vectivolt/DC-Modules/boards/README.md

# 🧩 Boards

<sub>The four module SKUs, the control card, and how the release sheets are produced</sub>

<p>
  
  
  
  
</p>

> [!NOTE]
> **Purpose** — what lives in `boards/`: the four buildable module SKUs, the control card, and the pipeline that
> turns them into audited release sheets.
>
> **Gate coupling** — `kicad5-verify` checks every connected pin of every release sheet;
> `module-interconnect-audit`, `polarity-audit` and `schematic-check` walk the built netlists in run-all.

## At a glance

| Source | What it is | Components (AC-DC · DC-DC) |
|---|---|---|
| [`30kw/`](30kw/) | the canonical module — [walkthrough](30kw/README.md) | 341 · 282 |
| [`40kw/`](40kw/) | 40 kW air: 15 mΩ-class Vienna dies, 5-stack PFC choke, 9 × 33 nF tank, two LLC dies per position, 125 A fuse class, 3 fans | 343 · 306 |
| [`50kw/`](50kw/) | 50 kW **liquid**: coldplates, zero fans, 11 × 33 nF tank, D_OUT 250 A class | 342 · 316 |
| [`50kwa/`](50kwa/) | 50 kW **air**: electrically identical to the liquid twin, 4 fans | 350 · 316 |
| [`control-card.tsx`](control-card.tsx) | the **control card** (GD32G553VET7, 120 × 80 mm, 88-way) — one part number, every seat | 77 |
| [`out-pdf/`](out-pdf/) | the nine release PDFs rendered from the audited KiCad-5 sheets | — |

`kicad5-verify` re-derives every pin of every SHIP target from the emitted files and must read 100 % — the current
count is in the [repository overview](../README.md) status table.

All four SKUs come from one parameterized source, [`boards.tsx`](../packages/common-components/boards.tsx), built
from the cells in [`cells.tsx`](../packages/power-primitives/cells.tsx); the card learns its SKU from one RATING strap.
Why the family looks the way it does: [module family](README-module-family.md).

## 1. The module, physically

| | Role | Contents |
|---|---|---|
| 🔻 **AC-DC board** (lower) | grid → DC bus | AC studs · gG fuses (80 / 125 / 160 A per SKU) · MOV + GDT · 2 CM chokes + three star-X2 stages + damper (no DM chokes) · precharge + bypass · Vienna phases (one clip-mounted 750 V SiC die per position) · split DC link · isolated discharge · line CTs + isolated senses · 110 W full-bus aux flyback (NCP1252D) · local 3.3 V buck · fans (**3 / 3 / 0 / 4** per SKU) · **40-way harness header** (no card slot) |
| 🔺 **DC-DC board** (upper) | DC bus → 150–1000 V | film commutation caps · one full-bridge LLC (two legs, one or two dies per position) · one Cr bank + D2 external Lr + resonant CT · two D3 transformer cells · JBS bridges · film-only banks + PV-driven bleeders · zero-current S/P relays + two-stage exclusion · output blocking diode D_OUT · shunt, studs · isolated CAN · HMI · **the 88-way card slot** |

The boards mount **face to face**: TO-247 rows, clip-mounted on Al2O3, face outward onto two heatsink extrusions
(liquid coldplates on the 50 kW liquid SKU, with the magnetics gap-pad-bonded to the plate webs). Power crosses on
bolted DCP / DCN / PE stud pillars and control on the 40-way harness. Full contract:
[interconnect](../docs/interconnect.md).

## 2. From source to release sheet

```mermaid
flowchart LR
  TSX["boards/&lt;sku&gt;/*.tsx"] -->|"tsci build<br/>netlist mode"| NET["dist/boards/…/circuit.json"]
  NET --> PAGES["sheet-pages.mjs<br/>section plan"]
  PAGES --> SNG["sheet-netlist-gen.mjs<br/>physical pin remap"]
  SNG --> K5["kicad5-gen.mjs<br/>KiCad-5 sheets + SHIP zip"]
  K5 --> VER{"kicad5-verify<br/>every label"}
  VER --> PRINT["kicad5-print.mjs<br/>print-fidelity SVG"]
  PRINT --> PDF["sheets-to-pdf.mjs<br/>boards/out-pdf/"]
  NET --> AUD{"interconnect · polarity<br/>schematic-check"}
  style VER stroke:#2ea44f,stroke-width:2.5px
  style AUD stroke:#2ea44f,stroke-width:2.5px
```

```bash
# build one board netlist (netlist mode is the working default — PCB layout is out of scope)
TSCI_NO_ROUTE=1 npx tsci build boards/30kw/acdc.tsx --ignore-placement-drc --ignore-routing-drc
```

```bash
# regenerate, verify and print one target (30kw | 40kw | 50kw | 50kwa | control-card)
node calculations/sheet-pages.mjs 30kw && node calculations/sheet-netlist-gen.mjs 30kw && node calculations/kicad5-gen.mjs 30kw && node calculations/kicad5-verify.mjs 30kw && node calculations/kicad5-print.mjs 30kw && node calculations/sheets-to-pdf.mjs
```

> [!TIP]
> **The release sheets are `kicad5/DC-Modules-<target>-SHIP.zip`.** Cross-section connectivity is net-labels only —
> wires never leave their section frame — and the library uses native KiCad conventions, so the zips open correctly
> in eeschema.

What differs between the SKUs is listed side by side in [module family](README-module-family.md) and, per magnetic,
in the variant tables of [magnetics](../docs/magnetics.md).

> [!TIP]
> **How this page is checked** — `node calculations/kicad5-verify.mjs <target>` — every connected pin of all five SHIP targets — with `module-interconnect-audit`, `polarity-audit` and `schematic-check` walking the built netlists inside `run-all`.

---

<div align="center">
<sub><a href="../docs/can-profile-tonhe-v12.md">← TonHe V1.2 Compatibility Profile</a> &nbsp;·&nbsp; <a href="../docs/README.md">🧭 Documentation hub</a> &nbsp;·&nbsp; <a href="README-module-family.md">Module Family →</a></sub>

<sub>Vectivolt DC-Modules · documentation rev E85 · every number reproduces with <code>sh calculations/run-all.sh</code></sub>
</div>
