vectivolt/DC-Modules/spice/README.md

# 🖥️ SPICE Simulation Suites

<sub>The ngspice runners, what each one proves, and where its results land</sub>

<p>
  
  
  
</p>

> [!NOTE]
> **Purpose** — the ngspice runners behind the switched-circuit evidence: what each one proves, where its netlists
> and results land, and which gate consumes them.
>
> **Engine** — **ngspice-46** (`brew install ngspice`). `run.mjs` is the shared batch runner and `wrdata` parser:
> every runner writes its decks into `generated/`, runs them, computes metrics in JavaScript from the raw waveforms,
> and writes CSVs and SVG plots into `../simulation-results/`.

## At a glance

| | |
|---|---|
| **Engine** | ngspice-46, batch mode (`ngspice -b`), integration `method=gear` |
| **Committed** | `generated/*.cir` — the persisted deck of every run of the current runners, kept for traceability; raw `*.out` waveforms (hundreds of MB) are git-ignored, so re-run a suite to regenerate them |
| **Results** | `../simulation-results/<sku>/*.csv` + `plots/*.svg` — read by `current-coordination`, `loss-budget`, `magnetics-envelope` and `stress-audit` |
| **Guards** | physicality (legs inside the rails), power-solve (the deck must deliver the rated power), and a tank **fingerprint** so a changed tank fails the gate instead of reusing a stale result |
| **Read the results at** | [simulation report](../docs/simulation-report.md) · method in the [simulation toolchain](../docs/simulation-toolchain.md) |

## 1. How a result is produced

```mermaid
flowchart LR
  R["runner .mjs<br/>per-SKU parameters"] --> CIR["generated/*.cir<br/>committed netlists"]
  CIR --> NG["ngspice-46<br/>batch · method=gear"]
  NG --> OUT["generated/*.out<br/>raw waveforms (ignored)"]
  OUT --> JS["metrics in JS<br/>rms · peak · ZVS · physicality guard"]
  JS --> RES["simulation-results/&lt;sku&gt;/*.csv<br/>+ plots/*.svg"]
  RES --> G{"gates<br/>current-coordination · loss-budget<br/>magnetics-envelope · stress-audit"}
  style G stroke:#2ea44f,stroke-width:2.5px
```

## 2. Runners

| Runner | What it proves | Key outputs |
|---|---|---|
| `double-pulse/dpt-run.mjs` | device-edge truth, **per SKU**: reads the gate network, RC snubber and single-sided RCD clamp out of `cells.tsx` and the turn-off currents out of each SKU's `llc-stress.csv` / `vienna-switched.csv`, runs at the drawn −3 V off-bias on the datasheet-fitted `models/sic-1200-c3m.lib`, reports **channel** turn-off energy (drain integral minus the datasheet E_oss, so the `cs` snubber is credited and its recovered charge is not counted as loss), sweeps `cs` against the ZVS dead-time budget, and prints the per-SKU `cs` / `koff` for `tanks.mjs`. Both Vienna line-cycle polarities are run separately because the RCD clamps only one. `stress-audit` **[DPT]** gates every `final` row, the fingerprint, `tanks.koff` and `pfc-design`'s `k_sw` | `<sku>/dpt-llc-metrics.csv` · `dpt-pfc-metrics.csv` · waveform plots |
| `llc/llc-run.mjs` | **per-SKU, power-solved** full-bridge LLC with body diodes: 12 stress corners (tolerance, gain-worst, high-line bus floor, nominal), an internal-short race and a dead short; it programs the dead times the firmware programs — the ZVS schedule on the strong leg and `weakDead` on leg A in phase shift, against the same 120 ns floor; **physicality guard** (legs in rails) and **tank fingerprint** | `<sku>/llc-stress.csv` · `llc-stress-summary.json` · `llc-short.csv` · `plots/llc-worst-corner.svg` |
| `llc/llc-envelope.mjs` | the 20-point magnetics envelope of the same bridge, power-solved below resonance where D3 flux peaks — the corners the resonance-only evaluation never saw | `<sku>/llc-envelope.csv` |
| `llc/llc-flux-post.mjs` | turns the simulated waveforms into the committed magnetics excitation table, so the magnetics gates never depend on a git-ignored `.out` | `<sku>/llc-flux.csv` |
| `llc/sp-transition.mjs` | why banks are never paralleled across a voltage difference: per SKU on the film-only bank (19.8 / 26.4 / 30.8 µF) and swept over the closure-loop inductance, because the loop sets the answer; the output is the minimum loop L the \|ΔV\| ≤ 25 V permit needs against the relay make line | `<sku>/sp-transition.csv` |
| `pfc/pfc-phase-run.mjs` | 3-φ line-cycle behaviour at averaged-switch fidelity: THD-40, midpoint balance, phase loss, precharge / discharge sizing | `<sku>/pfc-phase-runs.csv` |
| `dclink/dclink-ripple.mjs` | the HF ripple SHARE in the real DC link (bridge entry film · stud/pillar · split electrolytic bank · Vienna commutation films) at the committed LLC operating points. Run it AFTER `llc/llc-run.mjs`: it reads the corner out of `llc-stress.csv` | `<sku>/dclink-ripple.csv` |
| `protection/ct-frontend.mjs` | AVMID stability and the per-SKU resonant and line CT chains at their burdens, thresholds and race peaks | `<sku>/ct-frontend.csv` |
| `protection/prechg-disch.mjs` | precharge, bus discharge and bank bleed per SKU against F.20 / F.21 / F.21b | `<sku>/prechg-disch-sku.csv` |
| `aux/aux-flyback.mjs` | aux start, regulation and cross-regulation at 342 / 560 / 850 V per SKU, the current-sense clamp, and the V15 / V24 short cases | `<sku>/aux-flyback.csv` |

```bash
node spice/llc/llc-run.mjs 30kw 40kw 50kw 50kwa && node spice/llc/llc-envelope.mjs && node spice/llc/llc-flux-post.mjs
node spice/dclink/dclink-ripple.mjs
```

```bash
node spice/protection/ct-frontend.mjs && node spice/protection/prechg-disch.mjs && node spice/aux/aux-flyback.mjs && node spice/llc/sp-transition.mjs
```

## 3. Models

`models/sic-behavioral.lib` holds behavioural VDMOS and JBS fits and `models/sic-1200-c3m.lib` the datasheet-fitted
1200 V device the double-pulse suite runs on. Both carry a full provenance header: what they approximate, what they do
not, and why vendor-encrypted PSpice models cannot run here. The ± 40 % switching-energy band is carried through every
downstream decision and closes at the bench double-pulse test (T-01).

> [!WARNING]
> **A simulation that cannot fail is not evidence.** A switch model without a body diode lets a leg swing ± 6 kV on a
> 650 V bus and still print a plausible rms, so every runner that produces power-stage evidence clamps its switch nodes
> physically: `llc-run.mjs` fails any corner whose legs leave the rails, and refuses to report a corner that does not
> deliver its rated power. How to run and read every suite: [simulation toolchain](../docs/simulation-toolchain.md).

> [!TIP]
> **How this page is checked** — the runners' own physicality, power-solve and fingerprint guards, and then `current-coordination` and `magnetics-envelope` in `run-all`, which refuse a stale or non-physical result file.

---

<div align="center">
<sub><a href="../calculations/README.md">← Calculations & Gates</a> &nbsp;·&nbsp; <a href="../docs/README.md">🧭 Documentation hub</a> &nbsp;·&nbsp; <a href="../docs/bom-cost.md">BOM & Cost Roll-up →</a></sub>

<sub>Vectivolt DC-Modules · documentation rev E85 · every number reproduces with <code>sh calculations/run-all.sh</code></sub>
</div>
