vectivolt/DC-Modules/boards/30kw/README.md

# 📋 30 kW Module Walkthrough

<sub>The canonical board pair, cell by cell — every cell reused unchanged across the family</sub>

<p>
  
  
  
</p>

> [!NOTE]
> **Purpose** — the canonical cell-level walkthrough of one module. Every cell explained here is instantiated
> unchanged across the family; what the 40 and 50 kW SKUs scale is listed in
> [module family](../README-module-family.md) and, per magnetic, in the variant tables of
> [magnetics](../../docs/magnetics.md).

## At a glance

| | |
|---|---|
| **Input** | 3-φ 285–475 VAC — full power from 330 VAC, 86 % constant-current derate at 285 VAC |
| **Output** | 150–1000 VDC · **100 A max** · CV/CC · two output modes: LOW ≤ 500 V (banks parallel) / HIGH ≥ 500 V (series), set in standby |
| **Boards** | AC-DC and DC-DC both **440 × 500 mm, 6-layer**, face to face |
| **Cells** | 1 Vienna lane (3 phases, one 750 V 20 mΩ-class die per position) · 1 full-bridge LLC (two legs, one SG2M023120LJ per position) |
| **Control** | one control card in the DC-DC slot (JB); the AC-DC board has only the 40-way harness header (JICA) |
| **Fast trips** | F.01 line 120 A pk · F.11 tank 140 A pk (one window comparator) · DESAT on every SiC switch |
| **Performance** | η **96.38 %** at 400 VAC full power · peak **97.78 %** · worst junction **128 °C** (Vienna) / **150 °C** (LLC) over the envelope · MTBF ≈ **408 kh** |
| **Cost** | **₹31,613 @10k** (₹38,931 @1k) · China RFQ target ₹25,920 — [cost roll-up](../../docs/bom-cost.md) |
| **Release sheets** | `DC-Modules 30kW AC-DC (Vienna PFC)` and `DC-Modules 30kW DC-DC (full-bridge LLC)` in [`boards/out-pdf/`](../out-pdf/) · KiCad-5 set `kicad5/DC-Modules-30kw-SHIP.zip` |

## 1. 🔻 AC-DC board — [`acdc.tsx`](acdc.tsx)

```mermaid
flowchart LR
  J["AC studs<br/>L1 · L2 · L3 · PE"] --> F["gG fuses 80 A<br/>22 × 58"] --> MOV["MOV Δ + GDT<br/>S20K550 · X2★ CX01–03"]
  MOV --> CM1["CMC1<br/>3-φ CM (D7)"] --> X1["CX11–13 X2★ 4.7 µF<br/>CY4–6 Y1"] --> CM2["CMC2"] --> X2["CX21–26 2 × X2★ 4.7 µF<br/>CY1–3 Y1 · Rd–Cd damper"]
  X2 --> PRE["KPRE1 + KPRE2 80 A<br/>2 × 33 Ω pulse"]
  PRE --> PH["3 × Vienna phase<br/>A0 · B0 · C0"]
  PH --> DC[("split DC link<br/>2 × 5 × 470 µF + balance")]
  DC --> ST["DCP · DCN · PE pillars<br/>→ DC-DC board"]
  PH -. "PWM · FLT" .- HAR["40-way harness JICA<br/>→ card on the DC-DC board"]
  DC -. "isolated senses" .- HAR
  AUX["aux flyback 110 W<br/>NCP1252D · full bus"] -. "V24 · V15 · 3.3 V" .- HAR
  style PH stroke:#d19a00,stroke-width:2.5px
```

| Cell (source) | What it is | The engineering inside |
|---|---|---|
| EMI filter | conducted emissions | two 3-φ CM chokes (D7) with a 4.7 µF X2 star stage on each side and two at the converter (12 X2 in all), a Y1 trio at two nodes, and the Rd–Cd damper (2.2 µF X1 + 10 Ω 25 W) that keeps the current loop stable — no DM chokes; DM margin +32.9 dB |
| `ViennaPhase` × 3 | one PFC phase | 165 µH-class sendust choke, 3 × 0077908A7, N = 39 ± 1 lot-trim ([D1](../../docs/magnetics.md)); **common-source 750 V 20 mΩ-class SiC pair**, one die per position, clip-mounted on Al2O3 (RFQ acceptance IDM ≥ 210 A); two 1200 V / 40 A JBS diodes to the rails; 10 Ω + 100 pF RC snubber **and** an RCD clamp per node |
| `DriverCh` × 3 | isolated gate channel | NSI6611 (DESAT, Miller clamp, UVLO, soft-off) · split Rg 4.7 / 4.7 Ω · **+15 / −3 V** from a reinforced ISO-GBIAS-15-1W / -2W bias module — a class with a light-load acceptance row (≤ +17.5 V at 5 % load), because the idle rise is what the driver's abs-max actually sees · two series 1 kV DESAT diodes + **47 pF blank** + 100 Ω series resistor · gate pull-down · Kelvin return |
| `SplitDcLink` | energy buffer | 2 × 5 × 470 µF / **500 V** snap-in (worst continuous half 435 V = 87 % of rating; 450 V cans remain a listed −₹300 lever at 97 %), one 2 × 47 kΩ balance string per half with a sensed midpoint; window 650–830 V, **hardware OVP 860 V**; **16 × 1 µF bridge entry film + 2.2 µF / 0.33 Ω RC damper** on a 50 W TO-247 resistor clipped to the DC-DC heatsink, and per-phase film commutation caps |
| precharge | inrush control | 33 Ω in **two lines** plus a 2-pole bypass (a one-line resistor is a three-wire fallacy); t₉₅ ≈ 193 ms on the per-SKU deck; the bypass closes on a **settled** link, and F.01 is blanked 60 ms across the closure pulse |
| discharge | touch safety | 640 Ω active path with a 1200 V SiC switch, default-OFF: 830 → 60 V in **2.0 s** with AC present |
| `CtSensor` × 3 | phase current | Talema ACX-1100 1:2500 line CTs + **22 Ω burden** → ADC and the on-chip comparators (F.01 120 A pk) |
| `IsoVSense` × 5 | AC and bus sense | anti-surge resistor chain inside the measured domain + isolated amplifier + isolated 5 V bias; 100 Ω at every iso-amp output and 1 nF at every ADC pin, because 22 channels are sampled in ≈ 132 ns at the end of a harness that runs beside PWM ways |
| `AuxPower` | house power | 110 W full-bus flyback: NCP1252**D**, 220 µF VCC reservoir, D4 rev E on ETD44; brown-in 321 V; V24 / V15 / 3.3 V |
| harness header `JICA` | control boundary | the 40-way PFC bundle to the card; default-OFF pull-downs on every enable, relay drive and PWM at the receiving end — see [interconnect](../../docs/interconnect.md) |

## 2. 🔺 DC-DC board — [`dcdc.tsx`](dcdc.tsx)

```mermaid
flowchart LR
  ST["DCP · DCN · PE<br/>pillars"] --> CF["film commutation caps"]
  CF --> LEG["full-bridge LLC · 2 legs<br/>1 × SG2M023120LJ per position"]
  LEG --> TK["tank · 7 × 33 nF Cr<br/>D2 rev F 5.00 µH · resonant CT"]
  TK --> XF["2 × D3 rev D cells<br/>6:6∥6 · primaries in series"]
  XF --> BR["JBS bridge per bank<br/>2 × 40 A per position"]
  BR --> BK["film-only banks<br/>9 × 2.2 µF each"]
  BK --> SP["S/P relays at 0 A<br/>KSER · KPARA · KPARB · 74HC02 exclusion"]
  SP --> DO["DOUT 1600 V 150 A"] --> SH["manganin shunt<br/>+ NSI1200"] --> OUT["OUT± M8 studs"]
  CARD["control card · 88-way slot JB"] -.-> SP
  CARD -.-> HMI["HMI · 2 buttons<br/>2-digit 7-segment"]
  CARD -.-> CAN["isolated CAN<br/>NSI1042-DSWR"]
  style TK stroke:#1a9fb3,stroke-width:2.5px
  style CARD stroke:#2ea44f,stroke-width:2.5px
```

| Cell | What it is | The engineering inside |
|---|---|---|
| `LlcHalfBridgeLeg` × 2 | full-bridge legs | one SG2M023120LJ 1200 V / 23 mΩ per position, clip-mounted (RFQ acceptance **IDM ≥ 265 A** — the gated kill peak is **203 A at +0.5 µs**, 77 % of that line, which makes it the binding RFQ line of this SKU), Rg 4.7 Ω on / **0 Ω off** with a **330 pF C0G turn-off snubber per die** (the snubber sets dv/dt; a turn-off resistor would cost 3–5 × the turn-off energy, which one die at 30 kW cannot carry), **22 pF DESAT blank**; PFM over 77–203 kHz down to the fn floor 0.55, then phase shift of leg B at 1.45·fr; **ZVS held by a per-leg adaptive dead time on the non-linear C_oss**, and in phase shift the weak leg (leg A) takes a valley-timed **125 ns** edge, because at load it swings on the decayed tank current through L_r alone and a longer edge lets it swing back |
| `LlcTank` | resonant tank | Cr = 7 × 33 nF / 1200 V PP film · **D2 rev F external Lr 5.00 µH ± 3 %** of the tank's 5.6 µH total (2 × E70, N 5, 8000 × 0.05 mm litz, no bins) · one resonant CT 1:100 + **0.47 Ω burden** + window comparator U1W (F.11 140 A pk, both polarities) |
| transformer | isolation | **two D3 rev D cells** (2 × E70 each, 6:6∥6), primaries in series (n = 2), each S1–P–S2 with S1 ∥ S2 to one bank; TIW-served litz primary, copper-foil halves, VPI class H, both yoke faces bonded; PD ≥ 2.0 kV ([D3](../../docs/magnetics.md)) |
| JBS bridges | rectification | 16 × GC4D20120D 1200 V / 40 A — two per bridge position, one bridge per bank; diodes over synchronous rectification (on the full bridge SR loses 109 W more) |
| banks | output filter | 9 × 2.2 µF 630 V film straight across each bank — no inductor, no electrolytic; ≤ 3.83 A per film and 0.47 % RMS output ripple at the worst corner |
| `SeriesParallelRelayMatrix` | output modes | KSER · KPARA / KPARB 120 A PCB relays switched **only at zero current** behind the output diode · two-stage 74HC02 hardware exclusion; a welded KPARA shows as F.17 at the SER soft start |
| DOUT | output blocking diode | 1600 V / 150 A-class insulated module: back-feed and reverse-battery proof with no output contactor; 100 A = 67 % of class, Tj 115 °C. A 3 × 150 kΩ bleeder sits behind it, because no commanded path reaches past the diode and the studs otherwise hold 1000 V for about 100 s |
| `OutputShunt` | current truth | manganin + NSI1200 isolated amplifier, Kelvin taps; ± 0.2 % after EOL calibration (Monte-Carlo) |
| `ConfigHmi` | field configuration | 2 buttons + 2-digit display via 74HC595 + 2 NPN multiplexers — address, group, `F.xx` paging |
| `IsolatedCan` | external world | CAN 2.0B, 125 kbps, 29-bit, isolated + CM choke + TVS + jumpered 120 Ω ([protocol](../../docs/can-protocol.md)) |
| `CoilDriver` | relay drive | 24 V coils, flyback-clamped, economised to ~40 % hold after pull-in |

## 3. Control interface — one brain per module

The card sits only in the DC-DC board's 88-way `JB` slot and runs both boards: the two LLC legs on HRTIMER pairs, the
three Vienna PWMs over the harness, resonant and line CTs, bank / output senses, S/P relay drives and readbacks, HMI
and isolated CAN. The pin map is generated by `calculations/control/umod-pinmap.mts` (75 of 82 usable MCU pins, 7 spare),
and the module-interconnect audit proves every way lands on real electronics on both sides.

## 4. Protections on this pair

| Layer | On this module |
|---|---|
| **Hardware, µs** | line CT comparators F.01 120 A pk → HRTIMER kill · tank window comparator F.11 140 A pk (both polarities) · DESAT on every SiC switch · bus OVP 860 V · output OVP · driver UVLO (aux collapse holds gates low). A trip stays latched until the supervisor has acknowledged it — nothing re-arms the outputs on its own |
| **Safety chain** | watchdog WDO ≡ NRST (a hung brain restarts with enables low), fed only while the main loop keeps paying into it · GATE_EN chains with default-OFF pull-downs across the harness · two-stage relay exclusion |
| **Supervisory** | the full F.xx ladder ([protection thresholds](../../docs/protection-thresholds.md)), exercised by the scenario suite and the C firmware host binaries under ASan/UBSan |

## 5. Top cost drivers (@10k, from [`bom-30kw.csv`](../../calculations/out/bom-30kw.csv))

| MPN | Description | Qty | ₹ / unit | ₹ ext |
|---|---|---:|---:|---:|
| `IND-PFC-165u` | PFC choke D1-30, 3 × 0077908A7 sendust | 3 | 828 | **2,484** |
| `CMC-3PH-2mH-SKU` | 3-φ CM choke D7 (two stages) | 2 | 1,062 | **2,124** |
| `GC4D20120D` | SiC JBS 1200 V 40 A (6 boost + 16 secondary) | 22 | 96 | **2,112** |
| `XFMR-LLC-CELL-2E70-30` | D3-30 rev D transformer cell | 2 | 935 | **1,870** |
| `ELH-470u500` | 470 µF **500 V** snap-in (DC link) | 10 | 148 | **1,480** |
| `SG2M023120LJ` | SiC MOSFET 1200 V 23 mΩ (LLC) | 4 | 312 | **1,248** |
| `PP-1u-1100` | 1 µF 1100 V film (DC-link entry) | 16 | 54 | **870** |
| `SIC-750V-20mR` | SiC MOSFET 750 V 20 mΩ class (Vienna) | 6 | 144 | **864** |
| `IND-LR-E70-30` | D2-30 rev F external resonant inductor | 1 | 772 | **772** |

Mechanical lines (assembly and EOL ₹1,653 · heatsinks ₹1,305 · the two 440 × 500 mm 6-layer PCBs ₹2,350 · enclosure
₹870 · busbars, studs and harness ₹630 · clip-mount TIM ₹418) and the lever plan are in the
[cost roll-up](../../docs/bom-cost.md); the method is in the [BOM guide](../../docs/bom-guide.md).

> [!TIP]
> **How this page is checked** — `kicad5-verify` on this board pair, with `schematic-check`, `polarity-audit` and `module-interconnect-audit` on the built netlists; the cost lines come from the generated `calculations/out/bom-30kw.csv`.

---

<div align="center">
<sub><a href="../README-module-family.md">← Module Family</a> &nbsp;·&nbsp; <a href="../../docs/README.md">🧭 Documentation hub</a> &nbsp;·&nbsp; <a href="../../docs/protection-thresholds.md">Protection Thresholds →</a></sub>

<sub>Vectivolt DC-Modules · documentation rev E85 · every number reproduces with <code>sh calculations/run-all.sh</code></sub>
</div>
