vectivolt/DC-Modules/docs/assumptions.md

# 📒 Decision Register

<sub>The design decisions in force — each value, why it holds, and what would invalidate it</sub>

<p>
  
  
  
  
</p>

> [!NOTE]
> **Purpose** — the design decisions **in force**, subsystem by subsystem: the value, why it is that value, and what
> would overturn it. Every engine and gate in the battery cites a row here as its provenance.
>
> **Change rule** — a decision changes by **editing its row**. No replacement chain, no dated narrative: the page
> describes the module as it is today, and `git log` is the history.

| Status | Meaning | Change control |
|---|---|---|
|  | decided and gated | formal ECO, then edit the row |
|  | best current value | revisit when the named invalidator fires |
|  | needs external confirmation | confirm at RFQ, sample or EVT |

## At a glance

| | |
|---|---|
| **What this is** | the decisions that describe the module today — value, reason, status, and the gate or file that holds each one |
| **Scope** | four module SKUs; a per-SKU value is written **30 / 40 / 50 liquid / 50 air**, a single figure applies to all four |
| **Change rule** | edit the row. No replaced rows, no revision chain — the history is `git log` |
| **Who reads it** | every engine in `sh calculations/run-all.sh` cites a decision as its provenance; `stress-audit` and `review-checks` assert several word for word |

| § | Subsystem | What it settles |
|---|---|---|
| [1](#1-envelope-and-ratings) | Envelope and ratings | input window and derate, output window and modes, efficiency, THD, environment, accuracy, standby |
| [2](#2-ac-front-end-and-vienna-pfc) | AC front end and Vienna PFC | topology, carrier, dies, EMI filter, damper, fuses, surge, PFC loops |
| [3](#3-dc-link-precharge-discharge-and-balance) | DC link, precharge, discharge, balance | link window and reference law, cans and entry film, bypass rule, dumps, bleeders, label |
| [4](#4-llc-dc-dc-stage) | LLC DC-DC stage | bridge, tank table, dies, snubbers, modulation, dead times, regulator |
| [5](#5-magnetics) | Magnetics | D1–D7 identities, material rules, thermal and insulation acceptance |
| [6](#6-output-stage) | Output stage | rectifiers, bank films, S/P matrix, make permit, blocking diode, shunt |
| [7](#7-gate-drive-and-sic-switching) | Gate drive and SiC switching | driver, DESAT, gate resistors, bias class, loop inductance, DPT acceptance |
| [8](#8-sensing-and-protection-architecture) | Sensing and protection | CTs, iso-amps, comparators, the F.xx philosophy, junction observer, watchdog |
| [9](#9-control-card-mcu-and-firmware) | Control card, MCU, firmware | one card, RATING strap, HRTIMER, boot chain, journals, layering |
| [10](#10-communications) | Communications | VMP 2.0 native, TonHe V1.2 profile, timeout ownership, controlled stop |
| [11](#11-auxiliary-supply-cooling-and-mechanics) | Aux, cooling, mechanics | flyback and rails, SELV domain, fans and coldplates, mount, sandwich, boundary |
| [12](#12-production-bom-and-cost-basis) | Production, BOM, cost | volume basis, costs, sourcing maturity, release face, scope |
| [13](#13-component-and-model-assumptions--confirm-at-rfq-or-evt) | Component / model assumptions | what still waits on a datasheet, a quote or a bench |
| [14](#14-simulation-fidelity-decisions) | Simulation fidelity | what each model may prove, and what it may not |

## 1. Envelope and ratings

| # | Decision | Value | Why | Status | Held by · invalidator |
|---|---|---|---|---|---|
| 1.1 | Input window | 3-φ 285–475 VAC, 45–65 Hz, OVC III, 300 V line-to-neutral class | the window the DC-charger market specifies over | FROZEN | `core/fsm.h` `PMP_IN_OV_V`/`_UV_V` · a 525–530 VAC tender (moves the F.07 trip, not the topology) |
| 1.2 | Full-power floor | full power ≥ 330 VAC; below it input current is held and power derates linearly — **86 % at 285 VAC** | holding current instead of power saves ≈ 16 % of the SiC, copper and filter | FROZEN | `design-basis.mjs` `V_FULL` · `core/ctl.c` · a contract demanding full power at 285 VAC |
| 1.3 | Output window | 150–1000 VDC, CV/CC, **100 / 133 / 167 / 167 A**; constant current below the 300 V knee, constant power above | one module must serve both 400 V and 800 V vehicle classes | FROZEN | `core/fsm.h` `PMP_PAR_VMAX_V`/`PMP_SER_VMAX_V` · a class outside 150–1000 V |
| 1.4 | Output modes | **LOW** parallel ≤ 500 V · **HIGH** series ≥ 500 V · **AUTO**; latched only with every matrix contact open; AUTO crosses up at 500 V, returns at 480 V, 1 000 ms dwell | no single tank spans 150–1000 V at usable gain, and a battery on the boundary must not chatter the matrix | FROZEN | `core/fsm.h` `PMP_XOVER_*`/`PMP_MODE_DWELL_MS` · `host_sim` · a tank change moving the bank ceiling |
| 1.5 | Efficiency | peak ≥ 97 % specified; ledger **96.38 / 96.34 / 96.29 / 96.22 %** at 400 VAC full load, envelope peak **97.78 / 97.84 / 97.80 / 97.79 %** | the ledger carries the output diode, LLC turn-off and the measured switching coefficients, so it is bench-comparable | BASELINED | `out/loss-budget.csv` · `system/envelope-grid.mjs` · a measured coefficient outside its deck band |
| 1.6 | THD and PF | THD ≤ 5 % specified (3 % stretch); the shipped law reads THD-40 **0.76 / 0.65 / 0.69 %** at 400 VAC full power; PF target 0.99 | grid-code headroom without a filter the cost model cannot carry | BASELINED | `hal_test` THD rows on `hal/pfc.c` · a lab measurement above 3 % |
| 1.7 | Environment | −30…+75 °C operating, cold start ≥ −30 °C, storage −40…+85 °C, 5–95 % RH non-condensing, ≤ 2000 m, acrylic conformal coating on both boards and the card, 2 g 10–500 Hz survival | dust and condensation are the field killer for fan-cooled modules | FROZEN | `magnetics/temp-critique.mjs` cold rows · `cost/parts-db.mjs` · a requirement below −30 °C |
| 1.8 | Over-temperature derating | four zones, each 100 % up to its derate point and linear to **60 %** at its trip, then F.22: **inlet 55 → 75 °C** (air or coolant) · T_PFC 95 → 105 °C · T_LLC 100 → 110 °C · T_XFMR 105 → 115 °C. The worst zone governs; recovery has 5 °C hysteresis and is limited to 20 %/s | a derating curve is the product's headline environmental claim, so it is implemented in the firmware the module ships with and the thermal gates are solved at the same law | FROZEN | `hal/app.c` `ZONE[]` · `core/fsm.h` `PMP_OT_DERATE_C`/`PMP_OT_TRIP_C`/`PMP_DERATE_*` · `host_sim` · a zone temperature the sensor cannot see |
| 1.9 | Measurement accuracy | ±0.5 % V / ±1 % I specified; **±0.18 % / ±0.2 %** after a mandatory two-point EOL calibration; a card with no calibration record latches **F.30** and cannot deliver | running on nominal scaling is an unbounded error nobody can see | FROZEN | `out/monte-carlo.csv` · `hal/meas.c` · an EOL fixture that cannot reach both points |
| 1.10 | Parallel operation | modules share one DC bus behind their output diodes; the charger controller is group master (`GROUP_SET` 0x12), every card runs share = min(capability, demand / alive) | a cabinet supervisor is a single point of failure for every module it feeds | FROZEN | `core/group.c` · `host_sim` · a decision to reintroduce a cabinet supervisor |
| 1.11 | Standby power | target ≤ 10 W; the drawn passive network alone is 2.42 W (sense star) + 3.4 W (link balance), AC-present estimate 11.2–16 W | a market figure, not a physical line — no lever is spent before a measurement | ASSUMED | `system/standby-budget.mjs` · T-00; aux burst/skip is the first lever |

## 2. AC front end and Vienna PFC

| # | Decision | Value | Why | Status | Held by · invalidator |
|---|---|---|---|---|---|
| 2.1 | PFC topology | 3-level Vienna — one common-source 750 V SiC pair per phase, one PWM per phase, 1200 V JBS diodes to both rails | the switches see half the link and only the diodes block all of it | FROZEN | `cells.tsx` `ViennaPhase` · `verify-independent` |
| 2.2 | PFC carrier | **50 kHz** | 70 and 100 kHz put T_j over 150 °C on the same die and mount | FROZEN | `pfc/pfc-design.mjs` · a die class that changes the loss split |
| 2.3 | PFC dies | 750 V 20 mΩ class · 15 mΩ class · B3M010C075Z · B3M010C075Z — **one die per position** | the clip mount removed the need to parallel; 650 V dies reach 86 % of rating against a 75 % house line | FROZEN | `cost/parts-db.mjs` `skuOverrides` · an RFQ die below I_DM ≥ 210 / 260 A at 25 °C |
| 2.4 | Vienna switching coefficient | the ledgers carry the per-SKU double-pulse finals on the drawn clamp network: **18.1 / 19.4 / 18.9 nJ/(V·A)** | one generic coefficient under-read the 40 kW die by a third | BASELINED | `out/loss-budget.csv` `pfc_ksw_nJ_VA` · a bench coefficient above the deck |
| 2.5 | Node snubber and clamp | RC 10 Ω + 330 pF per node on a 3 W pulse-proof part (2.84 W/phase), plus an RCD clamp — 1200 V 10 A JBS, 100 nF, 33 kΩ bleeder. The mirrored clamp land is on every phase but **populated on the 50 kW pair only** | the resistor must be pulse-rated because dissipation is C·V²·f regardless of edge speed; the mirror is fitted where the unclamped negative half-cycle runs 82 % of 750 V instead of 76–79 % | FROZEN | `cells.tsx` `ViennaPhase` · `cost/parts-db.mjs` `MIRROR_CLAMP` · T-59 above 85 % of 750 V on any SKU |
| 2.6 | EMI filter | two CM chokes with **three floating star-X2 stages** — 3 × 4.7 µF line-side, 3 × between the chokes, 6 × at the converter, all X2 305 VAC; Y trio 10 nF at the converter node, 4.7 nF between the chokes. **No DM line chokes** | the star ladder carries the differential mode, and a 22 µH DM choke cannot exist at the line crest on a core that fits | FROZEN | `emi/lisn-precompliance.mjs` (DM margin +32.9 / +30.6 / +28.7 dB) · a conducted scan that misses the margin |
| 2.7 | Filter damper | Rd–Cd across the converter star: **2.2 µF / 6.8 Ω** at 30–40 kW, **4.7 µF / 4.7 Ω** at 50 kW, 25 W class | undamped, the LCL modes sit where the sampled current loop's admittance turns negative | FROZEN | `out/pfc-filter-stability.csv` · a transport delay above 20 µs |
| 2.8 | Line fuses | gG 690 V, **80 / 125 / 160 A** (22 × 58 frame, NH00 at 50 kW) | first size that survives the 0.72× enclosed/+55 °C derate against the worst continuous line current | FROZEN | `stress-audit` fuse rows · a change in worst line current |
| 2.9 | Surge path | MOV delta (S20K550 class) line-to-line plus MOV + **2.5 kV GDT** per line to PE | a 3.5 kV GDT sparks over above the MOV clamp at a 1 kV/µs rise, so the series path never conducts | FROZEN | `system/fault-energy.mjs` (39 J against a 160 J MOV) · above IEC 61000-4-5 class 4 |
| 2.10 | PFC loops | current f_c ≈ 3 kHz, PM 50°, GM 8.7 dB; link-voltage loop 15 Hz, PM 65°, **commanding power, not amplitude**; reference clamp 1.05× | an amplitude-commanding voltage loop reached 269 A on a sag recovery | FROZEN | `out/pfc-loops.csv` · `hal/pfc.h` · a HIL loop unstable on these defaults |
| 2.11 | Step-aware limit | the per-sample amplitude limit accounts for the 15 µs transport delay — 152 / 144 / 93 A, all under F.01 / 1.2 | ΔV/L flows before any sample can answer a line step, and a plain clamp let 184 A through | FROZEN | `hal/pfc.c` · `hal_test` · a transport delay above 15 µs |

## 3. DC link, precharge, discharge and balance

| # | Decision | Value | Why | Status | Held by · invalidator |
|---|---|---|---|---|---|
| 3.1 | Link window | **650–830 V** commanded, hardware OVP **860 V** | the double-pulse deck reads 73 % of device rating at 830 V and 77 % at 880 V | FROZEN | `core/fsm.h` `PMP_BUS_MIN_V`/`_MAX_V`/`PMP_BUS_OVP_V` · a measured ring above 75 % at 830 V |
| 3.2 | Link reference law | `bus_ref = clamp(max(2·V_bank/0.95, 1.08·√2·V_LL), 650, 830)` every tick, **leading the measured output** by 25 V rather than following the command | a Vienna rectifier cannot regulate below the line-line crest; and vehicles send their maximum voltage as the setpoint while charging far below it, so a command-following link parked the bridge at f_max and in deep phase shift across the mainstream range | FROZEN | `core/fsm.h` `PMP_BUS_LINE_K`/`PMP_BUS_LEAD_V` · `host_sim` · a class whose command is its operating point |
| 3.3 | Link capacitance | 2 × (**5 / 6 / 8 / 8**) × 470 µF **500 V** snap-in, 105 °C, −40 °C category | 450 V parts ran 92 % of rating nominally and 96 % at the OVP, where an electrolytic vents | FROZEN | `boards.tsx` `nDcHalf` · an RFQ can below 5.2 A rms at 100 kHz / 105 °C or ESR > 80 mΩ |
| 3.4 | Entry film and link damper | **16 / 16 / 20 / 20 × 1 µF 1100 V** at the DC-DC entry plus a 2.2 µF 1100 V / **0.33 Ω** damper on a ≥ 50 W non-inductive TO-247 part clipped to the heatsink | four films put the bank on an anti-resonance with the stud loop inside the 2·f_sw band and every can carried 5.8–12 A rms against a ≈ 3 A class; the damper's real duty is 7 / 16 / 36 W | FROZEN | `parts-db` `ENTRY_FILM` ≡ `boards.tsx` `nEntryFilm` · `current-coordination` `[DCLINK]` · T-57 far from 40 nH |
| 3.5 | Half-link ceiling | either half above **440 V for 10 ms** latches F.38 | the total-bus OVP plus the midpoint row still allowed one half to sit at 454–468 V | FROZEN | `core/fsm.h` `PMP_HALF_OV_V` · a can voltage-class change |
| 3.6 | Precharge | 2 × **33 Ω** pulse resistors, one in L1 and one in L2, with a two-pole bypass relay; 25 W class, 50 W at 50 kW | with three-wire input every line-line loop must see at least one resistor | FROZEN | `boards.tsx` · `spice/protection/prechg-disch.mjs` · a link capacitance change |
| 3.7 | Bypass close rule | close when the link has **stopped rising** — two consecutive 20 ms samples < 3 V apart — and sits above 0.85 × √2 · V_LL; otherwise F.20 at 5 s | "0.97 × the sinusoidal crest" is unreachable on flat-topped mains once the bus-fed aux, two diode drops and ±1 % sensing are counted, and F.20 locks the module after five tries; a settled link bounds the closing step at the resistor drop whatever the wave shape | FROZEN | `core/fsm.c` `ST_PRECHG` · `PMP_PRE_SETTLE_*`/`PMP_BYPASS_MIN_K` · a resistance or capacitance that changes the settling time |
| 3.8 | Closure blank | F.01 is not latched for **60 ms** after the bypass command and the PFC waits the window out; the hardware break stays armed | the closure step charges the link through the CM-choke leakage and D1 at 200 / 218 / 280 A pk, above F.01 on every SKU | FROZEN | `core/fsm.h` `PMP_PRE_BLANK_MS` · `current-coordination` `[INRUSH]` · a relay or JBS below its pulse line |
| 3.9 | Bypass readback | the two bypass auxiliaries (1 Form A NO) in **series**, read through a 330 Ω wetting resistor | series auxiliaries are the only detection of a **stuck-open** contact, which would leave a 33 Ω resistor in the line current | FROZEN | `boards.tsx` · `verify-independent` · a relay option without the auxiliary |
| 3.10 | Commanded link dump | 640 Ω (4 × 160 Ω) with a 1200 V SiC FET, default-OFF behind an isolated driver, on FSM command only; exit needs 100 ms of plausible samples, and a link falling slower than 20 V/s for 300 ms reports F.21 and **stops** the dump | a fail-engaged dump burns kilowatts into 100 W of resistor during any held reset, and a dump commanded with AC applied is fed through the permanent precharge path | FROZEN | `core/fsm.h` `PMP_DISCH_*` · `system/fault-energy.mjs` · a link energy change |
| 3.11 | Bank bleeders | 4 × 2.2 kΩ 10 W per bank on a photovoltaic-coupler gate drive, commanded from the mode-switch open and through shutdown and discharge | the coupler needs no floating supply and is default-OFF by construction | FROZEN | `cells.tsx` `PvGateDrive` · `core/fsm.c` · a bank film change |
| 3.12 | Passive balance | **one** 2-series 47 kΩ string per half per module (188 kΩ across the link), first bank only | a realistic hot can-to-can leakage imbalance is ≤ ≈ 1.2 mA against 4.4 mA of bleed, and these resistors also set the passive discharge time | FROZEN | `parts-db` `RBAL*` · `system/standby-budget.mjs` · an RFQ can above 0.5 mA at 85 °C / 415 V |
| 3.13 | Output-stud bleeder and label | 3 × 150 kΩ (450 kΩ) across the studs behind the blocking diode — 1000 → 60 V in ≈ 12 s. IEC 62477-1 label: isolate upstream, **wait 15 min AND verify < 60 V** | the output films sit behind the diode where no bank bleeder reaches them; passive link discharge from the aux floor is 6.2 / 7.4 / 9.9 min, and with AC applied the precharge rectifier path holds the link up entirely — the wait is never the permission, the measurement is | FROZEN | `parts-db` `RBO*` · `PMP_DISCH_OUT_MS` · [protection thresholds](protection-thresholds.md) · a bleeder or balance change |

## 4. LLC DC-DC stage

| # | Decision | Value | Why | Status | Held by · invalidator |
|---|---|---|---|---|---|
| 4.1 | Topology | **one full-bridge LLC** per module driving **two transformer cells with primaries in series** (n = 2 overall), one cell per output bank | it removes two thirds of the tanks, drivers and transformer stacks against three interleaved half-bridge sections, at the same gain | FROZEN | `llc/tanks.mjs` · `cells.tsx` `LlcTank` · a topology change (every result CSV carries the tank fingerprint) |
| 4.2 | Tank table | f_r **140 kHz** · n **2** · Ln **10** · Q ≈ 0.19 at a 500 V bank · Cr **7 / 9 / 11 / 11 × 33 nF** 1200 V · total Lr **5.6 / 4.35 / 3.56 / 3.56 µH** · Lm **56 / 43.5 / 35.6 / 35.6 µH**. Gain M = n·V_bank/V_bus, bank ≤ 500 V | Ln 10 held the resonant-capacitor voltage inside 584 V pk at the gain-worst corner with the lowest nominal rms | FROZEN | `calculations/llc/tanks.mjs` — the single table every consumer reads · assembled f_r outside ±5 % |
| 4.3 | External resonant inductance | D2 carries Lr less two cell leakages and the loop: **5.00 / 3.99 / 3.20 / 3.20 µH ±3 %**, no trim bins | one gapped ferrite at ±3 % is buildable where a ±5 % total with ±30 % leakage was not | FROZEN | `boards.tsx` `tank.lr` · `magnetics/mag-sync.mjs` · a cell leakage outside ±20 % |
| 4.4 | Dies per position | **1 / 2 / 2 / 2** × SG2M023120LJ, clip-mounted | a second 30 kW die is +₹1,560 — 5.2 % of that module alone, over the ≤ 5 % ceiling — so snubber, dead time and a thermal fold carry the one conduction-limited corner | FROZEN | `tanks.mjs` `par` ≡ `boards.tsx` `fetPar` · `envelope-grid` · a measured k_off or loop that puts that corner outside the grid |
| 4.5 | Turn-off snubber | one 1 kV C0G 1206 per die at the package pins — **330 / 680 / 1000 pF**; ledger k_off **3.4 / 5.3 / 4.0 / 4.0 nJ/(V·A)** | the snubber, not a gate resistor, sets dv/dt, and it is bounded **above** by the weak leg's ZVS energy window: 30 kW takes no more than 330 pF, and 1 nF rings the 40 kW parallel-500 V corner to 91 % | FROZEN | `tanks.mjs` `cs`/`koff` · `stress-audit` `[DPT]` · `verify-independent` `[SYNC]` · a bench value meeting the over-voltage line with less |
| 4.6 | Modulation | PFM from f_n 1.45 down to f_n **0.55** (203 → 77 kHz), then **leg-B phase shift at f_max**; burst only with the bank at 100 V or more, and the packet ends on the setpoint | into a discharged output the tank works into a near-short: bursting cost 129 A peaks and ±13 % ripple where continuous phase shift held 22–44 A | FROZEN | `hal/llc.c` · `hal_test` · `control/fw-constants-sync.mjs` · a tank change |
| 4.7 | ZVS floor | the higher of f_n 0.55 and the tolerance-worst ZVS boundary for the load in force + 3 %, the load estimate rising instantly and decaying over ≈ 10 ms | losing ZVS is a hard failure, so the floor must rise on the same call as the load step | FROZEN | `hal/llc.c` `llc_zvs_fn` · `hal_test` · a tank tolerance change |
| 4.8 | Dead time, shifted leg | `t_dead = 1.25 · 2 · par · (Q_oss(V) + C_s·V) / I_toff`, clamped **120–900 ns**, Q_oss from the E_oss ∝ V^1.5 curve (371 nC at 800 V) | a linear C_oss model carries only 49 % of the real output charge | FROZEN | `hal/llc.h` `LLC_DT_*` · `fw-constants-sync` · a device with another output-charge curve |
| 4.9 | Dead time, weak leg in phase shift | **short and valley-timed**: 0.82 · (π/2) · √(L_r · C_node) = **125 / 186 / 189 ns**, C_node = 2·par·(Q_oss(V)/V + C_s) | at load the zero state ends with the rectifier conducting, so L_m is clamped and the leg swings on the decayed tank current through **L_r alone** — it valleys in a quarter period and swings back at ≈ 300 A/µs, so a later edge turns on hard against the whole link at 60–130 W per die | FROZEN | `hal/llc.c` `weak_dead_s` · `spice/llc/llc-run.mjs` `weakDead` · `fw-constants-sync` · T-58 outside the window |
| 4.10 | Dead-time floor | **120 ns** | the driver publishes 70/80/110 ns propagation and no matching figure, so one leg's channels can differ by 40 ns and a 60 ns command cross-conducts — the ~3 W per die of body-diode conduction is bought against an event that destroys the leg | FROZEN | `hal/llc.h` `LLC_DT_MIN_S` ≡ `port/gd32g553/hrtimer.c` `DT_MIN` · a driver that publishes matching |
| 4.11 | CV/CC regulator | min-select CV/CC with back-calculation anti-windup and a bumpless reference shaper (500 V/s, 1 000 A/s, 80 ms stop); the voltage-loop gain is divided by the modulator's published sensitivity | the demand map's dV/du spans 23× across the envelope, so one fixed PI pair limit-cycled — the plant is inverted in the loop, not in the modulator | FROZEN | `core/ctl.c` · `hal/llc.h` `k_norm` · `ctl_test` · a modulator map change |

## 5. Magnetics

| # | Decision | Value | Why | Status | Held by · invalidator |
|---|---|---|---|---|---|
| 5.1 | D1 PFC choke ×3 | **3 × T79 26µ, N = 39** · **5 × T79, N = 26** · **5 × T79, N = 24** (both 50 kW); catalogue 0077908A7 AL 37 nH/T² ±8 %, lot-trim ±1 turn | the **biased** inductance at the crest, not L₀, governs ripple and the trip race | FROZEN | `pfc/pfc-design.mjs` · `magnetics/mag-sync.mjs` · a first-article L(I) outside the lot window |
| 5.2 | D2 resonant inductor ×1 | 2 × E70/33/32 PC95 class, N = 5, compacted litz in one layer ≥ 3 mm clear of a **distributed** centre-leg gap specified **per flux path** (≤ 1.0 mm per segment, parallel sets never summed) | fringing at a lumped gap lands in the litz, and summing parallel sets halves the real gap | FROZEN | `magnetics/mag-sync.mjs` · `magnetics-envelope` · assembled AL outside ±3 % |
| 5.3 | D3 transformer cells ×2 | **2 × E70 6:6∥6** (30 kW) · **3 × E70 4:4∥4** (40 / 50 kW); S1–P–S2 with S1 ∥ S2 to one bank; TIW-served litz primary, copper-foil secondary halves, VPI Class H, both yoke faces bonded, end turns potted. Supplied as a **matched pair** | two cells fit the 66 mm tunnel where one tall stack does not; a ±7 % Lm mismatch moves ≤ 8.3 % of the current between them in LOW mode | FROZEN | `magnetics/mag-sync.mjs` · `magnetics-envelope` `[IMBALANCE]` · a first-article short-circuit R or hot-spot outside its bracket |
| 5.4 | Powder cores | **prohibited on full-AC-swing HF duty** (D2, D3); kept only where the duty is DC-biased (D1) | sendust at the full 140 kHz swing computes ≈ 43 W of core loss against a ≈ 4 W budget, with 2:1 inductance swing per cycle | FROZEN | `magnetics-envelope` · `temp-critique` · nothing — it is a material law |
| 5.5 | D4 aux flyback ×1 | ETD44 PC95, 110 W class, 321–860 V input, Lp 345 µH ±5 %, P/2–S–P/2 sandwich, leakage ≤ 4 µH | smaller cores ran the clamp flux at 71–85 % of hot B_sat on the one part every module depends on | FROZEN | `magnetics/d4-flyback.mjs` · `stress-audit` `[D4]` · a clamp flux above 80 % of B_sat(130 °C) |
| 5.6 | D7 CM chokes ×2 | nanocrystalline 2 mH class wound to the SKU's line current: T 80/50/25 (30 / 40 kW) · T 90/50/30 (50 kW); acceptance L_cm ≥ 2 mH at 10 kHz **and** ≥ 1.0 mH at 150 kHz under DM bias | a catalogue part sized on 4 mm² wire ran 14–28 A/mm², and inductance at 10 kHz says nothing about 150 kHz | FROZEN | `emi/dm-choke-design.mjs` · `stress-audit` D7 CM flux (17–27 mT on 1.155 T) · a leakage flux above the DM bias line |
| 5.7 | Thermal and insulation acceptance | D2 / D3 hot-spot **type test bonded as in service**: ≤ 125 °C at 55 °C inlet, ≤ 135 °C at 75 °C derated inlet, with +25 % R_th and runaway-margin rows gated. UL 1446-recognised **system**, Class F minimum, **Class H for D2 and D3**, organics UL 94 V-0 | core flux is volt-second-pinned and does not derate, so the ΔT line is what caps the winder's thermal resistance — and a barrier is only as good as the system it was qualified in | FROZEN | `magnetics-envelope` · `magnetics-rfq-audit.mjs` · T-31 |
| 5.8 | Bond-loss cover | NC snap-action cutouts at 130 ± 5 °C on each D3 cell and on D2 (and on each D1 of the sealed liquid module), series-wired into the transformer NTC loop; an open loop reads 150 °C and latches F.22 | a lost gap-pad bond has no other observable, and the sealed module has no air path to fall back on | FROZEN | `core/fsm.h` `PMP_NTC_OPEN_C` · `parts-db` mechanical lines · an EOL soak that covers it another way |

## 6. Output stage

| # | Decision | Value | Why | Status | Held by · invalidator |
|---|---|---|---|---|---|
| 6.1 | Two output banks | one transformer secondary per bank into a SiC JBS full bridge, **2 × 40 A per position** on every SKU | one 40 A part everywhere is one line to buy; a single part per position at 30 kW cost +135 W and 1.11× the airflow | FROZEN | `tanks.mjs` `JBS_POS` · an RFQ diode that is not the 2-terminal 40 A class |
| 6.2 | Bank filter | **film only** — 9 / 12 / 14 / 14 × 2.2 µF 630 V across each bank; no bank inductor, no electrolytic | the film bank alone holds ≤ 0.5 % rms output ripple at −10 % capacitance on every simulated corner | FROZEN | `boards.tsx` `bankF` · `current-coordination` `[OUT]` · a film lot outside the 630 V / 2.2 µF acceptance |
| 6.3 | S/P relay matrix | KSER + KPARA + KPARB PCB power relays, 120 A class (150 A at 50 kW), switched at **zero current** with the LLC stopped; 74HC02 exclusion makes the KSER coil = KSER ∧ ¬(KPARA ∨ KPARB) | zero-current switching behind the output diode lets three plain relays replace a contactor, pre-insertion resistors and mirror contacts; every destructive matrix state involves KSER, so one gate covers them all | FROZEN | `cells.tsx` `SeriesParallelRelayMatrix` · `verify-independent` exclusion truth table · an RFQ relay whose suppressed release + bounce exceeds 35 ms |
| 6.4 | Make permit and sequencing | close only at ≤ 2 A **and** with the new stack ≥ 10 V below the output node (60 V floor); open every contact first, weld-check the mirrors, wait ≥ 51 ms for a suppressed release, 40 ms settle after a make; a stalled start latches F.34 at 8 s | a crossover under a live battery put ~1 kV onto ~500 V **through the closing contact**, and a coil-diode freewheel stretches drop-out 2–3× | FROZEN | `core/fsm.h` `PMP_MAKE_*`/`PMP_RELAY_MAKE_MS` · `fsm.c` `ST_MODESW` · `host_sim` · a relay rated to make under load |
| 6.5 | Output blocking diode | **DOUT** 1600 V insulated-base module in series with the output — 150 / 200 / 250 / 250 A class | it makes back-feed and reverse battery harmless without an output contactor, and it is what lets modules share one bus | FROZEN | `cells.tsx` · `parts-db` · a system that cannot accept the ≈ 1.05 V × I_out loss |
| 6.6 | Output current sense | manganin 50 mV Kelvin shunt — **0.500 / 0.376 / 0.299 mΩ** — wired so **delivering** current reads **positive** on `SNS_IOUT` | the sign convention has to be fixed in copper, or every bring-up check is ambiguous | FROZEN | `cells.tsx` `OutputShunt` · [firmware guide](firmware-guide.md) · a shunt orientation change |
| 6.7 | Output films | 2 × 4.7 µF 1200 V across the studs, behind DOUT | a third energy store the bank bleeders cannot reach — hence the stud bleeder and the label in 3.13 | FROZEN | `cells.tsx` · `system/fault-energy.mjs` · an output ripple requirement change |

## 7. Gate drive and SiC switching

| # | Decision | Value | Why | Status | Held by · invalidator |
|---|---|---|---|---|---|
| 7.1 | Isolated driver | **NSI6611** per switch position — 10 A, DESAT, Miller clamp, UVLO, reinforced isolation; bias COM ≡ GND2 ≡ the Kelvin node, TEST and IN− to GND1, ASC tied inactive | a bias COM floating on a private net against the FET source is a gate loop that does not exist | FROZEN | `cells.tsx` `DriverCh` · `verify-independent` (GND2 ≡ Kelvin, one node) |
| 7.2 | DESAT | 100 Ω series resistor at the pin, blanking capacitor driver-side on DST–Kelvin: **47 pF Vienna** (worst response 2.21 µs) · **18 pF LLC** (0.47 µs minimum blank, 1.34 µs total with two dies) | blank + LEB + sense-to-OUT + soft-off must sit inside 75 % of the SiC short-circuit withstand, and the soft-off term doubles on a two-die position | FROZEN | `cells.tsx` `cBlank` · BOM `MLCC-18p-0603`/`MLCC-47p-0603` · a vendor withstand below 2 µs at 830 V |
| 7.3 | Gate resistors | Vienna R_g,on 4.7 Ω / R_g,off 4.7 Ω · LLC R_g,on 4.7 Ω / **R_g,off 0 Ω** (the 1206 land kept for a bench re-fit) | on the LLC the per-die snubber sets dv/dt, and 4.7 Ω would cost 3–5× the turn-off energy — thermally impossible on the one-die 30 kW | FROZEN | `cells.tsx` · `stress-audit` `[DPT]` · a measured loop above 10 nH |
| 7.4 | Gate bias | reinforced isolated modules, **+15 / −3 V**; 1 W class per channel, **2 W** where one channel drives two dies. Acceptance +15 V ±5 % at 20–100 % load, ≤ +17.5 V at 5 % load, C_io ≤ 5 pF | +18 V exceeds the registered second source's static maximum; a two-die channel at f_max draws 113–159 % of a 1 W module, and a drooping rail raises R_DS(on) before it trips UVLO; −3 V keeps 2 V to the SiC gate's −5 V conditional floor | FROZEN | `parts-db` `ISO-GBIAS-15-1W`/`-2W` · `verify-independent` · a frozen MOSFET whose recommended V_GS is +18 V |
| 7.5 | Commutation loop and CM | drawing rules **LLC bridge ≤ 5 nH, Vienna leg ≤ 7 nH** (laminated bus, films at the package pins) and **leg-node-to-PE ≤ 100 pF**, target 50 pF, with a copper shield under the Al₂O₃ pad returned to DCN. **≤ 10 nH measured externally is the binding acceptance before any high-power run** | the double-pulse deck reads 78–92 % of 1200 V at 10 nH and **90–103 % at 20–30 nH** with R_g,off 0 Ω; and the leg nodes swing 830 V at 83–203 kHz, so every picofarad to earth is CISPR current. Above 10 nH the choice is a gate resistor **and** a second 30 kW die or a fold | FROZEN (rule) · ASSUMED (value) | `cells.tsx` layout rules · `stress-audit` `[DPT]` · `lisn-precompliance` CM budget · a ring-down above 10 nH at T-59 / T-71, or T-13 above 100 pF |
| 7.6 | Double-pulse acceptance | repetitive peaks ≤ **85 %** of device rating, ≤ **90 %** on the +6 % link row | the link itself is ≤ 69 % of rating, both die classes are avalanche-rated, and 85 % is what an achievable loop delivers at 100–165 A turn-off | FROZEN | `stress-audit` `[DPT]` on fingerprinted CSVs · a measured peak above the line |

## 8. Sensing and protection architecture

| # | Decision | Value | Why | Status | Held by · invalidator |
|---|---|---|---|---|---|
| 8.1 | Split of responsibility | **hardware where a device has microseconds to live; firmware everywhere else** | independent hardware costs money and adds failure modes, so it is spent only where reaction time, device survival or failure-mode independence demands it | FROZEN | [protection thresholds](protection-thresholds.md) · `review-checks` |
| 8.2 | Line current sensing | 2500:1 CTs per phase on **22 / 18 / 13 Ω** burdens, biased to a buffered mid-rail | CTs are inherently isolated and faster than a shunt path, and the burden keeps the fault peak plus the soft-saturation race inside the 3.3 V rail | FROZEN | `current-coordination` · `parts-db` · a CT missing ≤ 1 µs to 90 % on a 10 A step |
| 8.3 | Fast line over-current | **F.01 = 120 / 155 / 195 A pk**, comparator → HRTIMER kill, **positive-only** references, with a 100 kHz software magnitude trip for the other polarity | a reference below the mid-rail into a non-inverting comparator on an active-high fault input is a standing fault at power-up, and DESAT sees only the forward polarity | FROZEN | `hal/app.c` · `current-coordination` `[F.01]` · **O-15** (trip polarity — EVT injection decides) |
| 8.4 | Tank current sensing | one 1:100 resonant CT on the tank, burden **0.47 / 0.36 / 0.30 Ω**; **F.11 = 140 / 180 / 220 A pk** through a window comparator onto the merged fault line | the tank conductor is the CT primary, so tank-potential insulation stays on the wire, and a window comparator catches both polarities | FROZEN | `current-coordination` `[F.11]` · `cells.tsx` `F11Window` · a tank class change |
| 8.5 | Comparator ownership | phases A / B / C own **CMP3 / CMP1 / CMP2**; link OVP on CMP4, output OVP on CMP0; every signal on a non-inverting input against an internal DAC, each on its own fault channel | two signals on opposite inputs of one comparator are not two comparators, and the DAC drives only one side | FROZEN | `control/umod-pinmap.mts` · `verify-independent` pin ownership, traced to the shipped face · a HAL configuring other instances |
| 8.6 | HV voltage sensing | every HV sense **isolated** — iso-amps against a 3 × 33 kΩ artificial star for the AC phases, against DCN for the link, against the bank and output returns elsewhere, each with its own reinforced bias module; 1 nF at every ADC pin, 100 Ω at every iso-amp output | resistive dividers to analogue ground breach the reinforced barrier and float the reference the ADC measures against | FROZEN | `cells.tsx` `IsoVSense`/`AnalogMid` · `verify-independent` · a sense topology change |
| 8.7 | Junction observer | `hal/dielim.c`: per millisecond, worst-die loss at the operating point → a first-order junction estimate above the **measured** zone NTC (τ 0.5 s, R_th 0.80 air / 0.65 liquid K/W) → availability folded from 142 to 150 °C; a point it cannot cool is **DECLINED** and latched until the LLC stops | an observer, not a static ceiling: every start crosses deep phase shift for a few hundred ms, where a static ceiling read 0 A and the module never started | FROZEN | `hal/dielim.h` · `fw-constants-sync` · `app_test` · a measured mount R_th above the basis |
| 8.8 | Hardware trip latching | every hardware trip is held in `trip_n` / `trip_ack` until the supervisor latches it; an output is enabled in **one** place, on its OFF → ON transition only, inside a critical section that checks the supervisor's acknowledgement and the timer's own fault flags before the write and the flags again after it (a completed fault pulse is never followed by a stale enable); only the fault interrupt clears a flag; everything the control interrupts execute or read lives in TCM and the build audits the linked image | the control interrupts otherwise re-armed the outputs 10 / 100 µs after every trip, and a fault landing inside the decision-to-write window re-armed a killed stage — for one period, or for good once the source of a pulse fault was gone | FROZEN | `hal/app.c` · `port/gd32g553/port.c` `outputs_commit` · `build.sh` TCM audit · `app_test` · `review-checks` `OUTPUTS-COMMIT` · T-44 |
| 8.9 | Watchdog chain | external windowed watchdog, **fixed window 2.22–23.375 ms**; the open-drain WDO wire-ORs onto NRST so it gates GATE_EN **and** resets the MCU; GATE_EN = AND(MCU enable, WDO, DRV_RDY) with default-OFF pull-downs on every gate and harness PWM line — the drivers' wired-OR ready line is the third input, so a collapsing gate-drive bias drops both enables in hardware ahead of the 1 ms firmware path (rails → `aux_ok` → SAFE, fresh ENABLE) | a WDO that only gated the enable re-enabled the gates with the MCU still hung and its enable GPIOs latched high; an unpowered driver's gate has neither clamp nor UVLO hold and must not face the others' dv/dt for a millisecond | FROZEN | `cells.tsx` `SafetyChain` · `verify-independent` (WDO ≡ NRST, netlist and face) · `review-checks` `DRV-RDY-IN-AND` · T-80 · a watchdog with another window |
| 8.10 | Watchdog service | a token purse: `flash_service()` services both watchdogs around flash operations, RAM-resident flash primitives, a direct WDI edge when the last is ≥ 2.5 ms old | one P-256 verification is ≈ 90–105 ms un-serviced against a 23.375 ms window, twice per boot | FROZEN | `port/port.c` · `boot/image.c` · `boot_test` |
| 8.11 | Recovery classes | AUTO_EXT · AUTO_INT · LATCH · LOCK, a 2 → 64 s doubling hold, lockout after 5 latches in 10 min; an F.01 within 500 ms of a disturbed line is filed as **F.08, AUTO_EXT, uncounted** | at a line return the EMI filter rings above the link and the boost **diodes** conduct 121–199 A pk the switches cannot stop — the comparator is right to fire, the class was wrong | FROZEN | `core/fsm.h` `PMP_LINE_EVT_*`/`PMP_RECOVER_*` · `host_sim` |
| 8.12 | Fault ladder | **F.01–F.38**, every threshold and persistence in `core/fsm.h`, per-SKU windows selected from the RATING strap | one table, one owner: a row that is not in the header does not exist | FROZEN | [protection thresholds](protection-thresholds.md) · `review-checks` · `fw-constants-sync` |

## 9. Control card, MCU and firmware

| # | Decision | Value | Why | Status | Held by · invalidator |
|---|---|---|---|---|---|
| 9.1 | One card, one MCU, one image | one control card per module in the DC-DC board's 88-way slot runs both stages; the whole PFC bundle crosses a 40-way straight-through harness. No second MCU, no inter-card link | a two-brain partition buys nothing and carries an inter-brain-link failure class | FROZEN | `control/umod-pinmap.mts` (single pin-map source) · `module-interconnect-audit.mts` · a rating needing more PWM or analogue ways than the card has |
| 9.2 | MCU | **GD32G553VET7** — Cortex-M33 216 MHz, LQFP100, 105 °C, HRTIMER 8 slave units / 16 outputs, 4 ADCs, 8 comparators, 3 CAN-FD, 32 KB TCM; card pin-compatible with STM32G474VET7 | second-source insurance on the one part with no alternate, at zero cost while the boards are drawings | FROZEN | `parts-db` · `control/umod-pinmap.mts` · a capability the datasheet does not support |
| 9.3 | RATING strap | 0 Ω → 30 kW · 1 k → 40 kW · 3.32 k → reserved · 10 k → 50 kW liquid · 15 k → 50 kW air · open → fault; an unplaceable strap runs the tightest classes with delivery inhibited | one card part number and one image for the family, with the per-SKU parameters read at boot | FROZEN | `hal/meas.c` `meas_rating_kw` · `control/port-pin-audit.mjs` · a fifth SKU |
| 9.4 | Timer allocation | all PWM on the HRTIMER — ST0–ST2 the LLC pairs (hardware dead time per leg), ST3–ST5 the PFC singles; one merged fault line on HRTIMER_FLT2 with a 1.19 µs filter; dead-time generator at 2.315 ns per step | hardware dead time per leg is the only thing a firmware fault cannot cross-conduct through | FROZEN | `port/gd32g553/hrtimer.c` · `verify-independent` |
| 9.5 | Control-interrupt trigger | the **ADC end-of-sequence DMA transfer**, not a timer compare — the ISR starts ≈ 2.8 µs after the trigger with ≈ **7.2 µs** to the compare-shadow reload, against a 5.8 µs static ISR. The single-update PFC fallback is **forbidden on 40 / 50 kW** | a centre-aligned compare is crossed twice per period and equal-spaced only at CAR/2; and the fallback halves the ISR load but drops the input-filter modulus margin to 0.26 / 0.17 | FROZEN | `port/gd32g553/adc.c` · `out/pfc-filter-stability.csv` · T-64 measuring the ISR above 5 µs |
| 9.6 | TCM residency | the whole 100 kHz path and the vector table execute from TCM RAM | a flash write stalls instruction fetch in the same bank | FROZEN | `port/gd32g553/flash_map.h` · `.ramfunc` placement |
| 9.7 | Firmware layering | `proto/` profiles → `core/modapi.h` canonical model → power core; **no `core/` file includes `proto/`** | adding a vendor protocol must be a file and a registry line, never a change in the power core | FROZEN | `firmware/run_tests.sh` · `review-checks` · a core file that includes a profile |
| 9.8 | Vendor port | register-level GD32G553 port with **zero vendor code**, every register line-cited to the user manual | the vendor library licence was not accepted | FROZEN | `firmware/port/gd32g553` · `control/port-pin-audit.mjs` · a licence decision |
| 9.9 | Boot chain | signed A/B slots (SHA-256 + ECDSA-P256), 208 KB each, one per flash bank, behind a 32 KB bootloader; trial / confirm / rollback with a reset-streak safe mode and a minimum-version baseline; confirmed after 60 s healthy | a field update that cannot roll back is a field visit | FROZEN | `firmware/boot` · `boot_test` vectors against OpenSSL and an independent big-integer implementation |
| 9.10 | Flash journals | three journals in bank 1 — boot control, application records, event ring — with a **16-byte header, 8-aligned entries, the commit marker alone in the last row**; a torn row raises a counted NMI that returns | the flash programs a row once, so a 12-byte header put every record on an already-programmed row and **nothing persisted** | FROZEN | `port/gd32g553/flash_map.h` · `hal/nvm.c` · `boot_test` · a flash geometry change |
| 9.11 | Field update | CAN service-space update, 1 KB blocks with lost-ACK resends; REBOOT, ENTER_BOOT and FACTORY_RESET refused while a stage is live | a reboot command must never be able to open a contactor under load | FROZEN | `boot/updater.c` · `boot/svc.c` · `proto_test` |
| 9.12 | Reference and identity | the factory `VREFINT_CAL` word replaces the 1.20 V nominal, converted **outside** the 100 kHz ring at 28.5 µs, once at boot; the comparator DAC codes are the **inverse of the corrected measurement** at the `k_ref` in force, and `k_ref` is that boot reading times a **live tracker** — the common DC of the three AC channels, which the line cannot produce — bounded to ±2 % (F.29 beyond) and off on an uncalibrated card — each clean-cycle estimate integrated **once**, held through a line outage or a disturbed cycle (the rail moves thermally; the tracker's 0.2 s constant re-converges it through precharge, before any output); identity is the CRC-32 of the full 96-bit UID | the part needs ≥ 17.1 µs of sampling and was converted in 132 ns, which put F.29 100 ms after every boot; the DACs are VREFP-referenced like the ADC, so a code written on the nominal scale moved F.03 by 62 V for a rail 2.5 % high, and a boot-only reading left it drifting 25 V per percent of rail movement afterwards (885 V at +1 %, past the 880 V bench line) | FROZEN | `hal/app.c` `dac_v` · `hal/meas.c` `dcc` · `hal_test` · `app_test` · `review-checks` `VREF-LIVE-TRACKER` · T-26 |
| 9.13 | Service entry | both HMI buttons held ≥ 3 s inside the first 10 s after boot, with both stages off | a service entry reachable with power flowing is a hazard, not a feature | FROZEN | `hal/app.c` `panel()` · `app_test` |

## 10. Communications

| # | Decision | Value | Why | Status | Held by · invalidator |
|---|---|---|---|---|---|
| 10.1 | Physical bus | one isolated CAN 2.0B port per module — ≥ 5 kV transceiver, its own common-mode choke, both domains locally bypassed | the CAN shell leaves the SELV domain and reaches a cabinet | FROZEN | `cells.tsx` `IsolatedCan` · `verify-independent` |
| 10.2 | Native protocol | **VMP 2.0** — marker bit 25, 208 modules and 16 groups, one scaling per quantity, CRC-8/AUTOSAR and 4-bit counters on power commands, ACK with 16 status codes, ownership, heartbeat sessions, UID discovery with incumbent-wins, u64 fault and warning bits, must-understand bits, major.minor versioning | it must coexist with J1939 and vendor traffic on one bus, and a frozen counter must never refresh freshness | FROZEN | `proto/vmp.c` · `proto_test` · [CAN protocol](can-protocol.md) |
| 10.3 | Compatibility profile | **TonHe V1.2**, byte-exact against the document's own examples — bitmap addressing with the address multiple, range-edge setpoints, umbrella bits, the 20 s rule, peer-average sharing; `PMP_WITH_TONHE_V12=0` removes it from an image | a drop-in vendor replacement is a sales requirement and must not contaminate the core or ship where it is unwanted | FROZEN | `proto/tonhe_v12.c` · [TonHe profile](can-profile-tonhe-v12.md) · an interop capture (T-46) contradicting a registered ambiguity reading |
| 10.4 | Timeout ownership | the communication timeout belongs to the **profile**, not the core; one profile per boot from the stored id, never changed while energized | TonHe monitors send a 5 s heartbeat and stop at 20 s, so a core-fixed 1 s timeout stopped a TonHe drop-in one second after every setpoint | FROZEN | `core/fsm.h` `PMP_CAN_TO_MS` (native default) · `proto/profile.c` · a profile change applied while energized |
| 10.5 | Loss of the controller | a **controlled stop**: the current reference ramps to zero over 100 ms before the LLC stops, with F.16 suppressed during it | dropping the bridge on a timeout produced a false short-circuit fault on the way down | FROZEN | `core/fsm.h` `PMP_STOP_RAMP_MS` · `host_sim` |

## 11. Auxiliary supply, cooling and mechanics

| # | Decision | Value | Why | Status | Held by · invalidator |
|---|---|---|---|---|---|
| 11.1 | Aux topology | 110 W flyback off the **full link** (321–860 V), 1700 V SiC switch, 65 kHz DCM, 400 V ultrafast secondary rectifiers, 220 µF VCC reservoir | a half-link feed sits at 201–283 V at cold start, so the module never boots below ≈ 424 VAC; the full-bus feed is also balance-neutral | FROZEN | `cells.tsx` `AuxPower` · `spice/aux/aux-flyback.mjs` · `stress-audit` |
| 11.2 | Aux controller | **NCP1252D**; cold start ≈ 5–6 s, ≈ 8 s at low line; brown-out at a 321 V link | the A-suffix carries a mandatory 120 ms pre-soft-start delay on 1.0 V of VCC hysteresis and hiccups forever; 321 V is the flyback's full-load DCM floor, so it cannot be lowered to buy discharge time | FROZEN | `parts-db` `UAUX` · `spice/aux/aux-flyback.mjs` · a flyback redesign |
| 11.3 | Rails | **V24** (relay coils, fans, 4.7 kΩ preload) · **V15** (driver bias modules, card feed) · **3.3 V from a sync buck on each board** | the AC-DC board has no card slot to source 3.3 V from, and an unloaded V24 peak-charged past the relay coil maximum | FROZEN | `cells.tsx` `Rail3V3` · `verify-independent` (V3P3 sourcing) |
| 11.4 | SELV control domain | one floating SELV domain — AGND–DGND single-point tie per board, DGND → PE through 1 MΩ ∥ 4.7 nF; HMI, SWD, fans and CAN touch-safe; NTC tips insulated; the discharge gate isolated | a resistive path from any HV node to control ground breaches the reinforced barrier and floats the reference the ADC measures against | FROZEN | [insulation](insulation-coordination.md) · `verify-independent` |
| 11.5 | Cooling | **3 / 3 / 0 / 4 fans**; the 50 kW liquid module is sealed — two brazed-channel coldplates replace both extrusions, 50/50 EG-water, inlet ≤ 60 °C, **7 L/min nominal** (coolant rise ≤ 5 K at the worst continuous loss) and ≥ 3 L/min minimum, with plate NTCs into the over-temperature ladder as the dry-run cover | flow assurance belongs to the cooling cart, like the grid breaker; the air budget is per-SKU watts at 55 °C inlet density with one fan out still covered | FROZEN | `hal/app.c` `n_fans` · `system/fault-energy.mjs` air budget · **O-16** |
| 11.6 | Fans | 120 × 38 mm PWM, **≤ 0.6 A at 24 V (≤ 14 W)** at 100 %, start surge ≤ 1.5 A for ≤ 0.3 s, dual-ball L10 ≥ 70 kh at 40 °C, IP55, −30…+70 °C; supervision is a duty-proportional tach curve and the core derates by **failed count** (0.6 / 0.3 on four fans) | the 110 W aux is sized on this class — a 25 W fan overloads the four-fan module into the aux controller's latched over-current; and one boolean cannot distinguish one dead fan from four | FROZEN | `parts-db` mechanical lines · `hal/app.c` · `host_sim` · an RFQ fan above 14 W |
| 11.7 | Device mount | every TO-247 die clip-mounted on 0.635 mm Al₂O₃ with grease: **0.8 K/W** junction → extrusion base (air), **0.65 K/W** junction → coldplate. Base under the die at 55 °C inlet: **74 / 75 / — / 77 °C** air, **65 °C** plate | one mount basis for every junction-temperature engine; a 70 °C base at a 55 °C inlet is below the outlet air temperature and put every junction 5–11 K optimistic | BASELINED | `thermal/mount.mjs` (`AIR_REF`) · `stress-audit` · T-04 / T-38 (above 0.92 K/W) |
| 11.8 | Construction | two-board sandwich — AC-DC lower, DC-DC upper, faces inward, semiconductors on the outer extrusions or plates; both boards 6-layer 440 × 500 mm; 3U 19-inch card. A 2U chassis is a costed scenario, not the basis | the sandwich puts every switch on an outer face and keeps the control strip away from every switching node | FROZEN | `boards/*` · [interconnect](interconnect.md) · a mechanical design that proves the 2U prerequisites |
| 11.9 | Module boundary | 3 × M8 stud pillars DCP · DCN · PE at 12 N·m, < 50 µΩ per joint, ≥ 14 mm stud-to-stud creepage; one 40-way straight-through harness (Micro-Fit 3.0 class, 5 A per contact); one 88-way card slot; two buttons and a two-digit display on the DC-DC board | one harness, one connector pair and three studs are the whole boundary a charger has to meet, and the module must be readable without a laptop | FROZEN | `module-interconnect-audit.mts` · `busbar/busbar-calc.mjs` · [interconnect](interconnect.md) |

## 12. Production, BOM and cost basis

| # | Decision | Value | Why | Status | Held by · invalidator |
|---|---|---|---|---|---|
| 12.1 | Volume basis | ≥ **10,000 units/yr**; the 10k tier is the planning basis (×0.80 electrical / ×0.87 mechanical off the 1k targets, plus per-part 10k quote overrides) | at this volume packaged modules beat custom assemblies on landed cost and risk, which settles several make-versus-buy rows on its own | ASSUMED | `cost/bom-gen.mjs` · `parts-db` · RFQ round 1 at committed volumes (±25 % until then) |
| 12.2 | Build cost at 10k, India | **₹31,613 / 36,103 / 42,761 / 40,688** = ₹1,054 / 903 / 855 / 814 per kW | a roll-up of quotes, class prices and flagged estimates — a planning number, not a quotation | BASELINED | [BOM & cost](bom-cost.md) (generated) · an RFQ line outside its ±25 % band |
| 12.3 | China RFQ target column | **₹25,920 / 29,520 / 35,023 / 33,243** by category factor — semiconductors ×0.75, magnetics and capacitors ×0.80, ICs/relays/protection ×0.85, passives ×0.90, PCB ×0.75, mechanical ×0.85, India assembly ×1.00 | targets to negotiate against, not quotes; duty per HSN code is a customs-broker question | ASSUMED | `parts-db` CN factors · a landed quote more than 25 % above its target |
| 12.4 | Red lines | ₹25k / 33k / 43k / 43k — 30 kW over by ₹6,613, 40 kW by ₹3,103, both 50 kW modules under | the 30 kW residual is platform overhead (card, gate drive, relay matrix, filter): ≈ 22 % of the module at 30 kW against ≈ 13 % at 50 kW — structural, not waste | BASELINED | [BOM & cost](bom-cost.md) lever table, each lever gated on its own condition · a product decision on the ladder |
| 12.5 | Sourcing maturity | every part number the BOM can emit resolves to ORDERABLE, SECOND-SOURCE, DIRECT, CLASS (spec + candidates), CUSTOM (drawing) or tracked REVIEW; an unmapped or substance-free line fails the battery | a BOM line with no status is a purchase order waiting to guess | FROZEN | `cost/bom-maturity.mjs` · `cost/lcsc-map.mjs` |
| 12.6 | Release face | the KiCad-5 import set `kicad5/DC-Modules-<sku>-SHIP.zip` plus the printed sheets in `boards/out-pdf/`, verified pin-by-pin against the payloads **and** traced on the shipped face | the consumer is real KiCad, and a face verified only against its own payload can ship a stale sheet | FROZEN | `kicad5-gen.mjs` · `kicad5-verify.mjs` · `verify-independent` face check |
| 12.7 | Scope and schematic standard | schematics, BOM and nets only — placement and routing out of scope, builds in netlist mode. Every cell carries a documented envelope on a grid and a section name; cross-section connectivity renders as **named net labels, never routed wires**; zero symbol overlaps on every built board | the layout phase reopens on a directive, and its binding rules (loop inductances, CM capacitance, creepage) are already registered here so it can; a reviewer reads the face, so the face has to be the truth | FROZEN | `run-all.sh` (`TSCI_NO_ROUTE=1`) · `schematic-check.mjs` · `footprint-audit.mjs` · a directive to reopen layout |
| 12.8 | Generated pages | the per-module BOM and magnetics pages are generated from each gate's captured evidence and never hand-edited; a failing gate cannot be published as proof | a hand-edited proof is not a proof | FROZEN | `cost/bom-gen.mjs` · `magnetics/mag-docs.mjs` · `evidence.mjs` · a hand edit |
| 12.9 | Reliability basis | parts-count prediction with the basis **declared** — SR-332-class rates, 40 °C internal mean, quality II, wear-out excluded and tabled separately; fans are the first wear item | a reliability figure without its basis is not comparable with anybody's | BASELINED | `reliability/mtbf-budget.mjs` · [reliability budget](reliability-budget.md) · ±1 % drift fails the battery |

## 13. Component and model assumptions — confirm at RFQ or EVT

| # | Assumption | Value | Why it is still open | Status | Confirmed by |
|---|---|---|---|---|---|
| 13.1 | SiC device models | VDMOS fits to headline data, E_on / E_off within ±40 %; R_DS(on) ×(1 + 0.004·(T − 25)) in the ledgers and 0.0054 /K in the junction observer | no vendor model without an NDA, and the chosen die publishes no curve | ASSUMED | vendor models and curves + bench double pulse (T-71) |
| 13.2 | Magnetic material fits | sendust 60µ 80 % at 30 Oe · 26µ 80 % at 75 Oe · loss 52.4·B^2.12·f^1.46, D1 pinned to catalogue AL 37 nH/T² ±8 % and A_e 2.27 cm²; PC95-class loss 3.2e-8·f_kHz^1.71·B_mT^2.9, checked conservative by ≈ 1.7× | catalogue curves and fits, not measured lots | ASSUMED | first-article L(I) at −30 / +25 / +100 °C and first-article loss (T-31) |
| 13.3 | Three device classes with no datasheet | SG2M023120LJ, the 750 V Vienna pair, the 1200 V 40 A JBS — every budget reads the **RFQ acceptance line**, never a proxy's typical: E_off ≤ 0.45 mJ (800 V / 50 A / 2.5 Ω / 175 °C), E_oss ≤ 110 µJ at 800 V, I_DM ≥ 265 / 210 / 260 A, I_FSM ≥ 250 A | the parts are quoted, not published | ASSUMED | RFQ round 1; a part above any line re-runs the grid before it is accepted |
| 13.4 | Line CT at 50 kHz | amplitude and phase at 50 kHz, ≤ 1 µs to 90 % on a 10 A step, ratio within 1 % with 5 A DC superimposed | no vendor data at this frequency | ASSUMED | T-69; the drawn shunt + iso-amp is the fallback |
| 13.5 | DC-link can duty | RFQ line ≥ 5.2 A rms at 100 kHz / 105 °C, ESR ≤ 80 mΩ; drawn duty 5.7 / 6.5 / 5.9 A per can at 400 VAC and **6.7 / 7.6 / 7.0 A at 340 VAC, a declared exceedance** | a 5.2 A / 100 kHz 470 µF 500 V can is at the top of what a 35 mm case offers | ASSUMED | T-74; a taller can or one more can per half are the levers |
| 13.6 | Precharge resistor failure mode | flameproof, **fail-open** under sustained overload | a shorted link puts 4.8 kW (400 VAC) to 8.4 kW (530 VAC) on each resistor and nothing in the module can disconnect it | ASSUMED | the sacrificial-resistor EVT row — one resistor across a shorted link, opens without flame |
| 13.7 | Relay ratings | make 300 A / 10 ms class; the bypass relays additionally make ≥ 260 / 280 / 360 A pk at ≤ 70 V for ≥ 30 000 operations, suppressed release + bounce ≤ 35 ms | catalogue classes, not qualified samples | ASSUMED | vendor datasheet + qualification |
| 13.8 | Modelling inputs | fan static pressure 110 Pa at the 160 m³/h class; grid impedance 30 µH + 20 mΩ per phase, and a stiff 50 µH site for the line-return surge; prices ±25 % | site- and lot-dependent inputs the design is only weakly sensitive to — except the fan curve, which the whole air budget rests on | ASSUMED | vendor static-pressure curve · site survey if asked · RFQ round 1 |
| 13.9 | Load dump at an 830 V link | the repo plant reads 833 V, an independent model 856–872 V; both zero-cost firmware levers are already in | two models disagree and only a bench settles it | ASSUMED | T-78 |
| 13.10 | Weak-leg residual map | two independent switched models disagree by 2× at the same point; the firmware map deliberately errs high | neither model is measured | ASSUMED | T-58 / T-72 relax it |
| 13.11 | LOW-mode output clamp | no hardware clamp below 1 050 V in LOW mode; the interim is the F.13 comparator scheduled by mode while the LLC runs (560 V in LOW; 1 050 V with the bridge off, since an idle module's terminals carry the bus) on its own DAC reference | whether a second hardware clamp earns its place is a hardware decision, not a calculation | ASSUMED | a hardware decision, then T-06 / T-30 |
| 13.12 | Loss-ledger reconciliation | the ledger and the thermal grid differ by ≈ 202 W of accounting split | the two engines apportion the same watts differently | ASSUMED | **O-17** |

## 14. Simulation-fidelity decisions

| # | Decision | Value | Why | Status | Held by · invalidator |
|---|---|---|---|---|---|
| 14.1 | LLC decks | power-solved per-SKU ngspice decks with body diodes, the star held at mid-bus, a physicality guard and a tank fingerprint; acceptance is mode correctness, ZVS, stress and capability margin — **not** point power near resonance, which is FHA-limited | a deck without body diodes put the legs at ±6 kV on a 650 V bus, and every number it produced was non-physical | FROZEN | `spice/llc/llc-run.mjs` · `current-coordination` fails on a stale or unphysical deck · a tank change |
| 14.2 | PFC models | cycle-by-cycle Vienna in JavaScript with catalogue L(i), a floating neutral and Σi = 0 imposed under the DCM clamp, cross-checked against the Friedli–Kolar closed forms within 0.7 %; an averaged-switch model for line-cycle and THD runs with the switching ripple handled analytically | a switched model that lets the three phase currents stop summing to zero runs away at no load, and cycle-by-cycle three-phase PWM over a line cycle is numerically infeasible | FROZEN | `pfc/vienna-switched.mjs` · `spice/pfc/pfc-phase-run.mjs` · `verify-independent` research anchors |
| 14.3 | Double pulse | per-SKU decks at the **real** turn-off currents on the **drawn** networks, with the shipped gate bias and a corrected output-charge curve; every CSV fingerprinted and read by a gate | evidence run at 78 A and 25 A against real 95–165 A is not evidence, and nothing was reading it | FROZEN | `spice/double-pulse/dpt-run.mjs` · `stress-audit` `[DPT]` · a loop, snubber or gate-resistor change |
| 14.4 | DC link | its own deck with the entry film, the stud loop and the damper, swept over film count and stud inductance | the link was never in a netlist, and every can was carrying 5.8–12 A rms against a ≈ 3 A class | FROZEN | `spice/dclink/dclink-ripple.mjs` · `current-coordination` `[DCLINK]`/`[DCLINK-VIENNA]` · T-57 |
| 14.5 | EMI | the LISN solve is pre-compliance **tendency** only, never claimed as compliance | a SPICE LISN cannot substitute for a chamber | FROZEN | `emi/lisn-precompliance.mjs` · a lab scan |
| 14.6 | Magnetics | flux, core and copper loss and a two-node thermal network integrated from the real waveforms at every corner; PyOpenMagnetics is a **second opinion**, not evidence; 2-D field solvers are for first-article fringing and leakage | one model's output is not proof — the cross-check exists to disagree, and where it does (D3 copper ×1.29–1.32) the class lines are re-checked at its number | FROZEN | `magnetics-envelope` · `magnetics/mkf-crosscheck.py` · a construction change without re-running the cross-check |
| 14.7 | Host plants | a plant kinder than the hardware hides defects, so the host models row-granular program-once flash, a bounded watchdog, real comparator polarity and references, flat-topped mains and AC-coupled sensors | the plants are part of the design, not scaffolding around it | FROZEN | `firmware/test/*` · `firmware/run_tests.sh` under ASan/UBSan |
| 14.8 | Gates read results | every gate reads the result file its engine wrote; a hand-copied constant, or a check that cannot fail, is a defect | a gate that asserts a literal proves only that somebody typed it | FROZEN | `evidence.mjs` · `review-checks` · `fw-constants-sync` |

> [!TIP]
> **How this page is checked** — `stress-audit` and `review-checks` assert several of these values word for word, and every engine in `sh calculations/run-all.sh` cites a decision as its provenance: a row that stops being true fails a gate, not a review.

---

<div align="center">
<sub><a href="architecture.md">← Platform Architecture</a> &nbsp;·&nbsp; <a href="README.md">🧭 Documentation hub</a> &nbsp;·&nbsp; <a href="validation-report.md">Validation Report →</a></sub>

<sub>Vectivolt DC-Modules · documentation rev E85 · every number reproduces with <code>sh calculations/run-all.sh</code></sub>
</div>
