vectivolt/DC-Modules/docs/insulation-coordination.md

# 🧱 Insulation Coordination

<sub>The barrier map, creepage and clearance values, the standards matrix and the hipot plan</sub>

<p>
  
  
  
</p>

> [!NOTE]
> **Purpose** — the barrier map, creepage and clearance design values, the SELV architecture and the hipot plan.

## At a glance

| Rating | Value |
|---|---|
| Overvoltage category | **OVC III** at AC mains — 300 V line-to-neutral insulation class; the rated input is **285–475 VAC line-to-line** (+5 % = 499 V line-to-line, 288 V line-to-neutral, inside the 300 V class). The class is set by the line-to-neutral working voltage, not by a nominal system name, and it also sets the X2-star duty (274 VAC per 305 VAC cap at 475 VAC) |
| Pollution degree | **PD2** inside the enclosure (filtered forced air) |
| Altitude | **≤ 2000 m** (derate note above 2000 m in the manual) |
| Material group | **IIIa** (CTI ≥ 175), FR-4 baseline |
| Environment | −30…+75 °C operating, 5–95 % RH non-condensing; insulation materials quoted to −40 °C |
| Basis standards | IEC 60664-1 (coordination) · IEC 62477-1 (PECS safety — decides most clearances) · IEC/IS 61851-23 (DC EVSE system) · IEC 61000-4-x (immunity) · CISPR 32 / EN 55032-class conducted (pre-compliance) |

> [!CAUTION]
> **No compliance is claimed.** This is the design-to table; every value is to be verified against the purchased
> editions of the standards at design qualification, and the checklist at the end tracks what is still open.

## 1. The barrier map

```mermaid
flowchart LR
  AC["AC mains<br/>300 V L-N · OVC III"] -- "basic · 4 kV impulse<br/>hipot 2.5 kV DC" --- PE(("PE"))
  AC --- BUS["DC bus<br/>830 V (primary)"]
  BUS -- "REINFORCED<br/>D3 transformer · D4 aux · iso ICs ≥ 5 kVrms<br/>hipot 4 kV" --- OUT["output banks<br/>1000 VDC, floating"]
  OUT -- "basic · hipot 1.5 kV" --- PE
  BUS -- "functional<br/>isolated amplifiers + dividers" --- CTRL["control domain<br/>SELV"]
  BUS -- "REINFORCED<br/>D4 aux transformer" --- CTRL
  CTRL -- "1 MΩ ∥ 4.7 nF Y1<br/>soft bond" --- PE
  CTRL -- "iso CAN ≥ 5 kV" --- CAN["CGND<br/>external CAN"]
  BUS -- "basic<br/>bonded magnetics D1 · D2 · D3<br/>gap pad / clamp cap / bore sleeve" --- PE
  style OUT stroke:#bc4e9c,stroke-width:2px
  style CTRL stroke:#2ea44f,stroke-width:2px
```

## 2. System insulation classes

| Barrier | Class | Working V | Impulse / test |
|---|---|---|---|
| AC line ↔ PE | basic | 300 Vrms | 4 kV imp; hipot 2.5 kV DC 1 min (EOL) |
| AC/primary ↔ secondary (output) | **REINFORCED** | 1000 VDC working (output) vs primary 830 VDC | 8 kV-class imp path via transformer: D3 TIW + margins, hipot 4 kV; iso components ≥ 5 kVrms parts (NSI66xx / NSI1042-DSWR / NSI1200; isolated bias modules must be reinforced-class and free of sanctions-flagged sourcing) |
| Output ↔ PE | basic (IT-side per 61851-23 system: IMD at charger level, excluded scope) | 1000 VDC | hipot 1.5 kV; creepage per 62477-1 D2 table |
| Bus (830 V) ↔ control (primary-referenced) | functional | 830 V | spacing per functional table; HV dividers = 8× series 1206 (per-resistor ≤ 104 V working, 200 V rated) |
| Board-to-board studs | same domain (bus) | 830 V | stud-stud spacing ≥ 14 mm |
| D1 PFC choke winding ↔ PE-bonded web / plate / M6 bolt (gap pad, insulating clamp cap, bore sleeve) | basic (in series with AC line/bus ↔ PE) | D1 Û_rp ≤ 540 V recurring peak (switch end vs neutral, 50 kHz ripple) | 4 kV impulse type test on the bonded assembly · 100 % part hipot 2.5 kV DC 1 min winding ↔ bond-face + bore electrodes · no PD test (Û_rp ≤ 700 V) |
| D2 external Lr and D3 cell primary winding ↔ gap-padded ferrite core (core treated as PE) | basic (bus ↔ PE) | D2/D3 Û_rp 1160 / 1180 / 1200 / 1200 V at 83–203 kHz (30 / 40 / 50 / 50a; the full-bridge tank node is bus/2 + the Cr peak + the Vienna midpoint peak — the numbers mirror `stress-audit [INS]`) | 100 % winding ↔ bonded-face foil 2.5 kV DC · PD sample test 5/lot: PD extinction ≥ 1.8 / 1.8 / 1.8 / 1.8 kV, ≤ 10 pC |
| D3 cell secondary winding ↔ PE-bonded web / plate (gap pad) | basic (output ↔ PE) | ≤ 1000 V DC (top of the HIGH-mode stack), ripple < 10 V | 100 % part hipot 1.5 kV DC (D3 secondary) · module output ↔ PE 1.5 kV · DC stress: no recurring-peak PD row |

## 3. Creepage and clearance design values (PD2, mat IIIa — from 62477-1-class tables, VERIFY at DQ)

| V working | Clearance | Creepage used |
|---|---|---|
| 300 Vrms AC (line-line/PE, basic) | 3.0 mm | 4.0 mm |
| 830 VDC bus (functional) | 4.0 mm | 5.5 mm (slot under TO-247 rows where < 5.5) |
| 1000 VDC output (basic to PE) | 4.5 mm | 6.3 mm |
| Reinforced pri↔sec (board area under transformer/iso parts) | 8.0 mm | 12.6 mm + routed slots under iso ICs |
| D1 winding ↔ bolt, washer, web edge (switch end rides the bus node) | 4.0 mm | 5.5 mm — the clamp cap and sleeve set it, not the layout |
| D2 / D3 winding ↔ core over the former flanges (B66372B2000 and the 3-set cell former) | 4.0 mm | 8.0 mm, or VPI-cemented joints qualified as solid insulation by the PD sample test — VERIFY at DQ (> 30 kHz: IEC 60664-4) |

Layout rules bank (for the later PCB phase): slots under every iso component; guard the S/P relay
area (banks float — both banks treated at 1000 V class to PE); Y-caps only across defined barriers
(3 line-PE + 2 output-PE, **Y1 440 VAC class**); no SELV track inside HV zones; the CAN connector
domain (CGND) floats — 4 mm to everything, with the 1 MΩ ∥ 4.7 nF static bleed to DGND.

## 4. Design-for-compliance checklist (excerpt, full tracking in the [verification matrix](verification-matrix.md))

- [x] Insulation coordination table (this doc) — VERIFY table values against purchased standard editions
- [x] Protective separation of external CAN (iso 5 kV part + floating CGND + TVS)
- [x] Touch-discharge: **bus** < 60 V in **2.0 / 2.4 / 3.2 s** at 30 / 40 / 50 kW (640 Ω active, F.21 per-SKU supervision); **banks** < 60 V in **0.37 / 0.49 / 0.58 s** via the commanded bleeders (F.21b) — the film-only banks hold 2–4 J at 500 V; the passive balance chain remains the backup, and tool-access marking per 62477 applies for the passive-only failure case ([protection thresholds §4](protection-thresholds.md#4-discharge-timeline))
- [x] Single-fault: aux collapse → gates held low (T-09); relay weld detected (F.18); fan fail derate
- [x] Leakage current budget through the Y network: CY1-3 3 × 10 nF (raised from 4.7 nF for the LLC bridge's in-band common-mode fundamental) + CY4-6 3 × 4.7 nF at 274 V line-to-neutral (475 VAC) and 50 Hz → **≈ 3.8 mA** (3.3 mA at 415 VAC). Above the 3.5 mA pluggable line: the module is permanently connected equipment, so the high-leakage PE provisions of the 62477-1 class apply (reinforced PE conductor, the warning marking, no residual-current dependence at the module level); CALCULATED, T-14 measures the touch current with the final EMI values
- [ ] 61851-23 system items delegated to the charger integrator documented in the manual (IMD, output contactors, gun lock)
- [ ] EMC immunity plan (surge 61000-4-5 on the MOV/fuse network)
- [ ] Bonded magnetics: gap-pad dielectric type test at compressed thickness · D2/D3 PD sample test · per-core common-mode capacitance counted in the LISN budget
- [ ] D3 cells: 100 % pri ↔ sec 4.25 kV DC per cell (two per module) · PD type test per cell former (2-set and 3-set)

## 5. Bonded magnetics

A magnetic that is gap-padded or clamped to PE-bonded metal is part of the **basic** barrier to PE. The module EOL hipot
(2.5 kV DC line ↔ PE) stresses those paths, so each carries specified solid insulation and, where the recurring peak exceeds
700 V, a partial-discharge sample test.

- **Recurring peaks are computed, not assumed** — `stress-audit.mjs` [INS] reads `vienna-switched.csv` (D1 switch end vs grid
  neutral, recurring cases) and every `llc-stress.csv` corner (D2 / D3: bus/2 + resonant-capacitor peak + the Vienna
  midpoint-to-neutral peak, ideal switches, CM filter not credited), and fails if the rows above stop matching. The
  full-bridge tank node computes **1160 / 1180 / 1200 / 1200 V** at 30 / 40 / 50 / 50a kW, so the PD sample extinction is
  **≥ 1.8 kV** on every SKU (1.5 × Û_rp, IEC 60664-1 basic).
- **D1 build-up** (the pad touches the winding, not the core): fiberglass-reinforced silicone gap pad 1.0 mm, ≥ 3 W/mK, ≥ 5 kVAC
  (ASTM D149), qualified at its 0.8 mm compressed thickness for 2.5 kV DC 1 min and 4 kV impulse, RTI ≥ 150 °C, UL 94 V-0; a
  GF-PPS clamp cap (≥ 4.0 mm clearance / 5.5 mm creepage winding ↔ bolt head and washer) and a bore sleeve (≥ 1.0 mm wall) on the
  M6 bolt. The 0.13 mm wrap and enamel stay functional. The D1 winding stays under 700 V recurring, so no PD test.
- **D2 / D3**: the ferrite core is conductive and touches the pad, so the winding ↔ core insulation (former, tapes, VPI) is the basic
  barrier; the pads are specified for heat and low dissipation factor, not credited as insulation.
- **D3 reinforced barrier**: TIW primary plus ≥ 3 barrier-tape layers each side of the shields, in two cells per module; the 3-set
  former used by the 40 and 50 kW cells is new tooling, so its flange creepage is a first-article check.
- **Open** (not this page's to close): the pad's common-mode capacitance on the D2 / D3 tank node (~50–70 pF per core) in the LISN
  budget.

## 6. Isolated components and the SELV domain

- **No resistive path crosses the reinforced barrier.** Bank and output voltages are sensed inside their own domains by isolated
  amplifiers; the primary ↔ secondary barrier is purely magnetic, optical or iso-amp.
- **The D4 aux transformer barrier is safety-load-bearing** for the SELV control domain (its primary sits at bus potential):
  reinforced, 100 % hipot in production, never sampled.
- **Isolated amplifiers and their 5 V bias modules are reinforced-rated** for their domain's working voltage (1000 V output domain /
  830 V bus / AC mains star) — the BOM specifies reinforced-class modules at every Bias5 / PSCAN / PSSH position; the same
  certificate audit applies to the gate-bias and discharge-driver modules, whose barriers parallel the NSI6611's reinforced one.
- **PV bleeder couplers (VOM1271-class, UPVA/UPVB): the working voltage is the floating-bus offset, not the stack.**
  Capacitors set no steady-state DC division — they shape transients and common-mode AC only; the DC offset settles on
  the **leakage** divider (vehicle, cabinet, measurement chains), and an asymmetric but legal leakage set (say 1 MΩ high
  side, 10 MΩ low side) parks one pole near the full output voltage with no fault present. RFQ acceptance therefore reads:
  **V_IORM ≥ the maximum continuous pole-to-PE offset the installation's earthing/IMD envelope guarantees — absent such a
  documented bound, the full 1000 V DC — plus the transient/withstand class for the first-fault dwell.** A 707 V-pk V_IORM
  part is acceptable only WITH a documented system bound below it; do not grade these couplers against isolation TEST
  voltage, and never add low-value earthing resistors just to force a centre (they change the floating system and the IMD).
- **Control domain to PE**: 1 MΩ ∥ 4.7 nF Y1 soft bond — no hard earth loop, leakage < 1 mA budget.

> [!TIP]
> **How this page is checked** — `stress-audit`'s INS rows in `run-all`, plus the hipot and leakage plan in the [EVT plan](evt-plan.md); the barrier map is walked by `module-interconnect-audit`.

---

<div align="center">
<sub><a href="thermal-report.md">← Thermal Report</a> &nbsp;·&nbsp; <a href="README.md">🧭 Documentation hub</a> &nbsp;·&nbsp; <a href="busbar-drawings.md">Busbar Drawings & Joint Spec →</a></sub>

<sub>Vectivolt DC-Modules · documentation rev E85 · every number reproduces with <code>sh calculations/run-all.sh</code></sub>
</div>
