vectivolt/DC-Modules/docs/interconnect.md

# 🔌 Two-Board Sandwich & Interconnect

<sub>Stud pillars, the 40-way harness, grounding, discharge control and the HMI contract</sub>

<p>
  
  
  
  
</p>

> [!NOTE]
> **Purpose** — the physical module contract: how the two boards stack, how power and control cross between
> them, how the domains are grounded, how discharge is commanded, and how the HMI behaves.
>
> **Gate coupling** — `module-interconnect-audit` walks every boundary of this contract in the built netlists on
> every battery run, and is negative-tested: swapping two boards fails it.

## At a glance

| Boundary | Contract | Verified by |
|---|---|---|
| **Power** | 3 × M8 stud pillars — DCP · DCN · PE — 12 N·m, < 50 µΩ per joint, ≥ 14 mm stud-to-stud creepage | EOL milliohm check · interconnect audit |
| **Control** | 40-way straight-through harness (Micro-Fit 3.0 class, 5 A per contact) | every way, pin for pin, on all four SKUs |
| **Brain** | one control card in the DC-DC board's 88-way slot | every card way wired and landing on real electronics |
| **Grounding** | AGND–DGND single-point tie on the card; DGND → PE 1 MΩ ∥ 4.7 nF on the AC-DC board | structural netlist walk |
| **Identity** | RATING strap encodes the SKU (0 Ω · 1 k · 10 k · 15 k bands) | strap vs SKU per build |

```mermaid
flowchart TB
  subgraph DCDC["DC-DC BOARD (upper) — faces down"]
    direction LR
    SLOT["88-way card slot JB"] --- CARD["CONTROL CARD<br/>the module's one brain"]
    TANKS["tanks · transformers · banks<br/>S/P matrix · output studs"]
  end
  subgraph ACDC["AC-DC BOARD (lower) — faces up"]
    direction LR
    JICA["40-way harness JICA"] --- VIEN["EMI · precharge · Vienna<br/>split link · aux flyback"]
  end
  DCDC =="DCP · DCN · PE<br/>M8 stud pillars · 12 N·m · < 50 µΩ"==> ACDC
  CARD -."JICB ↔ JICA harness<br/>3× PWM · 12 senses · AVMID + Kelvin<br/>EN / GATE_EN_A / FLT · V15 / V24 · 5 returns · SHLD".-> JICA
  HS1["outer heatsink / coldplate"] --- DCDC
  ACDC --- HS2["outer heatsink / coldplate"]
  style CARD stroke:#2ea44f,stroke-width:2.5px
```

Each module is an **AC-DC board (lower)** and a **DC-DC board (upper)** with their component faces toward each other
and their heatsink surfaces outward. Power semiconductors clamp to the outer extrusions or, on the 50 kW liquid SKU,
the coldplates; the magnetics stand in the volume between the boards.

## 1. What each board carries

| | AC-DC (lower) | DC-DC (upper) |
|---|---|---|
| **Power** | AC studs, per-SKU gG fuses, MOV Δ + GDT, two CM chokes with star-X2 EMI stages, precharge (2 × 33 Ω + 2-pole bypass), Vienna phases, split DC link + balance, bus discharge (640 Ω + QDISF) | film commutation caps, the LLC full bridge (paralleled dies on the 40 / 50 kW positions), tank + two transformer cells, dual JBS banks, film banks + bleeders, S/P matrix (KSER · KPARA · KPARB) with two-stage 74HC02 exclusion, output blocking diode DOUT, output filter / shunt / studs |
| **Control side** | line CTs, AC and bus isolated senses, NTC × 2, fans (3 / 3 / 0 / 4 per SKU), aux flyback (bus-fed DCP → MID), local 3.3 V buck, coil driver (KPRE, QDIS), 40-way harness header **JICA** | **88-way card slot (JB)**, resonant CT, bank / output isolated senses, output shunt amplifier, NTC × 2, coil driver + exclusion gates, PV bleeder drive (QPVD), isolated CAN (NSI1042-DSWR), local 3.3 V buck, HMI (2 buttons + 2-digit 7-segment), harness header **JICB** |

## 2. The 40-way harness (JICA ↔ JICB)

With one brain in the DC-DC slot, the harness carries the whole PFC bundle.

<table>
<tr><td valign="top" width="55%">

| Ways | Group | Signals |
|---|---|---|
| 1–4 | supply | V15 × 2 · V24 × 2 |
| 5–9 | returns | DGND × 5 |
| 10–12 | PWM (logic, 50 kHz) | PWM_A0 · PWM_B0 · PWM_C0 |
| 13–15 | line currents | I_A0 · I_B0 · I_C0 |
| 16–22 | voltage senses | SNS_VAC1–3 · SNS_VBUSP · SNS_VMID · SNS_V24 · SNS_V15 |
| 23–24 | temperatures | T_PFC · T_INLET |
| 25–26 | analog reference | **AVMID with its Kelvin AGND adjacent** |
| 27–30 · 38–39 | fans | FAN_PWM1–2 · FAN_TACH1–4 |
| 31–33 | precharge / discharge | CTL_KPRE · CTL_QDIS · RELAY_FB_KPRE |
| 34–37 | enables and fault | EN_PFC · GATE_EN_A · FLT (wired-OR) · DRV_RDY |
| 40 | shield | SHLD — PE-bonded at the AC-DC end only |

</td><td valign="top" width="45%">

```mermaid
pie showData title 40 harness ways by function
  "voltage senses" : 7
  "fans" : 6
  "returns" : 5
  "supply" : 4
  "enables and fault" : 4
  "PWM" : 3
  "line currents" : 3
  "precharge / discharge" : 3
  "analog reference" : 2
  "temperatures" : 2
  "shield" : 1
```

</td></tr>
</table>

- **One harness part number for every SKU.** The 50 kW liquid module uses the same harness with its fan ways
  unloaded. Tach ways are held defined-LOW by board-side 10 k terminators (RFDT1–3), so an accidental read reports
  "stopped", the fail-safe direction. PWM ways are driven idle by the MCU.
- **Single source.** `HARNESS40` in `packages/common-components/umod-map.gen.ts` is generated by
  `calculations/control/umod-pinmap.mts`, and the interconnect audit verifies every way end to end.
- **Default-OFF is board-side.** Pull-downs sit on both GATE_EN chains, the EN lines, the relay drives and the three
  PWM lines at their receiving end.

> [!WARNING]
> **The way numbers are the contract; the card-side pins are chosen for second-source compatibility.** Phase A's
> current sense and the LLC temperature channel take each other's card footprints so that I_A0 lands on a pin that
> carries a comparator input on the STM32G474VET7 as well as the GD32G553VET7 — otherwise phase A's hardware
> over-current trip would quietly become software-only on a second-source card. `umod-map.gen.ts` is the
> code-verified map, `port-pin-audit` locks the GD32 port to it, and bring-up Stage 0 checks the harness pin for pin
> against it before anything is powered → [validation report](validation-report.md).

> [!IMPORTANT]
> **Loss of the harness is a safe state.** With GATE_EN_A low or V15 / V24 missing, the AC-DC gates are off in
> hardware. The card's watchdog covers the brain itself (WDO ≡ NRST).

## 3. Grounding

```mermaid
flowchart LR
  AGND["AGND<br/>analog reference"] -- "single 0 Ω tie<br/>RAGTC on the card" --- DGND["DGND<br/>control domain (SELV)"]
  DGND -- "1 MΩ ∥ 4.7 nF<br/>AC-DC board" --- PE["PE"]
  CGND["CGND<br/>isolated CAN domain"] -. "static bleed" .- PE
  HV["HV measurements"] -- "isolated amplifiers only" --> DGND
  style DGND stroke:#2ea44f,stroke-width:2px
```

The AGND–DGND tie exists **only on the card** — a second tie on a power board would be the ground loop it
prevents. The control domain is SELV, and every high-voltage measurement crosses on an isolated amplifier, so the
HMI, SWD, fans and CAN are touch-safe by architecture. CAN is additionally isolated (CGND domain with static bleed)
for long bus runs between modules in a charger.

## 4. Discharge control

> [!CAUTION]
> **High voltage.** The DC link and output banks hold lethal energy. Service label: **isolate, wait 15 min, AND
> verify < 60 V** — never "or". One balance network per module puts the 50 kW at 9.9 min nominal and 11.9 min at the
> +20 % capacitance corner, and the label follows the slowest SKU.

`CTL_QDIS` drives the opto LED active-high (330 Ω). The output stage rides a DCN-referenced isolated module, and the
QDISF gate has a 10 k pull-down to DCN, so a dead, reset or unprogrammed MCU leaves discharge **off**. Bank bleeders
are PV-driven (VOM1271 via QPVD at the guaranteed 10 mA point). The discharge timeline has **two phases**: active
down to the 321 V aux floor, then passive. F.21's real coverage is the AC-present case — see
[protection thresholds §4](protection-thresholds.md#4-discharge-timeline).

**Module ↔ charger boundary at the output studs.** Two functions are the charger/dispenser's, per IEC 61851-23, and
the module must not duplicate them: (1) **output-bus discharge** — `COF1` + `COF2` (9.4 µF) sit downstream of
`DOUT`, out of reach of the bank bleeders, so they carry their own 450 kΩ passive bleeder (three 150 kΩ HV elements
in series, τ ≈ 4.2 s, 1000 → 60 V in ≈ 12 s), while the shared DC bus the modules feed is discharged by the
dispenser; (2) **output polarity screening** — `DOUT` blocks positive back-feed, but a **reversed** battery or bus
applied while the S/P relays are closed drives a two-diode short through a bank bridge and the matrix. The dispenser
verifies polarity before closing its contactors; the module closes its matrix only from STANDBY on command, and a
connected pack measured below 0 V inhibits the start (F.33). With the matrix open there is no through-path between
the output studs and the banks.

## 5. HMI behaviour

```mermaid
stateDiagram-v2
  [*] --> Pages
  state Pages {
    [*] --> Address
    Address --> Group : SET short press
    Group --> FaultRing : SET short press
    FaultRing --> Firmware : SET short press
    Firmware --> Address : SET short press
  }
  Pages --> Edit : SET long press (value blinks)
  Edit --> Edit : ▲ / ▼ change value
  Edit --> Pages : ENTER save (EEPROM, CRC)
  Pages --> Fault : a fault latches
  Fault --> Pages : fault cleared
  Pages --> Off : 60 s idle
  Off --> Pages : any button
```

The 2-digit display with SET/▲ (SW1) and ▼/ENTER (SW2) pages through the module CAN address (00–63), the group id,
the fault-code ring and the firmware version. During a fault the display shows its `F.xx` code. The card drives it
through a 74HC595 (segments, decoupled per driver), two NPN digit multiplexers and two GPIO buttons.

## 6. The module interconnect audit (permanent gate)

`calculations/module-interconnect-audit.mts` (in run-all) walks the **built** netlists of AC-DC + DC-DC + card per
SKU across every physical boundary:

| Boundary | What is proven |
|---|---|
| DCP / DCN / PE studs | both boards land the same nets |
| 40 harness ways | pin for pin, including crossovers |
| 88 card ways | wired on the board **and** landing on real electronics on the card |
| RATING strap | encodes the SKU in its own band |

> [!TIP]
> **How this page is checked** — `npx tsx calculations/module-interconnect-audit.mts` in `run-all` — it walks the built netlists and fails if a stud, a harness way or a slot pin does not land on real electronics on both sides.

---

<div align="center">
<sub><a href="validation-report.md">← Validation Report</a> &nbsp;·&nbsp; <a href="README.md">🧭 Documentation hub</a> &nbsp;·&nbsp; <a href="control-card-scope.md">Control-Card Scope →</a></sub>

<sub>Vectivolt DC-Modules · documentation rev E85 · every number reproduces with <code>sh calculations/run-all.sh</code></sub>
</div>
