vectivolt/DC-Modules/docs/magnetics-30kw.md

# 🧲 30 kW Module Magnetics

<sub>Every magnetic on the 30 kW module — drawing, gate proof, build, tests, prototype route and cost</sub>

<p>
  
  
  
  
</p>

> [!NOTE]
> **Purpose** — every magnetic on the **30 kW module**: what it does, the drawing to quote, the proof the gates computed at
> the simulated corners, how a winder builds and accepts it, how to prototype it, and what it costs. **Generated by
> `calculations/magnetics/mag-docs.mjs` from the last battery run's gate evidence — do not hand-edit.** Method, materials,
> insulation system and the common parts (D4, test methods, failure modes): [magnetics hub](magnetics.md).

## At a glance

| Part | Function | Qty | Construction | ₹ / unit @10k | ₹ @10k | Status |
|---|---|---:|---|---:|---:|---|
| **D1** | PFC boost choke · `IND-PFC-165u` | 3 | 3 × 0077908A7 Kool Mµ 26µ, N = 39 ± 1, 9 × 1.6 mm bundle | 828 | 2,484 | CUSTOM |
| **D2** | external resonant inductor · `IND-LR-E70-30` | 1 | 2 × E70/33/32 PC95-class, N 5, litz 8000×0.05 mm, 5.00 µH ± 3 % | 772 | 772 | CUSTOM |
| **D3** | full-bridge transformer cell · `XFMR-LLC-CELL-2E70-30` | 2 | 2 × E70/33/32 per cell, 6:6∥6, primaries of the two cells in series (n = 2) | 935 | 1,870 | CUSTOM |
| **D7** | 3-phase CM choke · `CMC-3PH-2mH-SKU` | 2 | nanocrystalline T 80/50/25 (A_Fe ≥ 281 mm²), 3 × 8 T, 20 mm² — Schaffner RT8131-63-2M8 catalog primary | 1,062 | 2,123 | CUSTOM |
| **D4** | 110 W aux flyback · `XFMR-AUX-FLY-E` | 1 | ETD44 PC95, Np 38 / 6 / 4 / 4, reinforced barrier (common to every SKU) | 184 | 184 | CUSTOM |
| **CT** | line current transformer · `ACX-1100` | 3 | Talema ACX-1100 (2500:1, 100 A), burden 22 Ω | 52 | 156 | DIRECT |
| **CT** | resonant current transformer · `CT-RES-1:100-100A` | 1 | 1:100, 100 A rms class (tank class 78 A = 78 %), burden 0.47 Ω | 132 | 132 | CLASS |
| **—** | 3.3 V buck inductor (catalog) · `CYA0630-10UH` | 2 | 10 µH 3 A shielded | 5 | 10 | ORDERABLE |
| **—** | CAN common-mode choke (catalog) · `ACT45B-510-2P-TL003` | 1 | 51 µH, 2-line | 6 | 6 | ORDERABLE |
| **Total** | | | | | **7,738** | |

```mermaid
flowchart LR
  AC(["3-φ AC"]) --> D7["D7 · CM chokes × 2<br/>T 80/50/25"] --> D1["D1 · PFC chokes × 3<br/>3 × T79 · N 39"]
  D1 --> BUS[("split DC bus<br/>650–830 V")]
  BUS --> FB["full-bridge LLC"] --> TANK["Cr 7 × 33 nF + D2 5.00 µH"] --> D3["D3 cells × 2<br/>6:6∥6 · primaries in series"] --> BK["banks A + B"]
  BUS --> D4["D4 · aux flyback"]
  LCT["line CTs × 3 · 22 Ω"] -.- D1
  RCT["resonant CT · 0.47 Ω"] -.- TANK
  style D1 stroke:#d19a00,stroke-width:2px
  style D3 stroke:#1a9fb3,stroke-width:2px
  style TANK stroke:#b8732e,stroke-width:2px
```

## Critical review at a glance

Every magnetic on this module against every failure mechanism, one governing number each — read from the proof rows below and the
PyOpenMagnetics cross-check; the drawing lines each number is held to sit in the specification tables.

| Mechanism | D1 PFC choke | D2 resonant L | D3 transformer cells | D4 aux flyback | D7 CM choke | CTs |
|---|---|---|---|---|---|---|
| **Saturation · flux margin** | L 76.9 µH @ 78 A ≥ 75 µH | B̂ 21 % of hot Bsat · 158 mT at the F.11 kill ≤ 217 | B̂ 39 % of hot Bsat · family worst 44 % of Bsat(130 °C) | 257 mT = 71.1 % of Bsat(130 °C) at the current limit ≤ 75 % | DM 0.44 T ≤ 0.6 · CM 27 mT | no saturation below 150 A pk (1.25 × F.01) |
| **Core loss · thermal runaway** | Fe 4.7 W at the 50 kHz ripple | Fe 28.1 W · runaway margin 160 K | Fe 31.8 W · runaway margin 116 K | runaway margin 116 K · cold start self-warms | nanocrystalline at line frequency — negligible | — |
| **Copper · skin · proximity** | Cu 22.4 + 14.5 W · ripple Fr 48.9 | Fr 1.96 · Cu 15.1 W · MKF ×0.61 | foil Fr 1.23 · Cu 45.8 W · MKF ×1.29 | primary Fr 1.05 (sandwich) | 9.9 W per choke | — |
| **Winding temperature** | 87 °C @ 55 °C ≤ 120 | 94 °C @ 55 °C ≤ 125 · +25 % Rth 104 ≤ 155 | 106 °C @ 55 °C ≤ 125 · +25 % Rth 114 ≤ 155 | ΔT ≤ 45 K at 110 W (type test) | ΔT 20 K ≤ 45 | ΔT ≤ 30 K at class current |
| **Current rating · density** | 3.05 A/mm² ≤ 5.5 | 70.5 A rms · 112.6 A pk · 5 A/mm² | P 70.5 A rms (5.9 A/mm²) · each half 34.6 A rms (12.4 A/mm²) — loss-governed | ≤ 4.67 A pk primary · V24 1.6 A · V15 1 A | 2.79 A/mm² ≤ 5.6 | 100 A line · 100 A rms class resonant |
| **Insulation · HV stress** | basic to PE · 2.5 kV DC hipot · impulse 4 kV | basic to PE · PD extinction ≥ 2.0 kV | **reinforced** · 4.25 kV DC 100 % · PD ≥ 2.0 kV | **reinforced** · 4.25 kV DC 100 % · 8.0 / 12.6 mm | 2.5 kV AC winding ↔ winding | 4 kV catalogue hipot |
| **Leakage · coupling** | — | carries the tank Lr (± 3 %) | cell 0.252 µH · Lr stack ± 4.5 % ≤ 5 % | 1-D 1.7 µH · accept ≤ 4 µH | 6–12 µH, measured at first article | — |
| **DC bias** | engine 45.6 % ≤ material data 56.5 % at the floor | series Cr blocks DC (flux-walk proof) | series Cr blocks DC (flux-walk proof) | DCM — resets every cycle | 3-wire Σi = 0; DM rides as leakage flux | — |
| **Current imbalance · circulating current** | one choke per phase | — | 8.3 % between cells in LOW mode; HIGH mode balanced | — | 3-wire, Σi = 0 | — |
| **Resonance · switching transients** | filter–loop modulus margin ≥ 0.59 | ZVS on all four switches at every corner except 3 phase-shift corners, where the weak leg turns on with 84–291 V of residual — the thermal grid and the firmware junction observer carry that loss | secondary ring 611 V = 51 % of the 1200 V rectifiers | switch 1344 V = 79 % with the clamp · SRF ≥ 650 kHz | — | — |
| **Faults · abnormal operation** | bypass closure 200 A pk (F.01 blanked) · OC race Δi 46 A ≤ 64 | F.11 kill 210.3 A pk — flux in row 1 | one fan out 88 °C · bond lost 110 °C → EOL soak | hard short V24 5.31 A · V15 5.07 A before the latch | surge clamped before the chokes | F.01 race 165.3 A ≤ 184.1 A ceiling |
| **Second opinion — PyOpenMagnetics** | Rdc -3.2 % | Rdc +1.3 % · gap guide 9.5 mm | Rdc -2.2 % · 115 °C at MKF copper | Rdc +6.2 % | L_cm +0.8 % | catalogue parts |

## How to read the proof tables

Every proof row below is copied from a gate's own output on the last battery run; a ✅ row passed its line, ℹ️ is information the
gate reports, and a failing gate stops the battery before this page is written.

| Gate | What it computes | The line it holds |
|---|---|---|
| `magnetics-envelope` | D2 and D3 flux, iGSE core loss and Dowell/Sullivan copper at all 32 power-solved corners, through a two-node (core, winding) thermal network of the real geometry | hot-spot ≤ 125 °C at 55 °C inlet · ≤ 135 °C at 75 °C inlet derated · ≤ 155 °C with every Rth +25 % · runaway margin ≥ 25 K · B̂ ≤ 50 % of hot Bsat |
| `conductor-audit` | AC resistance of every winding at the simulated switching frequency, and the production Rdc rows that catch a short strand count | Rac/Rdc inside the drawing's row |
| `stress-audit` | D1 biased inductance, current density, bonded thermal, clamp preload and bond loss; D7 DM-leakage flux and hot copper; CT classes | the acceptance line printed in each row |
| `temp-critique` | saturation at the 130 °C cutout, cold equilibria and the fault chain on measured 3C95 surfaces | B̂ ≤ 50 % Bsat(130 °C) · fault flux ≤ 60 % |
| `current-coordination` | D2 flux at the F.11 kill peak and CT observability through each trip's race | ≤ 217 mT · the kill lands inside the ADC rail |
| `mag-sync` | the identity of every part against every carrier, and the computed mass | tokens present · mass within ± 20 % |
| `mkf-crosscheck` | the D2 / D3 builds re-made in PyOpenMagnetics (OpenMagnetics MKF): winding Rdc from its own turn layout, the drawn gap under five fringing models, 2-D copper loss, and the thermal network at that copper — run by hand in a Python venv, so its `MKF-GAP` row can quote a D2 target (5.16 / 4.07 / 3.28 µH) the drawing above has moved past. **Build to the build-and-hold points below**, which `mag-docs` reads from `magnetics-envelope`; this row is here for its fringing CONCLUSION (+13…+14 %, so grind toward AL), which a 3 % target move does not change | Rdc ± 5 % · class lines (+25 % Rth ≤ 155 °C, runaway ≥ 25 K) at MKF's copper; ℹ️ where only a design line moves |

## D1 — PFC boost choke · qty 3 · `IND-PFC-165u`

Vienna phase inductor at 50 kHz: DC bias from the line current plus switching ripple, a swing design on sendust that softens
without collapsing. The winding sits at line / switch-node potential and its bonded face is part of the basic barrier to PE.

| Row | Specification — PMP-MAG-D1-30 rev C |
|---|---|
| Core | **3 × Magnetics 0077908A7** Kool Mµ 26µ toroid (OD 78.94 / ID 48.21 / HT 17.02 mm max; AL 37 nH/T² ± 8 % per core); faces epoxy-bonded, distributed gap — no grinding |
| Winding | **N = 39 nominal, winder trims ± 1 turn per core lot** · **9 × 1.6 mm** grade-2 dual-coat enamelled round (Class 200), taped into one bundle every 150 mm, laid flat · bore layers 21 / 15 / 3 · spread ≥ 300° |
| Electrical acceptance (100 %) | L₀ @ 0.1 V / 100 kHz **150–185 µH (165 nom)** · **L @ 78 A pk ≥ 75 µH** (pulse method) · Rdc **≤ 6.9 mΩ @ 25 °C (build 6.08) and within ±5 % of the lot median** — one open strand fails the lot window |
| Operating point | 54.7 A fundamental + 6.3 A rms 50 kHz ripple at 330 VAC, bus 830 V, AL − 8 % — loss and hot-spot in the proof table |
| Insulation | basic insulation to PE: bonded face through the module gap pad, bore through sleeve + clamp cap; recurring peak ≤ 540 V (no PD test) · winding ↔ core functional · Class F (155 °C) UL 1446 system |
| Thermal | one end face gap-pad bonded to the extrusion web · hot-spot limit 120 °C at 55 °C inlet · bonded type test: 74 A DC → hot-spot ≤ 19 K above the plate |
| Over-temperature cutout | not required — one lost pad computes 131 °C, inside Class F (stress-audit) |
| Mechanical · mounting | finished ⌀ 92 × H 88 mm, mass **1.9 kg** (computed) · M6 A4-70 through the bore at 4.5 N·m on a Belleville via a GF-PPS insulating cap · 2-point glass banding |
| Terminations | 2 × tinned flying leads, 60 mm, strain-relief loop ≥ 10 mm before the board |
| Production test | 100 %: L₀ · L @ Ipk pulse · Rdc (row + lot window) · hipot **2.5 kV DC 1 min** winding ↔ bond-face plate + bore mandrel · first article: 4 kV 1.2/50 impulse × 5 each polarity, Rac @ 50 kHz recorded |
| Marking · qty | label p/n, rev, lot, date, N · qty 3 per module · operating ambient −40 … +55 °C full power, derated to +75 °C |

<details><summary><b>Proof at the simulated corners</b></summary>

| Gate | Check | Result | |
|---|---|---|:---:|
| `stress-audit` | 30kw biased-L floor [catalog AL] | L0 169 µH → 76.9 µH @78 A ≥ 75 (D1 rev B: N=39±1 lot-trim, 18 mm² (drawing of record)) | ✅ |
| `stress-audit` | 30kw swing floor | L@Ibias/L0 = 0.46 (30 kW swing-choke basis exempt: drawing governs via its own biased-L line) | ✅ |
| `stress-audit` | 30kw current density | 3.05 A/mm² ≤ 5.5 | ✅ |
| `stress-audit` | 30kw 3×T79 N 39 9×1.6 mm · web1 | hot-spot at the 330 VAC continuous corner [computed] — Cu 22.4 W @50 Hz + 14.5 W ripple (6.3 A rms, Fr 48.9 = Ferreira 71.3 × 2-D 0.686) + Fe 4.7 W → hot-spot 87 °C @55 °C (winding 85 °C, air 65 °C, web/plate 80 °C, 28 W into it) · 97 °C @75 °C derated · +25 % Rth 89 °C · limits 120/130/145 °C [d1-fd N39·nw9·d1.6·x3·L21/15/3] | ✅ |
| `stress-audit` | 30kw one lost bond survivable or cut out | pad lost → convection only: 131 °C vs Class F 155 °C — survives | ✅ |
| `stress-audit` | D1-COOLING · 30kw | air-cooled as registered 131 °C (+25 % 148 °C; at half the assumed 2 m/s 152 °C — the tunnel is not settled, D1-F2) · Type-2 litz 576×0.2 mm air-cooled 112 °C (ripple Cu 1.7 W, +₹857 of wire per choke) · web gap-pad bond 87 °C (the pad of the ₹105 mount kit — its insulating cap and sleeve are needed for D1-F3 either way) → bond | ℹ️ |
| `stress-audit` | 30kw clamp holds the stack at 2 g × Q 10 [computed] | 1.9 kg, CG 44 mm → overturning 16.5 N·m → preload needed 1.44 kN vs 3.75 kN at 4.5 N·m (K 0.2) · pad 0.58 MPa ≤ 0.7 · bolt 42 % of proof | ✅ |
| `stress-audit` | D1-BUILD · 30kw | MLT 161 mm (layer model 163) · bore layers 21/15/3 of ⌀6.2 mm bundles → finished ⌀92 × H 88 mm (layout open item — tunnel/keep-out rows) · bundle cut ≥ 7.1 m · bonded type test: 74 A DC (= 42.9 W) → hot-spot ≤ 19 K above the plate (calc 9.4 K + 10) | ℹ️ |
| `conductor-audit` | 30kw bundle 9× 1.6 mm, 39 T on 3×T79 | MLT 161 mm (Magnetics table, K 44 %) · 50 Hz 54.7 A → 23.4 W · 50 kHz ripple 6.3 A rms at Fr 47.5 (Ferreira 69.2 × 2-D 0.686; a flat untwisted bundle computes 7.7 W) → 14.8 W · Cu 38.2 W hot — a two-layer Dowell (m = 2) model reads 3.6 W ripple copper [d1-fd N39·nw9·d1.6·x3·L21/15/3] | ✅ |
| `conductor-audit` | 30kw production Rdc row @25 °C catches open strands | build 6.08 mΩ · row ≤6.9 mΩ (13 % above; worst good part 6.57; 2 strands open 7.82) · lot window ±5 % vs one open strand +12.5 % — a row set by round numbers instead of the build passes a part with a third of its strands open | ✅ |
| `temp-critique` | 30kw OC→ceiling time / 3 µs adder | L(120 A)=45.4 µH (AL−8%) · Δi(3 µs)=46 A ≤ ceiling−threshold 64 A · ceiling reached in 4 µs — CT stays observing until the HRTIMER kill lands (2–3 µs budget) | ✅ |
| `current-coordination` | 30kw precharge-bypass closure at 90 % of line peak · F.01 blanked, D1, link | 200 A pk through D1 and the rectifier (above F.01 120 A) · D1 falls to 24 µH from 155 µH at the peak — soft powder saturation for 1.4 ms, winding +0 K adiabatic · bus 605 → 726 V ≤ 860 V OVP · F.01 blanked 60 ms ≥ relay 25 + bounce 5 + pulse 1.4 ms, no PFC enable inside (fsm.c) | ✅ |
| `current-coordination` | 30kw rectifier diode surge at bypass closure | 20 A²s per diode vs 50 % of the RFQ line IFSM ≥ 250 A (10 ms half-sine → 313 A²s) | ✅ |
| `current-coordination` | 30kw bypass relay make and gG fuse at closure | make 200 A pk at ≤ 67 V across the contacts vs the RFQ make line 260 A pk (≥ 1.25×) · fuse 20 A²s ≤ 10 % of the gG pre-arc 1500 A²s — no melting, no ageing | ✅ |
| `mkf-crosscheck` | 30kw D1 Rdc @25 °C from MKF's toroid winding | 5.89 vs build 6.08 mΩ (-3.2 %) — 3 × T 79/48/17, N 39, 9 × 1.6 mm · acceptance ±5 % | ✅ |
| `mkf-crosscheck` | 30kw D1 Kool Mµ 26 DC-bias roll-off (MKF material data, 100 °C) vs the engines' fit | floor 78 A = 195 Oe: MKF 56.5 % vs engine 45.6 % · inrush 200 A = 500 Oe: MKF 19.0 % vs engine 15.2 % — the engines' L(i) sits at or below the material data, so every biased-L floor and the inrush peak are conservative | ✅ |

</details>

**Build and hold points.** (1) Stack the 3 cores on the arbor, epoxy-bond the faces, cure clamped, band with 2 turns of glass tape.
(2) One layer 0.13 mm polyester over the stack. (3) Cut the 9-wire bundle ≥ 7.1 m and tape it every 150 mm. (4) Wind N from the
lot-trim card (the incoming AL sets 39 ± 1), bore layers 21 / 15 / 3, spread ≥ 300°, exits 25–35 mm apart. (5) Twist, sleeve and tin the
leads. **H1** L₀ inside the window, Rdc, turns photo. (6) Varnish per the hub's impregnation rule. **H2** L @ Ipk pulse. **H3** hipot, label.

## D2 — external resonant inductor · qty 1 · `IND-LR-E70-30`

The one gapped inductor of the full-bridge tank (InfyPower practice): it carries Lr 5.60 µH minus the two D3 cells'
leakage and the 0.1 µH loop stray, at full AC swing and tank potential, 77–203 kHz (82 kHz is the lowest steady-state point; 77 kHz = 0.55·f_r is the firmware's transient floor and the part must take it). No bins — the ± 3 % gap tolerance plus the ± 30 %
cell-leakage band stays inside the ± 5 % Lr the tank decks were solved at.

| Row | Specification — PMP-MAG-D2-30 rev F |
|---|---|
| Inductance | **5.00 µH ± 3 %** @ 140 kHz, 0.1 V (100 %) |
| Current rating | **70.5 A rms** at the copper corner (203 kHz) · **112.6 A pk** at the worst simulated corner · 210.3 A pk for ≤ 1 µs at the F.11 kill — flux at that peak is a proof row |
| Core · former | **2 × E70/33/32** PC95 / N95 / 3C95-class MnZn on TDK **B66372A2000** — powder cores prohibited in this slot |
| Winding | **N = 5**, compacted litz **8000×0.05** mm (15.7 mm²), one layer across the 41 mm breadth over a ≥ 3 mm radial spacer |
| Gap | distributed centre-leg gap **Σ ≈ 9.5 mm in 10 segments**, every segment ≤ 1.0 mm, outer legs mated — ground to the AL that gives 5.00 µH at N 5; Σ is the fringing-corrected first-grind guide (MKF) |
| Rdc · Rac | Rdc **≤ 1.35 mΩ** @ 25 °C (100 %) · Rac **≤ 3.35 mΩ** @ 203 kHz, 100 °C (sample 5 / lot) |
| Insulation · hipot · PD | basic insulation to PE through former + spacer + VPI class H · 100 % winding → bonded-face foil 2.5 kV DC · PD 5 / lot, extinction **≥ 2.0 kV**, ≤ 10 pC |
| Thermal | both yoke faces gap-padded to the upper and lower extrusion webs, end turns potted to the web · hot-spot ≤ 125 °C at 55 °C inlet (type test, thermocouples beside a gap and on the winding) |
| Over-temperature cutout | one NC 130 ± 5 °C thermostat beside a gap, in the magnetics cutout loop |
| Mechanical · terminations | ≤ 70.5 × 65.9 × 59 mm · **1.3 kg** · 2 litz flying leads out of one end-turn face, tinned 12 mm |
| Marking · qty | label p/n, rev, lot, serial, measured L · qty 1 per module · operating ambient −40 … +55 °C full power |

<details><summary><b>Proof at the simulated corners</b></summary>

| Gate | Check | Result | |
|---|---|---|:---:|
| `magnetics-envelope` | 30kw D2 + D3 leakage stack inside the simulated Lr tolerance | D3 cell S1–P–S2 leakage 0.252 µH × 2 + 0.1 µH loop → D2 5 µH of Lr 5.6 µH · worst-case stack ±4.5 % (D2 ±3 % + leakage ±20 %) vs ±5 % simulated | ✅ |
| `magnetics-envelope` | 30kw 2×E70 N 5 · 5.15 µH max · web2 · R core→wall 0.77 · winding→core 0.75 K/W | core corner SER250-full-bus764 202.9 kHz B̂ 85 mT Fe 28.1 W · copper corner SER250-full-bus764 202.9 kHz Cu 15.1 W · hot-spot 94 °C @55 °C (SER250-full-bus764; core 94 °C / winding 93 °C) / 100 °C @75 °C derated (SER250-full-bus764) · +25 % Rth 104 °C · runaway margin 160 K · B̂ 21 % of hot Bsat | ✅ |
| `magnetics-envelope` | D2-BOND-LOST · 30kw | one face lost (web1) → 104 °C @55 / 111 °C @75 · +25 % 120 °C → survives | ℹ️ |
| `stress-audit` | 30kw external Lr Bpk | 83 mT at Lmax 5.15 µH × 78 A rms class vs 110 mT line (N=5 on 2× E70/33/32 — D2 rev F) | ✅ |
| `stress-audit` | 30kw external Lr litz J | 8000×0.05 mm litz (15.7 mm²): J 5 A/mm² ≤ 5.6 at the 78 A class | ✅ |
| `conductor-audit` | 30kw 2×E70 N 5, litz 8000×0.05 @203 kHz | MLT 216 mm · Rdc 1.21 mΩ @25 °C (row ≤1.35) · Sullivan Fr 1.96 → Rac 3.04 mΩ hot (row ≤3.35) → Cu 15.1 W at 70.5 A rms (SER250-full-bus764) — thermal proof: magnetics-envelope | ✅ |
| `current-coordination` | 30kw external Lr flux: operating + fault | Lmax 5.15 µH (2×E70 N 5): 85 mT at the worst simulated peak (≤110) · 158 mT at the F.11 kill peak ≤ 60 % Bsat(130 °C) 217 mT | ✅ |
| `magnetics-envelope` | 30kw D2 with one of 3 fans dead at 55 °C inlet (F.25 derate 50 %) | airflow ×0.67 · web 74 °C · air 63 °C → hot-spot 86 °C (SER250-full-bus764) ≤ 135 °C derated line · runaway margin 174 K ≥ 25 — core loss does not derate, copper does | ✅ |
| `mkf-crosscheck` | MKF-GAP · 30kw D2 L from the drawn gap Σ 8.34 mm in 9 × 0.93 mm | Zhang 5.84 µH (+13.2 %) · Muehlethaler 5.85 · Partridge 5.60 · Balakrishnan 5.65 · Stenglein 7.29 vs 5.16 µH ± 3 % → with fringing Σ ≈ 9.5 mm (10 × 0.95 mm) reaches the target — ground to AL either way; this is the first-grind guide | ℹ️ |
| `mkf-crosscheck` | 30kw D2 Rdc @25 °C from MKF's turn layout | 1.22 vs 1.21 mΩ (+1.3 %) — acceptance ±5 % | ✅ |
| `mkf-crosscheck` | MKF-CU · 30kw D2 copper at SER250-full-bus764 202.9 kHz, 100 °C | MKF 9.2 W (7.9 ohmic + 0.0 skin + 1.3 prox) vs Sullivan 15.1 W → ×0.61 — the gate's D2 copper is the conservative figure | ℹ️ |

</details>

**Build and hold points.** (1) Grind or space the centre-leg gap in segments of ≤ 1.0 mm toward the AL that gives 5.00 µH at N 5; glue,
cure clamped, re-measure (cure shifts AL about 1 %). (2) Wrap a ≥ 3 mm radial spacer over the former so the litz stays out of the gap
field. (3) Wind 5 turns of 8000×0.05 mm litz in one layer. (4) Tin the served ends at 400 ± 20 °C. **H1** L inside ± 3 %, Rdc.
(5) VPI class H with the yoke faces masked. **H2** L re-check, Rac sample. (6) Fit the cutout beside a gap. **H3** 2.5 kV DC winding →
bonded-face foil, label with the measured L.

## D3 — full-bridge transformer cell · qty 2 · `XFMR-LLC-CELL-2E70-30`

One of two identical cells whose primaries are wired in series (overall n = 2); each cell's secondary feeds one bank through S1 ∥ S2.
Flux follows bank voltage, not load, so a power derate does not relieve the core corner. **Safety-critical:** this part carries the
reinforced barrier between the DC bus and the output — its barrier steps and hipot are witnessed on every unit.

| Row | Specification — PMP-MAG-D3-30 rev D |
|---|---|
| Ratio · magnetizing | **6:6∥6 exactly** (P : S1 ∥ S2, S1 and S2 paralleled at the header) · Lm **28 µH ± 7 %** per cell @ 10 kHz, 0.1 V · **the two cells of a module ship as a MATCHED PAIR, L_m within ± 3 % of each other** (gapped together, labelled A / B) — their primaries are in series on one C_r, so they divide the applied volt-seconds by their magnetizing impedance: a ± 7 % pair reads 513 / 481 V on the two banks at 1000 V series and + 7 % flux on the higher-L_m cell |
| Core · former | **2 × E70/33/32** PC95 / N95 / 3C95-class · TDK B66372A2000 (2-set, lN 230.5 mm) |
| Gap | centre legs only, equal on every set, no position > 0.5 mm, ground to AL **0.778 µH/T² (Σ gap ≈ 2.3 mm with fringing)** on the assembled cell |
| Current rating | primary **70.5 A rms** / **112.6 A pk** · each secondary half **34.6 A rms** / 54.2 A pk at the worst simulated corner · 77–203 kHz (82 kHz lowest steady state · 77 kHz = the firmware's transient floor, 0.55·f_r) |
| Primary | **TIW-served litz 3850×0.063 mm (12 mm²)**, one layer |
| Secondary halves | Cu foil 0.10 × 28 mm, one per turn · MLT S1 / P / S2 189 / 211 / 232 mm |
| Leakage | per cell, both halves shorted, 140 kHz, after VPI: **0.252 µH ± 30 %** — measured and labelled |
| Rdc @ 25 °C (100 %) | P ≤ 2.1 · S1 half ≤ 8.0 · S2 half ≤ 9.8 mΩ |
| AC resistance (sample 5 / lot) | short-circuit R at 203 kHz with both halves shorted (the leakage fixture), referred to P, 25 °C — expected **8.33–10.39 mΩ** (1-D … MKF); the first article fixes the lot line at its median + 10 %. Not a per-winding open-circuit Rac/Rdc: that loses the interleaved field cancellation and rejects good parts |
| Insulation system | Class H — VPI class H · TIW grade Class F minimum · pri ↔ sec **reinforced**, one barrier system: TIW wall + ≥ 3 barrier-tape layers between each shield and its secondary · shields to SH → DCN on the board |
| Hipot · PD | **100 %: pri ↔ sec ≥ 4.25 kV DC 1 s, witnessed and logged** · P → bonded-face foil 2.5 kV DC · S → foil 1.5 kV DC · PD type test + 5 / lot: extinction **≥ 2.0 kV**, ≤ 10 pC after 1.2 × pre-stress |
| Thermal | both yoke faces gap-padded to the upper and lower extrusion webs, end turns potted to the web · type test at the named corners: ≤ 125 °C at 55 °C inlet, ≤ 135 °C at 75 °C derated (thermocouples at the winding outer surface and the centre leg) |
| Over-temperature cutout | one NC 130 ± 5 °C thermostat per cell at the winding hot-spot witness point — a lost bond is screened at EOL by the bonded thermal soak |
| Terminations | primary header P1 · P2 · SH on one end-turn face · secondary header SA · SB on the opposite face, ≥ 8 mm plus a slot between groups |
| Mechanical · marking | ≤ 70.5 × 65.9 × 91 mm plus headers · the 65.9 mm yoke-face height is controlled · **1.3 kg** per cell · label p/n, rev, lot, serial, measured leakage, polarity dots |
| Production test | 100 %: ratio, Lm, leakage + label, Rdc × 3, pri ↔ sec and bonded-face hipots · sample: short-circuit R 5 / lot, PD 5 / lot · first article: dimensions, cross-section, impulse, PD and thermal type tests |

**Winding table (each cell)** — radial order from the centre leg; breadth 41 mm; conductors confined to the 28 mm centre band.

| # | Element | Construction | Laid over it |
|---:|---|---|---|
| 0 | former + base wrap | 1.2 mm wall | ≥ 2 layers barrier tape |
| 1 | **S1** (half of the secondary) | 6 T, Cu foil 0.10 × 28 mm, one per turn | ≥ 3 layers barrier tape |
| 2 | shield 1 | 1 T foil, ends insulated from each other | 1 layer tape |
| 3 | **P** | 6 T TIW-served litz 3850×0.063 mm (12 mm²), one layer | 1 layer tape |
| 4 | shield 2 | as shield 1 | ≥ 3 layers barrier tape |
| 5 | **S2** (the other half) | as S1 | ≥ 2 layers outer wrap |

<details><summary><b>Proof at the simulated corners</b></summary>

| Gate | Check | Result | |
|---|---|---|:---:|
| `magnetics-envelope` | 30kw 2×E70 2 cells 6:6∥6 · web2 · R core→wall 0.77 · winding→core 0.88 K/W | core corner ENV500-55 87.5 kHz B̂ 159 mT Fe 31.8 W · copper corner SER250-full-bus764 202.9 kHz Cu 45.8 W · hot-spot 106 °C @55 °C (SER250-full-bus764; core 90 °C / winding 106 °C) / 103 °C @75 °C derated (ENV500-55) · +25 % Rth 114 °C · runaway margin 116 K · B̂ 39 % of hot Bsat | ✅ |
| `magnetics-envelope` | D3-BOND-LOST · 30kw | one face lost (web1) → 110 °C @55 / 116 °C @75 · +25 % 128 °C → not survivable — screened by the EOL bonded thermal soak | ℹ️ |
| `magnetics-envelope` | BOND · 30kw | D3 + D3 (potting) cannot survive a lost bond → EOL bonded thermal soak is mandatory (docs/dfm-production.md) | ℹ️ |
| `stress-audit` | 30kw cell Bpk at the worst simulated corner | 159 mT at ENV500-55 (87.5 kHz) on 2× E70 6:6∥6 ≤ 205 mT (50 % of N95 Bsat 100 °C; loss is the binding limit — magnetics-envelope) | ✅ |
| `conductor-audit` | 30kw cell foil halves 1× 0.1 mm × 28 mm, 6 turns @203 kHz | h/δ 0.59 (η 0.68) → Dowell Fr 1.23 (m 6) ≤ 1.35 → both halves 30.2 W at 34.6 A rms each (SER250-full-bus764; optimum 0.1 mm = 30.2 W) | ✅ |
| `conductor-audit` | 30kw cell profiled-litz primary 3850×0.063 mm | Sullivan (interleaved k 0.25) Fr 1.32 → 15.7 W at 70.5 A rms | ✅ |
| `conductor-audit` | 30kw production Rdc rows @25 °C match the 2×E70 cell build | MLT S1/P/S2 189/211/232 mm → P 1.85 (≤2.1) · S1 7.14 (≤8) · S2 8.74 (≤9.8) mΩ — rows ≤15 % above the build so a short strand count or thin foil is caught | ✅ |
| `temp-critique` | D3 simulated worst flux at 130 °C core | worst B̂ 159 mT (30kw ENV500-55, cell envelope) ≤ 50% of Bsat(130 °C)=362 mT (44%) — loss-limited, never sat-limited | ✅ |
| `magnetics-envelope` | 30kw D3 with one of 3 fans dead at 55 °C inlet (F.25 derate 50 %) | airflow ×0.67 · web 74 °C · air 63 °C → hot-spot 88 °C (ENV500-55) ≤ 135 °C derated line · runaway margin 127 K ≥ 25 — core loss does not derate, copper does | ✅ |
| `magnetics-envelope` | 30kw D3 cell current share with a ±7 % Lm mismatch between the two cells | LOW mode (banks parallel): the heavier cell's secondary rises 8.3 % rms at ENV500-55 · its copper at the worst LOW corner 33.9 W (PS150-Imax) ≤ the 45.8 W copper corner the thermal proof already carries · HIGH mode (banks in series) balances by equal charge | ✅ |
| `mkf-crosscheck` | 30kw D3 cell Lm from the drawn gap Σ 2.21 mm in 5 × 0.44 mm | Zhang 29.39 µH (+5.0 %) · Muehlethaler 29.49 · Partridge 28.74 · Balakrishnan 28.90 · Stenglein 35.85 vs 28.00 µH ± 7 % → with fringing Σ ≈ 2.3 mm (5 × 0.47 mm) reaches the target — ground to AL either way; this is the first-grind guide | ✅ |
| `mkf-crosscheck` | 30kw D3 cell Rdc per winding @25 °C from MKF's turn layout | P 1.81 vs 1.85 mΩ (-2.2 %) · S1 7.00 vs 7.14 mΩ (-1.9 %) · S2 8.52 vs 8.74 mΩ (-2.5 %) — acceptance ±5 % | ✅ |
| `mkf-crosscheck` | MKF-CU · 30kw D3 cell copper at SER250-full-bus764 202.9 kHz, 100 °C | MKF 59.1 W (P 11.6 ohmic + 0.0 skin + 5.8 prox · S1 10.9 ohmic + 7.9 skin + 0.0 prox · S2 13.2 ohmic + 9.6 skin + 0.0 prox) vs 1-D 45.8 W (litz 15.6 Sullivan + foils 30.2 Dowell) → ×1.29: MKF resolves the edge current where the 28 mm foil stops short of the window, which the 1-D porosity factor reads low · short-circuit R at 203 kHz, halves shorted, 25 °C: 1-D 8.33 · MKF 10.39 mΩ | ℹ️ |
| `mkf-crosscheck` | 30kw D3 cell with MKF copper ×1.29 in the magnetics-envelope network | hot-spot 115 °C @55 °C (core 94 / winding 115) vs 125 · 102 °C @75 °C derated vs 135 · +25 % Rth 126 °C vs 155 · runaway margin 116 K vs 25 | ✅ |
| `mkf-crosscheck` | MKF-LEAK · leakage is not taken from MKF 1.4.0 | foil and rectangular turns return 90–170 µH per D3 cell and the value rises with foil height (physically it falls); litz stand-ins give 1–2 µH. The 1-D S1–P–S2 figure (0.09–0.17 µH) and the first-article leakage measurement stand | ℹ️ |

</details>

**Build and hold points.** (1) Grind the centre legs to the AL target, equally on every set, ≤ 0.5 mm per position; glue-stack into the
former, cure, re-measure. (2) Base wrap. (3) S1 foil with fold-back tails to the bank side, then ≥ 3 barrier layers. (4) Shield 1, ends
insulated (no shorted turn), tail to SH. (5) Primary TIW-served litz in one even layer — strip the triple wall only to the drawing's window
with a thermal stripper, never a blade. (6) Shield 2 and ≥ 3 barrier layers. (7) S2 and the outer wrap. **H1** ratio, Lm, leakage written
on the traveler, Rdc × 3, polarity. (8) VPI class H with bond faces and headers masked. (9) Terminate the headers on opposite faces; fit
the cutout. **H2** full acceptance row, leakage re-measured after VPI. **H3** pri ↔ sec hipot — always the last electrical test — PD sample,
label with the post-VPI leakage and serial.

## D7 — 3-phase common-mode choke · qty 2 · `CMC-3PH-2mH-SKU`

Two CM stages with Y1 trios on the node between them and on the converter side; the X2 star stages of the input filter carry the
differential mode, so the module has no AC-side DM choke. The choke's own leakage (6–12 µH) rides every line crest, so its DM-bias flux is an acceptance
line, not a typical. **At 30 kW the catalog Schaffner RT8131-63-2M8 is the primary part** (63 A / 2.8 mH, 89.1 A pk above the 82.6 A crest); this drawing is its second source.

| Row | Specification — PMP-MAG-D7-30 rev B |
|---|---|
| Core | nanocrystalline tape-wound toroid, µi(10 kHz) 25–40 k class (VITROPERM 500F / Nanoperm 30000 / AT&M CMC grade), Bsat ≥ 1.2 T · **T 80/50/25** (AT&M CC050 class) · the quote must state **A_Fe ≥ 281 mm²** (iron, excluding case) · never impregnated |
| Windings | 3 sectors × **8 T**, same sense, start and finish on one side · Cu **20 mm²**, ≤ 2 layers · sector spacing ≥ 3 mm plus a UL 1446 barrier · J 2.79 A/mm² |
| Electrical acceptance | **L_cm ≥ 2.0 mH @ 10 kHz** (design 2.27 mH at µ − 30 %) · **L_cm ≥ 1.0 mH @ 150 kHz** · DM-bias row: L_cm @ 10 kHz ≥ 2.0 mH and ≥ 80 % of unbiased with **83 A** DM injected · leakage **6–12 µH**, measured and reported · quote check L_lk × I_pk / (8 × A_Fe) ≤ 0.6 T · Rdc per winding ≤ 0.85 mΩ @ 20 °C (calc 0.77), matched ± 5 % |
| Hipot | winding ↔ winding 2.5 kV AC 1 min · winding ↔ core 2.5 kV |
| Thermal | ΔT ≤ 45 K at **55.9 A rms** (calc 20 K at 100 °C copper, 9.9 W) · thermocouple between sectors |
| Mechanical | finished ⌀ ≤ 95 mm, H ≤ 40 mm (calc 93 × 38) · bonded base plus band · 6 leads into plated holes · ≈ 0.89 kg |
| Production test · marking · qty | 100 %: L_cm @ 10 kHz, Rdc × 3 matched, hipot · sample 5 / lot: L_cm @ 150 kHz, leakage · first article: DM-bias row and ΔT · label p/n, lot · qty 2 per module |

<details><summary><b>Proof at the simulated crest</b></summary>

| Gate | Check | Result | |
|---|---|---|:---:|
| `stress-audit` | 30kw winding J [engine] | D7 20 mm² → 2.79 A/mm² ≤ 5.6 (no AC-side DM choke) | ✅ |
| `stress-audit` | 30kw DM-leakage flux at the simulated crest | 12 µH × 82.6 A / (8 T × 281 mm²) = 0.44 T ≤ 0.6 (hot Bsat 1.155 T) · L_cm 2.27 mH ≥ 2 at µ −30 % (T 80/50/25) | ✅ |
| `stress-audit` | 30kw common-mode flux from the switch-node edges | Cp 200 pF × 425 V → 6 V on the 14.1 nF Y trio for ½ × 50 kHz across 8 T × 281 mm² = 27 mT ≤ 10 % of the hot Bsat (1.155 T) — the 150 Hz midpoint component closes through pF and is negligible | ✅ |
| `stress-audit` | 30kw hot-copper ΔT | 9.9 W/choke at 100 °C Cu → ΔT 20 K ≤ 45 (registered 11.5/15.3/19.2 W were 20 °C copper on a turn the OD62 core could not hold) | ✅ |
| `stress-audit` | 30kw parts-db carries the engine core | T 80/50/25 · A_Fe ≥ 281 mm² in the CMC override note | ✅ |
| `stress-audit` | 30kw catalog Schaffner RT8131-63-2M8 vs the crest | 82.6 A pk ≤ 63 A × √2 = 89.1 A (vendor rating covers its own leakage flux) | ✅ |
| `mkf-crosscheck` | 30kw D7 L_cm from MKF's Nanoperm 30000 permeability (10 kHz, 100 °C, −30 %) | µ 29517 → 2.29 mH on A_Fe 281 mm² / le 204 mm, N 8 vs engine 2.27 mH (+0.8 %) and the ≥ 2.0 mH line — the cased T 80/50/25 is not in the MKF shape database, so this checks the material basis, not the geometry | ✅ |

</details>

**Build.** Never remove the core case — nanocrystalline tape is strain-sensitive. Wind three sectors at 120° with ≥ 3 mm taped walls,
8 T each. **H1** L_cm, three matched Rdc, measured leakage recorded (the LISN model consumes it). No vacuum impregnation — surface
seal only. **H2/H3** hipots, label.

## D4 — aux flyback transformer · qty 1 · `XFMR-AUX-FLY-E`

The same part on every SKU (ETD44, reinforced barrier, 100 % hipot), qty 1 per module — core, windings, outline, terminations and acceptance rows on the [magnetics hub](magnetics.md#d4--aux-flyback-transformer-rev-e). **Current rating on this module:** primary ≤ 4.67 A pk at the cycle-by-cycle limit · V24 1.6 A DC · V15 1 A DC at the heaviest load.

<details><summary><b>Proof</b></summary>

| Gate | Check | Result | |
|---|---|---|:---:|
| `stress-audit` | flux at the computed cycle-by-cycle limit | 860 V · Lp +5 % · VILIM 1.08 V · CS 1 k/100 pF · tILIM 150 ns → 4.67 A → 257 mT = 71.1 % of Bsat(130 °C) ≤ 75 % on ETD44 (the control ETD39 build computes 5.1 A → 113 % — rejected) | ✅ |
| `stress-audit` | full load stays under the FCS fault timer at the lowest running bus | 50kwa 89.8 W in · Lp −5 % · osc −8 % · Rcs +1 % · ramp max at 306 V: CS 0.828 V vs FCS min 0.90 V (8 % ≥ 5 %) · deliverable 93 W ≥ 1.1 × 79 W (a nuisance latch here would drop the module until AC is cycled) | ✅ |
| `stress-audit` | DCM and duty at brown-out min, Lp max | t_on + t_reset = 68 % of the period ≤ 90 % · duty 22.1 % ≤ DCmax(min) 44.2 % | ✅ |
| `stress-audit` | RCD clamp resistor + capacitor duty | 3× 11 k: 0.94 W/part at full load and 5 µH (≤ 50 % of 2 W) · 2.13 W/part for ≤ 20 ms at the limit (≤ 2.5×) · 153 V/part · CCLA 459 V of 1200 V · idle bleed 0.75 W (the control build's clamp diode sits at 173 % of 1200 V — rejected) | ✅ |
| `stress-audit` | brown-in with the IBO hysteresis source starts at 285 VAC | brown-out 306/321/336 V (321 V floor) · brown-in 327/345/363 V ≤ 95 % of the 403 V bus at 285 VAC · hysteresis ≥ 20.9 V (the control 2.4 M divider computes brown-in 369 V typ, 390 V worst — a "342 V cold start" could never start; T-11 row carries the band) | ✅ |
| `stress-audit` | cold start inside the EVT acceptance (VCC(on) max, CVCC +20 %, ICC1 max) | 12.4 s at 285 VAC (≤ 13) · 10.7 s at 320 VLL (≤ 11) · 8.1 s at 400 VLL (≤ 8.5) — "≈8 s at low line" holds only at typical VCC(on) and nominal CVCC | ✅ |
| `stress-audit` | V24/V15 hard short at 860 V before the 10–20 ms fault latch | ton_min ratchet (LEB + tILIM 150 ns, osc+jitter max, loop ≥ 44.5 mΩ + RAUX24 50 mΩ): V24 5.31 A · V15 5.07 A ≤ 80 % of the 10 A QAUX pulse class · 292 mT ≤ 85 % of Bsat(130 °C) (the control build computes 11.1 A → 883 mT, deep saturation — rejected) | ✅ |
| `stress-audit` | D4 · residual | a failure AT the V24 reservoir (CAUX24/DAUX24 short, no RAUX24 in the loop) ratchets to 9.64 A / 531 mT at the 860 V worst stack — a component-failure event ended by the latch (T-09 short matrix, search coil); harness and load faults all sit behind RAUX24 | ℹ️ |
| `stress-audit` | production Rdc rows match the drawn build | pri build 217.5 → row ≤ 250 mΩ · 24 V build 8.6 → row ≤ 10 mΩ · 15 V build 5.7 → row ≤ 6.5 mΩ · aux build 58.9 → row ≤ 68 mΩ — rows within 1.0–1.25× of the build catch a wrong gauge or an open strand · hard-short loop floor 44.5 mΩ from the cold secondary | ✅ |
| `stress-audit` | leakage acceptance is buildable | P/2–S–P/2 sandwich 1-D estimate 1.7 µH ×1.5 ≤ 4 µH acceptance (+1 µH rectifier-loop allowance in every clamp row) | ✅ |
| `stress-audit` | reinforced pin allocation: bus-side row / SELV row | pins 1–4 AXA,AXB,P1,P2 · pins 5–8 S15A,S15B,S24A,S24B (mixing P1/S24A or AXA/S15A into one row puts 1.98 mm where 8.0/12.6 mm reinforced is required — land regeneration is a layout open item) | ✅ |
| `stress-audit` | aux SPICE deck: fingerprint, verdicts, anchors [aux-flyback.csv] | 17 rows, 16 PASS · FB-open limit 4.11 A vs closed form 4.1 A at the deck's typ corner (±10 %) · V24 short 5.81 A / 286 mT in the deck (≤ 8 A · ≤ 85 % Bsat 130 °C) before the fault latch; closed-form worst stack 5.31 A | ✅ |
| `temp-critique` | D4 (ETD44 DCM amp) | hot equilibria 76 °C (55 amb/full) · 84 °C (75 amb/derated); worst g(T_eq) = 0.03 ≤ 0.6; runaway threshold T_crit(g=1) ≥200 (search cap) °C — margin 116 K ≥ 25 (measured pv(T); Fe is volt-second-pinned so it does NOT derate with load — this is why the ΔT acceptance line caps the winder's Rth) | ✅ |
| `temp-critique` | D4 (ETD44 DCM amp) | measured-basis Fe @100 °C = 0.1 W vs A4 design 0.6 W (design fit must not understate by >10%) | ✅ |
| `temp-critique` | D4 (ETD44 DCM amp) | Fe(−30 °C) = 0.2 W = 2.05× the 100 °C basis; cold equilibrium core -16 °C at full load (stable — loss slope negative below the ~80 °C minimum, so cold start SELF-WARMS toward the minimum) | ✅ |
| `temp-critique` | D4 at the computed cycle-by-cycle limit, 130 °C (ETD44) | 4.67 A (860 V, Lp +5 %, VILIM max, CS lag + tILIM max) → 257 mT vs 75% of Bsat(130)=271 mT (71% absolute) — a typed 3.2 A clamp current reads 256 mT here; the drawn sense chain computes 407 mT (113%) at that clamp | ✅ |
| `mkf-crosscheck` | MKF-GAP · family D4 Lp from the drawn centre-leg gap 0.90 mm (AL 239 nH/T², Np 38) | Zhang 416 µH (+20.7 %) · Muehlethaler 568 · Partridge 421 vs 345 µH — with fringing ≈ 1.15 mm reaches it (first-grind guide) — the part is ground to its AL with a 100 % Lp test at ± 5 %, so fringing moves the grind depth, not the flux stack | ℹ️ |
| `mkf-crosscheck` | family D4 primary Rdc @25 °C from MKF's ETD 44 layout | 201 vs 1-D 190 mΩ (+6.2 %) — 38 T of 0.5 mm; MKF lays one bobbin section, the drawing splits P/2–S–P/2 · acceptance ±10 % | ✅ |

</details>

## Current transformers · 3 line + 1 resonant

| Row | Line CT × 3 · `ACX-1100` | Resonant CT × 1 · `CT-RES-1:100-100A` |
|---|---|---|
| Part | Talema ACX-1100 (2500:1, 100 A), ± 1 %, 4 kV hipot, PCB pins | 1:100, 100 A rms class (tank class 78 A = 78 %), 20–250 kHz, pass-through — the tank conductor is the primary |
| Burden (on the PCB) | **22 Ω** → F.01 **120 A pk** | **0.47 Ω** → F.11 **140 A pk**, both polarities |
| Acceptance | ratio ± 0.5 % (100 %) · no saturation below **150 A pk** (1.25 × F.01) at 25 °C on the fitted burden · linear to the F.01 + race point **166 A** · phase ≤ 1° @ 50/60 Hz · ΔT ≤ 30 K | ratio ± 0.5 % **at 140 kHz** · linear to **335 A pk (1.05 × the 318.6 A monitor peak)** at 25 °C on the fitted burden · ΔT ≤ 30 K at the tank class current — a line-frequency core does not serve this slot |
| Outline · qty | catalogue outline (ACX-1100: ⌀ 42 mm body, ⌀ 14.6 mm window) · qty 3 per module | catalogue case with the pass-through window · qty 1 per module |
| Quote | bare — the burden lives on the PCB; secondary Rdc recorded per unit (EOL calibration) | bare |

<details><summary><b>Proof — trips observable through their race</b></summary>

| Gate | Check | Result | |
|---|---|---|:---:|
| `current-coordination` | 30kw threshold ≥ 1.2× simulated worst line peak | 120 A pk vs 97 A (330-full-dip50-5ms-recovery: ripple on the soft-saturated D1 at lot AL−8 %, bus 830, incl. 30 %/50 % dips + 20° jump with the firmware's 1.05× reference clamp) → 1.24× | ✅ |
| `current-coordination` | 30kw observability through the 3 µs kill race | Δi(3 µs, 560 V, L(i) at AL−8 %) = 45.3 A → 165.3 A ≤ ceiling 184.1 A on 22 Ω · threshold at 2.71 V ≤ 3 V | ✅ |
| `current-coordination` | 30kw threshold ≥ 1.2× simulated worst tank peak | 140 A pk vs 112.6 A (SER250-full-bus764) → 1.24× | ✅ |
| `current-coordination` | 30kw window-comparator kill + observability | \|Ip\| crosses F.11 1.5 µs after the short → kill peak 210.3 A (+1 µs, ×1.2 ≤ 344.7 A on 0.47 Ω) · monitor peak +3 µs 321.4 A ×1.05 in rail · window 0.99/2.31 V | ✅ |
| `current-coordination` | 30kw LLC FET pulse class at the FAST kill peak | +0.5 µs 198.1 A ≤ 0.9 × 265 A × 1 die = 238.5 A (comparator 50 ns + HRTIMER filter 0b0011 37 ns + driver 60 ns + t_d,off 50 ns ≈ 0.2 µs after the comparator input crosses → 0.5 µs budget) · conservative +1 µs 210.3 A (79 % of I_DM) · monitor +3 µs 321.4 A · SG2M023120LJ RFQ acceptance I_DM ≥ 265 A (parts-db) — the C3M0021120K proxy lists 200 A; BINDING RFQ LINE for the 30 kW single die | ✅ |
| `stress-audit` | line CT class @40 kW | the 40 kW takes the 150 A class (ACX-1150) — F.01 155 A + 50 A race needs linearity past the ACX-1100's ~179 A at 18 R; 30 kW uses the ACX-1100 (55 A, F.01 120 A on 22 R) | ✅ |
| `stress-audit` | resonant CT class per variant | one tank CT: 30 kW 78 A class on 100 A (78 %); 40/50 kW 100/120 A class on 150 A (67/80 %) — RFQ lines, sensor path not power path | ✅ |
| `stress-audit` | line CT class @50 kW | 91.6 A worst vs 150 A class (ACX upsize at RFQ; ACX-1100 would run 92%) | ✅ |

</details>

## Prototype route — before the winder

| Part | Fastest honest route for the first 30 kW build |
|---|---|
| D1 | wind in-house on stocked 0077908A7 cores with 1.6 mm grade-2 wire to this sheet; measure L₀, L @ Ipk and Rdc against the rows |
| D2 · D3 | stocked TDK E70/33/32 N95 sets and B66372A2000 formers; litz to order; wind to this sheet and measure Lm, leakage and Rac at 140 kHz (EVT T-31 / T-34) before trusting any tank result |
| D7 | Schaffner RT8131-63-2M8 from stock |
| CTs | Talema catalogue parts (ACX line CTs, AS-series resonant CT) |
| D4 | bring the control up on a catalogue 24 V supply (Mean Well RSDH-150-24 class plus a 24 → 15 V converter) until the ETD44 part arrives |

## EVT hooks

| Test | What it closes for these magnetics |
|---|---|
| T-31 | first-article D3 short-circuit R at 203 kHz against the 1-D … MKF bracket — it decides which copper model the D3 thermal margin rests on — plus D2 Rac and ΔT at the class current for every D2 / D3 winding |
| T-33 | D1 as-mounted resonance search and endurance |
| T-34 | the assembled tank: D2 ± 3 %, cell leakage ± 30 %, fr within ± 5 % |
| T-37 | D2 flux at the F.11 kill with a search coil |
| T-09 · T-18 · T-29 | D4 clamp, thermal and cold start |

---

<div align="center">
<sub><a href="magnetics.md">← Magnetics Hub</a> &nbsp;·&nbsp; <a href="README.md">🧭 Documentation hub</a> &nbsp;·&nbsp; <a href="magnetics-40kw.md">40 kW Module Magnetics →</a></sub>

<sub>Vectivolt DC-Modules · documentation rev E85 · every number reproduces with <code>sh calculations/run-all.sh</code></sub>
</div>
