vectivolt/DC-Modules/docs/magnetics-50kwa.md

# 🧲 50 kW Air Module Magnetics

<sub>Every magnetic on the 50 kW air module — drawing, gate proof, build, tests, prototype route and cost</sub>

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

> [!NOTE]
> **Purpose** — every magnetic on the **50 kW air module**: what it does, the drawing to quote, the proof the gates computed at
> the simulated corners, how a winder builds and accepts it, how to prototype it, and what it costs. **Generated by
> `calculations/magnetics/mag-docs.mjs` from the last battery run's gate evidence — do not hand-edit.** Method, materials,
> insulation system and the common parts (D4, test methods, failure modes): [magnetics hub](magnetics.md).

## At a glance

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

```mermaid
flowchart LR
  AC(["3-φ AC"]) --> D7["D7 · CM chokes × 2<br/>T 90/50/30"] --> D1["D1 · PFC chokes × 3<br/>5 × T79 · N 24"]
  D1 --> BUS[("split DC bus<br/>650–830 V")]
  BUS --> FB["full-bridge LLC"] --> TANK["Cr 11 × 33 nF + D2 3.20 µH"] --> D3["D3 cells × 2<br/>4:4∥4 · primaries in series"] --> BK["banks A + B"]
  BUS --> D4["D4 · aux flyback"]
  LCT["line CTs × 3 · 13 Ω"] -.- D1
  RCT["resonant CT · 0.30 Ω"] -.- TANK
  style D1 stroke:#d19a00,stroke-width:2px
  style D3 stroke:#1a9fb3,stroke-width:2px
  style TANK stroke:#b8732e,stroke-width:2px
```

## Critical review at a glance

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

| Mechanism | D1 PFC choke | D2 resonant L | D3 transformer cells | D4 aux flyback | D7 CM choke | CTs |
|---|---|---|---|---|---|---|
| **Saturation · flux margin** | L 47.6 µH @ 129.5 A ≥ 45 µH | B̂ 22 % of hot Bsat · 154 mT at the F.11 kill ≤ 217 | B̂ 39 % of hot Bsat · family worst 44 % of Bsat(130 °C) | 257 mT = 71.1 % of Bsat(130 °C) at the current limit ≤ 75 % | DM 0.46 T ≤ 0.6 · CM 17 mT | no saturation below 244 A pk (1.25 × F.01) |
| **Core loss · thermal runaway** | Fe 7.5 W at the 50 kHz ripple | Fe 30.6 W · runaway margin 157 K | Fe 47 W · runaway margin 119 K | runaway margin 116 K · cold start self-warms | nanocrystalline at line frequency — negligible | — |
| **Copper · skin · proximity** | Cu 37.4 + 17.7 W · ripple Fr 38 | Fr 3.15 · Cu 45 W · MKF ×0.40 | foil Fr 1.17 · Cu 71.3 W · MKF ×1.32 | primary Fr 1.05 (sandwich) | 26.7 W per choke | — |
| **Winding temperature** | 92 °C @ 55 °C ≤ 120 | 109 °C @ 55 °C ≤ 125 · +25 % Rth 118 ≤ 155 | 116 °C @ 55 °C ≤ 125 · +25 % Rth 127 ≤ 155 | ΔT ≤ 45 K at 110 W (type test) | ΔT 38 K ≤ 45 | ΔT ≤ 30 K at class current |
| **Current rating · density** | 3.55 A/mm² ≤ 5.5 | 116.1 A rms · 182.5 A pk · 5.1 A/mm² | P 116.1 A rms (8.3 A/mm²) · each half 57.0 A rms (12.7 A/mm²) — loss-governed | ≤ 4.67 A pk primary · V24 2.4 A · V15 1.2 A | 3.66 A/mm² ≤ 5.6 | 150 A line · 150 A rms class resonant |
| **Insulation · HV stress** | basic to PE · 2.5 kV DC hipot · impulse 4 kV | basic to PE · PD extinction ≥ 2.0 kV | **reinforced** · 4.25 kV DC 100 % · PD ≥ 2.0 kV | **reinforced** · 4.25 kV DC 100 % · 8.0 / 12.6 mm | 2.5 kV AC winding ↔ winding | 4 kV catalogue hipot |
| **Leakage · coupling** | — | carries the tank Lr (± 3 %) | cell 0.132 µH · Lr stack ± 4.2 % ≤ 5 % | 1-D 1.7 µH · accept ≤ 4 µH | 6–12 µH, measured at first article | — |
| **DC bias** | engine 44.7 % ≤ material data 55.5 % at the floor | series Cr blocks DC (flux-walk proof) | series Cr blocks DC (flux-walk proof) | DCM — resets every cycle | 3-wire Σi = 0; DM rides as leakage flux | — |
| **Current imbalance · circulating current** | one choke per phase | — | 7.8 % between cells in LOW mode; HIGH mode balanced | — | 3-wire, Σi = 0 | — |
| **Resonance · switching transients** | filter–loop modulus margin ≥ 0.59 | ZVS on all four switches at every corner except 3 phase-shift corners, where the weak leg turns on with 232–387 V of residual — the thermal grid and the firmware junction observer carry that loss | secondary ring 611 V = 51 % of the 1200 V rectifiers | switch 1344 V = 79 % with the clamp · SRF ≥ 650 kHz | — | — |
| **Faults · abnormal operation** | bypass closure 280 A pk (F.01 blanked) · OC race Δi 72 A ≤ 116 | F.11 kill 320 A pk — flux in row 1 | one fan out 87 °C · bond lost 124 °C → EOL soak | hard short V24 5.31 A · V15 5.07 A before the latch | surge clamped before the chokes | F.01 race 266.4 A ≤ 311.5 A ceiling |
| **Second opinion — PyOpenMagnetics** | Rdc -1.4 % | Rdc +1.0 % · gap guide 15.0 mm | Rdc -0.8 % · 130 °C at MKF copper | Rdc +6.2 % | L_cm +0.6 % | catalogue parts |

## How to read the proof tables

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

## D1 — PFC boost choke · qty 3 · `IND-PFC-107u-50`

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

| Row | Specification — PMP-MAG-D1-50 rev C |
|---|---|
| Core | **5 × Magnetics 0077908A7** Kool Mµ 26µ toroid (OD 78.94 / ID 48.21 / HT 17.02 mm max; AL 37 nH/T² ± 8 % per core); faces epoxy-bonded, distributed gap — no grinding |
| Winding | **N = 24 nominal, winder trims ± 1 turn per core lot** · **13 × 1.6 mm** grade-2 dual-coat enamelled round (Class 200), taped into one bundle every 150 mm, laid flat · bore layers 17 / 7 · spread ≥ 300° |
| Electrical acceptance (100 %) | L₀ @ 0.1 V / 100 kHz **98–124 µH (107 nom)** · **L @ 129.5 A pk ≥ 45 µH** (pulse method) · Rdc **≤ 4.15 mΩ @ 25 °C (build 3.63) and within ±5 % of the lot median** — one open strand fails the lot window |
| Operating point | 91.2 A fundamental + 10.16 A rms ripple at 330 VAC, bus 830 V, AL − 8 % — loss and hot-spot in the proof table |
| Insulation | basic insulation to PE: bonded face through the module gap pad, bore through sleeve + clamp cap; recurring peak ≤ 540 V (no PD test) · winding ↔ core functional · Class F (155 °C) UL 1446 system |
| Thermal | one end face gap-pad bonded to the extrusion web · hot-spot limit 120 °C at 55 °C inlet · bonded type test: 117.3 A DC → hot-spot ≤ 26 K above the plate |
| Over-temperature cutout | not required on the air twin — one lost pad computes 129 °C, inside Class F (the liquid SKU carries one per choke) |
| Mechanical · mounting | finished ⌀ 94 × H 115 mm, mass **2.7 kg** (computed) · M6 A4-70 through the bore at 4.5 N·m on a Belleville via a GF-PPS insulating cap · 2-point glass banding |
| Terminations | 2 × tinned flying leads, 60 mm, strain-relief loop ≥ 10 mm before the board |
| Production test | 100 %: L₀ · L @ Ipk pulse · Rdc (row + lot window) · hipot **2.5 kV DC 1 min** winding ↔ bond-face plate + bore mandrel · first article: 4 kV 1.2/50 impulse × 5 each polarity, Rac @ 50 kHz recorded |
| Marking · qty | label p/n, rev, lot, date, N · qty 3 per module · operating ambient −40 … +55 °C full power, derated to +75 °C |

<details><summary><b>Proof at the simulated corners</b></summary>

| Gate | Check | Result | |
|---|---|---|:---:|
| `stress-audit` | 50kwa biased-L floor [catalog AL] | L0 107 µH → 47.6 µH @129.5 A ≥ 45 (same D1-50 rev B part as the liquid SKU) | ✅ |
| `stress-audit` | 50kwa swing floor | L@Ibias/L0 = 0.45 (30 kW swing-choke basis exempt: drawing governs via its own biased-L line) | ✅ |
| `stress-audit` | 50kwa current density | 3.55 A/mm² ≤ 5.5 | ✅ |
| `stress-audit` | 50kwa 5×T79 N 24 13×1.6 mm · web1 | hot-spot at the 330 VAC continuous corner [computed] — Cu 37.4 W @50 Hz + 17.7 W ripple (10.16 A rms, Fr 38 = Ferreira 55.9 × 2-D 0.68) + Fe 7.5 W → hot-spot 92 °C @55 °C (winding 87 °C, air 65 °C, web/plate 80 °C, 39 W into it) · 99 °C @75 °C derated · +25 % Rth 96 °C · limits 120/130/145 °C [d1-fd N24·nw13·d1.6·x5·L17/7] | ✅ |
| `stress-audit` | 50kwa one lost bond survivable or cut out | pad lost → convection only: 129 °C vs Class F 155 °C — survives | ✅ |
| `stress-audit` | D1-BUILD · 50kwa | MLT 225 mm (layer model 231) · bore layers 17/7 of ⌀7.2 mm bundles → finished ⌀94 × H 115 mm (layout open item — tunnel/keep-out rows) · bundle cut ≥ 6.4 m · bonded type test: 117.3 A DC (= 64.4 W) → hot-spot ≤ 26 K above the plate (calc 16.3 K + 10) | ℹ️ |
| `conductor-audit` | 50kw bundle 13× 1.6 mm, 24 T on 5×T79 | MLT 225 mm (Magnetics table, K 39 %) · 50 Hz 91.2 A → 38.9 W · 50 kHz ripple 10.16 A rms at Fr 37.1 (Ferreira 54.6 × 2-D 0.68; a flat untwisted bundle computes 8.3 W) → 17.9 W · Cu 56.9 W hot — a two-layer Dowell (m = 2) model reads 5.5 W ripple copper [d1-fd N24·nw13·d1.6·x5·L17/7] | ✅ |
| `conductor-audit` | 50kw production Rdc row @25 °C catches open strands | build 3.63 mΩ · row ≤4.15 mΩ (14 % above; worst good part 3.98; 2 strands open 4.29) · lot window ±5 % vs one open strand +8.3 % — a row set by round numbers instead of the build passes a part with a third of its strands open | ✅ |
| `temp-critique` | 50kw OC→ceiling time / 3 µs adder | L(195 A)=28.7 µH (AL−8%) · Δi(3 µs)=72 A ≤ ceiling−threshold 116 A · ceiling reached in 4.5 µs — CT stays observing until the HRTIMER kill lands (2–3 µs budget) | ✅ |
| `current-coordination` | 50kw precharge-bypass closure at 90 % of line peak · F.01 blanked, D1, link | 280 A pk through D1 and the rectifier (above F.01 195 A) · D1 falls to 18 µH from 98 µH at the peak — soft powder saturation for 1.5 ms, winding +0 K adiabatic · bus 605 → 722 V ≤ 860 V OVP · F.01 blanked 60 ms ≥ relay 25 + bounce 5 + pulse 1.5 ms, no PFC enable inside (fsm.c) | ✅ |
| `current-coordination` | 50kw rectifier diode surge at bypass closure | 45 A²s per diode vs 50 % of the RFQ line IFSM ≥ 250 A (10 ms half-sine → 313 A²s) | ✅ |
| `current-coordination` | 50kw bypass relay make and gG fuse at closure | make 280 A pk at ≤ 67 V across the contacts vs the RFQ make line 360 A pk (≥ 1.25×) · fuse 45 A²s ≤ 10 % of the gG pre-arc 7000 A²s — no melting, no ageing | ✅ |
| `mkf-crosscheck` | 50kw D1 Rdc @25 °C from MKF's toroid winding | 3.58 vs build 3.63 mΩ (-1.4 %) — 5 × T 79/48/17, N 24, 13 × 1.6 mm · acceptance ±5 % | ✅ |
| `mkf-crosscheck` | 50kw D1 Kool Mµ 26 DC-bias roll-off (MKF material data, 100 °C) vs the engines' fit | floor 130 A = 199 Oe: MKF 55.5 % vs engine 44.7 % · inrush 280 A = 431 Oe: MKF 23.5 % vs engine 18.6 % — the engines' L(i) sits at or below the material data, so every biased-L floor and the inrush peak are conservative | ✅ |

</details>

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

## D2 — external resonant inductor · qty 1 · `IND-LR-E70-50`

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

<details><summary><b>Proof at the simulated corners</b></summary>

| Gate | Check | Result | |
|---|---|---|:---:|
| `magnetics-envelope` | 50kwa D2 + D3 leakage stack inside the simulated Lr tolerance | D3 cell S1–P–S2 leakage 0.132 µH × 2 + 0.1 µH loop → D2 3.2 µH of Lr 3.56 µH · worst-case stack ±4.2 % (D2 ±3 % + leakage ±20 %) vs ±5 % simulated | ✅ |
| `magnetics-envelope` | 50kwa 2×E70 N 5 · 3.29 µH max · web2 · R core→wall 0.77 · winding→core 0.77 K/W | core corner SER250-full-bus764 203 kHz B̂ 88 mT Fe 30.6 W · copper corner SER250-full-bus764 203 kHz Cu 45 W · hot-spot 109 °C @55 °C (SER250-full-bus764; core 101 °C / winding 109 °C) / 103 °C @75 °C derated (SER250-full-bus764) · +25 % Rth 118 °C · runaway margin 157 K · B̂ 22 % of hot Bsat | ✅ |
| `magnetics-envelope` | D2-BOND-LOST · 50kwa | one face lost (web1) → 118 °C @55 / 116 °C @75 · +25 % 135 °C → survives | ℹ️ |
| `stress-audit` | 50kwa external Lr Bpk | 82 mT at Lmax 3.29 µH × 120 A rms class vs 110 mT line (N=5 on 2× E70/33/32 — D2 rev F) | ✅ |
| `stress-audit` | 50kwa external Lr litz J | 12000×0.05 mm litz (23.6 mm²): J 5.1 A/mm² ≤ 5.6 at the 120 A class | ✅ |
| `conductor-audit` | 50kw 2×E70 N 5, litz 12000×0.05 @203 kHz | MLT 221 mm · Rdc 0.82 mΩ @25 °C (row ≤0.92) · Sullivan Fr 3.15 → Rac 3.34 mΩ hot (row ≤3.7) → Cu 45 W at 116.1 A rms (SER250-full-bus764) — thermal proof: magnetics-envelope | ✅ |
| `current-coordination` | 50kwa external Lr flux: operating + fault | Lmax 3.29 µH (2×E70 N 5): 88 mT at the worst simulated peak (≤110) · 154 mT at the F.11 kill peak ≤ 60 % Bsat(130 °C) 217 mT | ✅ |
| `magnetics-envelope` | 50kwa D2 with one of 4 fans dead at 55 °C inlet (F.25 derate 50 %) | airflow ×0.75 · web 73 °C · air 62 °C → hot-spot 87 °C (SER250-full-bus764) ≤ 135 °C derated line · runaway margin 173 K ≥ 25 — core loss does not derate, copper does | ✅ |
| `mkf-crosscheck` | MKF-GAP · 50kwa D2 L from the drawn gap Σ 13.11 mm in 14 × 0.94 mm | Zhang 3.73 µH (+13.7 %) · Muehlethaler 3.73 · Partridge 3.57 · Balakrishnan 3.60 · Stenglein 5.86 vs 3.28 µH ± 3 % → with fringing Σ ≈ 15.0 mm (15 × 1.00 mm) reaches the target — ground to AL either way; this is the first-grind guide | ℹ️ |
| `mkf-crosscheck` | 50kwa D2 Rdc @25 °C from MKF's turn layout | 0.83 vs 0.82 mΩ (+1.0 %) — acceptance ±5 % | ✅ |
| `mkf-crosscheck` | MKF-CU · 50kwa D2 copper at SER250-full-bus764 203.0 kHz, 100 °C | MKF 18.0 W (14.5 ohmic + 0.0 skin + 3.5 prox) vs Sullivan 45.0 W → ×0.40 — the gate's D2 copper is the conservative figure | ℹ️ |

</details>

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

## D3 — full-bridge transformer cell · qty 2 · `XFMR-LLC-CELL-3E70-50`

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

<details><summary><b>Proof at the simulated corners</b></summary>

| Gate | Check | Result | |
|---|---|---|:---:|
| `magnetics-envelope` | 50kwa 3×E70 2 cells 4:4∥4 (2 foils) · web2 · R core→wall 0.52 · winding→core 0.58 K/W | core corner ENV500-55 87 kHz B̂ 158 mT Fe 47 W · copper corner SER250-full-bus764 203 kHz Cu 71.3 W · hot-spot 116 °C @55 °C (SER250-full-bus764; core 94 °C / winding 116 °C) / 103 °C @75 °C derated (ENV500-55) · +25 % Rth 127 °C · runaway margin 119 K · B̂ 39 % of hot Bsat | ✅ |
| `magnetics-envelope` | D3-BOND-LOST · 50kwa | one face lost (web1) → 124 °C @55 / 119 °C @75 · +25 % 139 °C → not survivable — screened by the EOL bonded thermal soak | ℹ️ |
| `magnetics-envelope` | BOND · 50kwa | D3 + D3 (potting) + D2 (potting) cannot survive a lost bond → EOL bonded thermal soak is mandatory (docs/dfm-production.md) | ℹ️ |
| `stress-audit` | 50kwa cell Bpk at the worst simulated corner | 158 mT at ENV500-55 (87 kHz) on 3× E70 4:4∥4 ≤ 205 mT (50 % of N95 Bsat 100 °C; loss is the binding limit — magnetics-envelope) | ✅ |
| `conductor-audit` | 50kw cell foil halves 2× 0.08 mm × 28 mm, 4 turns @203 kHz | h/δ 0.48 (η 0.68) → Dowell Fr 1.17 (m 8) ≤ 1.35 → both halves 41.8 W at 57 A rms each (SER250-full-bus764; optimum 0.1 mm = 40.4 W) | ✅ |
| `conductor-audit` | 50kw cell profiled-litz primary 3536×0.071 mm | Sullivan (interleaved k 0.25) Fr 1.25 → 29.5 W at 116.1 A rms | ✅ |
| `conductor-audit` | 50kw production Rdc rows @25 °C match the 3×E70 cell build | MLT S1/P/S2 253/272/290 mm → P 1.36 (≤1.55) · S1 3.97 (≤4.5) · S2 4.55 (≤5.1) mΩ — rows ≤15 % above the build so a short strand count or thin foil is caught | ✅ |
| `temp-critique` | D3 simulated worst flux at 130 °C core | worst B̂ 159 mT (30kw ENV500-55, cell envelope) ≤ 50% of Bsat(130 °C)=362 mT (44%) — loss-limited, never sat-limited | ✅ |
| `magnetics-envelope` | 50kwa D3 with one of 4 fans dead at 55 °C inlet (F.25 derate 50 %) | airflow ×0.75 · web 73 °C · air 62 °C → hot-spot 87 °C (ENV500-55) ≤ 135 °C derated line · runaway margin 132 K ≥ 25 — core loss does not derate, copper does | ✅ |
| `magnetics-envelope` | 50kwa D3 cell current share with a ±7 % Lm mismatch between the two cells | LOW mode (banks parallel): the heavier cell's secondary rises 7.8 % rms at ENV500-55 · its copper at the worst LOW corner 53 W (PS150-Imax) ≤ the 71.3 W copper corner the thermal proof already carries · HIGH mode (banks in series) balances by equal charge | ✅ |
| `mkf-crosscheck` | 50kwa D3 cell Lm from the drawn gap Σ 2.32 mm in 5 × 0.46 mm | Zhang 18.64 µH (+4.7 %) · Muehlethaler 18.70 · Partridge 18.15 · Balakrishnan 18.43 · Stenglein 23.06 vs 17.80 µH ± 7 % → with fringing Σ ≈ 2.4 mm (5 × 0.49 mm) reaches the target — ground to AL either way; this is the first-grind guide | ✅ |
| `mkf-crosscheck` | 50kwa D3 cell Rdc per winding @25 °C from MKF's turn layout | P 1.35 vs 1.36 mΩ (-0.8 %) · S1 3.89 vs 3.97 mΩ (-2.1 %) · S2 4.57 vs 4.55 mΩ (+0.4 %) — acceptance ±5 % | ✅ |
| `mkf-crosscheck` | MKF-CU · 50kwa D3 cell copper at SER250-full-bus764 203.0 kHz, 100 °C | MKF 94.1 W (P 23.6 ohmic + 0.0 skin + 11.2 prox · S1 16.4 ohmic + 10.8 skin + 0.0 prox · S2 19.3 ohmic + 12.7 skin + 0.0 prox) vs 1-D 71.3 W (litz 29.5 Sullivan + foils 41.9 Dowell) → ×1.32: MKF resolves the edge current where the 28 mm foil stops short of the window, which the 1-D porosity factor reads low · short-circuit R at 203 kHz, halves shorted, 25 °C: 1-D 4.65 · MKF 6.12 mΩ | ℹ️ |
| `mkf-crosscheck` | MKF-THERMAL · 50kwa D3 cell with MKF copper ×1.32 in the magnetics-envelope network | hot-spot 130 °C @55 °C (core 100 / winding 130) vs 125 · 103 °C @75 °C derated vs 135 · +25 % Rth 146 °C vs 155 · runaway margin 118 K vs 25 → the design line is exceeded only under MKF's copper; the class lines hold. First article decides (short-circuit R and the bonded thermal type test); a wider foil band restores the line under MKF copper: 32 mm band 125 °C · 36 mm band 121 °C (the side margins shrink — an insulation-coordination change) | ℹ️ |
| `mkf-crosscheck` | MKF-LEAK · leakage is not taken from MKF 1.4.0 | foil and rectangular turns return 90–170 µH per D3 cell and the value rises with foil height (physically it falls); litz stand-ins give 1–2 µH. The 1-D S1–P–S2 figure (0.09–0.17 µH) and the first-article leakage measurement stand | ℹ️ |

</details>

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
