vectivolt/DC-Modules/docs/bom-50kwa.md

# 🧾 50 kW Air Module BOM

<sub>Every line of the 50 kW air module — cost by schematic section, SKU-specific parts and sourcing status</sub>

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

> [!NOTE]
> **Purpose** — the complete bill of materials of the **50 kW air module**: what it costs, where the money goes by schematic
> section, the parts that make this SKU different, and every line item with its sourcing status. **Generated by
> `calculations/cost/bom-gen.mjs` on every battery run — do not hand-edit.** Machine-readable lines: `calculations/out/bom-50kwa.csv`.

## At a glance

| | |
|---|---|
| **Build cost @10k** (India basis) | **₹40,688** · ₹814 / kW |
| **China RFQ target @10k** | **₹33,243** · ₹665 / kW — landed targets, not quotes |
| **1k · 5k · 100 pcs** | ₹50,111 · ₹44,670 · ₹65,363 |
| **Red-line / stretch** | ₹43,000 / ₹39,000 → ✅ under by ₹2,312 |
| **BOM lines · placed parts** | 179 lines · 743 parts (AC-DC 350 · DC-DC 316 · control card 77) |
| **Built to our drawings** | 9 custom lines — specifications on the [50 kW air magnetics page](magnetics-50kwa.md) |
| **Open sourcing decisions** | 8 REVIEW lines |

## Where the money goes

```mermaid
pie showData title 50 kW air module — ₹ @10k by section
  "Mechanics, thermal and assembly" : 9950
  "Vienna PFC stage" : 6182
  "AC input, surge and EMI filter" : 5992
  "Resonant tank, transformer and rectifiers" : 5535
  "Full-bridge LLC legs" : 4572
  "Split DC link and discharge" : 2780
  "Output banks, S/P relays and output diode" : 2517
  "Output and bank sensing" : 975
  "AC and bus sensing" : 958
  "Auxiliary supply and fans" : 611
  "Control card" : 323
  "CAN and HMI" : 163
  "DC-DC control interface" : 107
  "AC-DC control interface" : 24
```

| Section (schematic sheet) | Parts | Lines | ₹ @10k | Share | China target ₹ |
|---|---:|---:|---:|---:|---:|
| AC input, surge and EMI filter | 47 | 22 | 5,992 | 14.7 % | 4,897 |
| Vienna PFC stage | 90 | 22 | 6,182 | 15.2 % | 4,858 |
| Split DC link and discharge | 35 | 15 | 2,780 | 6.8 % | 2,246 |
| AC and bus sensing | 105 | 24 | 958 | 2.4 % | 806 |
| AC-DC control interface | 16 | 8 | 24 | 0.1 % | 20 |
| Auxiliary supply and fans | 57 | 34 | 611 | 1.5 % | 483 |
| Full-bridge LLC legs | 101 | 28 | 4,572 | 11.2 % | 3,582 |
| Resonant tank, transformer and rectifiers | 47 | 16 | 5,535 | 13.6 % | 4,467 |
| Output banks, S/P relays and output diode | 51 | 13 | 2,517 | 6.2 % | 2,069 |
| Output and bank sensing | 69 | 16 | 975 | 2.4 % | 828 |
| DC-DC control interface | 13 | 7 | 107 | 0.3 % | 90 |
| CAN and HMI | 35 | 19 | 163 | 0.4 % | 140 |
| Control card | 77 | 29 | 323 | 0.8 % | 281 |
| Mechanics, thermal and assembly | — | 12 | 9,950 | 24.5 % | 8,475 |
| **Module** | | | **40,688** | 100 % | **33,243** |

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

## Top cost drivers

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

## What is specific to this SKU

These lines replace the shared-cell default on the 50 kW air module (`skuOverrides` in `parts-db.mjs`); everything else is the common design.

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

## Line items by section

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

</details>

<details><summary><b>Vienna PFC stage</b> — ₹6,182 @10k · 90 parts · 22 lines</summary>

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

</details>

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

</details>

<details><summary><b>AC and bus sensing</b> — ₹958 @10k · 105 parts · 24 lines</summary>

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

</details>

<details><summary><b>AC-DC control interface</b> — ₹24 @10k · 16 parts · 8 lines</summary>

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

</details>

<details><summary><b>Auxiliary supply and fans</b> — ₹611 @10k · 57 parts · 34 lines</summary>

| Part | What it is | Refs | Qty | ₹ / unit @10k | ₹ @10k | LCSC | Status |
|---|---|---|---:|---:|---:|---|---|
| `XFMR-AUX-FLY-E` | aux flyback transformer ETD44 PC95, 110 W class, 321–860 V input, Np38 / N24 6 / N15 4 / Naux 4, Lp 345 µH ±5 … | TAUX | 1 | 184 | 184 | — | CUSTOM |
| `SIC-1700-1R-G15` | SiC FET 1700 V ~1 Ω **specified at V_GS 12–15 V** (aux flyback switch on the full bus; TO-247 likely package, … | QAUX | 1 | 128 | 128 | — | CLASS |
| `SIC-SBD-1700V` | SiC Schottky ≥1700 V, IF(AV) ≥1 A, IFRM ≥10 A, no forward recovery (aux RCD clamp). The 1700 V class is the … | DCLA | 1 | 120 | 120 | — | CLASS |
| `MICROFIT3-40` | 40-way inter-board harness header, 5 A/contact — the PFC bundle crosses here: PWM x3, 12 senses, AVMID+Kelvin, … | JICA | 1 | 58 | 58 | — | CLASS |
| `NCP1252DDR2G` | current-mode flyback controller, RT-set 65 kHz (66.5 kΩ, datasheet Rev 9), SOIC-8. The **D suffix is … | UAUX | 1 | 19 | 19 | — | ORDERABLE |
| `B4B-PH-K-S` | fan header 4-way (the fan p/n must accept 3.3 V PWM) | JFAN1 JFAN2 JFAN3 JFAN4 | 4 | 5 | 19 | C131334 | ORDERABLE |
| `TPS54202DDCR` | 15→3.3 V 2 A sync buck SOT-23-6, on the control card and exporting V3P3 over the 88-way. An LDO is thermally … | UBKA | 1 | 12 | 12 | C191884 | ORDERABLE |
| `GR227M035F12RR0VL4FP0` | 220 µF 35 V | CAUX24 CAUX15 CVCC | 3 | 3 | 10 | C45078 | ORDERABLE |
| `R2512-11k-2W-AS` | 11 kΩ 1 % 2512 2 W anti-surge, ≥200 V working (aux RCD clamp, 3-series = 33 k; ≤0.94 W/part at full load and 5 … | RCLA1 RCLA2 RCLA3 | 3 | 3 | 10 | — | CLASS |
| `R2512-HV` | 2512 HV-rated 1 %, **limiting element voltage ≥ 500 V** (aux startup 2×470 k / brown-out 2×1.2 M, 2-series per … | RAUXST1 RAUXST2 RBR1A RBR1B | 4 | 2 | 8 | — | CLASS |
| `PP-10n-1200` | 10 nF 1200 V film (aux RCD clamp) | CCLA | 1 | 7 | 7 | — | CLASS |
| `US2G` | 400 V 2 A ultrafast SMB (aux 15 V / self-supply rectifiers — PIV ≈ 157 V plus ring) | DAUX15 DAUXVC | 2 | 2 | 5 | C49263 | ORDERABLE |
| `CYA0630-10UH` | 10 µH 3 A shielded power inductor (3V3 buck) | LBKA | 1 | 5 | 5 | C5189958 | ORDERABLE |
| `HV732BTTD4753F` | 475 kΩ 1206 1% anti-surge (HV divider) | RFPD1 RFPD2 RFPD3 RFPD4 | 4 | 1 | 4 | C4121673 | ORDERABLE |
| `US3M` | 400 V 3 A ultrafast, SMC pad (aux 24 V rectifier — PIV ≈ 176 V plus the leakage ring, which is why the class … | DAUX24 | 1 | 4 | 4 | C3039981 | ORDERABLE |
| `SMBJ28A` | TVS **28 V** uni SMB — V24 rail clamp for a gross feedback-open fault, not rail regulation. The 28 V standoff … | DTVS24 | 1 | 2 | 2 | — | ORDERABLE |
| `SMBJ18A` | TVS **18 V** uni SMB — V15 rail clamp, fault duty only. 18 V clears the ±2 % reference band (V15 upper corner … | DTVS15 | 1 | 2 | 2 | — | ORDERABLE |
| `R2512-R05-1W-1%` | 50 mΩ 1 % 1 W 2512 in the V24 distribution after CAUX24: it holds a V24 hard-short loop ≥100 mΩ so the … | RAUX24 | 1 | 2 | 2 | — | CLASS |
| `R1206-R28-1%-0.5W` | 0.28 Ω 1% 0.5 W 1206 current-sense (aux cycle-by-cycle limit — with CCSF 100 pF the worst comparator margin at … | RAUXCS | 1 | 2 | 2 | — | CLASS |
| `RC0603FR-0710KL` | small-signal resistor 0402–0805 (pulls/filters/feedback) | RBEFB RBKF2A RFT1 RFT2 RFT3 RFT4 | 6 | 0 | 2 | — | CLASS |
| `CC0603KRX7R9BB104` | filter/decoupling MLCC 0402–0805 | CAUXSS CVCCB CBSTA | 3 | 0 | 1 | C14663 | ORDERABLE |
| `BZX84-B15` | 15 V **±2 %** zener (aux primary-side regulation reference — VCC regulates at VZ+VBE and the aux winding … | DZAUX | 1 | 1 | 1 | — | ORDERABLE |
| `R2512-4k7-1W` | 4.7 kΩ 1 W 2512 V24 PRELOAD, 5.1 mA / 0.12 W. Fitted because the normal standby state — every relay … | RPL24 | 1 | 1 | 1 | — | CLASS |
| `RC0603FR-07100KL` | small-signal resistor 0402–0805 (pulls/filters/feedback) | RAUXG REN1A | 2 | 0 | 1 | — | CLASS |
| `R-small` | small-signal resistor 0402–0805 (pulls/filters/feedback) | RAUXRT REN2A | 2 | 0 | 1 | — | CLASS |
| `CC0603JRNPO9BN101` | 100 pF 0603 C0G ±5 % (aux current-sense filter — 1 k ∥ 26.5 k ramp R → 96 ns lag). C0G at this value: a 470 pF … | CCSF | 1 | 0 | 0 | C14665 | ORDERABLE |
| `CC0603KRX7R9BB102` | filter/decoupling MLCC 0402–0805 | CFBF | 1 | 0 | 0 | C100040 | ORDERABLE |
| `CL21A106KAYNNNE` | filter/decoupling MLCC 0402–0805 | CBKIA | 1 | 0 | 0 | C15850 | ORDERABLE |
| `GRM21BR61C226ME44L` | filter/decoupling MLCC 0402–0805 | CBKOA | 1 | 0 | 0 | C86817 | ORDERABLE |
| `RC0603FR-071KL` | small-signal resistor 0402–0805 (pulls/filters/feedback) | RCSF | 1 | 0 | 0 | — | CLASS |
| `RC0603FR-077K5L` | small-signal resistor 0402–0805 (pulls/filters/feedback) | RBR2 | 1 | 0 | 0 | — | CLASS |
| `RC0603FR-072K2L` | small-signal resistor 0402–0805 (pulls/filters/feedback) | RZFB | 1 | 0 | 0 | — | CLASS |
| `S8050` | NPN SOT-23 (QAUXFB: opto-emulating feedback pull-down · QPVD: low-side switch for the PV-driver LEDs at the … | QAUXFB | 1 | 0 | 0 | C2146 | ORDERABLE |
| `RC0603FR-0745K3L` | small-signal resistor 0402–0805 (pulls/filters/feedback) | RBKF1A | 1 | 0 | 0 | — | CLASS |

</details>

<details><summary><b>Full-bridge LLC legs</b> — ₹4,572 @10k · 101 parts · 28 lines</summary>

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

</details>

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

</details>

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

</details>

<details><summary><b>Output and bank sensing</b> — ₹975 @10k · 69 parts · 16 lines</summary>

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

</details>

<details><summary><b>DC-DC control interface</b> — ₹107 @10k · 13 parts · 7 lines</summary>

| Part | What it is | Refs | Qty | ₹ / unit @10k | ₹ @10k | LCSC | Status |
|---|---|---|---:|---:|---:|---|---|
| `MICROFIT3-40` | 40-way inter-board harness header, 5 A/contact — the PFC bundle crosses here: PWM x3, 12 senses, AVMID+Kelvin, … | JICB | 1 | 58 | 58 | — | CLASS |
| `CONN-CARD-88-H` | 88-way 2×44 2.54 mm card interface, PIN HEADER side (power board), keyed | JB | 1 | 36 | 36 | — | CLASS |
| `ULN2803A` | 8-ch relay coil driver SOIC-18 (unused inputs grounded) | ULB | 1 | 7 | 7 | C2865085 | ORDERABLE |
| `74HC02D` | quad NOR SOIC-14 — hardware S/P exclusion: KSER coil = KSER ∧ ¬(KPARA∨KPARB). Every destructive matrix state … | UEXCL | 1 | 4 | 4 | — | ORDERABLE |
| `R0603-10k` | 10 kΩ 0603 card-interface pull-down (board-side default-OFF on the GATE_EN/EN/DO ways — CARD_RULES) | RPDB0 RPDB1 RPDB2 RPDB3 RPDB4 RPDB5 | 6 | 0 | 1 | — | CLASS |
| `CC0603KRX7R9BB104` | filter/decoupling MLCC 0402–0805 | CROLEB CEXCL | 2 | 0 | 1 | C14663 | ORDERABLE |
| `RC0603FR-0715KL` | small-signal resistor 0402–0805 (pulls/filters/feedback) | RROLEB | 1 | 0 | 0 | — | CLASS |

</details>

<details><summary><b>CAN and HMI</b> — ₹163 @10k · 35 parts · 19 lines</summary>

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

</details>

<details><summary><b>Control card</b> — ₹323 @10k · 77 parts · 29 lines</summary>

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

</details>

## Mechanics, thermal and assembly

| Item | Qty | ₹ @1k | ₹ @10k | China target ₹ |
|---|---:|---:|---:|---:|
| PCB-ACDC 6L 440×500 (50 kW copper masses) | 1 | 1,300 | 1,131 | 848 |
| PCB-DCDC 6L 440×500 | 1 | 1,500 | 1,305 | 979 |
| Heatsink extrusions (2, sandwich outer faces — 50 kW fin stock) | 1 | 1,900 | 1,653 | 1,405 |
| Fans 120×38 PWM (3 front + 1 rear, 3.3 V-PWM p/n, dual-ball L10 ≥70 kh, IP55, −30…+70 °C; IP55 premium at RFQ · ELECTRICAL CLASS: ≤ 0.6 A at … | 4 | 1,120 | 974 | 828 |
| Enclosure sheet metal + hardware (vented; NH00 fuse bases) | 1 | 1,000 | 870 | 740 |
| Busbars/interconnect studs + harness (busbar-calc, 167 A output class) | 1 | 850 | 740 | 629 |
| NTC sensor assemblies (insulated tip spec) | 4 | 72 | 63 | 53 |
| Magnetics bond kit: 3 W/mK silicone gap pads on BOTH yoke faces of the two 3-set D3 cells and the D2 to the upper/lower extrusion webs + … | 1 | 380 | 331 | 281 |
| D1 choke mount kit: per stack — fiberglass-reinforced silicone gap pad 1.0 mm ≥3 W/mK (≥5 kVAC ASTM D149, basic insulation to the PE-bonded … | 3 | 315 | 274 | 233 |
| TIM/insulators/fasteners (clip mount: 0.635 mm Al2O3 insulator + spring clip + grease under each of 39 TO-247 dies, mount.mjs 0.8 / 0.65 … | 1 | 640 | 557 | 473 |
| Conformal coating (acrylic, both boards + card) | 1 | 360 | 313 | 266 |
| Assembly + calibration + EOL test | 1 | 2,000 | 1,740 | 1,740 |
| **Total** | | **11,437** | **9,950** | **8,475** |

## Sourcing status

| Status | Lines | Meaning |
|---|---:|---|
|  | 56 | a specific catalogue part, verified against the rating |
|  | 2 | the primary is off-catalogue; a verified equivalent is named |
|  | 7 | a vendor-direct order code (Talema, Hongfa, Mean Well class) |
|  | 97 | the rating is the specification; purchasing selects to the spec line |
|  | 9 | built to our drawing — see the magnetics page |
|  | 8 | a tracked open decision, closed before release |

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

---

<div align="center">
<sub><a href="bom-50kw.md">← 50 kW Liquid Module BOM</a> &nbsp;·&nbsp; <a href="README.md">🧭 Documentation hub</a> &nbsp;·&nbsp; <a href="bom-guide.md">BOM Guide →</a></sub>

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
