vectivolt/DC-Modules/docs/bom-cost.md

# 🧾 BOM & Cost Roll-up

<sub>Module cost from 100 pcs to 10k, the China RFQ targets and the cost per kW</sub>

<p>
  
  
  
  
</p>

> [!NOTE]
> **Purpose** — what each of the four modules costs to build, from 100 pieces to 10k, how that cost falls per kW from
> 30 to 50 kW, and the levers still open. **Generated by `calculations/cost/bom-gen.mjs` on every battery run — do not hand-edit.**
>
> **Basis** — schematic-exact quantities from the built boards plus ONE control card per module, parts-db
> RFQ-target pricing (±25 %), and mechanical/assembly lines from the thermal and DFM calculations.
> Line-item CSVs with second sources and the 10k column: `calculations/out/bom-{sku}.csv`.

| Volume tier | Electronics | Mechanical | Planning role |
|---|---|---|---|
| 100 pcs | × 1.35 | × 1.15 | prototype / pilot |
| 1k | × 1.00 | × 1.00 | parts-db reference |
| 5k | × 0.88 | × 0.93 | ramp |
| **10k** | **× 0.80 + per-part quotes (p10k)** | **× 0.87** | **planning basis** — the ≥ 10k units/yr volume directive |

## At a glance — cost at 10k against the red-line

> [!IMPORTANT]
> **China RFQ target** — the same BOM at landed China-supplier TARGET prices (freight + ~10 % duty included), by category:
> SiC/JBS/diodes × 0.75 · magnetics, film and electrolytic capacitors × 0.80 · gate/iso ICs, bias modules, relays, protection ×
> 0.85 · passives, connectors, MLCC × 0.90 · PCBs × 0.75 · mechanical × 0.85 · India assembly/EOL × 1.00. These are the prices an
> RFQ must reach for the InfyPower parity comparison — **flagged targets, not quotes**.

| Build | ₹ @10k | ₹ / kW | China RFQ target ₹ @10k | ₹ / kW | Red-line | Stretch | Verdict (India basis) |
|---|---:|---:|---:|---:|---:|---:|---|
| 30 kW module | **31,613** | 1,054 | 25,924 | 864 | 25,000 | 22,000 | ⚠️ over by ₹6,613 |
| 40 kW module | **36,103** | 903 | 29,524 | 738 | 33,000 | 29,000 | ⚠️ over by ₹3,103 |
| 50 kW liquid module | **42,761** | 855 | 35,023 | 700 | 43,000 | 39,000 | ✅ under by ₹239 |
| 50 kW air module | **40,688** | 814 | 33,243 | 665 | 43,000 | 39,000 | ✅ under by ₹2,312 |

### Scenario — InfyPower-style 2U construction (not the design basis)

Same electronics; only the mechanical and assembly lines change to the `mech2U` estimates in `parts-db.mjs`: heatsink chassis
with the magnetics potted into wells, 4-layer boards at about half today's area, 3 × 80 mm fans. **Prerequisites no gate has proven:**
the PFC choke must lie in a well (today's T79 stacks stand 60–95 mm; 40 kW needs a flat-core choke), the chassis must hold the
70 °C device base at 55 °C ambient, and potting must match the two-face magnetics bond. Numbers are estimates until a mechanical
design and quotes exist.

| Build | Design basis ₹ @10k | 2U scenario ₹ @10k | 2U scenario + China RFQ target |
|---|---:|---:|---:|
| 30 kW module | 31,613 | 29,691 | **24,360** |
| 40 kW module | 36,103 | 34,167 | **27,940** |

## Cost per kW across the family

```mermaid
xychart-beta
  title "Build cost per kW at 10k volume (₹)"
  x-axis ["30 kW", "40 kW", "50 kW liquid", "50 kW air"]
  y-axis "₹ / kW" 0 --> 1200
  bar [1054, 903, 855, 814]
```

| Module | Cooling | ₹ @10k | **₹ / kW** |
|---|---|---:|---:|
| 30 kW module | air · 3 fans | 31,613 | **1054** |
| 40 kW module | air · 3 fans | 36,103 | **903** |
| 50 kW liquid module | two coldplates · no fans | 42,761 | **855** |
| 50 kW air module | air · 4 fans | 40,688 | **814** |

Cost per kW falls from 30 to 40 to 50 kW because the control card, the enclosure, the AC entry and the auxiliary supply are
shared content that does not grow with power. The two 50 kW twins share their electronics; the air twin is the cost headline,
and the liquid twin carries the sealed, fan-free reliability case, with its cooling loop provided at the charger level.

## Per-module BOM pages

Each module has its own generated page — cost by schematic section, the parts that make that SKU different, every line item and
its sourcing status.

| Module | ₹ @10k | China target | 1k · 5k · 100 pcs | Lines | Page |
|---|---:|---:|---|---:|---|
| 30 kW module | **31,613** | 25,924 | 38,931 · 34,763 · 50,543 | 158 | [bom-30kw.md](bom-30kw.md) |
| 40 kW module | **36,103** | 29,524 | 44,435 · 39,643 · 57,828 | 173 | [bom-40kw.md](bom-40kw.md) |
| 50 kW liquid module | **42,761** | 35,023 | 52,491 · 46,884 · 68,093 | 177 | [bom-50kw.md](bom-50kw.md) |
| 50 kW air module | **40,688** | 33,243 | 50,111 · 44,670 · 65,363 | 179 | [bom-50kwa.md](bom-50kwa.md) |

## Red-line closure levers (10k basis)

> [!TIP]
> The generic volume break is already inside the 10k column, so no "5k break" lever is counted twice.

| Lever | Δ 30 kW module | Δ 50 kW module (est.) | Condition |
|---|---:|---:|---|
| Magnetics winder RFQ below target (choke / transformer 10k prices) | −₹880 | −₹970 | quotes at committed volume |
| AC-DC board 4-layer (control zones only need 4) | −₹240 | −₹260 | layout phase confirms |
| Relay direct RFQ (Hongfa annual frame) | −₹400 | −₹520 | volume agreement |
| Fuse → MCB-coordinated external protection (charger-level) | −₹215 | −₹350 | system integrator accepts |
| Drive clone — gate-drive transformers on the LLC, opto PFC drivers on aux-winding bias, bridge shunt comparator (approved, not executed) | −₹400 [est] | −₹470 [est] | GDT design, D4 re-wind, new trip evidence |
| 900 V half-link aux flyback · 90 A relays · 500 VAC fuses | −₹450 [est] | −₹450 [est] | D4 redesign + midpoint duty; relay carry at 89 % vs the 80 % rule |
| Gate-bias module second source (requalification planned) | −₹135 | −₹135 | requalified sample |
| **Sum of open levers** | **−₹2,720** | **−₹3,155** | |

The benchmark-derived rows come from the [InfyPower teardown benchmark](benchmark-infypower-teardown.md) gap audit; the
deliberate philosophy premium (protection, sensing, relay class) is priced there and is **not** on this table — spending
it down is a product decision, not a lever.

Architecture-level options not taken without a directive (each changes the product): LV/HV fixed variants that delete
the S/P matrix (−₹3k+ at 30 kW, collapses the single 150–1000 V SKU), 750 V-class secondary diodes (−₹0.8k, thins the
blocking-voltage margin), and reversing the sandwich stack-up (−₹1.45k, against the two-board arrangement the product is built on).
Stretch targets remain a management flag.

## Architecture cost drivers (recorded)

| Decision | Cost effect |
|---|---|
| Two-board sandwich | +1 PCB, studs and harness — ≈ +₹1,450 per module at 30 kW |
| HMI (2 buttons + 2-digit display + driver) | ≈ +₹45 |
| Output blocking diode DOUT instead of an output contactor and its matched-voltage make | ≈ ₹800 of relay content removed at 30 kW; DOUT ₹336–496 @10k added |
| Line CTs instead of shunt + isolated-amplifier phase sensing | −₹240 net at 30 kW |

---

<div align="center">
<sub><a href="../spice/README.md">← SPICE Simulation Suites</a> &nbsp;·&nbsp; <a href="README.md">🧭 Documentation hub</a> &nbsp;·&nbsp; <a href="bom-30kw.md">30 kW Module BOM →</a></sub>

<sub>Vectivolt DC-Modules · documentation rev E85 · every number reproduces with <code>sh calculations/run-all.sh</code></sub>
</div>
