vectivolt/DC-Modules/docs/reference/st-stdes-30kwvrect/stdes-30kwvrect-bom.txt

                                                                                                           STDES-30KWVRECT

                                                                                                                             Bill of materials

                                                    Table 1. STDES-30KWVRECT bill of materials

 Item    Q.ty                           Ref.                          Part/value    Description    Manufacturer                 Order code

 1       1       Table 2. Power board bill of materials              -             Power board     ST                Not available for separate sale
 2       1       Table 3. Control board bill of materials            -             Control board   ST                Not available for separate sale

                                                          Table 2. Power board bill of materials

      Item              Qty.              Ref.              Part/value             Description          Manufacturer               Order code

                                    C1,C2,C7,C
                                    8,C13,C15,C
                                    20,C24,C29,
                                    C33,C34,C3
                                    8,C42,C45,C
                                    52,C58,C63,
                                                1uF,0603 (1608                                     Wurth Electronics
 1                32                C97,C102,C                                Ceramic capacitor                           885012206076
                                                Metric),25V,10%                                    Inc.
                                    106,C108,C1
                                    10,C115,C11
                                    9,C126,C147
                                    ,C153,C175,
                                    C181,C235,
                                    C236,C237
                                    C3,C4,C9,C
                                    10,C14,C16,
                                    C19,C23,C2
                                    5,C27,C28,C
                                    30,C31,C35,
                                    C36,C37,C4
                                    0,C43,C44,C
                                    47,C48,C49,
                                    C51,C54,C5
                                    5,C57,C59,C
                                                0.1uF,0603 (1608                                   Wurth Electronics
 2                51                61,C62,C64,                               Ceramic capacitor                           885012206046
                                                Metric),16V,10%                                    Inc.
                                    C65,C66,C9
                                    3,C95,C98,C
                                    100,C101,C1
                                    04,C107,C10
                                    9,C111,C113
                                    ,C114,C116,
                                    C120,C127,
                                    C148,C154,
                                    C176,C182,
                                    C238
                                    C26,C46,C6
                                                4.7uF,0805 (2012
 3                7                 0,C92,C94,C                               Ceramic capacitor    TDK Corporation        C2012X5R1E475K125AB
                                                Metric),25V,10%
                                    99,C112
                                    C68,C70,C7
                                    3,C75,C76,C
                                                0.47uF,0805 (2012
 4                12                78,C137,C14                               Ceramic capacitor    AVX Corporation        08055C474KAT2A
                                                Metric),50V,10%
                                    2,C164,C166
                                    ,C192,C194
                                    C69,C71,C7
                                                10uF,0805 (2012
 5                7                 2,C74,C77,C                               Ceramic capacitor    Taiyo Yuden            GMK212BBJ106KG-T
                                                Metric),35V,10%
                                    79

STDES-30KWVRECT - Rev 1 - April 2022                                                                                                          www.st.com
For further information contact your local STMicroelectronics sales office.

                                                                                                      STDES-30KWVRECT

     Item         Qty.       Ref.           Part/value           Description        Manufacturer             Order code

                          C133,C134,                                             Samsung Electro-
                                       220pF,0603 (1608
6            7            C161,C162,                         Ceramic capacitor   Mechanics America,    CL10B221KB8NNNC
                                       Metric),50V,10%
                          C189,C190                                              Inc.
                          C124,C132,
                          C139,C145,
                          C152,C158,
                                       0.1uF,0603 (1608                          Wurth Electronics
7            15           C169,C172,                         Ceramic capacitor                         885012206095
                                       Metric),50V,10%                           Inc.
                          C180,C186,
                          C197,C200,
                          C282,C283
                          C121,C128,
                                       1nF,0603 (1608                            Samsung Electro-
8            6            C149,C155,                         Ceramic capacitor                         CL10B102KA8NNNC
                                       Metric),25V,10%                           Mechanics
                          C177,C183
                          C122,C130,
                          C135,C136,
                          C141,C143,
                          C150,C156,
                                       2.2uF,0805 (2012
9            18           C163,C165,                         Ceramic capacitor   TDK Corporation       C2012X7R1H225K125AC
                                       Metric),50V,10%
                          C167,C170,
                          C178,C184,
                          C191,C193,
                          C195,C198
                          C123,C131,
                          C138,C144,
                          C151,C157,   1000pF,0603 (1608
10           12                                              Ceramic capacitor   AVX Corporation       06035C102KAT2A
                          C168,C171,   Metric),50V,10%
                          C179,C185,
                          C196,C199
                          C203,C204,
                                       4.7nF,Radial, Disc,
11           6            C205,C253,                         Ceramic capacitor   KEMET                 ERK610Z472MCRU
                                       440VAC Y5U
                          C254,C255
                          C206,C207,
                                       3.3uF,Radial,
12           6            C208,C209,                         Film capacitor      FARA                  C42Q2335MBBC000
                                       Disc,305VAC,20%
                          C210,C211
                          C215,C216,   1uF,Radial,
13           3                                               Film capacitor      FARA                  C42Q2105K9SC000
                          C217         Disc,305VAC,20%
                                       100nF,Radial,
14           1            C218                               Film capacitor      KEMET                 R474N310050A1K
                                       Disc,1KVDC,10%
                          C219,C224,
                          C225,C228,
                          C229,C230,   4700pF, 1206 (3216
15           12                                              Ceramic capacitor   TDK Corporation       CGA5F4C0G2J472J085AA
                          C264,C265,   Metric), 630V C0G
                          C266,C267,
                          C268,C269
                          C239,C243,
                          C244,C245,   680uF,Radial, Can -   Alum-electrolytic
16           8                                                                   EPCOS (TDK)           B43601A5687M000
                          C246,C247,   Snap-In,450V,20%      capacitor
                          C259,C260
                          C248,C249,   100nF,Radial,
17           3                                               Ceramic capacitor   KEMET                 ERK610Z472MCRU
                          C250         Disc,440VAC Y5U
                          C256,C257,   0.33uF,Radial,305V
18           3                                               Film capacitor      EPCOS (TDK)           B32922C3334M000
                          C258         AC,20%
                          C270,C271,
                          C272,C273,
                                       220pF,1206
                          C274,C275,
19           12                        (3216 Metric),1KV     Ceramic capacitor   Murata Electronics    GRM31A5C3A221JW01D
                          C276,C277,
                                       C0G/NP0
                          C278,C279,
                          C280,C281

STDES-30KWVRECT - Rev 1                                                                                                   page 2/15

                                                                                                     STDES-30KWVRECT

     Item         Qty.          Ref.       Part/value          Description            Manufacturer             Order code

                                     CONV DC/DC
                          DC1,DC2,D 2W ,0.77" L x 0.39"
                                                           DC/DC Converter,
20           6            C3,DC4,DC5 W x 0.49" H                                Recom Power           R12P22005D
                                                           12VIN +20/-5VOUT
                          ,DC6       (19.5mm x 9.8mm x
                                     12.5mm)
                                                           1200 V, 40 A high
                          D1,D2,D3,D   STPSC40H12CWL,      surge silicon carbide
21           6                                                                   ST                   STPSC40H12CWL
                          4,D5,D6      TO-247 long leads   power Schottky
                                                           diode
                          D8,D9,D11,D
                          12,D13,D14,
                          D16,D17,D2
                          2,D23,D25,D SMD,0805 (2012
22           22                                            Green Leds           Lite-On Inc.          LTST-C171GKT
                          26,D27,D28, Metric)
                          D29,D30,D3
                          1,D32,D33,D
                          34,D41,D42
                                                           30 V, 1 A low
                          D35,D36,D4
23           4                         STPS1L30A, SMA      drop power Schottky ST                     STPS1L30A
                          5,D46
                                                           rectifier
                          FB1,FB2,FB
                          3,L4,FB4,L5,
                          FB5,L6,FB6,
                          L7,FB7,FB8,
                          L9,FB9,FB10
                          ,L11,FB11,F
                          B12,FB13,F
                          B14,FB15,F
                          B16,FB17,F
                          B18,FB19,F
                          B20,FB21,F
                          B22,FB23,F
24           53                        Bead,0805,30Ohm     Ferrite beads        TDK Corporation       MPZ2012S300AT000
                          B24,FB25,F
                          B26,FB27,F
                          B28,FB29,F
                          B30,FB31,F
                          B32,FB33,F
                          B34,FB35,F
                          B36,FB37,F
                          B38,FB39,F
                          B40,FB41,F
                          B42,FB43,F
                          B44,FB45,F
                          B46,FB47
                                       PFB0812DHE,12v,3.
25           2            Fan1,Fan2                      FAN                    Delta                 PFB0812DHE
                                       3a
                                       50A 400VAC, 15mm
26           3            F1,F2,F3                         Fuse                 Eaton                 C14G50
                                       x 51mm
                          HS1,HS2,HS TO-247,130mm x
27           3                                             Heatsink             -                     -
                          3          50mm x 18mm
                                      CONN TERM
                          JP5,JP12,JP
28           3                        BLOCK 2POS           Connector            Phoenix Contact       1715721
                          13
                                      5.08mm
                                       Switch,SPDT,500mA
                                       ,12V,10mmx2.5mm, Straight mini slide     Wurth Electronics
29           3            J1,J2,J3                                                                    450301014042
                                       opposite side     switch                 Inc.
                                       connect
                                       CON32x2, R/A        Digital power
30           1            J12                                                   Erni                  284166
                                       64POS 2.54 mm,      connector

STDES-30KWVRECT - Rev 1                                                                                                     page 3/15

                                                                                                      STDES-30KWVRECT

     Item         Qty.        Ref.          Part/value          Description            Manufacturer            Order code

                                        Relay,power
31           2            K2,K4         latching,           Relay                 TE Connectivity        EW60-1A3C
                                        60A,277VAC
                                                            Three-phase CM        VACUUMSCHMELZ
32           2            LCM1,LCM2     T60405-S6123-X140                                                T60405-S6123-X140
                                                            chock                 E
33           3            L1,L2,L3      AGP4233-332ME       DM inductor           Coilcraft              AGP4233-332ME
                                        ARLDC724676C271
34           3            L13,L14,L15                   PFC inductor              Sunloard               ARLDC724676C271N1B
                                        N1B
                          P3,P4,P5,P6
                                      PowerCon,9mmx
35           8            ,P8,P9,P10,                       Power connector       Wurth                  7460408
                                      9.5mmx 3.5mm, M5
                          P11
                                                            Silicon carbide
                          Q1,Q2,Q3,Q
                                                            power MOSFET
                          4,Q5,Q6,Q7,   SCTWA90N65G2V-
36           12                                             650 V, 18 mOhm        ST                     SCTWA90N65G2V-4
                          Q8,Q9,Q10,    4, HiP247-4
                                                            typ., 119 A in an
                          Q11,Q12
                                                            HiP247-4 package
                          Q14,Q15,Q1
                          8,Q19,Q22,                        Low voltage fast-
37           12           Q23,Q26,Q2    2STF1360, SOT-89    switching NPN         ST                     2STF1360
                          7,Q30,Q31,                        power transistor
                          Q34,Q35
                          Q16,Q17,Q2
                          0,Q21,Q24,                        Low voltage high
38           12           Q25,Q28,Q2    2STF2550, SOT-89    performance PNP       ST                     2STF2550
                          9,Q32,Q33,                        power transistor
                          Q36,Q37
                                                            N-channel 20 V, 30
                                                            mOhm typ., 6 A, 2.7
39           2            Q38,Q41       STS6NF20V, SO-8     V drive STripFET II   ST                     STS6NF20V
                                                            power MOSFET in
                                                            an SO-8 package
                                                            P-channel 30 V,
                                                            0.048 Ohm typ.,
                                        STR2P3LLH6,
40           2            Q42,Q43                           2 A STripFET H6       ST                     STR2P3LLH6
                                        SOT-23
                                                            power MOSFET in a
                                                            SOT-23 package
                                        B59451C1130B070,
41           2            RT1,RT2                           PTC thermistors       TDK Electronics Inc.   B59451C1130B070
                                        ±25%
                          RV1,RV2,RV S20k625, DISC
42           3                                              Varistor              EPCOS (TDK)            B72220S0621K101
                          3          14mm,625V,6.5KA
                          Rled1,Rled2,
                          Rled4,Rled5,
                          R136,R151,
                          R158,R160, 1k,0603 (1608
43           16                                             Resistor              Yageo                  RC0603FR-071KL
                          R162,R178, Metric),1/10W,1%
                          R179,R187,
                          R189,R204,
                          R205,R246
                                                                                  Panasonic
                          R1,R6,R7,R    3.3k,0603 (1608
44           6                                              Resistor              Electronic             ERA-3AEB332V
                          12,R13,R18    Metric),1/10W,1%
                                                                                  Components
                          R2,R5,R8,R
                          11,R14,R17,   5.1k,0603 (1608
45           8                                              Resistor              Yageo                  RC0603FR-075K1L
                          R103,R104,    Metric),1/10W,1%
                          R76
                          R3,R9,R15,    0,0603 (1608
46           21                                             Resistor              Yageo                  RC0603JR-070RL
                          R19,R20,R2    Metric),1/10W,1%

STDES-30KWVRECT - Rev 1                                                                                                     page 4/15

                                                                                                STDES-30KWVRECT

     Item         Qty.          Ref.        Part/value           Description     Manufacturer          Order code
                          1,R25,R34,R
                          41,R42,R43,
                          R47,R57,R6
                          6,R67,R68,R
                          72,R84,R105
                          ,R116,R129
                          R22,R44,R6    36k,0603 (1608
47           3                                               Resistor          Yageo             RC0603BR-0736KL
                          9             Metric),1/10W,0.1%
                          R23,R45,R7    27k,0603 (1608
48           3                                               Resistor          Yageo             RT0603BRE0727KL
                          0             Metric),1/10W,0.1%
                          R24,R46,R7    69.8k,0603 (1608
49           3                                               Resistor          Yageo             RT0603BRE0769K8L
                          1             Metric),1/10W,0.1%
                          R26,R48,R7    13.3k,0603 (1608
50           3                                               Resistor          Yageo             RT0603BRE0713K3L
                          4             Metric),1/10W,0.1%
                          R27,R28,R3
                          0,R49,R50,R
                          53,R75,R77,
                                      1M,1206 (3216
51           15           R80,R109,R                         Resistor          Yageo             RT1206FRE071ML
                                      Metric),1/4W,1%
                          110,R112,R1
                          22,R123,R12
                          5
                          R29,R38,R5
                          2,R60,R78,R
                          79,R88,R230
                                      10k,0603 (1608
52           16           ,R231,R235,                        Resistor          Yageo             RC0603FR-0710KL
                                      Metric),1/10W,1%
                          R236,R239,
                          R240,R242,
                          R243
                          R32,R40,R5
                                      12.4k,0603 (1608
53           6            5,R64,R82,R                        Resistor          Yageo             RT0603FRE0712K4L
                                      Metric),1/10W,1%
                          90
                          R35,R39,R5
                                      2k,0603 (1608
54           6            8,R62,R85,R                        Resistor          Yageo             RC0603FR-072KL
                                      Metric),1/10W,1%
                          89
                                        470,0603 (1608
55           1            R73                                Resistor          Yageo             RC0603FR-07470RL
                                        Metric),1/10W,1%
                          R91,R92,R9    750,0603 (1608
56           4                                               Resistor          Yageo             RC0603FR-07750RL
                          3,R94         Metric),1/10W,1%
                                        27K,0603 (1608
57           4            R102,R108                          Resistor          Yageo             RC0603FR-0727KL
                                        Metric),1/10W,1%
                          R111,R121,R 16.9k,0603 (1608
58           4                                               Resistor          Yageo             RT0603BRE0716K9L
                          124,R134    Metric),1/10W,0.1%
                          R114,R119,R 10.5k,0603 (1608
59           4                                               Resistor          Yageo             RT0603BRE0710K5L
                          127,R132    Metric),1/10W,0.1%
                          R117,R120,    1.6k,0603 (1608
60           4                                               Resistor          Yageo             RC0603FR-071K6L
                          R130,R133     Metric),1/10W,1%
                          R135,R137,
                          R139,R140,
                          R150,R153,
                          R154,R156,
                          R161,R163,    5.1,1210 (3225
61           24                                              Resistor          Yageo             RC1210FR-075R1L
                          R164,R166,    Metric),1/2W,1%
                          R176,R177,
                          R182,R183,
                          R186,R188,
                          R191,R193,

STDES-30KWVRECT - Rev 1                                                                                             page 5/15

                                                                                              STDES-30KWVRECT

     Item         Qty.       Ref.          Part/value          Description     Manufacturer          Order code
                          R202,R203,
                          R208,R209
                          R138,R141,
                          R152,R155,
                          R165,R167,   47k,1206 (3216
62           12                                            Resistor          Yageo             RC1206FR-0747KL
                          R180,R181,   Metric),1/4W,1%
                          R190,R192,
                          R206,R207
                          R142,R146,
                                       100,0603 (1608
63           6            R169,R171,                       Resistor          Yageo             AT0603FRE07100RL
                                       Metric),1/10W,1%
                          R195,R197
                          R143,R147,
                                       220,1210 (3225
64           6            R170,R172,                       Resistor          Yageo             RC1210FR-07220RL
                                       Metric),1/2W,1%
                          R196,R198
                          R144,R148,
                          R157,R159,
                          R168,R173,   2,1206 (3216
65           12                                            Resistor          Yageo             RC1206FR-072RL
                          R184,R185,   Metric),1/4W,1%
                          R194,R199,
                          R210,R211
                          R212,R213,   1k,0603 (1608                         Yageo
66           4                                             Resistor                            RC0603FR-071KL
                          R219,R221    Metric),1/10W,1%                      RC0603FR-071KL
                                       20,0603 (1608
67           2            R215,R216                        Resistor          Yageo             RC0603FR-0720RL
                                       Metric),1/10W,1%
                          R218,R220,   33K,0603 (1608
68           3                                             Resistor          Yageo             RC0603FR-0733KL
                          R306         Metric),1/10W,1%
                          R224,R225,                                         Panasonic
                                       180K,1206 (3216
69           6            R226,R227,                       Resistor          Electronic        ERA-8AEB184V
                                       Metric),1/4W,0.1%
                          R228,R229                                          Components
                                       560k,0603 (1608
70           1            R248                             Resistor          Yageo             RT0603FRE07560KL
                                       Metric),1/10W,1%
                          R258,R259,
                          R260,R261,
                          R262,R263,
                          R264,R265,
                          R266,R267,
                          R268,R269,
                          R270,R271,
                          R272,R273,
                          R274,R275,   390K,1206 (3216
71           36                                            Resistor          Yageo             RC1206FR-07390KL
                          R276,R277,   Metric),1/4W,1%
                          R278,R279,
                          R280,R281,
                          R282,R283,
                          R284,R285,
                          R286,R287,
                          R288,R289,
                          R290,R291,
                          R292,R293
                          R294,R295,
                          R296,R297,
                          R298,R299,   10,1206 (3216
72           12                                            Resistor          Yageo             RT1206BRD0710RL
                          R300,R301,   Metric),1/4W,0.1%
                          R302,R303,
                          R304,R305
                                       330,0805 (2012
73           1            R307                             Resistor          Susumu            RG2012L-331-L-T05
                                       Metric),1/10W,0.01%

STDES-30KWVRECT - Rev 1                                                                                           page 6/15

                                                                                                      STDES-30KWVRECT

     Item         Qty.       Ref.           Part/value          Description            Manufacturer           Order code

                          TP1,TP2,TP
                          3,TP5,TP6,T
                          P8,TP9,TP1
                          0,TP11,TP12
                          ,TP13,TP14,
                          TP15,TP16,
                          TP19,TP22,
                          TP23,TP26,
                          TP27,TP28,
                          TP30,TP31,
                          TP32,TP33,
                          TP34,TP35,
                          TP38,TP39,
                          TP40,TP41,
                          TP42,TP43,
                          TP44,TP45,
                          TP46,TP47,
                          TP48,TP49,
                          TP50,TP51,
                                      Test_point,0.100"
                          TP52,TP53,                                              Keystone
74           82                       Dia x 0.180" L        Test point                                 5000
                          TP54,TP55,                                              Electronics
                                      (2.54mm x 4.57mm)
                          TP56,TP57,
                          TP58,TP59,
                          TP60,TP61,
                          TP62,TP63,
                          TP64,TP65,
                          TP66,TP67,
                          TP68,TP69,
                          TP70,TP71,
                          TP72,TP73,
                          TP74,TP75,
                          TP76,TP77,
                          TP78,TP79,
                          TP80,TP81,
                          TP82,TP83,
                          TP84,TP85,
                          TP86,TP87,
                          TP88,TP89,
                          TP90,TP91,
                          TP92,TP93
                          TW1,TW2,T
                          W3,TW4,TW
                          5,TW6,TW7,                        PCB support M3
75           12                      Support M3X40                                Essentra             TCBN-T1-M3-8-40
                          TW8,TW9,T                         High 40mm
                          W10,TW11,T
                          W12
                          U1,U3,U5,U
76           4                          LAS 50-TP           Current Hall sensor   LEM                  LAS 50-TP
                          23
                                                            Wide-bandwidth (8
                          U2,U4,U6,U                        MHz) rail to rail
77           9            7,U11,U14,U   TSV912IDT, SO-8     input/output 5 V      ST                   TSV912IDT
                          24,U26,U29                        CMOS op-amps,
                                                            dual
                                                            Wide-bandwidth (8
                                                            MHz) rail to rail
78           3            U8,U12,U15    TSV914IDT, SO-14    input/output 5 V      ST                   TSV914IDT
                                                            CMOS op-amps,
                                                            quad
                                      AMC1301DWVR,8-
                          U9,U13,U17,
79           5                        SOIC (0.295",         IC amplifier          Texas Instruments    AMC1301DWVR
                          U25,U28
                                      7.50mm Width)
                                        DCH010505SN7,7- DC/DC
80           2            U10,U27                                                 Texas Instruments    DCH010505SN7
                                        SIP Module, 4 Leads Converter,5V,1W

STDES-30KWVRECT - Rev 1                                                                                                    page 7/15

                                                                                                      STDES-30KWVRECT

     Item         Qty.          Ref.       Part/value          Description            Manufacturer           Order code

                                                           Analog temperature
                                       STLM20W87F,         sensor, ultra-low
81           1            U16                                                    ST                    STLM20W87F
                                       SOT323-5L           current 2.4 V, high
                                                           precision
                                                           800 mA fixed and
                                       LD29080DT50R,       adjustable output
82           2            U18,U20                                                ST                    LD29080DT50R
                                       DPAK                very low drop
                                                           voltage regulator
                                                           800 mA fixed and
                                       LD29080S33R,        adjustable output
83           2            U19,U21                                                ST                    LD29080S33R
                                       SOT-223             very low drop
                                                           voltage regulator
                                                       Galvanically isolated
                          U30,U31,U3
                                      STGAP2SICS, SO 8 4 A single gate
84           6            2,U33,U34,U                                        ST                        STGAP2SICS
                                      WIDE 300         driver for SiC
                          35
                                                       MOSFETs

                                         Table 3. Control board bill of materials

     Item         Qty.          Ref.       Part/value          Description            Manufacturer           Order code

                                       Jtag_SWD_Adapter,
                                                           10 Way, 2 Row,
1            1            CN56         10 Way, 2                                 -                     -
                                                           Vertical Pin Header
                                       Row,1.27mm
                          C1,C3,C5,C
                          6,C7,C10,C2
                          8,C34,C36,C
                          37,C45,C48,
                                      100nF,0603 (1608
2            23           C49,C51,C5                       Ceramic capacitor     Wurth                 885012206046
                                      Metric),16V,10%
                          2,C53,C55,C
                          59,C61,C62,
                          C65,C66,C1
                          34
                          C2,C27,C35,
                                      1uF,0603 (1608
3            7            C47,C50,C5                       Ceramic capacitor     Wurth                 885012206076
                                      Metric),25V,10%
                          8,C64
                          C11,C12,C1
                          3,C14,C20,C
                          21,C22,C24,
                                      100pF,0603 (1608
4            17           C30,C31,C3                       Ceramic capacitor     Wurth                 885012006057
                                      Metric),50V,10%
                          2,C33,C38,C
                          40,C42,C43,
                          C140
                          C15,C23,C1   220nF,0603 (1608
5            3                                             Ceramic capacitor     TDK                   CGA3E3X7R1H224K080AE
                          35           Metric),50V,10%
                                       470nF,0603 (1608
6            1            C18                              Ceramic capacitor     Wurth                 885012207102
                                       Metric),50V,10%
                                       220pF,0603 (1608
7            1            C29                              Ceramic capacitor     Wurth                 885012206079
                                       Metric),50V,10%
                                                                                 Samsung Electro-
                                       10uF,0805 (2012
8            1            C133                             Ceramic capacitor     Mechanics America,    CL21A106KAYNNNG
                                       Metric),25V,10%
                                                                                 Inc.
                          C137,C138,   47nF,0603 (1608
9            3                                             Ceramic capacitor     Murata Electronics    GCM188R71H473KA55D
                          C139         Metric),50V,10%
                          D2,D4,D5,D
                                      Green,SMD,0805
10           7            9,D12,D13,D                      Green LED diode       Wurth                 150080GS75000
                                      (2012 Metric)
                          15
11           2            D3,D10       SMAJ5.0A-TR, SMA 400 W TVS in SMA         ST                    SMAJ5.0A-TR

STDES-30KWVRECT - Rev 1                                                                                                   page 8/15

                                                                                                   STDES-30KWVRECT

     Item         Qty.          Ref.       Part/value          Description          Manufacturer             Order code

                                       Red,SMD,0805
12           1            D7                               Red LED diode         Wurth              150080RS75000
                                       (2012 Metric)
                          F1,F2,F3,F4, Bead,0805 (2012
13           5                                             Ferrite Bead          Wurth              742792021
                          F5           Metric),30Ohm
                                       Solder Jumper       Solder Jumper
14           2            JP1,JP7                                                ANY                ANY
                                       Selector            Selector
                                       Solder Jumper       Solder Jumper
15           1            JP2                                                    ANY                ANY
                                       Selector            Selector
                                       4 Way, 1
16           1            J1           Row, Straight Pin   Straight Pin Header   Wurth              61300411121
                                       Header,2.54mm
                                       4 Way, 1
17           1            J2           Row, Straight Pin   Straight Pin Header   Wurth              61300411121
                                       Header,2.54mm
                                       4 Way, 1
18           1            J3           Row, Straight Pin   Straight Pin Header   Wurth              61300411121
                                       Header,2.54mm
                                       Green &
                                                           Green and red LED
19           1            LED1         Red,SMD,0805                              OSRAM              LSG T676
                                                           PLCC
                                       (2012 Metric)
                                       Bead,0603 (1608
20           1            L1                               Ferrite bead          WE                 74279262
                                       Metric),120Ohm
                                       CON32x2, R/A
                                                           Digital power
21           1            P1           64POS 2.54                                ERNI               533406
                                                           connector
                                       mm,male
                          R2,R4,R10,
                          R13,R16,R1 390,0603 (1608
22           9                                             Resistors             Yageo              RC0603FR-07390RL
                          9,R128,R129 Metric),1/10W,1%
                          ,R130
                          R5,R8,R23,
                                       10k,0603 (1608
23           7            R30,R35,R4                       Resistors             Yageo              RC0603FR-0710KL
                                       Metric),1/10W,1%
                          4,R125
                          R17,R39,R4
                          5,R46,R50,R 1k,0603 (1608
24           10                                            Resistors             Yageo              RC0603FR-071KL
                          51,R53,R56, Metric),1/10W,1%
                          R131,R133
                          R126,R127,   0,0603 (1608
25           4                                             Resistors             Yageo              RC0603JR-070RL
                          R134,R135    Metric),1/10W,1%
                                       SWITCH TACTILE
26           2            S1,S2        SPST-NO 0.05A       Tactile SPST switch   TE Connectivity    FSM4JSMATR
                                       24V
                          TP1,TP2,TP
                          3,TP4,TP5,T
                          P6,TP7,TP8,
                          TP9,TP10,T
                          P11,TP12,TP
                          13,TP14,TP1                                            Keystone
27           26                       TestPoint            TestPoint                                5001
                          5,TP16,TP17                                            Electronics
                          ,TP18,TP19,
                          TP20,TP21,
                          TP22,TP24,
                          TP25,TP26,
                          TP27
                                       Micro USB 2.0
28           1            USB2                             Micro USB 2.0         MOLEX              47346-0001
                                       Molex tipo B

STDES-30KWVRECT - Rev 1                                                                                                   page 9/15

                                                                                                    STDES-30KWVRECT

     Item        Qty.           Ref.       Part/value          Description           Manufacturer          Order code

                                                           Wide-bandwidth (8
                                                           MHz) rail to rail
                          U2,U5,U6,U
29           5                         TSV912IDT, SO-8     input/output 5 V     ST                   TSV912IDT
                          9,U10
                                                           CMOS op-amps,
                                                           dual
                                                           800 mA fixed and
                                       LD29080S33R,        adjustable output
30           1            U3                                                    ST                   LD29080S33R
                                       SOT-223             very low drop
                                                           voltage regulator
                                       ESDA6V1,            Dual Transil array
31           1            U22                                                   ST                   ESDA6V1L
                                       SOT23-3L            for ESD protection
                                                           Mainstream Arm®
                                                           Cortex®-M4 MCU
                                                           170 MHz with
                                       STM32G474RET3,
                                                           512 Kbytes of
32           1            U23          LQFP 64 10x10x1.4                        ST                   STM32G474RET3
                                                           flash memory, math
                                       mm
                                                           accelerator, HR
                                                           timer, high analog
                                                           level integration

STDES-30KWVRECT - Rev 1                                                                                              page 10/15

                                                                                                      STDES-30KWVRECT

Evaluation board license agreement
Important:   All information on this document is subject to this Evaluation Board License Agreement.

             By using this evaluation board or kit (together with all related software, firmware, components, and documentation
             provided by ST, “Evaluation Board”), You (“You”) are agreeing to be bound by the terms and conditions of this
             Evaluation Board License Agreement (“Agreement”). Do not use the Evaluation Board until You have read and
             agreed to this Agreement. Your use of the Evaluation Board constitutes Your acceptance of this Agreement.

             LICENSE
             STMicroelectronics (“ST”) grants You the right to use the enclosed Evaluation Board offering limited features only
             to evaluate and test ST products solely for Your evaluation and testing purposes in a research and development
             setting. The Evaluation Board shall not be, in any case, directly or indirectly assembled as a part in any
             production of Yours as it is solely developed to serve evaluation purposes and has no direct function and is
             not a finished product. If software and/or firmware is accompanied by a separate end user license agreement
             (“EULA”), then such software and/or firmware shall be governed by such EULA.

             EVALUATION BOARD STATUS
             The Evaluation Board offers limited features allowing You only to evaluate and test the ST products. The
             Evaluation Board is not intended for consumer or household use. You are not authorized to use the Evaluation
             Board in any production system, and it may not be offered for sale or lease, or sold, leased or otherwise
             distributed for commercial purposes. If the Evaluation Board is incorporated in an evaluation system, the
             evaluation system may be used by You solely for Your evaluation and testing purposes. Such evaluation system
             may not be offered for sale or lease or sold, leased or otherwise distributed for commercial purposes and must be
             accompanied by a conspicuous notice as follows: “This device is not, and may not be, offered for sale or lease, or
             sold or leased or otherwise distributed for commercial purposes”.

             OWNERSHIP AND COPYRIGHT
             Title to the Evaluation Board remains with ST and/or its licensors. You may not remove any copyright or other
             proprietary rights notices without prior written authorization from ST. You may make one copy of the software
             and/or firmware of the Evaluation Board for back up or archival purposes provided that You reproduce and apply
             to such copy any copyright or other proprietary rights notices included on or embedded in the software and/or
             firmware. You agree to prevent any unauthorized copying in whole or in part of the Evaluation Board.

             RESTRICTIONS AND WARNINGS
             Before You handle or use the Evaluation Board, You must carefully review any related documentation provided
             by ST. Such documentation may contain important warnings. You shall comply with all such warnings and other
             instructions and employ reasonable safety precautions in using the Evaluation Board. Failure to do so may
             result in death, personal injury, or property damage. If You have any questions regarding the safe usage of the
             Evaluation Board, You should contact ST for guidance.
             You may not sell, assign, sublicense, lease, rent or otherwise distribute the Evaluation Board for commercial
             purposes, in whole or in part, or use Evaluation Board in a production system, with the exception that if You are
             an authorized ST distributor, You may resell the Evaluation Board in compliance with the applicable terms and
             conditions. Except as provided in this Agreement or as explicitly permitted in the documentation of the Evaluation
             Board, You may not reproduce the Evaluation Board or modify,
             reverse engineer, de-compile or disassemble its software and/or firmware, in whole or in part.
             You shall not use the Evaluation Board in any safety critical or functional safety testing, including but not limited to
             testing of life supporting, military or nuclear applications. ST expressly disclaims any responsibility for such usage
             which shall be made at Your sole risk, even if ST has been informed in writing of such usage. Unless expressly
             designated in writing by ST as suitable for use in testing automotive or aerospace applications, You shall not use
             the Evaluation Board in such testing.

STDES-30KWVRECT - Rev 1                                                                                                     page 11/15

                                                                                                  STDES-30KWVRECT

             Notice applicable to Evaluation Boards according to European Regulation
             For the European Regulation of the Evaluation Board, the applicable EU directives are considered, with a
             particular attention to the Low Voltage Directive (LVD) 2014/35/EU, the Electromagnetic Compatibility (EMC)
             Directive 2014/30/EU, and the Radio Equipment Directive (RED) 2014/53/EU. If the Evaluation Board is outside
             the scope of the foregoing Directives, then the General Product Safety Directive (GPSD) 2001/95/EC and Council
             Directive 93/68/EEC, amending Directive 73/23/EEC on electrical equipment designed for use within certain
             voltage limits, are applicable.
             The Evaluation Board meets the requirements of the Restriction of Hazardous Substances (RoHS 2 or RoHS
             recast) Directive 2011/65/EU, Annex II, as amended by Directive 2015/863/EU.

             Notice applicable to Evaluation Boards not FCC-Approved
             This kit is designed to allow:
             1.   Product developers to evaluate electronic components, circuitry, or software associated with the kit to
                  determine whether to incorporate such items in a finished product and
             2.   Software developers to write software applications for use with the end product.
             This kit is not a finished product and when assembled may not be resold or otherwise marketed unless all
             required FCC equipment authorizations are first obtained. Operation is subject to the condition that this product
             not cause harmful interference to licensed radio stations and that this product accept harmful interference. Unless
             the assembled kit is designed to operate under part 15, part 18 or part 95 of 47 CFR, Chapter I (“FCC Rules”),
             the operator of the kit must operate under the authority of an FCC license holder or must secure an experimental
             authorization under part 5 of this chapter.

             For Evaluation Boards annotated as FEDERAL COMMUNICATIONS COMMISSION (FCC) Part 15 Compliant
             •     FCC Interference Statement for Class A Evaluation Boards: This equipment has been tested and found
                   to comply with the limits for a Class A digital device, pursuant to part 15 of the FCC Rules. These limits are
                   designed to provide reasonable protection against harmful interference when the equipment is operated in
                   a commercial environment. This equipment generates, uses, and can radiate radio frequency energy and, if
                   not installed and used in accordance with the instruction manual, may cause harmful interference to radio
                   communications. Operation of this equipment in a residential area is likely to cause harmful interference in
                   which case the user will be required to correct the interference at his own expense.
             •     FCC Interference Statement for Class B Evaluation Boards: This equipment has been tested and found
                   to comply with the limits for a Class B digital device, pursuant to part 15 of the FCC Rules. These limits
                   are designed to provide reasonable protection against harmful interference in a residential installation.
                   This equipment generates, uses and can radiate radio frequency energy and, if not installed and used in
                   accordance with the instructions, may cause harmful interference to radio communications. However, there
                   is no guarantee that interference will not occur in a particular installation. If this equipment does cause
                   harmful interference to radio or television reception, which can be determined by turning the equipment off
                   and on, the user is encouraged to try to correct the interference by one or more of the following measures:
                   –     Reorient or relocate the receiving antenna.
                   –     Increase the separation between the equipment and receiver.
                   –     Connect the equipment to an outlet on a circuit different from that to which the receiver is connected.
                   –     Consult the dealer or an experienced radio/TV technician for help.
             •     This device complies with part 15 of the FCC Rules. Operation is subject to the following two conditions:
                   (1) This device may not cause harmful interference, and (2) this device must accept any interference
                   received, including interference that may cause undesired operation. Changes or modifications not expressly
                   approved by the party responsible for compliance could void the user's authority to operate the equipment.

             WARRANTY
             ST WARRANTS THAT IT HAS THE RIGHT TO PROVIDE THE EVALUATION BOARD TO YOU. THIS
             WARRANTY IS PROVIDED BY ST IN LIEU OF ALL OTHER WARRANTIES, WRITTEN OR ORAL, STATUTORY,
             EXPRESS OR IMPLIED, INCLUDING ANY WARRANTY AS TO MERCHANTABILITY, NON-INFRINGEMENT,
             FITNESS FOR ANY PARTICULAR PURPOSE, OR UNINTERRUPTED OR ERROR-FREE OPERATION, ALL OF
             WHICH ARE EXPRESSLY DISCLAIMED. THE EVALUATION BOARD IS PROVIDED “AS IS”.

STDES-30KWVRECT - Rev 1                                                                                                page 12/15

                                                                                                     STDES-30KWVRECT

             YOU WARRANT TO ST THAT YOU WILL ENSURE THE EVALUATION BOARD IS USED ONLY BY
             ELECTRONICS EXPERTS WHO UNDERSTAND THE DANGERS OF HANDLING AND USING SUCH ITEMS,
             YOU ASSUME ALL RESPONSIBILITY AND LIABILITY FOR ANY IMPROPER OR UNSAFE HANDLING OR
             USE OF THE EVALUATION BOARD BY YOU, YOUR EMPLOYEES, AFFILIATES, CONTRACTORS, AND
             DESIGNEES.

             LIMITATION OF LIABILITIES
             IN NO EVENT SHALL ST BE LIABLE TO YOU, WHETHER IN CONTRACT, TORT (INCLUDING NEGLIGENCE),
             STRICT LIABILITY, OR ANY OTHER LEGAL THEORY, FOR ANY INDIRECT, SPECIAL, CONSEQUENTIAL,
             INCIDENTAL, PUNITIVE, OR EXEMPLARY DAMAGES WITH RESPECT TO ANY MATTERS RELATING
             TO THIS AGREEMENT, REGARDLESS OF WHETHER ST HAS BEEN ADVISED OF THE POSSIBILITY
             OF THE SAME. IN NO EVENT SHALL ST’S LIABILITY ARISING OUT OF THIS AGREEMENT IN THE
             AGGREGATE EXCEED THE AMOUNT PAID BY YOU UNDER THIS AGREEMENT FOR THE PURCHASE OF
             THE EVALUATION BOARD, OR TEN UNITED STATES DOLLARS ($10.00) IF NO PURCHASE PRICE WAS
             PAID.

             INDEMNIFICATION
             You shall, at Your expense, defend ST and its Affiliates against a claim or action brought by a third party for
             infringement or misappropriation of any patent, copyright, trade secret or other intellectual property right of a third
             party to the extent resulting from (1) Your combination of the Evaluation Board with any other component, system,
             software, or firmware, (2) Your modification of the Evaluation Board, or (3) Your use of the Evaluation Board in a
             manner not permitted under this Agreement.
             You shall indemnify ST and its Affiliates against and pay any resulting costs and damages finally awarded against
             ST or its Affiliates or agreed to in any settlement, provided that You have sole control of the defense and
             settlement of the claim or action, and ST cooperates in the defense and furnishes all related evidence under its
             control at Your expense. ST will be entitled to participate in the defense of such claim or action and to employ
             counsel at its own expense.
             “Affiliates” means any corporation or other entity directly or indirectly controlled by, controlling or under common
             control with the entity in question, for so long as such ownership exists. "Control" means the direct or indirect
             beneficial ownership of more than fifty (50%) percent of the stock or other equity interests entitled to vote for the
             election of directors or an equivalent governing body. Any such corporation or other legal entity shall be deemed
             to be an Affiliate of such Party only as long as such Control exists.

             TERMINATION
             ST may terminate this Agreement without notice if You breach this Agreement. Upon termination, You shall
             immediately destroy or return all copies of the software, firmware, and documentation of the Evaluation Board to
             ST and certify in writing to ST that You have done so.

             APPLICABLE LAW AND JURISDICTION
             This Agreement shall be governed, construed and enforced in accordance with the laws of Switzerland, without
             regard to its conflict of laws rules. The UN Convention on Contracts for the International Sale of Goods shall not
             apply to this Agreement. In case of dispute and in the absence of an amicable settlement, the only competent
             jurisdiction shall be the Courts of Geneva, Switzerland. Any breach of this Agreement by You may result in
             irreparable damage to ST for which ST will not have an adequate remedy at law. Accordingly, in addition to any
             other remedies and damages available, You acknowledge and agree that ST may immediately seek enforcement
             of this Agreement in any jurisdiction by means of specific performance or injunction, without any requirement to
             post a bond or other security.

             SEVERABILITY
             If any provision of this agreement is or becomes, at any time or for any reason, unenforceable or invalid, no
             other provision of this agreement shall be affected thereby, and the remaining provisions of this agreement shall
             continue with the same force and effect as if such unenforceable or invalid provisions had not been inserted in
             this Agreement. In addition, any unenforceable or invalid provision shall be deemed replaced by a provision that is
             valid and enforceable and that comes closest to expressing the intention of the unenforceable or invalid provision.

STDES-30KWVRECT - Rev 1                                                                                                    page 13/15

                                                                                                      STDES-30KWVRECT

             WAIVER
             The waiver by either party of any breach of any provision of this Agreement shall not operate or be construed as a
             waiver of any other or a subsequent breach of the same or a different provision.

             RELATIONSHIP OF THE PARTIES
             Nothing in this Agreement shall create, or be deemed to create, any joint venture, partnership, principal-agent,
             employer-employee or other relationship between the Parties, except that of independent contractors. Neither
             Party has the authority or power to bind, to contract in the name of, or to create a liability for the other in any way
             or for any purpose.

             SURVIVAL
             Any provision of this Agreement which imposes an obligation after termination of this Agreement shall survive the
             termination of this Agreement.

             SECTION HEADINGS
             Section headings are inserted for convenience only and shall not be used to interpret this Agreement.

             WASTE AND RECYCLING
             The Evaluation Board is not to be disposed of as urban waste. At the end of its life cycle, differentiated
             waste collection must be followed. Consult the local authorities for more information on the proper disposal
             channels. It is mandatory to separately collect the Evaluation Board and make sure it is delivered it to the
             appropriate waste management and recycling centers.
             As of 15 August 2018, in all the countries belonging to the European Union, the Evaluation Board is subject to
             the WEEE Directive 2012/19/EU requirement; therefore, it is forbidden to dispose of the Evaluation Board as
             undifferentiated waste or with other domestic wastes. Consult the local authorities for more information on the
             proper recycling centers.
             Disposing of the Evaluation Board incorrectly may cause damage to the environment and may be subject to fines
             based on specific countries’ rules.

STDES-30KWVRECT - Rev 1                                                                                                     page 14/15

                                                                                                                            STDES-30KWVRECT

                                                          IMPORTANT NOTICE – READ CAREFULLY
STMicroelectronics NV and its subsidiaries (“ST”) reserve the right to make changes, corrections, enhancements, modifications, and improvements to ST
products and/or to this document at any time without notice. Purchasers should obtain the latest relevant information on ST products before placing orders. ST
products are sold pursuant to ST’s terms and conditions of sale in place at the time of order acknowledgment.
Purchasers are solely responsible for the choice, selection, and use of ST products and ST assumes no liability for application assistance or the design of
purchasers’ products.
No license, express or implied, to any intellectual property right is granted by ST herein.
Resale of ST products with provisions different from the information set forth herein shall void any warranty granted by ST for such product.
ST and the ST logo are trademarks of ST. For additional information about ST trademarks, refer to www.st.com/trademarks. All other product or service names
are the property of their respective owners.
Information in this document supersedes and replaces information previously supplied in any prior versions of this document.
                                                         © 2022 STMicroelectronics – All rights reserved

STDES-30KWVRECT - Rev 1                                                                                                                              page 15/15
