vectivolt/DC-Modules/calculations/out/bom-30kw.csv

mpn | lcsc | lcsc_status | manufacturer | description | second_source | boards | qty | unit_100 | unit_1k | unit_5k | unit_10k | ext_1k_INR | ext_10k_INR | sample_refs
IND-PFC-165u |  | CUSTOM | custom wind (docs/magnetics.md D1 rev B) | PFC choke 165 µH class, 3× OD79 26µ sendust (Magnetics 0077908A7 / Chang Sung KS eq, catalog AL 37 nH/T² ±8%), N=39, 9× 1.6 mm enamelled bundle, 18 mm² class; one end face gap-pad bonded to the PE web under an insulating clamp (d1-choke: 43 W and 87 °C hot-spot at the 330 VAC corner, 131 °C air-cooled as registered); Rdc ≤ 6.9 mΩ @25 °C. Round bundle, not flat-on-edge strip: a 6 mm dimension lying across the 50 kHz bore field loses the Rdc and L acceptance | POCO/DMEGC equiv core | acdc | 3 | 1397.3 | 1035 | 910.8 | 828 | 3105 | 2484 | LA0 LB0 LC0
GC4D20120D | C7435099 | REVIEW | SiChain | SiC JBS 1200 V 40 A-class TO-247-2, SINGLE die, 2-terminal (exact p/n at RFQ). ACCEPTANCE: IFSM ≥ 250 A (10 ms half-sine, 25 °C) — the precharge-bypass closure surge. DO NOT FIT GC4D20120D (LCSC C7435099) against this line: the manufacturer data is a TO-247-3 DUAL common-cathode die, 16.5 A/leg at Tc 135 °C, IFSM 71 A/leg — a different part in a package the drawn 2-pin land does not take. Ordering stays FROZEN until either a true 2-terminal ≥ 40 A die is selected or the position is deliberately redesigned for a dual die on a 3-pin land with sharing and surge recomputed. **PRICE RISK, NOT APPLIED:** distributor anchors for a correctly-rated single-die TO-247-2 40 A part sit far above the ₹120 @1k carried here, and 22 positions per module make this the single largest unquantified line in the BOM; RFQ round 1 closes it, and nothing else in this file assumes the ₹120 holds | BASiC B3D040120H | acdc+dcdc | 22 | 162 | 120 | 105.6 | 96 | 2640 | 2112 | DA0T DA0B DB0T DB0B DC0T DC0B D1A1 D1A1P2 D1A2 D1A2P2 D1A3 D1A3P2
XFMR-LLC-CELL-2E70-30 |  | CUSTOM | custom wind (D3 rev D cell) | D3-30 rev D: full-bridge LLC transformer CELL (2 per module, primaries in SERIES → n = 2 overall) — 2× E70/33/32 PC95-class on TDK B66372A2000, 6:6∥6 (S1–P–S2 with S1 ∥ S2 feeding one bank), Lm 28 µH per cell ±7% (distributed gap ground to AL), primary TIW-served litz 3850×0.063 mm (12 mm²), secondary halves Cu foil 0.10×28 mm; leakage 0.252 µH computed on the 28 mm conductor band (acceptance ±20 %), vacuum-impregnated, both yoke faces gap-padded to the webs, end turns potted. Envelope gate: Fe 31.9 W at 159 mT (500 V bank) · Cu 45.8 W at the 764 V-bus PSM corner · hot-spot 106 °C at 55 °C inlet. Cost roll-up [est, REVIEW at winder RFQ]: 2 × E70 set ₹160, TIW-served litz ₹2,210/kg (₹300), foil ₹1,050/kg (₹67), +10 % leads, former, insulation, shield, gap work, labour + test → ₹1,169 | any E70-capable winder | dcdc | 2 | 1578.2 | 1169 | 1028.7 | 935.2 | 2338 | 1870 | T1A T1B
ELH-470u500 |  | CLASS | Aishi | 470 µF **500 V** snap-in aluminium electrolytic, 105 °C, −40 °C category, 35 mm land (split DC link). The 500 V class is the requirement: at 500 V the worst continuous half is 435 V = 87 % and 86 % at the F.38 (430 V) / F.03 (850 V) limits, while a 450 V part runs 92 % nominal, 96 % at the 860 V OVP and 97.3–97.8 % at the F.38 boundary — above ~90 % of V_R the leakage and oxide-repair rate climb off the datasheet endurance curve. Lowering the bus instead is not available: the 830 V link is SET by the 500 V bank edge with 2.3 % of FHA gain margin (checked at Lr +5 % / Cr −5 % / Lm +7 %), so 810 V and below fail the gain, and capping LOW mode at 480 V pushes 480–500 V into HIGH with a 240–250 V bank. RFQ LINE (binding): height ≤ the drawn can, **ripple ≥ 5.2 A rms @ 100 kHz / 105 °C**, **ESR ≤ 80 mΩ @ 100 kHz**, leakage ≤ 0.5 mA per can at 85 °C/415 V graded/matched per half, endurance lot 1000 h at 438 V/105 °C on 5 samples. THE DUTY THAT LINE IS FOR: the dominant term is the **Vienna's own 50 kHz capacitor current**, not the LLC's 2·f_sw share. At 50 kHz the per-phase commutation films are 3 µF per half (1.06 Ω) against a can bank of 13–16 mΩ, so the cans take essentially all of it. Direct PWM evaluation on the firmware's own modulator (common centred carrier, min-max zero sequence) plus the LLC 2·f_sw share and the 150 Hz neutral-point term in quadrature gives **5.7 / 6.5 / 5.9 A rms per can at 400 VAC / 800 V** and **6.7 / 7.6 / 7.0 A at 340 VAC / 700 V** (30 / 40 / 50 kW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 | ChengX/Nichicon 470u/500V snap-in | acdc | 10 | 249.8 | 185 | 162.8 | 148 | 1850 | 1480 | CDT00 CDT01 CDT02 CDT03 CDT04 CDB00 CDB01 CDB02 CDB03 CDB04
SG2M023120LJ | C5713523 | SECOND-SOURCE | SiChain | SiC MOSFET 1200 V 23 mΩ TO-247-4L — full-bridge LLC switch, clip-mounted; tanks.mjs sets the dies per position (1 at 30 kW, 2 at 40 / 50 kW liquid and air — Q#H2/Q#L2). RFQ ACCEPTANCE: IDM ≥ 265 A @25 °C (the 30 kW single die carries 209 A at the F.11 kill) | BASiC B3M020120ZL | dcdc | 4 | 526.5 | 390 | 343.2 | 312 | 1560 | 1248 | Q1H Q1L Q2H Q2L
CMC-3PH-2mH-SKU |  | CUSTOM | custom/Hongfa mag | 3-phase CM choke 2 mH nanocrystalline, winding rated to the SKU line current (D7). ACCEPTANCE: L_cm ≥ 2 mH @10 kHz AND ≥ 1.0 mH @150 kHz, ≥ 80 % of it held with I_pk DM bias line-to-line, leakage 6–12 µH, A_Fe floor on the quote (L_lk,max·I_pk/(8·A_Fe) ≤ 0.6 T), ΔT ≤ 45 K on hot copper. 30 kW: qualify Schaffner RT8131-63-2M8 (63 A / 2.8 mH / 600 VAC, 3-line nanocrystalline, Digi-Key) as the catalog drop-in; the custom drawing stays the second source [D7-30 rev B: T 80/50/25, A_Fe ≥ 281 mm², 3×8 T 20 mm², 9.9 W, ΔT 20 K — second source to the Schaffner catalog part [est roll-up]] | Schaffner RT8131-63-2M8 @30 kW | acdc | 1 | 1791.5 | 1327 | 1167.8 | 1061.6 | 1327 | 1062 | CMC1
CMC-3PH-2mH-SKU |  | CUSTOM | custom/Hongfa mag | 3-phase CM choke 2 mH nanocrystalline, winding rated to the SKU line current (D7). ACCEPTANCE: L_cm ≥ 2 mH @10 kHz AND ≥ 1.0 mH @150 kHz, ≥ 80 % of it held with I_pk DM bias line-to-line, leakage 6–12 µH, A_Fe floor on the quote (L_lk,max·I_pk/(8·A_Fe) ≤ 0.6 T), ΔT ≤ 45 K on hot copper. 30 kW: qualify Schaffner RT8131-63-2M8 (63 A / 2.8 mH / 600 VAC, 3-line nanocrystalline, Digi-Key) as the catalog drop-in; the custom drawing stays the second source | Schaffner RT8131-63-2M8 @30 kW | acdc | 1 | 1791.5 | 1327 | 1167.8 | 1061.6 | 1327 | 1062 | CMC2
PP-1u-1100 |  | CLASS | Faratronic | 1 µF 1100 V film (bridge commutation at the DC-DC entry; 830 V ≤ 76 % of the class). THE COUNT IS PART OF THE SPECIFICATION — boards.tsx `nEntryFilm`, 16 or 20 per SKU. A small bank puts the films on a 268–425 kHz anti-resonance with the stud loop, inside the 280–406 kHz 2·fsw band; that is a PARALLEL anti-resonance, so the two branches circulate more current than the bridge injects — 6.5–18 A rms and 10–45 W per 470 µF can against a ≈3 A / 2 W allowance, and 21–47 A rms in a box part rated 8–12 A. Sixteen parts move the resonance to ~140 kHz and hold 2.7 A (30 kW) / 4.6 A (50 kW) per film. EVT T-43 measures it: current probe on one can and one film at PAR400-full and SER250-full, plus a 10 kHz–2 MHz VNA sweep of the link looking in from the bridge | Songtian | dcdc | 16 | 91.8 | 68 | 59.8 | 54.4 | 1088 | 870 | CF0 CF1 CF2 CF3 CF4 CF5 CF6 CF7 CF8 CF9 CF10 CF11
IND-LR-E70-30 |  | CUSTOM | custom wind (D2 rev F — GAPPED FERRITE) | D2-30 rev F: EXTERNAL resonant inductor 5.00 µH ±3% on 2× E70/33/32 PC95-class (TDK former B66372A2000), N=5, litz 8000×0.05 mm (15.7 mm²) compacted single layer ≥3 mm clear of a DISTRIBUTED centre-leg gap Σ 8.3 mm PER FLUX PATH (≤1.0 mm per segment; the two core sets are parallel paths — never sum across them; acceptance is the assembled AL, and Σ re-derives from it at the winder RFQ); vacuum-impregnated, both yoke faces gap-padded to the extrusion webs, end turns potted. Carries Lr 5.6 µH − 2 × D3 cell leakage (0.252 µH, acceptance ±20 %) − 0.1 µH loop — no trim bins. Powder cores prohibited in this slot: sendust at the full 140 kHz AC swing is a loss problem, not a cost saving. Envelope gate: 30.5 W Fe + 15.1 W Cu at the 764 V-bus PSM corner, hot-spot 95 °C at 55 °C inlet; B̂ 88 mT. Cost roll-up [est, REVIEW at winder RFQ]: 2 × E70 set ₹160, litz 0.05 mm ₹2,600/kg (₹292), +10 % leads, former, insulation, gap work, labour + test → ₹965 | any E70-capable winder (TDG/DMEGC cores) | dcdc | 1 | 1302.8 | 965 | 849.2 | 772 | 965 | 772 | L1R
PP-2u2-630 |  | CLASS | Faratronic C3D/CBB class | 2.2 µF 630 V PP film, ripple-rated (bank rectifier film: ≤ 10 A rms per part of the 30/39/49 A rms 2·fsw bridge ripple) | KEMET R76 / CDE 944U | dcdc | 18 | 60.8 | 45 | 39.6 | 36 | 810 | 648 | CFA0 CFA1 CFA2 CFA3 CFA4 CFA5 CFA6 CFA7 CFA8 CFB0 CFB1 CFB2
ISO-GBIAS-15-1W |  | CLASS | MORNSUN | isolated gate-bias module **+15 V / −3 V**, 1 W class (Vienna channels: ONE common-source pair per channel at 50 kHz = 0.33 W, so the 1 W class holds). Specified as a CLASS: reinforced isolated gate-bias module, 15 V DC in (13.5–16.5 V) against V15 ≈ 15.0 V off the regulated aux, dual output **+15 V / −3…−4 V**, ≥ 5 kVrms 1-min test, C_io ≤ 5 pF. ACCEPTANCE ROW: **+15 V ±5 % at 20–100 % of rated load, ≤ +17.5 V at 5 % load** — these modules run at ≈ 17 % load, where an unregulated open-frame part rises +10…+18 %. Packaged modules are permanent at ≥10k modules/yr: at that volume module pricing ≤ ₹55 makes a custom bias transformer worth ≈ ₹0 against added EMC and manufacturing risk. Whether the frozen switch wants +15 V or +18 V follows ITS recommended V_GS (open decision C-10) | domestic iso-module eq (2nd source at RFQ) | acdc+dcdc | 8 | 128.3 | 95 | 83.6 | 55 | 760 | 440 | PSA0G PSB0G PSC0G PSQD PS1H PS1L PS2H PS2L
RELAY-PCB-120A-24V |  | DIRECT | Hongfa HF161F / Churod CHC-D120 class | PCB power relay 120 A, 24 V coil, no mirror contact (S/P matrix, switched at ZERO current — modes change in standby with the LLC stopped; open-contact dielectric ≥ 2.5 kV holds the ≤ 500 V bank; SER 60/80 A, per-bank PAR ≤ 50/67 A at 30/40 kW) | Churod CHC-D120 | dcdc | 3 | 297 | 220 | 193.6 | 176 | 660 | 528 | KSER KPARA KPARB
NSI6611 | C7470934 | ORDERABLE | NOVOSENSE | iso gate driver 10 A, DESAT / Miller clamp (CLAMP pin wired) / UVLO, SOIC-16 | NSI6602B | acdc+dcdc | 7 | 114.8 | 85 | 74.8 | 68 | 595 | 476 | UA0G UB0G UC0G U1H U1L U2H U2L
AMC1311DWVR | C456277 | ORDERABLE | TI/NOVOSENSE | iso voltage-sense amp 0–2 V input (bus / bank / output senses). On the 1311 class the symbol's pin-3 'VINN' is physically SHTDN — grounded = enabled; the netlist is correct and the label is the shared iso-amp table's | NSI1311 class | acdc+dcdc | 5 | 155.3 | 115 | 101.2 | 92 | 575 | 460 | UIVBP UIVBM UIVOA UIVOB UIVOV
ISO5V-RFC-6K | C20613048 | REVIEW | MORNSUN QA/URB-grade | iso 15→5 V reinforced-rated module (floating bias for the isolated sense amplifiers — AC star / DCN / BKAN / BKBN). Same barrier argument as the CAN/shunt modules: the certificate class is the acceptance line, DC-use clearance is the §K item | RECOM RxxP-R / certified eq | acdc+dcdc | 6 | 128.3 | 95 | 83.6 | 65 | 570 | 390 | PS5AC PS5BUS PSSH PS5BKA PS5BKB PSCAN
X2-4u7-305 |  | CLASS | Faratronic/Songtian/Jimson | X2 4.7 µF 305 VAC MKP safety film, 27.5 mm pitch — twelve caps in three STAR stages: line side CX0x, inter-CMC CX1x, converter CX2x ×2 per phase; 274 VAC per cap at 475 VAC line-line. The star X bank IS the differential-mode filter; there are no series DM chokes to fall back on | any X2 305 VAC 4.7 µF class | acdc | 12 | 56.7 | 42 | 37 | 33.6 | 504 | 403 | CX01 CX02 CX03 CX11 CX12 CX13 CX21 CX22 CX23 CX24 CX25 CX26
PP-33n-1200V |  | CLASS | Faratronic/CDE 942C class | 33 nF 1200 V PP resonant-duty film (full-bridge tank: 7/9/11 in parallel at 30/40/50 kW → ≤ 10.3 A rms per cap of the 12 A line at the 250 V-bank full-power corner; Vcr ≤ 595 V pk = 421 V rms). RFQ line (open decision O-8): published Vrms-vs-f curve ≥ 460 V @140 kHz | CDE 942C20P33K | dcdc | 7 | 91.8 | 68 | 59.8 | 54.4 | 476 | 381 | C1R0 C1R1 C1R2 C1R3 C1R4 C1R5 C1R6
DIODE-1600V-150A-MOD |  | DIRECT | IXYS/MacMic/Yangjie class — RFQ | output series blocking diode 1600 V 150 A, insulated-base 2-terminal module — back-feed and reverse-battery proof with no output contactor and no matched-voltage make (100 A = 67 % at 30 kW; ~1.05 V × Iout, heatsink-mounted) | MacMic MDD150-16 | dcdc | 1 | 567 | 420 | 369.6 | 336 | 420 | 336 | DOUT
AMC1350QDWVRQ1 | C5214206 | ORDERABLE | TI/NOVOSENSE | iso voltage-sense amp ±5 V input (AC phase sense against the artificial star) | NSI1300 class | acdc | 3 | 182.3 | 135 | 118.8 | 108 | 405 | 324 | UIVV1 UIVV2 UIVV3
IMW120R350M1H | C536285 | ORDERABLE | CR Micro | SiC FET 1200 V 5 A (bus discharge QDISF / bank bleeders QDISA-B). GATE SPEC for the PV-driven bleeders: Vth(max) ≤ 3.5 V, Igss ≤ 100 nA. The 6.8 MΩ load-line figure (≈5.8 V after leakage) is a 25 °C-ENDPOINT MODEL, not an all-temperature guarantee — VOM1271 Voc(typ) falls to ~5.4 V at 100 °C; declared bleed-interval local ambient ≤ 70 °C, and an EVT loaded-Vgs/discharge measurement with the exact orderable FET gates the BOM freeze | BASiC small 1200V | acdc+dcdc | 3 | 162 | 120 | 105.6 | 96 | 360 | 288 | QDISF QDISA QDISB
STUD-M8 |  | CLASS | local | M8 stud terminal | M6 for signal PE | acdc+dcdc | 12 | 37.8 | 28 | 24.6 | 22.4 | 336 | 269 | JACL1 JACL2 JACL3 JPE JDCP JDCN JPEB JDCP JDCN JPEB JOUTP JOUTN
HF167F/024-HATF(764) |  | DIRECT | Hongfa | power relay ≥80 A/line with a mirror contact — the precharge bypass carries full line current (SKU class via override). §K line: contact-gap withstand and insulation group at the 475 VAC system plus the ~660 V pk precharge transient [80 A class (55 A line) · make ≥ 260 A pk at bypass closure, ≤ 70 V across the contacts, ≥ 30 000 makes] | TE T9G / contactor option | acdc | 1 | 351 | 260 | 228.8 | 208 | 260 | 208 | KPRE1
HF167F/024-HATF(764) |  | DIRECT | Hongfa | power relay ≥80 A/line with a mirror contact — the precharge bypass carries full line current (SKU class via override). §K line: contact-gap withstand and insulation group at the 475 VAC system plus the ~660 V pk precharge transient | TE T9G / contactor option | acdc | 1 | 351 | 260 | 228.8 | 208 | 260 | 208 | KPRE2
PP-4u7-1200 |  | CLASS | Faratronic | 4.7 µF 1200 V film (output; 1000 V = 83 % of the class) | — | dcdc | 2 | 168.8 | 125 | 110 | 100 | 250 | 200 | COF1 COF2
XFMR-AUX-FLY-E |  | CUSTOM | custom wind (D4 rev E) | aux flyback transformer ETD44 PC95, 110 W class, 321–860 V input, Np38 / N24 6 / N15 4 / Naux 4, Lp 345 µH ±5 % / AL 239, P/2–S–P/2 sandwich, leakage ≤ 4 µH, primary pins 1–4 / SELV pins 5–8, reinforced primary→secondary barrier, 100 % hipot 4 kV. ETD44 (Ae 173 mm²) is the requirement, not a size preference: at the real cycle-by-cycle limit — CS filter lag plus tILIM, with the 0.28 Ω / 100 pF sense chain — it computes 71 % of Bsat at 130 °C, where an ETD39 reaches 410 mT = 113 % [est ₹230 @1k: ETD39 wind ₹185 + larger core set/former] | — | acdc | 1 | 310.5 | 230 | 202.4 | 184 | 230 | 184 | TAUX
GD32G553VET7 |  | REVIEW | GigaDevice | MCU Cortex-M33 216 MHz LQFP100 −40…105 °C. The V suffix is the 100-pin part, and GigaDevice's ordering table lists ONLY VET7 (105 °C / 216 MHz) and VET3 (125 °C / 170 MHz) — no other suffix is a valid order code at this pin count; silicon and pinout are identical across the two | GD32G553VET3 (125 °C) | card | 1 | 283.5 | 210 | 184.8 | 168 | 210 | 168 | UCARD
ACX-1100 |  | DIRECT | Talema (Salem, India) | line CT 2500:1, 100 A, ±1%, Ø14.6 mm window, 4 kV hipot, PCB pins. Rated for a 33 Ω burden, so the 27 Ω fitted value is inside spec; quote Talema direct at volume — distributor retail is not the RFQ price. **ACCEPTANCE ROWS — this is a metering CT doing a control and a µs-trip job:** (a) amplitude error ≤ 3 % and phase ≤ 5° at **50 kHz** (the current loop rides the Vienna ripple at the carrier); (b) **step response ≤ 1 µs** to 90 % on the fitted burden (τ = L_lk/R_b is 0.7 µs at 100 µH of leakage but 13.5 µs at 2 mH — the part decides whether F.01 is a µs trip or a 10 ms one); (c) **DC tolerance ≥ 5 A of primary DC with ≤ 1 % ratio error**, or a stated low-µ core — a high-µ 1:2500 core saturates at ≈ 0.6 T with about 2 A of DC (H ≈ 25 A/m). Test three samples at Stage 5 BEFORE the PO. FALLBACK if any row fails: 2 mΩ shunt + NSI1200 per phase (+₹150–300/module) — both commercial references use shunt + isolated amplifier, and it removes the DC blindness for free | ZEMCT/HCT class eq | acdc | 3 | 87.8 | 65 | 57.2 | 52 | 195 | 156 | CTA0 CTB0 CTC0
PP-1u-600 |  | CLASS | Faratronic | 1 µF 600 V film (Vienna per-phase commutation) | Songtian | acdc | 6 | 43.2 | 32 | 28.2 | 25.6 | 192 | 154 | CA0FP CA0FN CB0FP CB0FN CC0FP CC0FN
X1-2u2-530 |  | CLASS | Faratronic/Songtian | X1 2.2 µF 530 VAC, delta across the 475 VAC line-line (inter-CMC stage CX1x; with RDMPx it forms the CX2-node series-RC network that stabilises the filter against the current loop, pfc-control) | Vishay 3386 X1 | acdc | 3 | 83.7 | 62 | 54.6 | 49.6 | 186 | 149 | CDMP1 CDMP2 CDMP3
SIC-750V-20mR |  | CLASS | BASiC | SiC MOSFET 750 V 20 mΩ class TO-247-4 (Vienna common-source pair, one die per position) [750 V 20 mΩ class, single die per position, clip-mounted (grid T_j 112 °C) — RFQ target; ACCEPTANCE IDM ≥ 210 A @25 °C (165 A F.01 fault peak)] | SiChain 750V/10mΩ (RFQ) | acdc | 1 | 243 | 180 | 158.4 | 144 | 180 | 144 | QA0A
SIC-750V-20mR |  | CLASS | BASiC | SiC MOSFET 750 V 20 mΩ class TO-247-4 (Vienna common-source pair, one die per position) [750 V 20 mΩ class, single die per position, clip-mounted (grid T_j 112 °C) — RFQ target; ACCEPTANCE IDM ≥ 210 A @25 °C (165 A F.01 fault peak)] | SiChain 750V/10mΩ (RFQ) | acdc | 1 | 243 | 180 | 158.4 | 144 | 180 | 144 | QA0B
SIC-750V-20mR |  | CLASS | BASiC | SiC MOSFET 750 V 20 mΩ class TO-247-4 (Vienna common-source pair, one die per position) [750 V 20 mΩ class, single die per position, clip-mounted (grid T_j 112 °C) — RFQ target; ACCEPTANCE IDM ≥ 210 A @25 °C (165 A F.01 fault peak)] | SiChain 750V/10mΩ (RFQ) | acdc | 1 | 243 | 180 | 158.4 | 144 | 180 | 144 | QB0A
SIC-750V-20mR |  | CLASS | BASiC | SiC MOSFET 750 V 20 mΩ class TO-247-4 (Vienna common-source pair, one die per position) [750 V 20 mΩ class, single die per position, clip-mounted (grid T_j 112 °C) — RFQ target; ACCEPTANCE IDM ≥ 210 A @25 °C (165 A F.01 fault peak)] | SiChain 750V/10mΩ (RFQ) | acdc | 1 | 243 | 180 | 158.4 | 144 | 180 | 144 | QB0B
SIC-750V-20mR |  | CLASS | BASiC | SiC MOSFET 750 V 20 mΩ class TO-247-4 (Vienna common-source pair, one die per position) [750 V 20 mΩ class, single die per position, clip-mounted (grid T_j 112 °C) — RFQ target; ACCEPTANCE IDM ≥ 210 A @25 °C (165 A F.01 fault peak)] | SiChain 750V/10mΩ (RFQ) | acdc | 1 | 243 | 180 | 158.4 | 144 | 180 | 144 | QC0A
SIC-750V-20mR |  | CLASS | BASiC | SiC MOSFET 750 V 20 mΩ class TO-247-4 (Vienna common-source pair, one die per position) [750 V 20 mΩ class, single die per position, clip-mounted (grid T_j 112 °C) — RFQ target; ACCEPTANCE IDM ≥ 210 A @25 °C (165 A F.01 fault peak)] | SiChain 750V/10mΩ (RFQ) | acdc | 1 | 243 | 180 | 158.4 | 144 | 180 | 144 | QC0B
GC4D10120H | C7435087 | ORDERABLE | SiChain | SiC JBS 1200 V 10 A TO-247-2 (Vienna RCD clamp; D{x}0CM is the mirrored clamp diode for the negative half-cycle, PH below DCN) | CR Micro 1200V/10A | acdc | 3 | 74.3 | 55 | 48.4 | 44 | 165 | 132 | DA0C DA0CM DB0C DB0CM DC0C DC0CM
CT-RES-1:100-100A |  | CLASS | **CUSTOM (RFQ)** — NOT a Talema AS catalogue part | resonant CT 1:100, 100 A rms class, 20–250 kHz, pass-through — the tank conductor is the primary, so tank-potential insulation stays on your wire (ONE CT on the full-bridge tank; the 30 kW class current 78 A rms = 78 %). REQUIREMENT: 1:100, secondary ≥ 1.3 A rms continuous (≥0.35 mm²), MnZn ferrite, 20–250 kHz, ratio ±0.5 % at 140 kHz, phase ≤ 2° over 83–203 kHz, window ≥ the tank conductor. No catalogue AS-family part covers this: that family stops at 20–200 kHz and a 30 A primary and caps the 1:50…1:500 ratios at 15 amp-turns rms (150 mA secondary = 15 A primary), while this tank runs 78/100/120 A rms → I_sec 0.78/1.00/1.20 A, 5–8× the secondary rating. The magnetic duty is trivial (2.8 V·µs per half-cycle against 350 listed, B ≈ 0.7 mT) — the limit is secondary conductor heating and the window. First article: ratio + phase sweep 83→203 kHz on the fitted burden and a 1 h thermal run at the tank class current (T-37) | 2nd HF-CT winder at RFQ (no catalogue drop-in exists at this class) | dcdc | 1 | 222.8 | 165 | 145.2 | 132 | 165 | 132 | CT1
SIC-1700-1R-G15 |  | CLASS | Infineon CoolSiC M1 / CR Micro / BASiC | SiC FET 1700 V ~1 Ω **specified at V_GS 12–15 V** (aux flyback switch on the full bus; TO-247 likely package, footprint placeholder). The NCP1252 DRV pin CLAMPS at 15 V typ / 18 V max (datasheet Rev 9), so a part whose R_DS(on) is quoted at a 20 V gate is never fully enhanced here and is barely on at the 9 V UVLO corner — the gate-voltage the R_DS(on) is specified at is the selection criterion, not the ohms. ACCEPTANCE: R_DS(on) ≤ 1.1 Ω at V_GS = 15 V and T_j = 25 °C, V_GS(th) ≤ 4.5 V, V_GS(max) ≥ 19 V, R_G,int stated (IMBF170R1K0M1-class — CoolSiC trench M1 is a +15 V/−5 V part). No gate resistor is fitted because R_G,int is ≈ 25 Ω | G3R1700 class specified at 15 V gate | acdc | 1 | 216 | 160 | 140.8 | 128 | 160 | 128 | QAUX
SIC-SBD-1700V |  | CLASS | GeneSiC/Littelfuse/Wolfspeed class | SiC Schottky ≥1700 V, IF(AV) ≥1 A, IFRM ≥10 A, no forward recovery (aux RCD clamp). The 1700 V class is the requirement: this diode blocks Vbus + Vc = 1307–1337 V at the stack-up leakage, so a 1200 V part avalanches every cycle; d4-flyback computes Vr ≤ 80 % at 860 V + limit current + 5 µH [est ₹150 @1k: 1.7 kV SiC SBD distributor class, RFQ] | 2× STTH112U series (only with a measured VFP allowance re-run through d4-flyback) | acdc | 1 | 202.5 | 150 | 132 | 120 | 150 | 120 | DCLA
MICROFIT3-40 |  | CLASS | Molex 43045-40 class (2x20) | 40-way inter-board harness header, 5 A/contact — the PFC bundle crosses here: PWM x3, 12 senses, AVMID+Kelvin, fans, precharge, EN/GATE_EN_A/FLT/DRV_RDY, V15/V24, 5 returns, shield | JST VL / TE MicroMate 40 | acdc+dcdc | 2 | 97.2 | 72 | 63.4 | 57.6 | 144 | 115 | JICA JICB
B72220S0551K101 |  | CLASS | TDK/Songtian | MOV 550 VAC 20 mm (Δ line-line, and in series with the GDT to PE) | Songtian eq | acdc | 6 | 29.7 | 22 | 19.4 | 17.6 | 132 | 106 | MOV1 MOV2 MOV3 MOVP1 MOVP2 MOVP3
SHUNT-50MV-100A |  | CLASS | Isabellenhütte-eq/local | manganin shunt, 50 mV at rated current, Kelvin 4-terminal — the value follows the order code per SKU: 0.500 / 0.376 / 0.299 mΩ at the 100 / 133 / 167 A codes | local manganin | dcdc | 1 | 162 | 120 | 105.6 | 96 | 120 | 96 | RSHO
CER-25W-160R-AX |  | CLASS | TE/local | 160 Ω 25 W ceramic pulse resistor, axial (bus discharge string, 4× in series; value-carrying order code, 50 W variant per SKU below; T-05) | SQP25 160R | acdc | 4 | 37.8 | 28 | 24.6 | 22.4 | 112 | 90 | RDIS0 RDIS1 RDIS2 RDIS3
CER-2k2-10W-AX |  | CLASS | TE/local | 2.2 kΩ 10 W wirewound axial (bank bleeder chain; ≤65 J/pulse, τ 4–17 s to <60 V) | SQP10 | dcdc | 8 | 18.9 | 14 | 12.3 | 11.2 | 112 | 90 | RBDA0 RBDA1 RBDA2 RBDA3 RBDB0 RBDB1 RBDB2 RBDB3
FUSE-gG-690V-80A |  | CLASS | local/Bussmann | gG fuse 80 A 690 VAC, 22×58 frame (30 kW AC input, 55.9 A worst continuous). The holder must be the matching 22×58 base | SIBA | acdc | 1 | 141.8 | 105 | 92.4 | 84 | 105 | 84 | F1
FUSE-gG-690V-80A |  | CLASS | local/Bussmann | gG fuse 80 A 690 VAC, 22×58 frame (30 kW AC input, 55.9 A worst continuous). The holder must be the matching 22×58 base | SIBA | acdc | 1 | 141.8 | 105 | 92.4 | 84 | 105 | 84 | F2
FUSE-gG-690V-80A |  | CLASS | local/Bussmann | gG fuse 80 A 690 VAC, 22×58 frame (30 kW AC input, 55.9 A worst continuous). The holder must be the matching 22×58 base | SIBA | acdc | 1 | 141.8 | 105 | 92.4 | 84 | 105 | 84 | F3
HV732BTTD4753F | C4121673 | ORDERABLE | KOA/UniOhm | 475 kΩ 1206 1% anti-surge (HV divider) | any anti-surge 1% | acdc+dcdc | 69 | 1.9 | 1.4 | 1.2 | 1.1 | 97 | 76 | RV1D0 RV1D1 RV1D2 RV1D3 RV1D4 RV1D5 RV1D6 RV1D7 RV2D0 RV2D1 RV2D2 RV2D3
VY1472M63Y5UQ63V0 | C499492 | ORDERABLE | Songtian/Faratronic | Y1 4.7 nF 440 VAC (second CM stage on AC1M..3M, between the two CM chokes, where the trio works against 4 mH of CM inductance / output-PE / DGND-PE; DC-use clearance is open decision O-7) | TDK CD series | acdc+dcdc | 6 | 21.6 | 16 | 14.1 | 12.8 | 96 | 77 | CY4 CY5 CY6 CPET CYO1 CYO2
RTF-50W-R33-TO247 |  | CLASS | Riedon/Vishay LTO/local RTP class | 0.33 Ω ≥ 50 W THICK-FILM NON-INDUCTIVE power resistor, TO-247 two-lead, clipped to the DC-DC heatsink with the dies — the resistor half of the DC-link entry damper. DUTY: 7 / 16 / 36 W worst per SKU (30 / 40 / 50 kW) whenever the bridge runs at f_max, because every f_max point puts 2·f_sw = 406 kHz on the entry-film / stud resonance the damper exists to absorb; the link deck reads 10.4 A rms = 35.6 W at the 50 kW SER250 / 764 V corner. The power is the source's, not the resistor's — 0.68 / 1.0 / 2.2 Ω dissipate the same ≈ 40 W and let the bus ring 185–206 V instead of 127 V, so 0.33 Ω is the value. Series L ≤ 100 nH including its leads: the damper is worthless on a long stub | Bourns PWR247T-100-R330J · Vishay LTO100 0R33 · RTP50/RTP100 0R33 | dcdc | 1 | 128.3 | 95 | 83.6 | 76 | 95 | 76 | RFDMP
PP-2u2-1100 |  | CLASS | Faratronic | 2.2 µF 1100 V PP film — the capacitor half of the DC-link entry DAMPER, in series with RFDMP 0.33 Ω across DCP–DCN at the bridge. The series resistor is not optional: film alone takes the can current to 0.80 A but leaves a 209 V bus ring at the 764 V SER corner, where the RC gives a 37 V ring and 0.77 A. RFQ ROW: **I_rms ≥ 12 A at 400 kHz / 85 °C** — the damper branch carries 6–10 A rms whenever the bridge runs at f_max | KEMET C4AQ / Songtian 2.2u 1100V | dcdc | 1 | 124.2 | 92 | 81 | 73.6 | 92 | 74 | CFDMP
Y2-10n-300 |  | CLASS | Songtian/Faratronic | Y2 **10 nF** 300 VAC, L-PE on the CONVERTER node AC1..3. 10 nF is sized for the LLC bridge as a CM source (830 V at 83–203 kHz, coupled through the DC-link studs), which costs ≈3 dB of the CM margin where the impedance matters. SAME 10 mm land if the part fits it, else the next pitch — layout re-check. ON THE RECORD: PE leakage scales with C, so one line open at 1.1 × 475 VAC with +20 % tolerance gives 1.67 mA per module and three modules on one PE conductor read 5.0 mA against the 3.5 mA line (verify-independent §G FAILS deliberately — the charger PE architecture is an open decision, not a number to widen) | TDK CD series Y2 10 nF | acdc | 3 | 33.8 | 25 | 22 | 20 | 75 | 60 | CY1 CY2 CY3
CONN-CARD-88-R |  | CLASS | any 2×44 0.1in | 88-way 2×44 2.54 mm card interface, RECEPTACLE side (card), keyed, mates CONN-CARD-88-H | Samtec SSW-144-xx-x-D class | card | 1 | 101.3 | 75 | 66 | 60 | 75 | 60 | JCARD
VOM1271T | C146286 | ORDERABLE | Vishay/eq | photovoltaic MOSFET driver with integrated turn-off (bank bleeders — no floating supply needed; the ms-class turn-on is the point) | TLP3906 | dcdc | 2 | 47.3 | 35 | 30.8 | 28 | 70 | 56 | UPVA UPVB
NSI1200-DSWR | C3029747 | ORDERABLE | NOVOSENSE | iso shunt amplifier SOIC-8 (differential OUTP/OUTN both routed) | AMC1200 | dcdc | 1 | 94.5 | 70 | 61.6 | 56 | 70 | 56 | USHO
WW-470R-10W |  | CLASS | local/TE | 470 Ω 10 W wirewound axial (Vienna clamp bleeder; 4.3 W worst case = 43 % of rating) | SQP10 | acdc | 3 | 29.7 | 22 | 19.4 | 17.6 | 66 | 53 | RA0C RA0CM RB0C RB0CM RC0C RC0CM
NSI1042-DSWR | C3445856 | ORDERABLE | NOVOSENSE | iso CAN transceiver SO-16, -DSWR order suffix. Pin map (datasheet Rev 1.3 drawing and pin table agree, and the sheets carry it): VDD1=1, GND1=2/8, RXD=3, TXD=6, GND2=9/10/15, CANL=12, CANH=13, pin 11 NC | NSI1050-DSWR | dcdc | 1 | 81 | 60 | 52.8 | 48 | 60 | 48 | UCAN
CER-25W-33R-AX |  | CLASS | TE/local | 33 Ω 25 W ceramic pulse resistor, axial (AC precharge; the ohms are IN the order code — a class-only p/n lets purchasing buy any value. Pulse energy scales ×3.6 across the SKUs, so the 50 W variant lands per SKU below; T-05). RFQ ROW: **flameproof and FAIL-OPEN under sustained overload** (UL 1412 / IEC 60115 flammability) — a shorted link or a failed-short Vienna pair at switch-on puts 4.8 kW (400 VAC) to 8.4 kW (530 VAC) on each resistor and NOTHING in the module can disconnect it, because the only relays across it are the bypass; the part fusing open without flame IS the protection. The vendor single-pulse energy curve at 0.4 s must cover 235 J (50 kW) / 180 J (30/40 kW) × 3 starts | SQP25 33R | acdc | 2 | 37.8 | 28 | 24.6 | 22.4 | 56 | 45 | RPRE1 RPRE2
GDT-2k5-20kA |  | CLASS | Bourns/eq | gas discharge tube **2.5 kV** (L-PE surge path). The 2.5 kV class is the requirement: the MOV+GDT series path only conducts when BOTH devices do, and a 3.5 kV GDT sparks over at 4.5–5 kV at a 1 kV/µs rate of rise — with the S20K550 clamping at ≈1.45 kV that is 5–6.5 kV of let-through, above the 4 kV OVC III impulse the insulation-coordination table assumes the L-PE barrier survives, so at 4 kV the path is simply open. At 2.5 kV: impulse sparkover ≈3.2–3.7 kV, total let-through ≈4.6 kV, and the 550 VAC MOV in series still blocks mains follow current | Littelfuse CG3 2.5 kV | acdc | 3 | 24.3 | 18 | 15.8 | 14.4 | 54 | 43 | GDT1 GDT2 GDT3
FILM-100n-250 |  | CLASS | Faratronic | 100 nF 250 V film (Vienna RCD clamp; C{x}0CM is the mirrored clamp cap) | MLCC 250V | acdc | 3 | 24.3 | 18 | 15.8 | 14.4 | 54 | 43 | CA0C CA0CM CB0C CB0CM CC0C CC0CM
SQP-6R8-25W |  | CLASS | local | 6.8 Ω 25 W wirewound pulse, axial, series L ≤ 10 µH (input-filter Rd–Cd damper RDMPx at 30 / 40 kW; ≤ 4.6 W = 18 % of the class) | any | acdc | 3 | 21.6 | 16 | 14.1 | 12.8 | 48 | 38 | RDMP1 RDMP2 RDMP3
CONN-CARD-88-H |  | CLASS | any 2×44 0.1in | 88-way 2×44 2.54 mm card interface, PIN HEADER side (power board), keyed | Samtec TSW-144-xx-x-D class | dcdc | 1 | 60.8 | 45 | 39.6 | 36 | 45 | 36 | JB
TLP152 | C17255258 | ORDERABLE | Toshiba/eq | opto gate driver (isolated bus-discharge control, default-OFF) | 1ED31xx lite | acdc | 1 | 56.7 | 42 | 37 | 33.6 | 42 | 34 | UQD
TPS3430WDRCR | C2870545 | ORDERABLE | TI/eq | external windowed watchdog SOT-23-6: VDD/GND/WDI/WDO/SET straps (strap values per datasheet, §K) | MAX6753 | card | 1 | 47.3 | 35 | 30.8 | 28 | 35 | 28 | USUPCARD
TPS54202DDCR | C191884 | ORDERABLE | TI/eq | 15→3.3 V 2 A sync buck SOT-23-6, on the control card and exporting V3P3 over the 88-way. An LDO is thermally impossible in this position: the 11.7 V drop at the rail current has nowhere to go in a chip package | MP2451/SY8113 | acdc+card | 2 | 20.3 | 15 | 13.2 | 12 | 30 | 24 | UBKA UBKCARD
CC0603KRX7R9BB104 | C14663 | ORDERABLE | any | filter/decoupling MLCC 0402–0805 100nF | any | acdc+dcdc+card | 58 | 0.7 | 0.5 | 0.4 | 0.4 | 29 | 23 | CA0GBV CB0GBV CC0GBV CQD CV1VA CV1VB CV2VA CV2VB CV3VA CV3VB CBPVA CBPVB
C1812-330p-1k |  | CLASS | any MLCC | **330 pF** 1 kV C0G 1812 (Vienna RC snubber). 330 pF is the value the single-polarity clamp needs: at 100 pF the unclamped half-cycle reaches 78 % of 750 V at 30 kW, 85–89 % at 50 kW and 95 % on a 20 nH loop. It costs +6 W of CV²f across the module and buys that margin back without a second clamp stage | film 630V | acdc | 3 | 12.2 | 9 | 7.9 | 7.2 | 27 | 22 | CA0SN CB0SN CC0SN
R2512-10R-3W-PULSE |  | CLASS | any | 10 Ω 2512 **3 W pulse-proof** (Vienna RC snubber). The 3 W class is the requirement: with C_SN 330 pF the snubber dissipates C·V²·f = 2.84 W per phase at the 750 V-class swing and 50 kHz, which is 142 % of a 2 W chip | 2× R2512-20R-2W in parallel on the same land | acdc | 3 | 10.8 | 8 | 7 | 6.4 | 24 | 19 | RA0SN RB0SN RC0SN
NCP1252DDR2G |  | ORDERABLE | onsemi | current-mode flyback controller, RT-set 65 kHz (66.5 kΩ, datasheet Rev 9), SOIC-8. The **D suffix is mandatory** — no pre-soft-start delay, VCC(on) 14 V with 5.0 V hysteresis and DCmax 45.6 % against the 22 % worst duty this DCM flyback needs at the 321 V brown-in. The A version carries a 120 ms pre-soft-start delay with only 1.0 V of UVLO hysteresis, and the 940 k startup feed (0.59 mA) minus ICC (1.4–2.2 mA) collapses VCC in 28–60 ms, so it hiccups forever instead of starting. Startup budget: ≈5.6 mA × 60 ms of soft-start + takeover = 336 µC → CVCC ≥ 67 µF, 220 µF fitted (3× margin; cold start ≈ 5–6 s at a 565 V precharged bus) | UCC28C43 + RT/CT & BO rework | acdc | 1 | 32.4 | 24 | 21.1 | 19.2 | 24 | 19 | UAUX
RC1206FR-7W4R7L | C859161 | ORDERABLE | any thick-film HP | gate resistor 1206, 0.5 W-rated (LLC R_on 4.7 Ω dissipates ~0.2 W at 140 kHz, so a standard 0.25 W part runs 80 %). The LLC **R_off is 0 Ω** — OUTL straight to the gate, driver R_OL 0.3 Ω — which is only correct WITH the per-die C_s fitted: together they give 69/76/77 % peak V_ds and −5.4 V of gate undershoot, where 0 Ω alone gives 77 % and −5.6…−6.7 V against a −8 V transient maximum. The 1206 land is kept so a bench re-fit can put the resistor back. Vienna keeps 4.7/4.7 Ω 4.7 | 2× 0805 parallel | acdc+dcdc | 10 | 2.7 | 2 | 1.8 | 1.6 | 20 | 16 | RA0GON RA0GOFF RB0GON RB0GOFF RC0GON RC0GOFF R1HON R1LON R2HON R2LON
R2512-33k-HV-AS |  | CLASS | KOA/UniOhm | 33 kOhm 2512 2 W anti-surge HV, Umax >= 250 V, 2-series per position (artificial-star network; it is also THE X-cap bleed path, which is what sets the value: across three X stages 33 k brings the terminals below 60 V in ≈ 3.7 s (30/40 kW) / 4.5 s (50 kW), inside the 5 s line for permanently connected equipment). 0.57 W per element at 475 VAC (29 % of the 2 W part), +0.7 W per module standing at 400 VAC | any HV anti-surge | acdc | 6 | 4.3 | 3.2 | 2.8 | 2.6 | 19 | 16 | RNS1A RNS1B RNS2A RNS2B RNS3A RNS3B
ULN2803A | C2865085 | ORDERABLE | any | 8-ch relay coil driver SOIC-18 (unused inputs grounded) | TBD62083 | acdc+dcdc | 2 | 12.2 | 9 | 7.9 | 7.2 | 18 | 14 | UPA ULB
B4B-PH-K-S | C131334 | ORDERABLE | JST | fan header 4-way (the fan p/n must accept 3.3 V PWM) | any | acdc | 3 | 8.1 | 6 | 5.3 | 4.8 | 18 | 14 | JFAN1 JFAN2 JFAN3
LED-2DIG-0.56CC | C9900021773 | REVIEW | any | 2-digit 7-seg 0.56" common-cathode (HMI) | any | dcdc | 1 | 24.3 | 18 | 15.8 | 14.4 | 18 | 14 | DISP1
US1M | C412437 | ORDERABLE | Yageo/MDD | 1 kV 1 A fast diode SMA (DESAT chain) | M7/US1M any | acdc+dcdc | 14 | 1.6 | 1.2 | 1.1 | 1 | 17 | 14 | DA0GS1 DA0GS2 DB0GS1 DB0GS2 DC0GS1 DC0GS2 D1HS1 D1HS2 D1LS1 D1LS2 D2HS1 D2HS2
TLV3202-class |  | CLASS | TI/3PEAK | dual 40 ns push-pull comparator SOIC/VSSOP-8, 2.7–5.5 V (F.11 window: trips above F11_VH and below F11_VL, diode-OR onto FLT = HRTIMER_FLT2) | TS3022 / LMV7239 ×2 | dcdc | 1 | 21.6 | 16 | 14.1 | 12.8 | 16 | 13 | U1W
B2B-PH-K-S | C20504437 | ORDERABLE | JST | 2-way header (NTC/term) | any | acdc+dcdc | 5 | 4.1 | 3 | 2.6 | 2.4 | 15 | 12 | JTPFC JTINL JTLLC JTXFR JTERM
RC0603FR-0710KL |  | CLASS | any | small-signal resistor 0402–0805 (pulls/filters/feedback) 10k (0603 land) | any | acdc+dcdc+card | 32 | 0.5 | 0.4 | 0.4 | 0.3 | 13 | 10 | RA0GPD RB0GPD RC0GPD RTPFCP RTINLP RBEFB RBKF2A RM24B RM15B RFT1 RFT2 RFT3
PS122WF4702T4E | C2793932 | REVIEW | KOA/UniOhm | **47 kOhm** 2512 2 W anti-surge HV, Umax >= 250 V, 2-series per half, ONE string per half per module. 4.4 mA of bleed against a realistic hot can-to-can leakage imbalance of ≤ ~1.2 mA (the RFQ line ≤ 0.5 mA/can at 85 °C/415 V, graded per half) = ≤ 56 V of midpoint offset with both stages off, on a link sitting at the rectified crest; 0.92 W per element at 830 V (46 % of the 2 W part, 208 V per element), 3.7 W per module on EVERY SKU | any HV anti-surge | acdc | 4 | 4.3 | 3.2 | 2.8 | 2.6 | 13 | 10 | RBALT0A RBALT0B RBALB0A RBALB0B
ARG05BTC6801 | C3033907 | ORDERABLE | UniOhm | divider bottom 0.1% (6.8 k unipolar / 11.5 k AC) 6.8k | any 0.1% | acdc+dcdc | 5 | 3.4 | 2.5 | 2.2 | 2 | 13 | 10 | RBPDL RBMDL ROADL ROBDL ROVDL
GR227M035F12RR0VL4FP0 | C45078 | ORDERABLE | Aishi | 220 µF 35 V | any | acdc | 3 | 5.4 | 4 | 3.5 | 3.2 | 12 | 10 | CAUX24 CAUX15 CVCC
R2512-11k-2W-AS |  | CLASS | KOA/UniOhm | 11 kΩ 1 % 2512 2 W anti-surge, ≥200 V working (aux RCD clamp, 3-series = 33 k; ≤0.94 W/part at full load and 5 µH of leakage, ≤158 V/part at the 860 V limit-current event) [est ₹4 @1k, same family as R2512-47k-HV-AS] | any 2 W anti-surge 2512 | acdc | 3 | 5.4 | 4 | 3.5 | 3.2 | 12 | 10 | RCLA1 RCLA2 RCLA3
CYA0630-10UH | C5189958 | ORDERABLE | any shielded | 10 µH 3 A shielded power inductor (3V3 buck) | any | acdc+card | 2 | 8.1 | 6 | 5.3 | 4.8 | 12 | 10 | LBKA LBKCARD
TLV9061IDBVR | C398358 | ORDERABLE | TI/3PEAK | rail-to-rail op-amp (AVMID buffer) | LMV321 | card | 1 | 16.2 | 12 | 10.6 | 9.6 | 12 | 10 | UAVB
CL05A105KO5NNNC |  | CLASS | any | 1 µF 0805 (driver bias) 1uF (0402 land) | any | acdc+dcdc | 14 | 1.1 | 0.8 | 0.7 | 0.6 | 11 | 8 | CA0GB1 CA0GB2 CB0GB1 CB0GB2 CC0GB1 CC0GB2 C1HB1 C1HB2 C1LB1 C1LB2 C2HB1 C2HB2
R2512-HV |  | CLASS | UniOhm | 2512 HV-rated 1 %, **limiting element voltage ≥ 500 V** (aux startup 2×470 k / brown-out 2×1.2 M, 2-series per 860 V). The working voltage is the specification, not the value: a standard 2512 thick-film is rated 200 V and these strings put ≈ 415–430 V on EACH element at the 830–860 V link, so the order line must name an HV family (RV2512 / CRCW-HV / PS-class, U_max ≥ 500 V) or the string goes to three elements | 3-series standard 2512 (same total R, 277–287 V per element) | acdc | 4 | 3.4 | 2.5 | 2.2 | 2 | 10 | 8 | RAUXST1 RAUXST2 RBR1A RBR1B
PP-10n-1200 |  | CLASS | Faratronic | 10 nF 1200 V film (aux RCD clamp) | MLCC 1kV ×2 | acdc | 1 | 12.2 | 9 | 7.9 | 7.2 | 9 | 7 | CCLA
C1206-330p-1kV-C0G |  | CLASS | Murata/Samsung/Walsin C0G | 330 pF 1 kV C0G 1206 LLC turn-off snubber (tanks.mjs cs @30 kW; 470 pF and above close the weak leg's ZVS window at the SER250-bus764 corner entirely) | 2× 1206 in parallel for the same C at half the ESL | dcdc | 1 | 12.2 | 9 | 7.9 | 7.2 | 9 | 7 | C1HOS1
C1206-330p-1kV-C0G |  | CLASS | Murata/Samsung/Walsin C0G | 330 pF 1 kV C0G 1206 LLC turn-off snubber (tanks.mjs cs @30 kW) | 2× 1206 in parallel for the same C at half the ESL | dcdc | 1 | 12.2 | 9 | 7.9 | 7.2 | 9 | 7 | C1LOS1
C1206-330p-1kV-C0G |  | CLASS | Murata/Samsung/Walsin C0G | 330 pF 1 kV C0G 1206 LLC turn-off snubber (tanks.mjs cs @30 kW) | 2× 1206 in parallel for the same C at half the ESL | dcdc | 1 | 12.2 | 9 | 7.9 | 7.2 | 9 | 7 | C2HOS1
C1206-330p-1kV-C0G |  | CLASS | Murata/Samsung/Walsin C0G | 330 pF 1 kV C0G 1206 LLC turn-off snubber (tanks.mjs cs @30 kW) | 2× 1206 in parallel for the same C at half the ESL | dcdc | 1 | 12.2 | 9 | 7.9 | 7.2 | 9 | 7 | C2LOS1
R2512-150k-HV |  | CLASS | KOA/UniOhm | 150 kOhm 1 % 2512 HV, Umax >= 400 V, 3-series across the OUTPUT studs (passive output bleeder behind DOUT): 450 kΩ total → τ 4.2 s on COF1+COF2, < 60 V in ≈ 12 s from 1000 V and ≈ 9 s from 500 V; 0.74 W and 333 V per element at 1000 V out, 2.2 W per module only while delivering at 1000 V (−0.007 % η) | any HV anti-surge 2512, 3-series | dcdc | 3 | 4.1 | 3 | 2.6 | 2.4 | 9 | 7 | RBO1 RBO2 RBO3
XTAL-8M-30PPM-3225 |  | CLASS | any | 8 MHz ±30 ppm SMD crystal, 3.2 × 2.5 mm, CL 12 pF, on MCU pins 12/13 with a ground guard under the can; firmware sets PORT_HXTAL_HZ = 8 MHz. An external crystal is required, not preferred: the module's only external interface is isolated CAN, classic CAN needs the SUM of both nodes' clock errors inside the resynchronisation jump width (≤0.5 %/node in practice, ±1.58 % absolute worst case), and the GD32 internal RC is ±2–3 % over −40…+105 °C — 5× the ISO 11898-1 budget at 16 tq / SJW 2 | HC-49SMD 8 MHz ±30 ppm | card | 1 | 12.2 | 9 | 7.9 | 7.2 | 9 | 7 | XCARD
R1206-RG-0.5W |  | CLASS | any thick-film HP | gate resistor 1206, 0.5 W-rated (LLC R_on 4.7 Ω dissipates ~0.2 W at 140 kHz, so a standard 0.25 W part runs 80 %). The LLC **R_off is 0 Ω** — OUTL straight to the gate, driver R_OL 0.3 Ω — which is only correct WITH the per-die C_s fitted: together they give 69/76/77 % peak V_ds and −5.4 V of gate undershoot, where 0 Ω alone gives 77 % and −5.6…−6.7 V against a −8 V transient maximum. The 1206 land is kept so a bench re-fit can put the resistor back. Vienna keeps 4.7/4.7 Ω | 2× 0805 parallel | dcdc | 4 | 2.7 | 2 | 1.8 | 1.6 | 8 | 6 | R1HOFF R1LOFF R2HOFF R2LOFF
ACT45B-510-2P-TL003 | C55213551 | ORDERABLE | any | CAN common-mode choke | any | dcdc | 1 | 10.8 | 8 | 7 | 6.4 | 8 | 6 | LCAN
B4B-PH-K-S | C131334 | ORDERABLE | JST | CAN connector 4-way | any | dcdc | 1 | 10.8 | 8 | 7 | 6.4 | 8 | 6 | JCAN
PZ254V-11-05P | C492404 | ORDERABLE | any | SWD/boot header (end-of-line programming; LV-only test state, §45) | TC2030 pads | card | 1 | 10.8 | 8 | 7 | 6.4 | 8 | 6 | JSWDCARD
74HC11 | C5524384 | ORDERABLE | any | triple 3-input AND (gate-enable wired-AND) | 74LVC1G11 ×1 | card | 1 | 10.8 | 8 | 7 | 6.4 | 8 | 6 | UANDCARD
RT0805BRD0711K5L | C865153 | ORDERABLE | UniOhm | divider bottom 0.1% (6.8 k unipolar / 11.5 k AC) 11.5k | any 0.1% | acdc | 3 | 3.4 | 2.5 | 2.2 | 2 | 8 | 6 | RV1DL RV2DL RV3DL
RC0603FR-07100RL |  | CLASS | any | small-signal resistor 0402–0805 (pulls/filters/feedback) 100 (0603 land) | any | acdc+dcdc | 17 | 0.5 | 0.4 | 0.4 | 0.3 | 7 | 5 | RA0GDS RB0GDS RC0GDS RV1O RV2O RV3O RBPO RBMO R1HDS R1LDS R2HDS R2LDS
TAB-M4 |  | CLASS | local | discharge FET heatsink tab stud | — | acdc | 1 | 8.1 | 6 | 5.3 | 4.8 | 6 | 5 | QDIS
US2G | C49263 | ORDERABLE | MDD/Yageo | 400 V 2 A ultrafast SMB (aux 15 V / self-supply rectifiers — PIV ≈ 157 V plus ring) | MURS240 | acdc | 2 | 4.1 | 3 | 2.6 | 2.4 | 6 | 5 | DAUX15 DAUXVC
TACT-6x6 | C318884 | REVIEW | any | tactile switch 6×6 (HMI; pinout pairing verified at BOM freeze against the chosen series) | any | dcdc | 2 | 4.1 | 3 | 2.6 | 2.4 | 6 | 5 | SW1 SW2
R-small |  | CLASS | any | small-signal resistor 0402–0805 (pulls/filters/feedback) | any | acdc+dcdc+card | 13 | 0.5 | 0.4 | 0.4 | 0.3 | 5 | 4 | RA0F RB0F RC0F RQDL RAUXRT REN2A RM24A RPVBA RPVBB RF11H RF11M RF11L
US3M | C3039981 | ORDERABLE | onsemi/MDD (MURS340 class) | 400 V 3 A ultrafast, SMC pad (aux 24 V rectifier — PIV ≈ 176 V plus the leakage ring, which is why the class is 400 V and not a 100 V Schottky) | ES3 series 400 V | acdc | 1 | 6.8 | 5 | 4.4 | 4 | 5 | 4 | DAUX24
74HC02D |  | ORDERABLE | any | quad NOR SOIC-14 — hardware S/P exclusion: KSER coil = KSER ∧ ¬(KPARA∨KPARB). Every destructive matrix state involves KSER, so the exclusion is wired in hardware and not left to firmware | any | dcdc | 1 | 6.8 | 5 | 4.4 | 4 | 5 | 4 | UEXCL
CL21B105KBFNNNE | C28323 | ORDERABLE | any | 1 µF 0805 bulk on module-fed floating rails (Bias5 / shunt-amp / CAN 5 V) 1uF | any | acdc+dcdc | 6 | 1.1 | 0.8 | 0.7 | 0.6 | 5 | 4 | C5BAC C5BBUS CSHB C5BBKA C5BBKB CCB5
MLCC-1n-0402-C0G |  | CLASS | any C0G | 1 nF 0402 C0G/NP0 50 V — ADC sampling reservoir at the card's analogue pins; comparator paths F.01/F.03/F.13 see τ ≤ 0.4 µs | any 0402 C0G 1 nF | card | 22 | 0.3 | 0.2 | 0.2 | 0.2 | 4 | 4 | CADC0 CADC1 CADC2 CADC3 CADC4 CADC5 CADC6 CADC7 CADC8 CADC9 CADC10 CADC11
R2512-0R47-1W-1% |  | CLASS | any | 0.47 Ω 1% 1 W 2512 resonant-CT burden (full bridge: F.11 140 A pk = 0.66 V above AVMID; observable to 345 A, past the 328 A monitor peak 3 µs after an internal short; 78 A rms class → 0.29 W) | 2× 1206 0R91 parallel | dcdc | 1 | 5.5 | 4.1 | 3.6 | 3.3 | 4 | 3 | R1CT
PESD1CAN | C143073 | ORDERABLE | Nexperia/eq | CAN TVS | any | dcdc | 1 | 5.4 | 4 | 3.5 | 3.2 | 4 | 3 | TVSCAN
74HC595 | C19192516 | ORDERABLE | any | shift register SOIC-16 (HMI segments) | TPIC6C595 | dcdc | 1 | 5.4 | 4 | 3.5 | 3.2 | 4 | 3 | USR1
R0603-10k |  | CLASS | any | 10 kΩ 0603 card-interface pull-down (board-side default-OFF on the GATE_EN/EN/DO ways — CARD_RULES) | any | acdc+dcdc | 13 | 0.4 | 0.3 | 0.3 | 0.2 | 4 | 3 | RPD0 RPD1 RPD2 RPD3 RPD4 RPD5 RPD6 RPDB0 RPDB1 RPDB2 RPDB3 RPDB4
RC1206FR-0722RL |  | CLASS | any | 22 Ω line-CT burden 1% (F.01 120 A pk = 2.71 V; observable to 184 A through the D1 soft-saturation 3 µs race; 55 A rms → 0.48 V rms metering) 22 | any | acdc | 3 | 1.6 | 1.2 | 1.1 | 1 | 4 | 3 | RA0B RB0B RC0B
RC0805FR-0710KL | C84376 | ORDERABLE | any | 10 kΩ gate-source 10k | any | acdc+dcdc | 7 | 0.7 | 0.5 | 0.4 | 0.4 | 4 | 3 | RA0GGS RB0GGS RC0GGS R1HGS R1LGS R2HGS R2LGS
1N4148WS | C2128 | ORDERABLE | any | clamp diode SOD-323 (to 3V3) | BAS316 | acdc+dcdc | 8 | 0.5 | 0.4 | 0.4 | 0.3 | 3 | 2 | DA0P DA0N DB0P DB0N DC0P DC0N D1CP D1CN
R0805-2R2 |  | CLASS | any thick-film | per-device series gate R — one on EVERY die including the original device, never a shared node. LLC paralleled positions 2.2 Ω; the Vienna common-source pair takes **1 Ω per die**, because two 5–6 nF C_iss gates tied together through package lead inductance are an undamped 50–200 MHz loop that no single-device simulation shows. +₹1.2/module | any | acdc | 6 | 0.7 | 0.5 | 0.4 | 0.4 | 3 | 2 | RGA0A1 RGA0B1 RGB0A1 RGB0B1 RGC0A1 RGC0B1
CC0603KRX7R9BB102 | C100040 | ORDERABLE | any | filter/decoupling MLCC 0402–0805 1nF | any | acdc+card | 6 | 0.7 | 0.5 | 0.4 | 0.4 | 3 | 2 | CA0F CB0F CC0F CFBF CRSTCARD CFLTC
SMBJ28A |  | ORDERABLE | any | TVS **28 V** uni SMB — V24 rail clamp for a gross feedback-open fault, not rail regulation. The 28 V standoff is the requirement: V24 runs 25–26.5 V at light load, and a standoff at or below that normal maximum leaks continuously and becomes a heater instead of a clamp. Works with the 4.7 k V24 preload (RPL24) | any | acdc | 1 | 4.1 | 3 | 2.6 | 2.4 | 3 | 2 | DTVS24
SMBJ18A |  | ORDERABLE | any | TVS **18 V** uni SMB — V15 rail clamp, fault duty only. 18 V clears the ±2 % reference band (V15 upper corner 15.4 V) with room and still sits under the gate-bias modules' 16.5 V input ceiling; a 16 V standoff would sit below the rail's own upper corner and leak in normal operation | any | acdc | 1 | 4.1 | 3 | 2.6 | 2.4 | 3 | 2 | DTVS15
R2512-R05-1W-1% |  | CLASS | any current-sense | 50 mΩ 1 % 1 W 2512 in the V24 distribution after CAUX24: it holds a V24 hard-short loop ≥100 mΩ so the NCP1252D min-on-time ratchet stays ≤80 % of Bsat (130 °C) for the 10–20 ms before the fault latch; 0.29 W at 2.4 A [est ₹3 @1k] | any 2512 CS 1 W | acdc | 1 | 4.1 | 3 | 2.6 | 2.4 | 3 | 2 | RAUX24
CC0805KRX7R9BB102 |  | CLASS | any | filter/decoupling MLCC 0402–0805 1nF (0805 land) | any | acdc+dcdc | 5 | 0.7 | 0.5 | 0.4 | 0.4 | 3 | 2 | CBPDF CBMDF COADF COBDF COVDF
R1206-R28-1%-0.5W |  | CLASS | any current-sense | 0.28 Ω 1% 0.5 W 1206 current-sense (aux cycle-by-cycle limit — with CCSF 100 pF the worst comparator margin at full load is 8 % and the limit flux 71 % of Bsat at 130 °C; 0.19 W worst) | any CS 1206 | acdc | 1 | 3.4 | 2.5 | 2.2 | 2 | 3 | 2 | RAUXCS
R2010-1k-0.75W-1% |  | CLASS | any thick-film | 1 kΩ 0.75 W 2010, PV-driver LED feed (≥10 mA at the guaranteed spec point, held down to the 13.5 V rail floor; 0.24 W worst = 31 %) | 2× 510R 1206 series | dcdc | 2 | 1.6 | 1.2 | 1.1 | 1 | 2 | 2 | RPVLA RPVLB
RC0603FR-07220RL | C107696 | ORDERABLE | any | 220 Ω segment 220 | any | dcdc | 8 | 0.4 | 0.3 | 0.3 | 0.2 | 2 | 2 | RSEG0 RSEG1 RSEG2 RSEG3 RSEG4 RSEG5 RSEG6 RSEG7
RC0603FR-07100KL |  | CLASS | any | small-signal resistor 0402–0805 (pulls/filters/feedback) 100k (0603 land) | any | acdc+card | 5 | 0.5 | 0.4 | 0.4 | 0.3 | 2 | 2 | RAUXG REN1A RENRCARD RENLCARD REN1CARD
S8050 | C2146 | ORDERABLE | CJ | NPN SOT-23 (QAUXFB: opto-emulating feedback pull-down · QPVD: low-side switch for the PV-driver LEDs at the guaranteed 10 mA point) | MMBT2222 | acdc+dcdc | 4 | 0.5 | 0.4 | 0.4 | 0.3 | 2 | 1 | QAUXFB QPVD QDIG1 QDIG2
MLCC-18p-0603 |  | CLASS | any | **18 pF** 0603 C0G (DESAT blank, LLC ZVS turn-on). 18 pF is bounded on both sides: the LLC positions carry TWO dies at 40/50 kW on ONE driver channel, so the soft-off term 0.6·Q_g/I_STO doubles (2 × 162 nC / 0.25 A = 778 ns) and the total response must stay inside 1.5 µs (75 % of a 2 µs withstand) — 18 pF gives 1.33 µs with two dies; below it the minimum blank falls under the 0.4 µs noise floor (10 pF sits under it, 15 pF reads 0.39 µs). The 0.47 µs minimum blank it does give makes the ZVS turn-on transient a named EVT bench check | any C0G | dcdc | 4 | 0.5 | 0.4 | 0.4 | 0.3 | 2 | 1 | C1HBL C1LBL C2HBL C2LBL
CC0805KRX7R9BB103 |  | CLASS | any | filter/decoupling MLCC 0402–0805 10nF (0805 land) | any | acdc | 3 | 0.7 | 0.5 | 0.4 | 0.4 | 2 | 1 | CV1DF CV2DF CV3DF
CL21A106KAYNNNE | C15850 | ORDERABLE | any | filter/decoupling MLCC 0402–0805 10uF | any | acdc+card | 3 | 0.7 | 0.5 | 0.4 | 0.4 | 2 | 1 | CBKIA CBKICARD CAVO
CC0603JRNPO9BN470 |  | CLASS | any | 47 pF 0603 C0G (DESAT blank, Vienna hard turn-on — NSI66x1A worst response 2.21 µs against the 4.2 µs short-circuit-withstand class, ≥0.8 µs blank) 47pF | any C0G | acdc | 3 | 0.5 | 0.4 | 0.4 | 0.3 | 1 | 1 | CA0GBL CB0GBL CC0GBL
RC0603FR-072K2L |  | CLASS | any | small-signal resistor 0402–0805 (pulls/filters/feedback) 2.2k (0603 land) | any | acdc+dcdc | 3 | 0.5 | 0.4 | 0.4 | 0.3 | 1 | 1 | RZFB RDIG1 RDIG2
RC0805FR-071ML | C107700 | ORDERABLE | any | small-signal resistor 0402–0805 (pulls/filters/feedback) 1M | any | dcdc+card | 3 | 0.5 | 0.4 | 0.4 | 0.3 | 1 | 1 | R1WHA R1WHB RCARDXF
BZX84-B15 |  | ORDERABLE | any | 15 V **±2 %** zener (aux primary-side regulation reference — VCC regulates at VZ+VBE and the aux winding tracks the rails). ±2 % is a requirement, not a preference: N15 = Naux = 4 T, so V15 tracks VCC almost exactly and inherits the whole reference tolerance. At ±2 %, VZ 14.7–15.3 V → V15 ≈ 14.6–15.4 V, inside the gate-bias modules' 13.5–16.5 V input window with margin and under the SMBJ18A standoff; a ±5 % part puts the top of V15 at 16.6 V, outside that window | TL431 + 2-resistor divider (+₹1.4, ±1 %) | acdc | 1 | 1.6 | 1.2 | 1.1 | 1 | 1 | 1 | DZAUX
CL21B105KBFNNNE | C28323 | ORDERABLE | any | filter/decoupling MLCC 0402–0805 1uF | any | acdc+dcdc | 2 | 0.7 | 0.5 | 0.4 | 0.4 | 1 | 1 | CAVMA C1AVM
R2512-4k7-1W |  | CLASS | any | 4.7 kΩ 1 W 2512 V24 PRELOAD, 5.1 mA / 0.12 W. Fitted because the normal standby state — every relay de-energised, fans off — otherwise leaves V24 with NO minimum load, peak-charging to ≈25–26.5 V against a 26.4 V HF167F coil maximum and 26.4 V-class 24 V fans | 2× 0805 in series | acdc | 1 | 1.4 | 1 | 0.9 | 0.8 | 1 | 1 | RPL24
GRM21BR61C226ME44L | C86817 | ORDERABLE | any | filter/decoupling MLCC 0402–0805 22uF | any | acdc+card | 2 | 0.7 | 0.5 | 0.4 | 0.4 | 1 | 1 | CBKOA CBKOCARD
MLCC-small |  | CLASS | any | filter/decoupling MLCC 0402–0805 | any | card | 2 | 0.7 | 0.5 | 0.4 | 0.4 | 1 | 1 | CCARDX1 CCARDX2
RC0805FR-0710KL | C84376 | ORDERABLE | any | small-signal resistor 0402–0805 (pulls/filters/feedback) 10k | any | acdc+card | 2 | 0.5 | 0.4 | 0.4 | 0.3 | 1 | 1 | RQDPD RCARDRST
RC1206FR-071ML |  | CLASS | any | small-signal resistor 0402–0805 (pulls/filters/feedback) 1M (1206 land) | any | acdc+dcdc | 2 | 0.5 | 0.4 | 0.4 | 0.3 | 1 | 1 | RPET RCGB
RC0603FR-071KL |  | CLASS | any | small-signal resistor 0402–0805 (pulls/filters/feedback) 1k (0603 land) | any | acdc+dcdc | 2 | 0.5 | 0.4 | 0.4 | 0.3 | 1 | 1 | RCSF R1CF
RC0603FR-0745K3L |  | CLASS | any | small-signal resistor 0402–0805 (pulls/filters/feedback) 45.3k (0603 land) | any | acdc+card | 2 | 0.5 | 0.4 | 0.4 | 0.3 | 1 | 1 | RBKF1A RBKF1CARD
RC0603JR-070RL |  | CLASS | any | small-signal resistor 0402–0805 (pulls/filters/feedback) 0R (0603 land) | any | dcdc+card | 2 | 0.5 | 0.4 | 0.4 | 0.3 | 1 | 1 | RROLEB RWDOLCARD
RC0603FR-074K7L |  | CLASS | any | small-signal resistor 0402–0805 (pulls/filters/feedback) 4.7k (0603 land) | any | dcdc+card | 2 | 0.5 | 0.4 | 0.4 | 0.3 | 1 | 1 | RPVDB RFLTC
GZ2012D601TF | C1017 | ORDERABLE | any | ferrite bead 600 Ω@100 MHz (VDDA feed) | any | card | 1 | 1.1 | 0.8 | 0.7 | 0.6 | 1 | 1 | FBCARDA
BAT54A |  | CLASS | any | dual Schottky SOT-23 common anode (F.11 window comparator diode-OR onto the FLT wire-OR) | BAT54AW | dcdc | 1 | 0.8 | 0.6 | 0.5 | 0.5 | 1 | 1 | D1W
CC0603JRNPO9BN101 | C14665 | ORDERABLE | any | 100 pF 0603 C0G ±5 % (aux current-sense filter — 1 k ∥ 26.5 k ramp R → 96 ns lag). C0G at this value: a 470 pF X7R part lets the cycle-by-cycle limit overshoot 1.5 A at 860 V 100pF | any C0G | acdc | 1 | 0.7 | 0.5 | 0.4 | 0.4 | 1 | 0 | CCSF
CC0603JRNPO9BN221 | C106210 | ORDERABLE | any | filter/decoupling MLCC 0402–0805 220pF | any | dcdc | 1 | 0.7 | 0.5 | 0.4 | 0.4 | 1 | 0 | C1CF
CC1206KRX7R9BB472 | C107208 | ORDERABLE | any | filter/decoupling MLCC 0402–0805 4.7nF | any | dcdc | 1 | 0.7 | 0.5 | 0.4 | 0.4 | 1 | 0 | CCGB
CL10A105KB8NNNC |  | CLASS | any | filter/decoupling MLCC 0402–0805 1uF (0603 land) | any | card | 1 | 0.7 | 0.5 | 0.4 | 0.4 | 1 | 0 | CCARDA1
CC0603KRX7R9BB222 |  | CLASS | any | filter/decoupling MLCC 0402–0805 2.2nF (0603 land) | any | card | 1 | 0.7 | 0.5 | 0.4 | 0.4 | 1 | 0 | CAVF
RC0603FR-07330RL |  | CLASS | any | small-signal resistor 0402–0805 (pulls/filters/feedback) 330 (0603 land) | any | acdc | 1 | 0.5 | 0.4 | 0.4 | 0.3 | 0 | 0 | RKFBP
RC0805FR-07100RL | C105577 | ORDERABLE | any | small-signal resistor 0402–0805 (pulls/filters/feedback) 100 | any | acdc | 1 | 0.5 | 0.4 | 0.4 | 0.3 | 0 | 0 | RQDG
RC0603FR-077K5L |  | CLASS | any | small-signal resistor 0402–0805 (pulls/filters/feedback) 7.5k | any | acdc | 1 | 0.5 | 0.4 | 0.4 | 0.3 | 0 | 0 | RBR2
RC0603FR-0747KL |  | CLASS | any | small-signal resistor 0402–0805 (pulls/filters/feedback) 47k (0603 land) | any | acdc | 1 | 0.5 | 0.4 | 0.4 | 0.3 | 0 | 0 | RM15A
RC1206FR-07120RL | C114928 | ORDERABLE | any | small-signal resistor 0402–0805 (pulls/filters/feedback) 120 | any | dcdc | 1 | 0.5 | 0.4 | 0.4 | 0.3 | 0 | 0 | RTERM
RC0805FR-074R7L | C137513 | ORDERABLE | any | small-signal resistor 0402–0805 (pulls/filters/feedback) 4.7 | any | card | 1 | 0.5 | 0.4 | 0.4 | 0.3 | 0 | 0 | RAVI
RC0805JR-070RL | C96345 | ORDERABLE | any | card FLT wired-OR pull-up 4.7 k 0603 / AGND–DGND 0 Ω 0805 single-point tie 0R | any | card | 1 | 0.5 | 0.4 | 0.4 | 0.3 | 0 | 0 | RAGTC
TP-1mm-PAD |  | CLASS | — | 1 mm test pad on WDI — the ATE fixture kicks the watchdog through it while the WDO→NRST link (RWDOL) is lifted for blank-chip SWD programming; a process note on the fab drawing, not a purchased part | probe-only pad, no part | card | 1 | 0.3 | 0.2 | 0.2 | 0.2 | 0 | 0 | TPWDICARD
MECH |  | MECH | — | PCB-ACDC 6L 440×500 | — | module | 1 | 1438 | 1250 | 1163 | 1088 | 1250 | 1088
MECH |  | MECH | — | PCB-DCDC 6L 440×500 | — | module | 1 | 1667 | 1450 | 1349 | 1262 | 1450 | 1262
MECH |  | MECH | — | Heatsink extrusions (2, sandwich outer faces) | — | module | 1 | 1725 | 1500 | 1395 | 1305 | 1500 | 1305
MECH |  | MECH | — | Fans 120×38 PWM (3.3 V-PWM p/n, dual-ball-bearing, L10 ≥70 kh @40 °C, IP55, −30…+70 °C field-reliability spec; IP55 premium at RFQ · ELECTRICAL CLASS: ≤ 0.6 A at 24 V (≤ 14 W) at 100 % PWM, start surge ≤ 1.5 A for ≤ 0.3 s — the 160 m³/h class the air budget assumes draws 7–14 W and the 110 W aux (d4-flyback i24s 1.6–2.4 A) is sized on it; a 25 W fan pushes the aux into the NCP1252's LATCHED over-current). The third fan runs on the FAN_TACH3 way with its PWM ganged on FAN_PWM2 | — | module | 3 | 322 | 280 | 260 | 244 | 840 | 731
MECH |  | MECH | — | Enclosure sheet metal + hardware | — | module | 1 | 1150 | 1000 | 930 | 870 | 1000 | 870
MECH |  | MECH | — | Busbars/interconnect studs + harness (busbar-calc) | — | module | 1 | 833 | 724 | 673 | 630 | 724 | 630
MECH |  | MECH | — | NTC sensor assemblies (insulated tip spec) | — | module | 4 | 21 | 18 | 17 | 16 | 72 | 63
MECH |  | MECH | — | TIM/insulators/fasteners (clip mount: 0.635 mm Al2O3 insulator + spring clip + grease under each of 27 TO-247 dies, mount.mjs 0.8 K/W) | — | module | 1 | 552 | 480 | 446 | 418 | 480 | 418
MECH |  | MECH | — | Magnetics bond kit: 3 W/mK silicone gap pads on BOTH yoke faces of the two D3 cells and the D2 to the upper/lower extrusion webs + clamp bars, end turns potted (≥0.8 W/mK), CTE-compliant (no rigid epoxy to aluminium); VPI is in the part price — three parts | — | module | 1 | 253 | 220 | 205 | 191 | 220 | 191
MECH |  | MECH | — | D1 choke mount kit: per stack — fiberglass-reinforced silicone gap pad 1.0 mm ≥3 W/mK (≥5 kVAC ASTM D149, basic insulation to the PE-bonded web), GF-PPS insulating clamp cap + bore sleeve (basic insulation winding↔bolt), M6 A4 bolt + Belleville + nut, 2-point glass banding; the bonded end face is the D1 cooling path [est: pad ₹45, cap+sleeve ₹42, hardware+banding ₹18] | — | module | 3 | 121 | 105 | 98 | 91 | 315 | 274
MECH |  | MECH | — | Conformal coating (acrylic, both boards + card) | — | module | 1 | 368 | 320 | 298 | 278 | 320 | 278
MECH |  | MECH | — | Assembly + calibration + EOL test | — | module | 1 | 2185 | 1900 | 1767 | 1653 | 1900 | 1653
TOTAL_ELECTRONIC |  |  |  |  |  |  |  |  |  |  |  | 28860 | 22851
TOTAL_MODULE |  |  |  |  |  |  |  |  |  |  |  | 38931 | 31613
