vectivolt/DC-Modules/simulation-results/30kw/dpt-llc-metrics.csv

# dpt-llc 30kw — ngspice-46 | decks in spice/generated/dpt-llc-30kw-*.cir.
# kind=final is the RECOMMENDED network (LLC: Rg_off 0 + cs; PFC: exactly what cells.tsx draws); kind=sweep/sensitivity/
# control/drawn are informative and NOT gated. ONE die at the PER-POSITION current (see dpt-run.mjs current convention).
# Eoff_chan = CHANNEL dissipation: drain-node integral minus the device's datasheet Eoss at the settled voltage;
# the cs snubber sits at the package pins and bypasses the sense | and its charge is recovered at the ZVS turn-on.
# Eon_hard = the energy paid per transition IF ZVS does not complete. t_dead_req = n_die | leg*(Qoss(V)+cs*V)/I_toff.
# fingerprint: 30kw:FB n2/Lr5.6u/Cr7x33n/Lm56u/Coss580p | cs=330p | RgOn=4.7 RgOff=0 | Lloop=5nH | Voff=-3V | model=sic-1200-c3m.lib#07a229f69dac
# PASS = Vds_pk <= 85 % of 1200 V on REPETITIVE corners (at the 5 nH design loop) | <= 90 % on the +6 %-bus row
# (880 V is above the 860 V F.03 trip | so the bridge sees it only for the F.03 kill time) | AND vgs in [-8 | 19] V AND vgs_fw_pk <= 1.4 V (hot MIN Vgs(th) of the 1200 V class | not the typical 25 C threshold)
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
