vectivolt/DC-Modules/simulation-results/30kw/aux-flyback.csv

# ngspice-46 drawn-circuit deck (D4 rev E); D4E:ETD44/38:6:4:4/Lp345u±5%/Llk4+1u/Rcs0.28/CS1k-100p/CL33k-10n/DCLA1700V; NCP1252D functions modelled (LEB/latch/FB/3/fault timer) | leakage at acceptance max | typ controller timing (tolerance stacks live in d4-flyback); netlists spice/generated/{aux | tstep | clamp | short}-*.cir
case | VIN | sku | Lp_uH | v24_settle | v24_dip | v24_max | v15_min | Pin_W | Pout_W | eta | closure_pct | Psw_W | Pclamp_W | vds_max_V | vr_max_V | vc_max_V | ilm_max_A | B_mT | latched | verdict | note
aux-30kw-340 | 340 | 30kw | 345 | 22.86 | 22.12 | 22.88 | 14.5 | 53 | 47.3 | 0.893 | 0.56 | 0.53 | 1.69 | 584 | 574 | 243 | 2.22 | 115 | no | PASS | energy closes to 0.6 %
aux-30kw-560 | 560 | 30kw | 345 | 22.86 | 22.13 | 22.88 | 14.51 | 53.3 | 47.3 | 0.888 | 1.03 | 0.63 | 1.69 | 854 | 841 | 293 | 3.16 | 164 | no | PASS | energy closes to 1 %
aux-30kw-860 | 860 | 30kw | 345 | 22.87 | 22.13 | 22.89 | 14.51 | 53.5 | 47.3 | 0.884 | 1.36 | 0.7 | 1.69 | 1104 | 1093 | 243 | 2.21 | 115 | no | PASS | energy closes to 1.4 %
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
