vectivolt/DC-Modules/simulation-results/30kw/dclink-ripple.csv

# DC-link HF ripple share (ngspice-46); 30kw:FB n2/Lr5.6u/Cr7x33n/Lm56u/Coss580p; 5 × 470 µF per half; netlists spice/generated/dclink-30kw-*.cir
# DRAWN target: 16 × 1 µF bridge entry film + RC damper 2.2 µF + 0.33 Ω — current-coordination [DCLINK]/[SYNC] read this line
# ASSUMED: can ESR 0.15 Ω @100 kHz | ESL 20 nH | class 3.5 A rms (2.5 A @120 Hz × 1.4); film ESR 5 mΩ | ESL 14.999999999999998 nH | line 10 A rms; Vienna stub 59.99999999999999 nH; source behind 50 µH/rail
# GATE: per-can rms ≤ 0.8 × 3.5 A = 2.4 A | per-film rms ≤ 10 A
# cheapest variant holding every can ≤ 80 % of the 3.5 A class and every film ≤ 10 A at BOTH corners: film16u-bare-stud40n — 653 rupees/module @10k
corner | variant | bridge_film_uF | n_film | damper | stud_nH | P_sim_kW | Ibr_dc_A | Ibr_ac_rms_A | I_per_bridge_film_A | I_per_elyt_can_A | I_per_vienna_film_A | I_stud_ac_A | Vbus_p1_V | Vbus_p99_V | can_pct_of_class | film_pct_of_line | verdict | extra_films | rupees_at_10k
SER250-full-bus764 | as-drawn | 4 | 4 | no | 40 | 30.35 | 41.39 | 42.79 | 25.03 | 8.14 | 12.23 | 63.91 | 719 | 813 | 233 | 250 | OVER | 0 | 0
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
