vectivolt/DC-Modules/simulation-results/30kw/llc-envelope.csv

# ngspice-46 power-solved LLC magnetics envelope; 30kw:FB n2/Lr5.6u/Cr7x33n/Lm56u/Coss580p; bank × load at bus=min(830 | max(650 | 2·bank/0.95))
bank_V | bus_V | P_frac | P_target_W | P_sim_W | P_err_pct | mode | fsw_kHz | Im_pk_A | Ip_rms_A | Ip_pk_A | Isec_rms_A | Vcr_ac_pk_V | ZVS | legs_in_rails | Icomm_min_A | t_dead_need_ns | t_dead_used_ns | ZVS_at_120ns | ZVS_fail_legs
400 | 830 | 1 | 30000 | 30091 | 0.3 | PFM | 152.1 | 23.8 | 44.7 | 62.1 | 40.9 | 288 | 64/64 | YES | 37.3 | 35 | 120 | 64/64 | -
400 | 830 | 0.85 | 25500 | 25541 | 0.2 | PFM | 153 | 23.6 | 39.2 | 54.5 | 34.8 | 250 | 64/64 | YES | 35.9 | 36 | 120 | 64/64 | -
400 | 830 | 0.7 | 21000 | 21059 | 0.3 | PFM | 154.2 | 23.4 | 33.8 | 47.1 | 28.7 | 213 | 64/64 | YES | 34.5 | 38 | 120 | 64/64 | -
400 | 830 | 0.55 | 16500 | 16639 | 0.8 | PFM | 155.6 | 23.1 | 28.7 | 40.3 | 22.8 | 178 | 64/64 | YES | 32.6 | 40 | 120 | 64/64 | -
425 | 830 | 1 | 30000 | 30008 | 0 | PFM | 121.5 | 29.9 | 45.2 | 66.8 | 41.9 | 363 | 64/64 | YES | 29.7 | 44 | 120 | 64/64 | -
425 | 830 | 0.85 | 25500 | 25663 | 0.6 | PFM | 122.2 | 29.9 | 39.8 | 58.2 | 35.8 | 319 | 64/64 | YES | 29.7 | 44 | 120 | 64/64 | -
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
