vectivolt/DC-Modules/docs/reference/microchip-11kw-three-phase-pfc/changelog.md

# 11kW-three-phase-pfc-demonstration-application v1.0.0
* support for CH device 
* option to operate in high voltage and low voltage operation
* communication uses CAN Power board visualizer 
* new PWM scheme is introduced in this application

### Toolchain used for initial firmware version 1.0.0
* MPLAB X IDE version 6.20 and later - [Get latest Version](https://www.microchip.com/mplabx)
* XC-DSC compiler version 3.00 - [Get latest Version](https://www.microchip.com/xc16)
* MPLAB MCC Melody version 5.5.1 
* Device File Pack (DFP) version 1.15.378
	
&copy; 2025, Microchip Technology Inc.
