vectivolt/DC-Modules/boards/out-pdf/DC-Modules 60kW — Schematic Set (AC-DC + DC-DC + Control Card).pdf

A

C

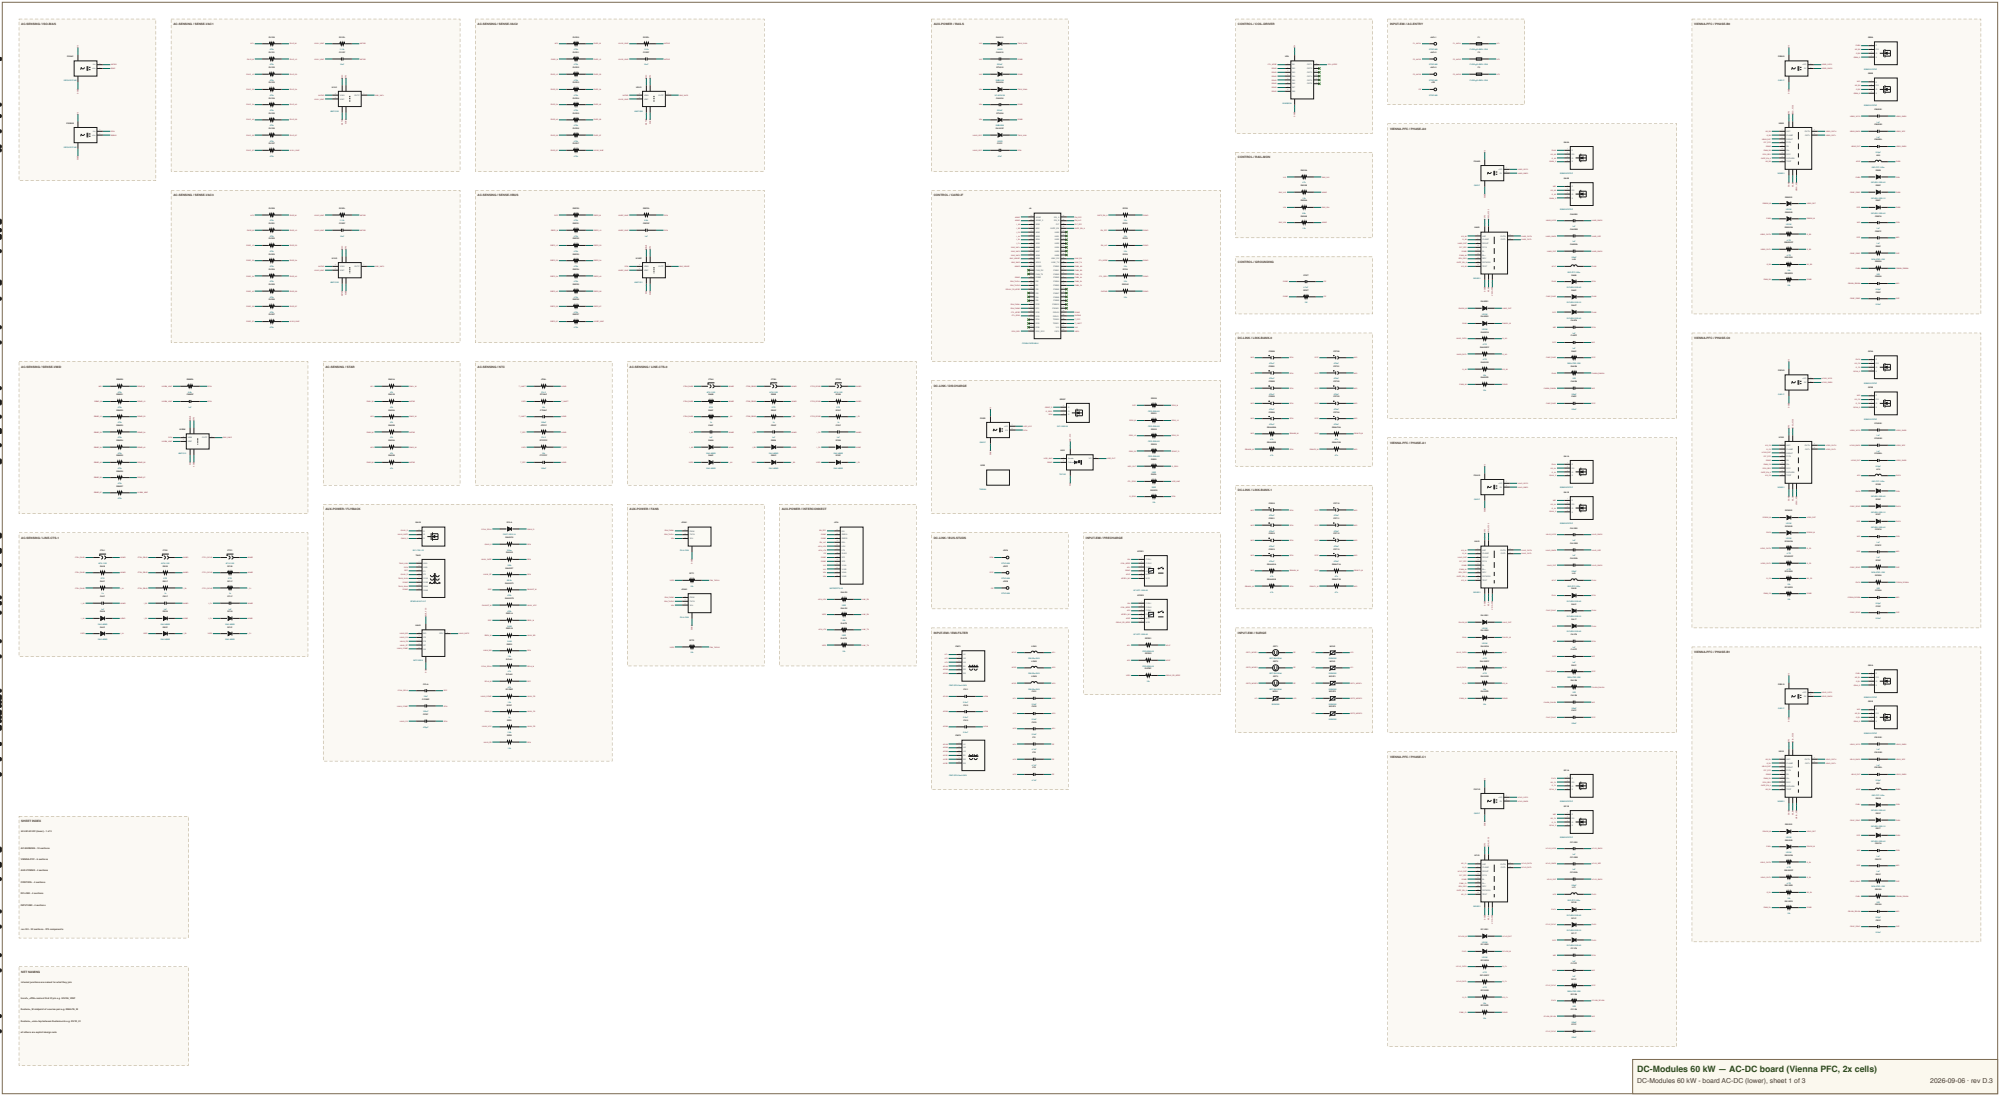
[picture p1: page 1]
CONTROL - 4 sections; RNS1A; RNS1B; RNS2A; RNS2B; RNS3A; RNS3B; VINN; VINP; OUTP; UIVV1; AMC1350; UIVV2; UIVV3; UIVBP; AMC131; CBPDF; RBPD0; RBPD1; RBPD2; RBPD3; RBPD4; RBPD5; RBPD6; RBPD7; RBPDL; UIVBM; CBMDF; RBMD0; RBMD1; RBMD2; RBMD3; RBMD4; RBMD5; RBMD6; RBMD7; RBMDL; ISO5V-RFC-6K; PS5BUS; CTINLF; CTPFCF; JTINL; JTPFC; RTINLP; RTPFCP; CTA0; ACX-1100; CTB0; CTC0; CTA1; CTB1; CTC1; QAUX; SIC-1700-1R; AXA; AXB; TAUX; UAUX; NCP1252A; CCLA; CCOMP; CCSF; DCLA; FAST-1200-1A; RAUXCS; RAUXG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

XFMR-AUX-FLY-C

60 kW AC-DC (lower) - 1 of 3

AC-SENSING - 10 sections

VIENNA-PFC - 6 sections

AUX-POWER - 4 sections

DC-LINK - 4 sections

INPUT-EMI - 4 sections

rev D.3 - 32 sections - 370 components NET NAMING

internal junctions are named for what they join

U<ref>_<PIN> node at that IC pin e.g. UIVOA_VINP

R<stem>_M midpoint of a series pair e.g. RBALTA_M

R<stem>_<nm> tap between R<stem>n/m e.g. RV1D_01

all others are explicit design nets

DC-Modules 60 kW — AC-DC board (Vienna PFC, 2x cells)

BANKS-SP / SP-MATRIX | BANKS-SP / BLEEDERS | BANKS-SP / BANK-A | BANKS-SP / BANK-B

# COMMS-HMI / CAN

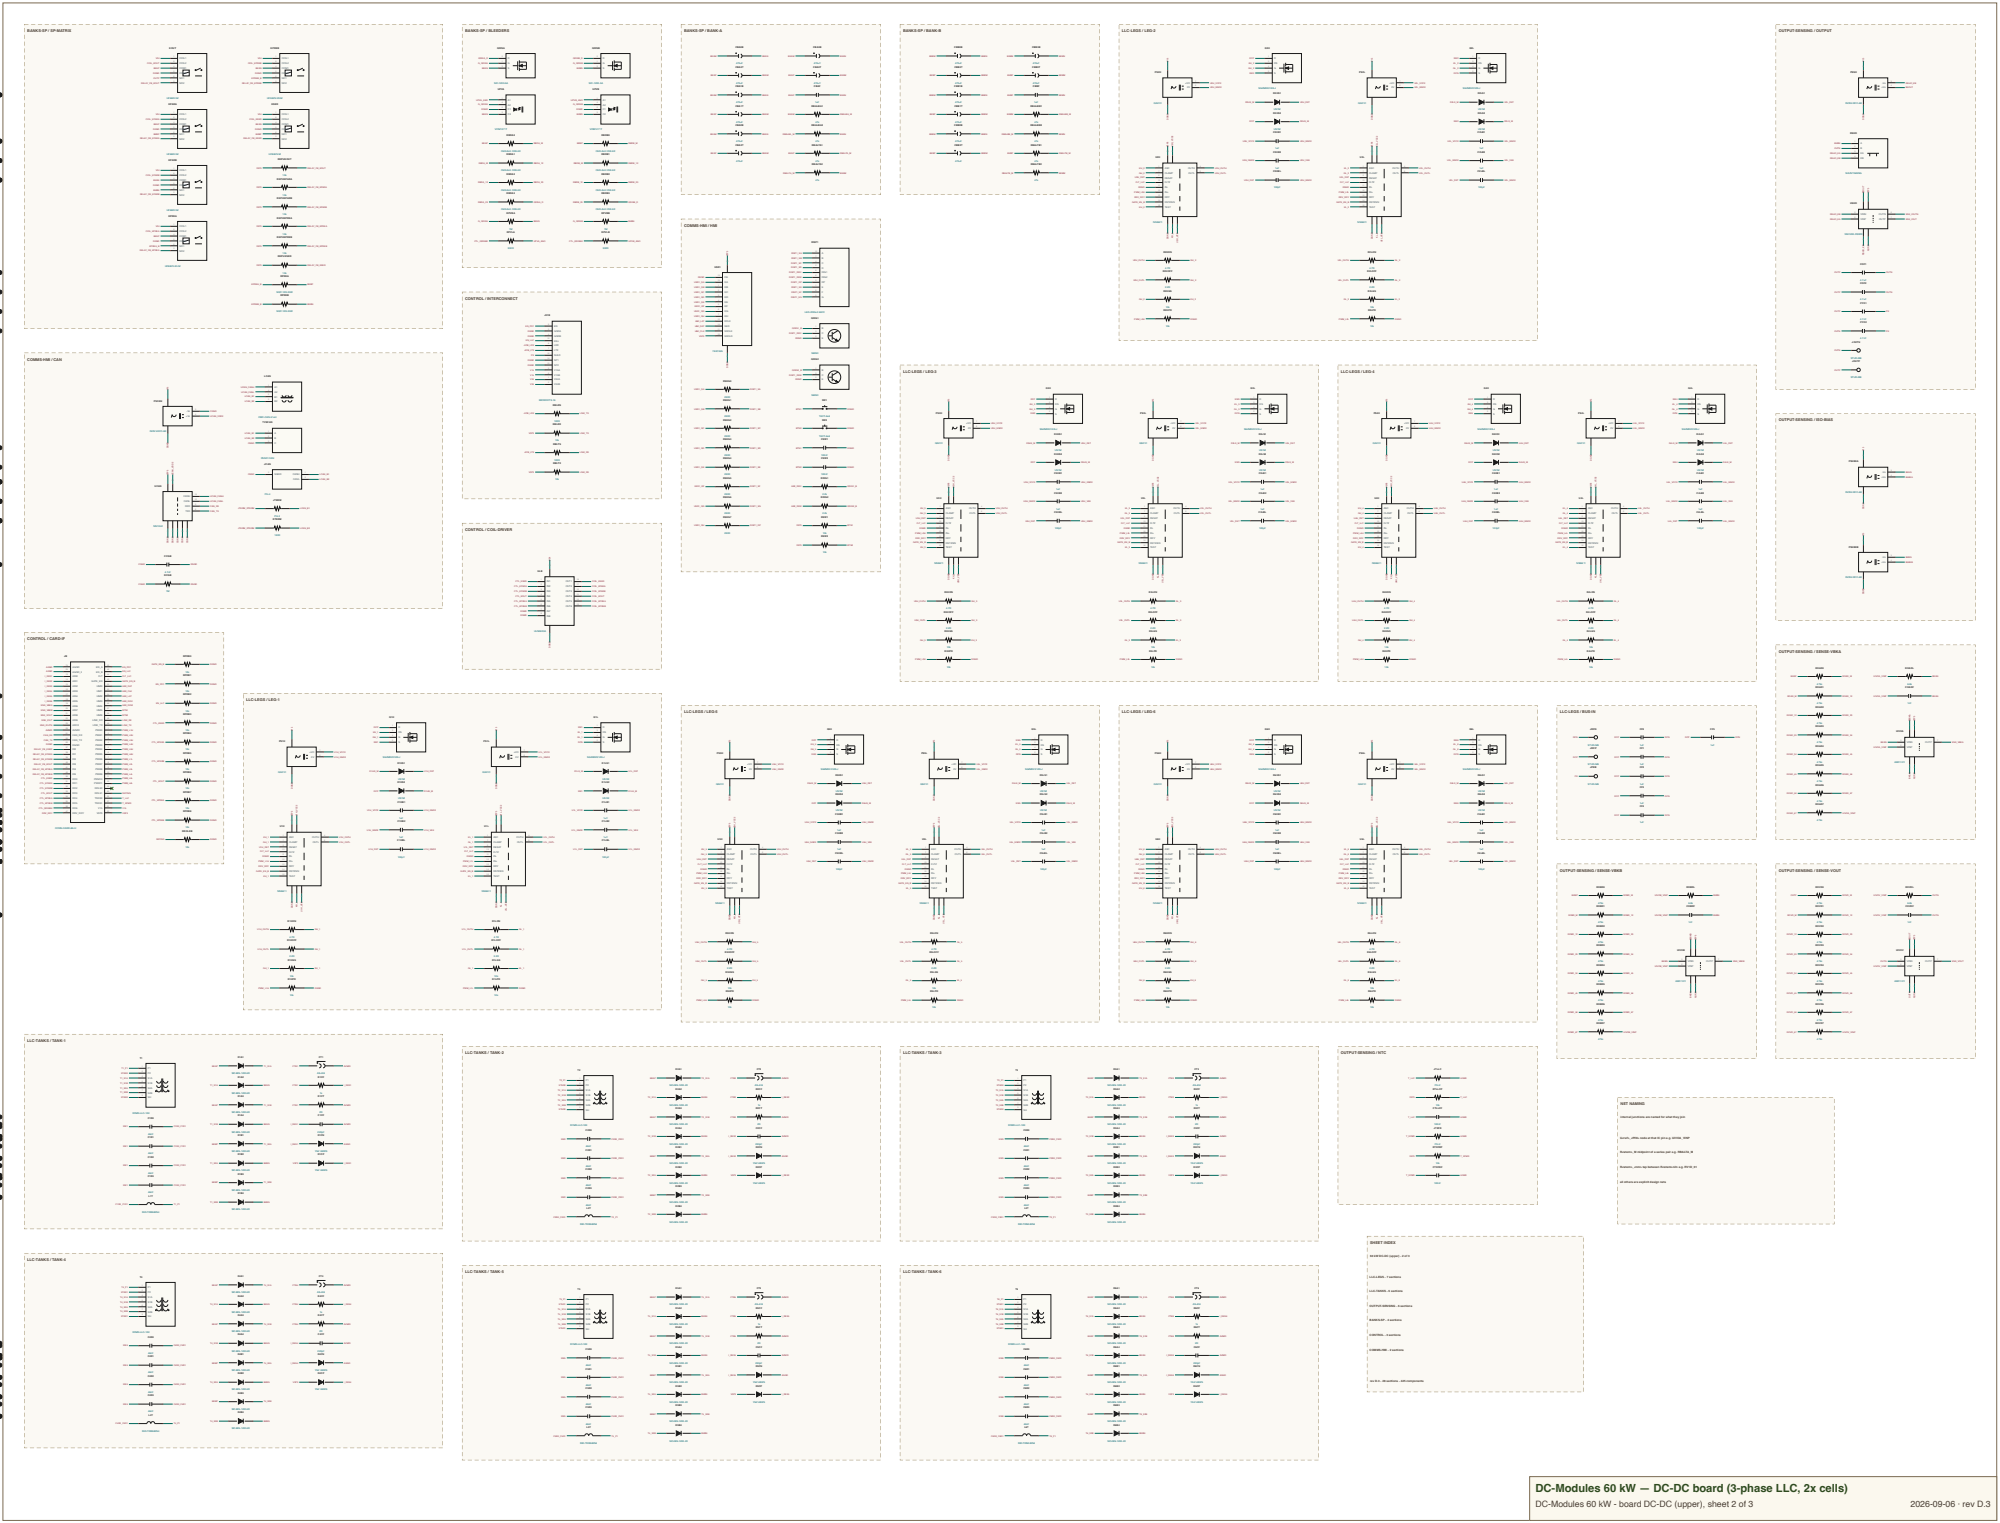
[picture p2: page 2]

OUTPUT-SENSING / ISO-BIAS

OUTPUT-SENSING / SENSE-VBKA

LLC-LEGS / BUS-IN

internal junctions are named for what they join

U<ref>_<PIN> node at that IC pin e.g. UIVOA_VINP

R<stem>_M midpoint of a series pair e.g. RBALTA_M

R<stem>_<nm> tap between R<stem>n/m e.g. RV1D_01

all others are explicit design nets

60 kW DC-DC (upper) - 2 of 3

DC-Modules 60 kW — DC-DC board (3-phase LLC, 2x cells)

# CONTROL / MCU

# CONTROL / SAFETY

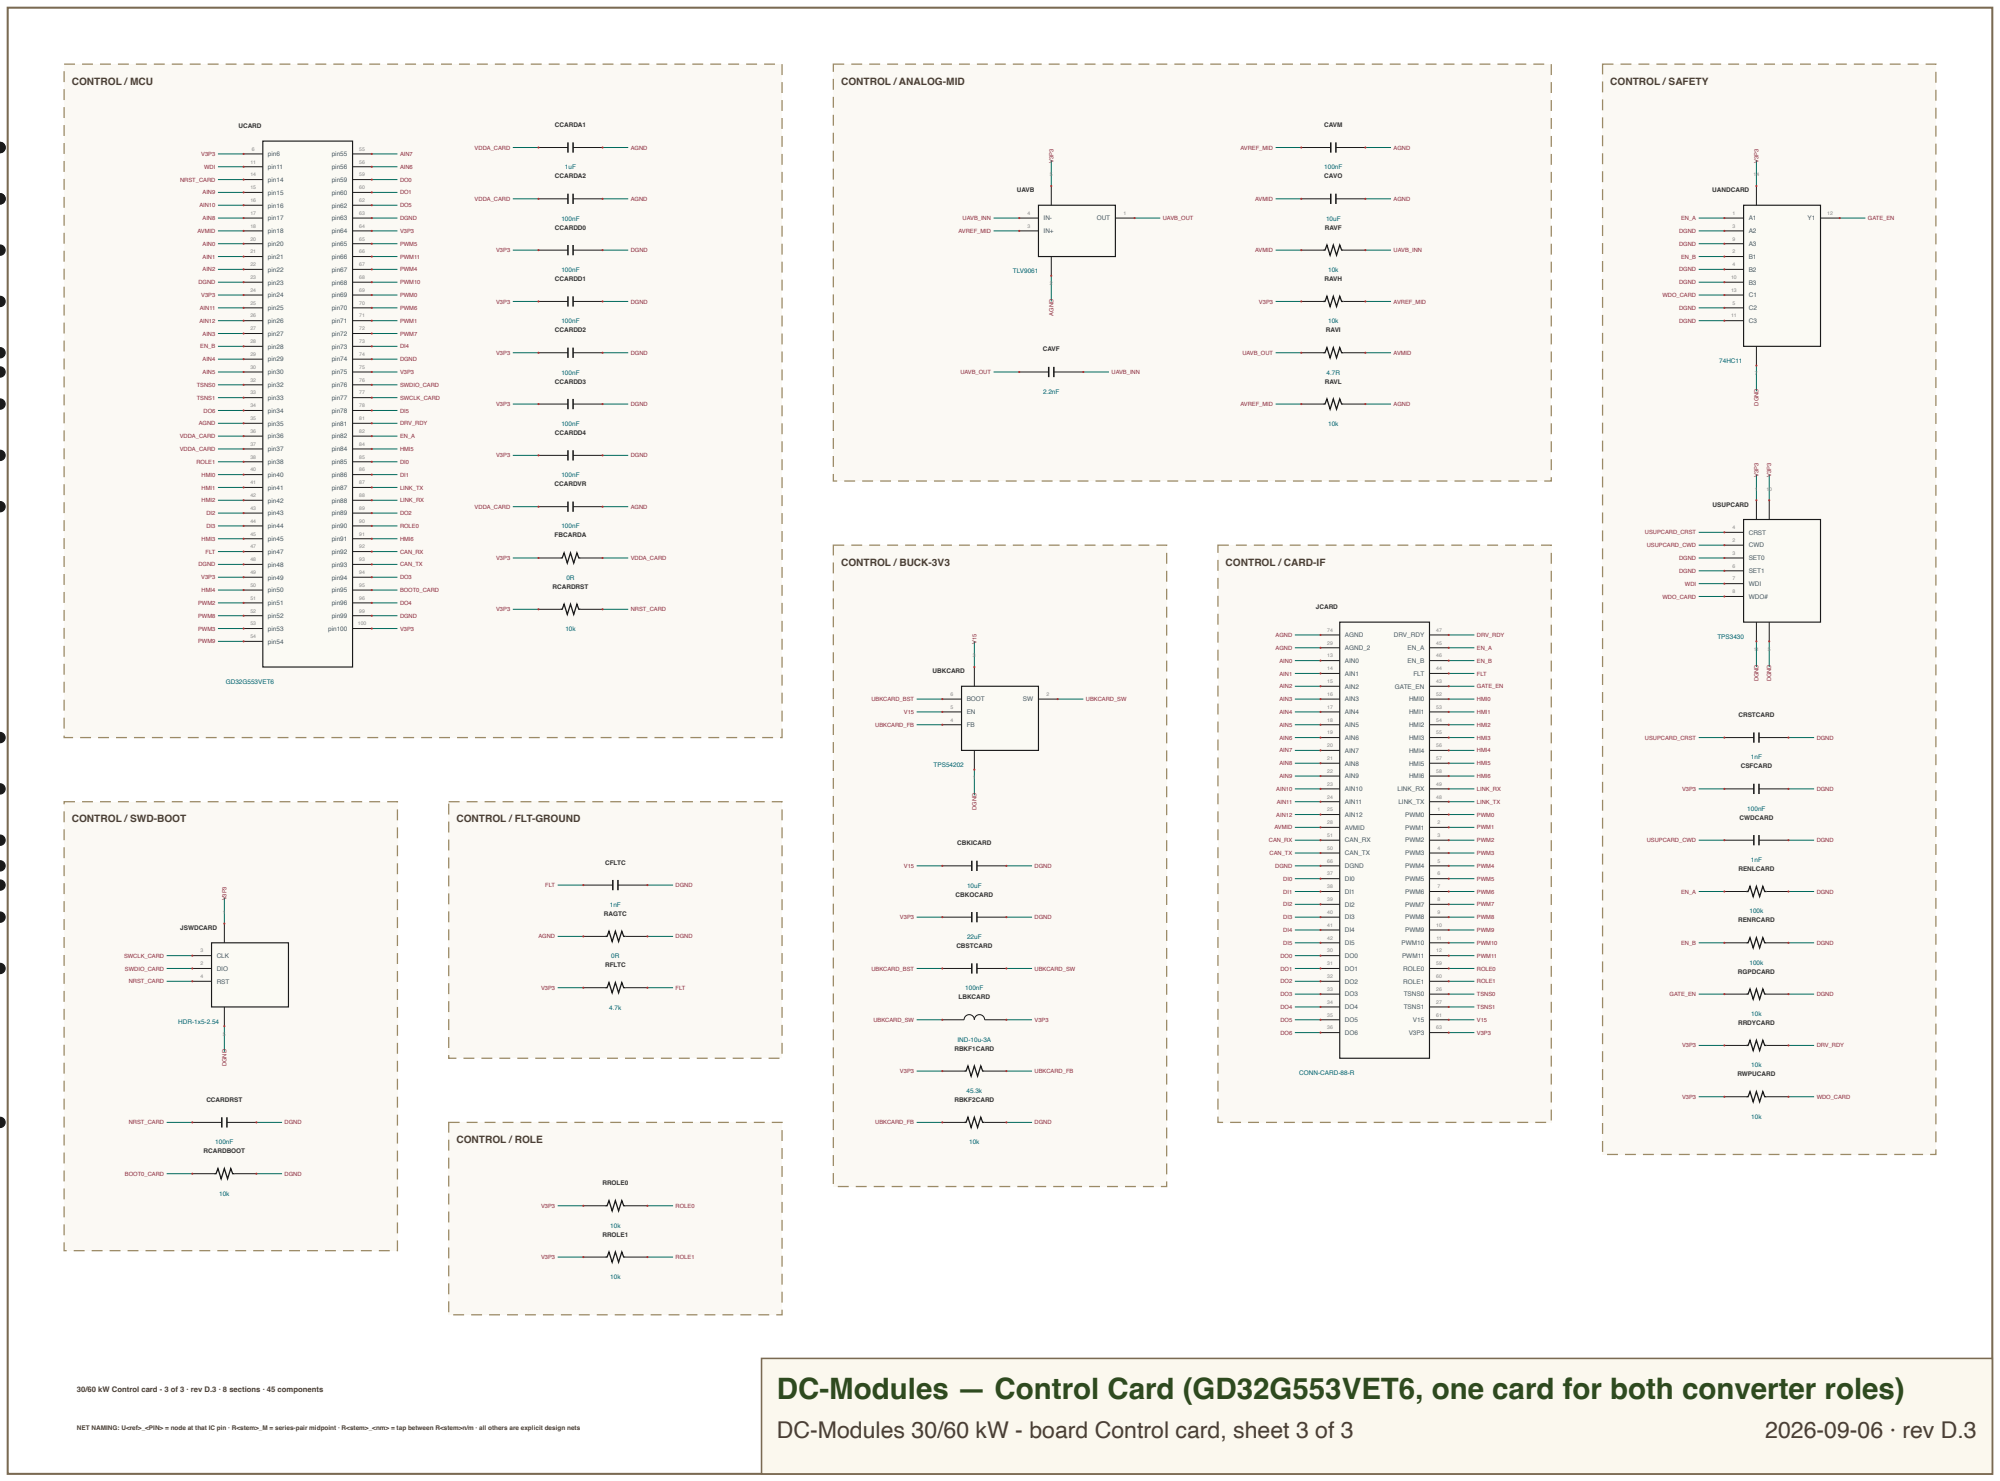
[picture p3: page 3]
CONTROL / BUCK-3V3; CONTROL / ROLE; pin6; pin11; pin14; pin15; pin16; pin17; pin18; pin20; pin21; pin22; pin23; pin24; pin25; pin26; pin27; pin28; pin29; pin30; pin32; pin33; pin34; pin35; pin36; pin37; pin38; pin40; pin41; pin42; pin43; pin44; pin45; pin47; pin48; pin49; pin50; pin51; pin52; pin53; pin54; pin55; pin56; pin59; pin60; pin62; pin63; pin64; pin65; pin66; pin67; pin68; pin69; pin70; pin71; pin72; pin73; pin74; pin75; pin76; pin77; pin78; pin81; pin82; pin84; pin85; pin86; pin87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

CONTROL / ANALOG-MID

CONTROL / CARD-IF

CONTROL / SWD-BOOT

CONTROL / FLT-GROUND

30/60 kW Control card - 3 of 3 · rev D.3 · 8 sections · 45 components

DC-Modules — Control Card (GD32G553VET6, one card for both converter roles)

NET NAMING: U<ref>_<PIN> = node at that IC pin · R<stem>_M = series-pair midpoint · R<stem>_<nm> = tap between R<stem>n/m · all others are explicit design nets
