vectivolt/DC-Modules/boards/out-pdf/DC-Modules 30kW AC-DC (Vienna PFC).pdf

A

C

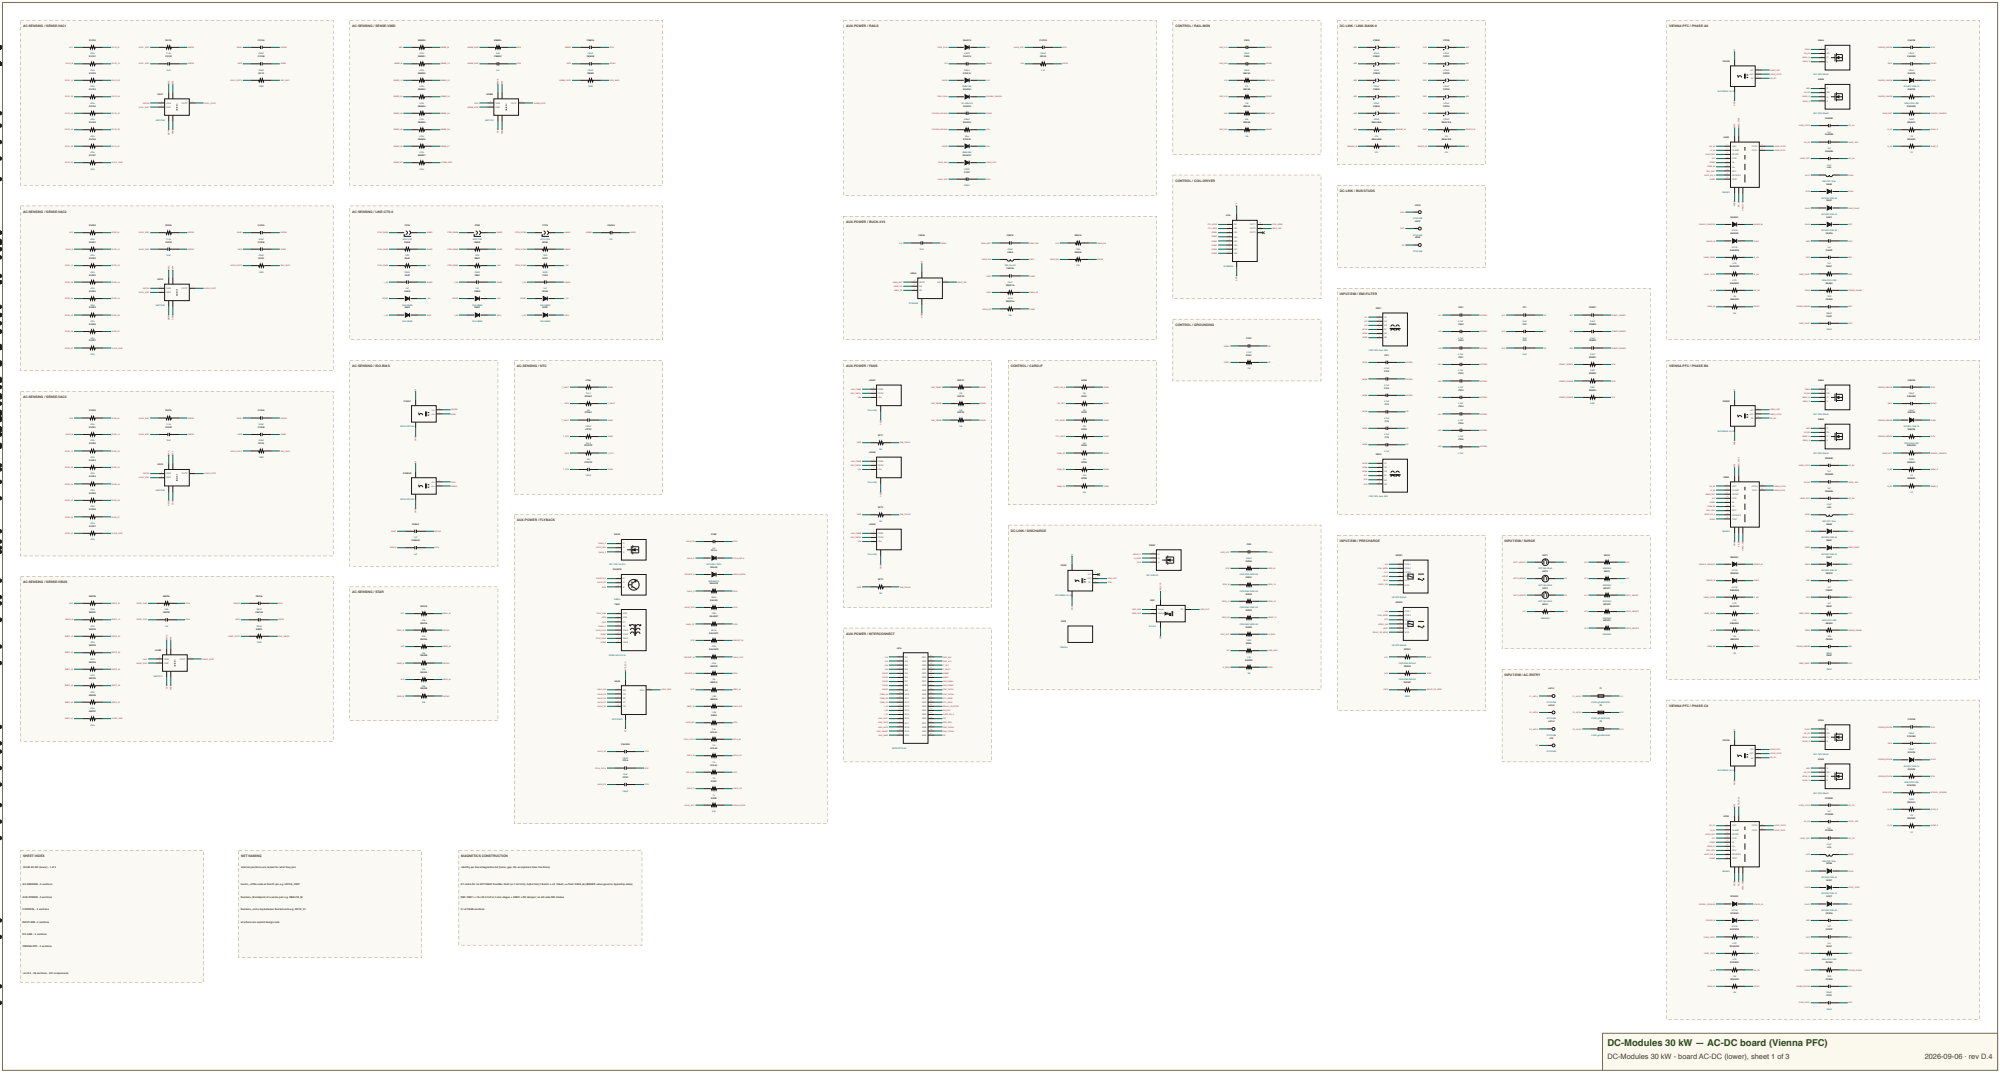
[picture p4: page 1]
CONTROL - 4 sections; RNS1A; RNS1B; RNS2A; RNS2B; RNS3A; RNS3B; VINN; VINP; OUTP; UIVV1; AMC1350; UIVV2; UIVV3; UIVBP; AMC131; CBPDF; CBPVA; CBPVB; RBPD0; RBPD1; RBPD2; RBPD3; RBPD4; RBPD5; RBPD6; RBPD7; RBPDL; RBPO; UIVBM; CBMDF; CBMVA; CBMVB; RBMD0; RBMD1; RBMD2; RBMD3; RBMD4; RBMD5; RBMD6; RBMD7; RBMDL; RBMO; ISO5V-RFC-6K; PS5BUS; C5BAC; C5BBUS; CTINLF; CTPFCF; JTINL; JTPFC; RTINLP; RTPFCP; CAVMA; CTA0; ACX-1100; CTB0; CTC0; QAUX; SIC-1700-1R-G15B ¹; QAUXFB; AXA; AXB; TAUX; UAUX; NCP1252D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

XFMR-AUX-FLY-E

30 kW AC-DC (lower) - 1 of 3

internal junctions are named for what they join

identity per docs/magnetics.md (turns, gap, litz, acceptance lines live there)

AC-SENSING - 9 sections

U<ref>_<PIN> node at that IC pin e.g. UIVOA_VINP

D1 LA0-LC0: 3x 0077908A7 KoolMu, N=39 (+/-1 lot trim), 3x(6x1mm) 18mm2 -> L0 169uH, >=75uH @82A pk (BIASED value governs ripple/trip calcs)

AUX-POWER - 5 sections

R<stem>_M midpoint of a series pair e.g. RBALTA_M

EMI: CMC1 + 12x X2 4.7uF in 3 star stages + CMC2 + RC damper; no AC-side DM chokes

R<stem>_<nm> tap between R<stem>n/m e.g. RV1D_01

Cr at TANK sections

INPUT-EMI - 4 sections

all others are explicit design nets

DC-LINK - 3 sections

VIENNA-PFC - 3 sections

rev D.4 - 28 sections - 341 components

DC-Modules 30 kW — AC-DC board (Vienna PFC)
