vectivolt/DC-Modules/boards/out-pdf/DC-Modules 30kW DC-DC (full-bridge LLC).pdf

B

A

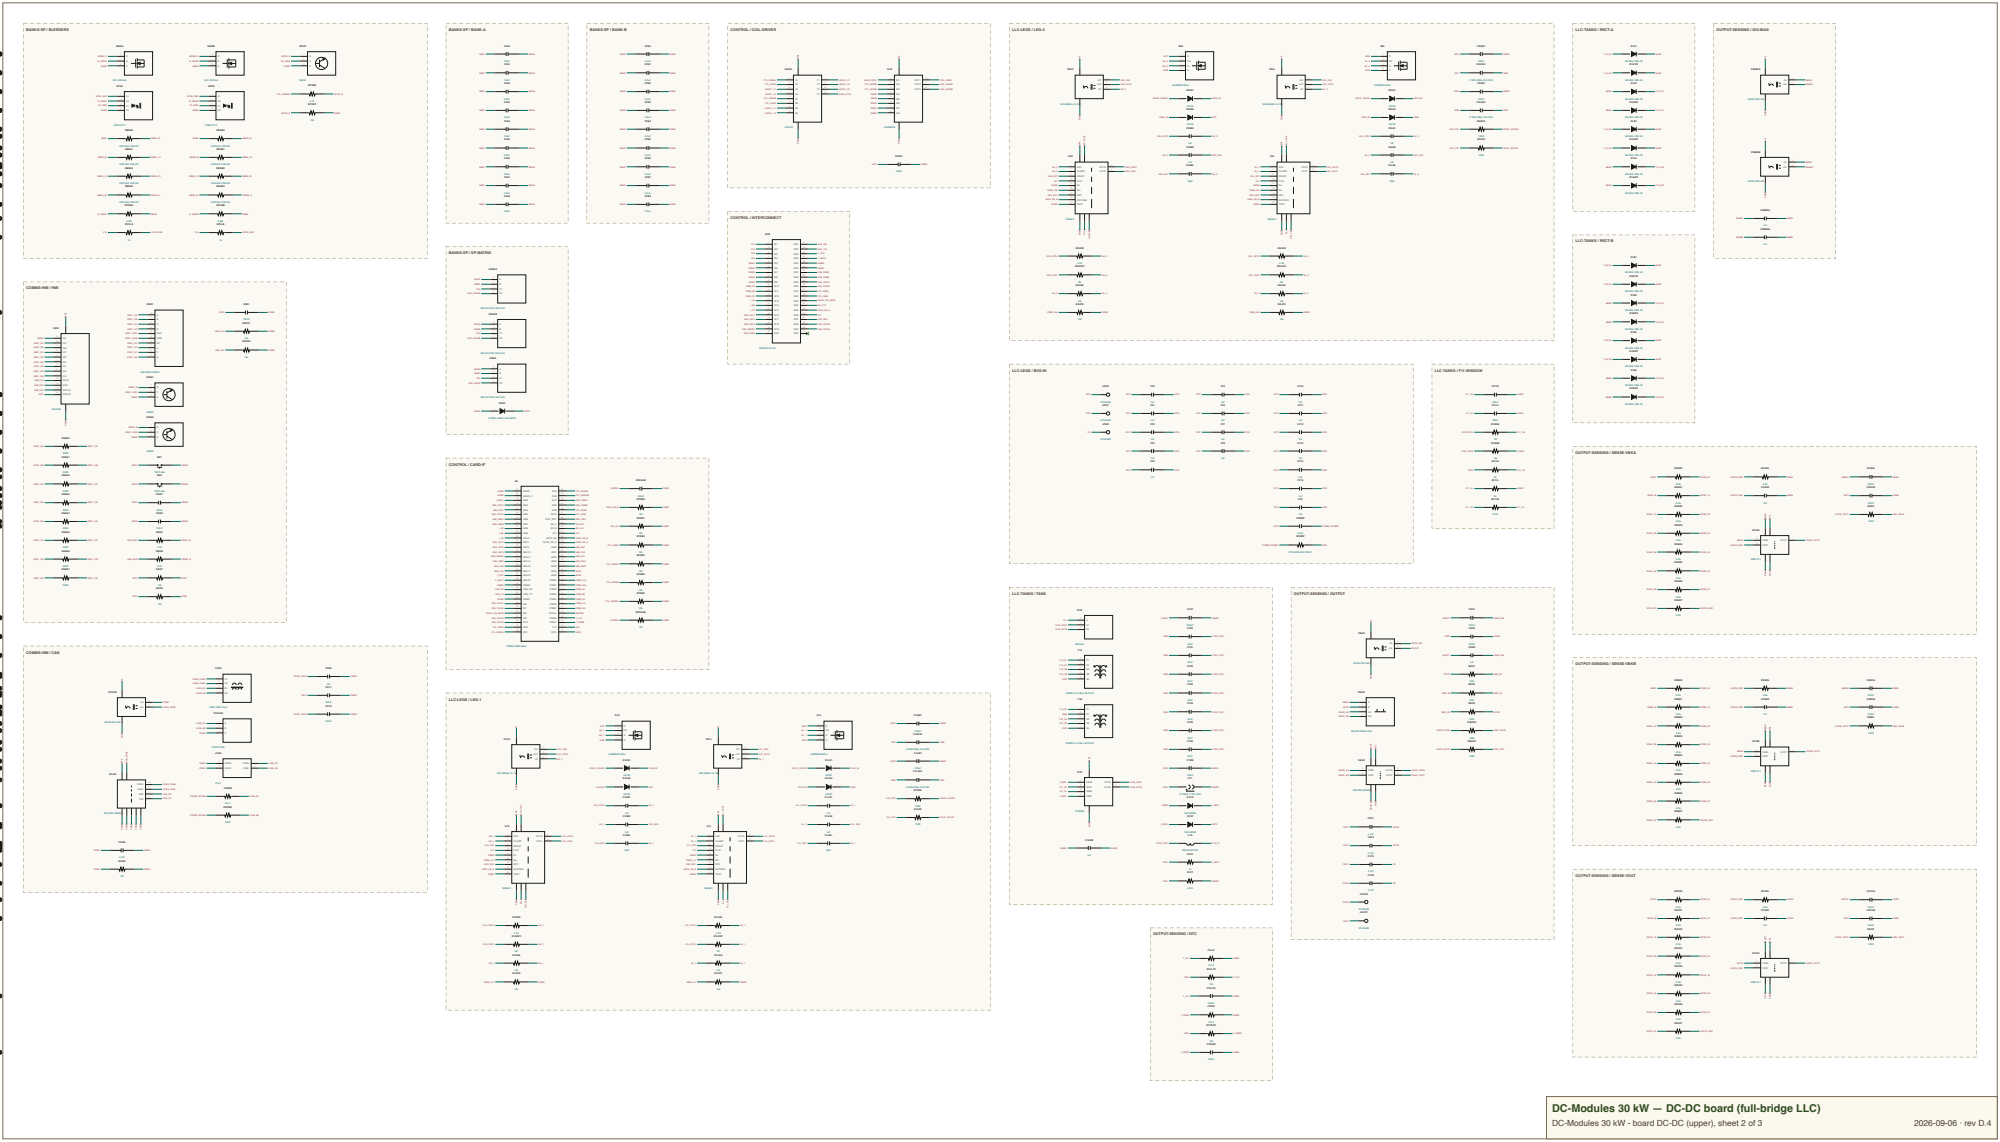
[picture p5: page 1]

DC-Modules 30 kW — DC-DC board (full-bridge LLC)
