vectivolt/DC-Modules/boards/out-pdf/DC-Modules 40kW AC-DC (Vienna PFC).pdf

# AC-SENSING / SENSE-VAC1

# AC-SENSING / SENSE-VAC2

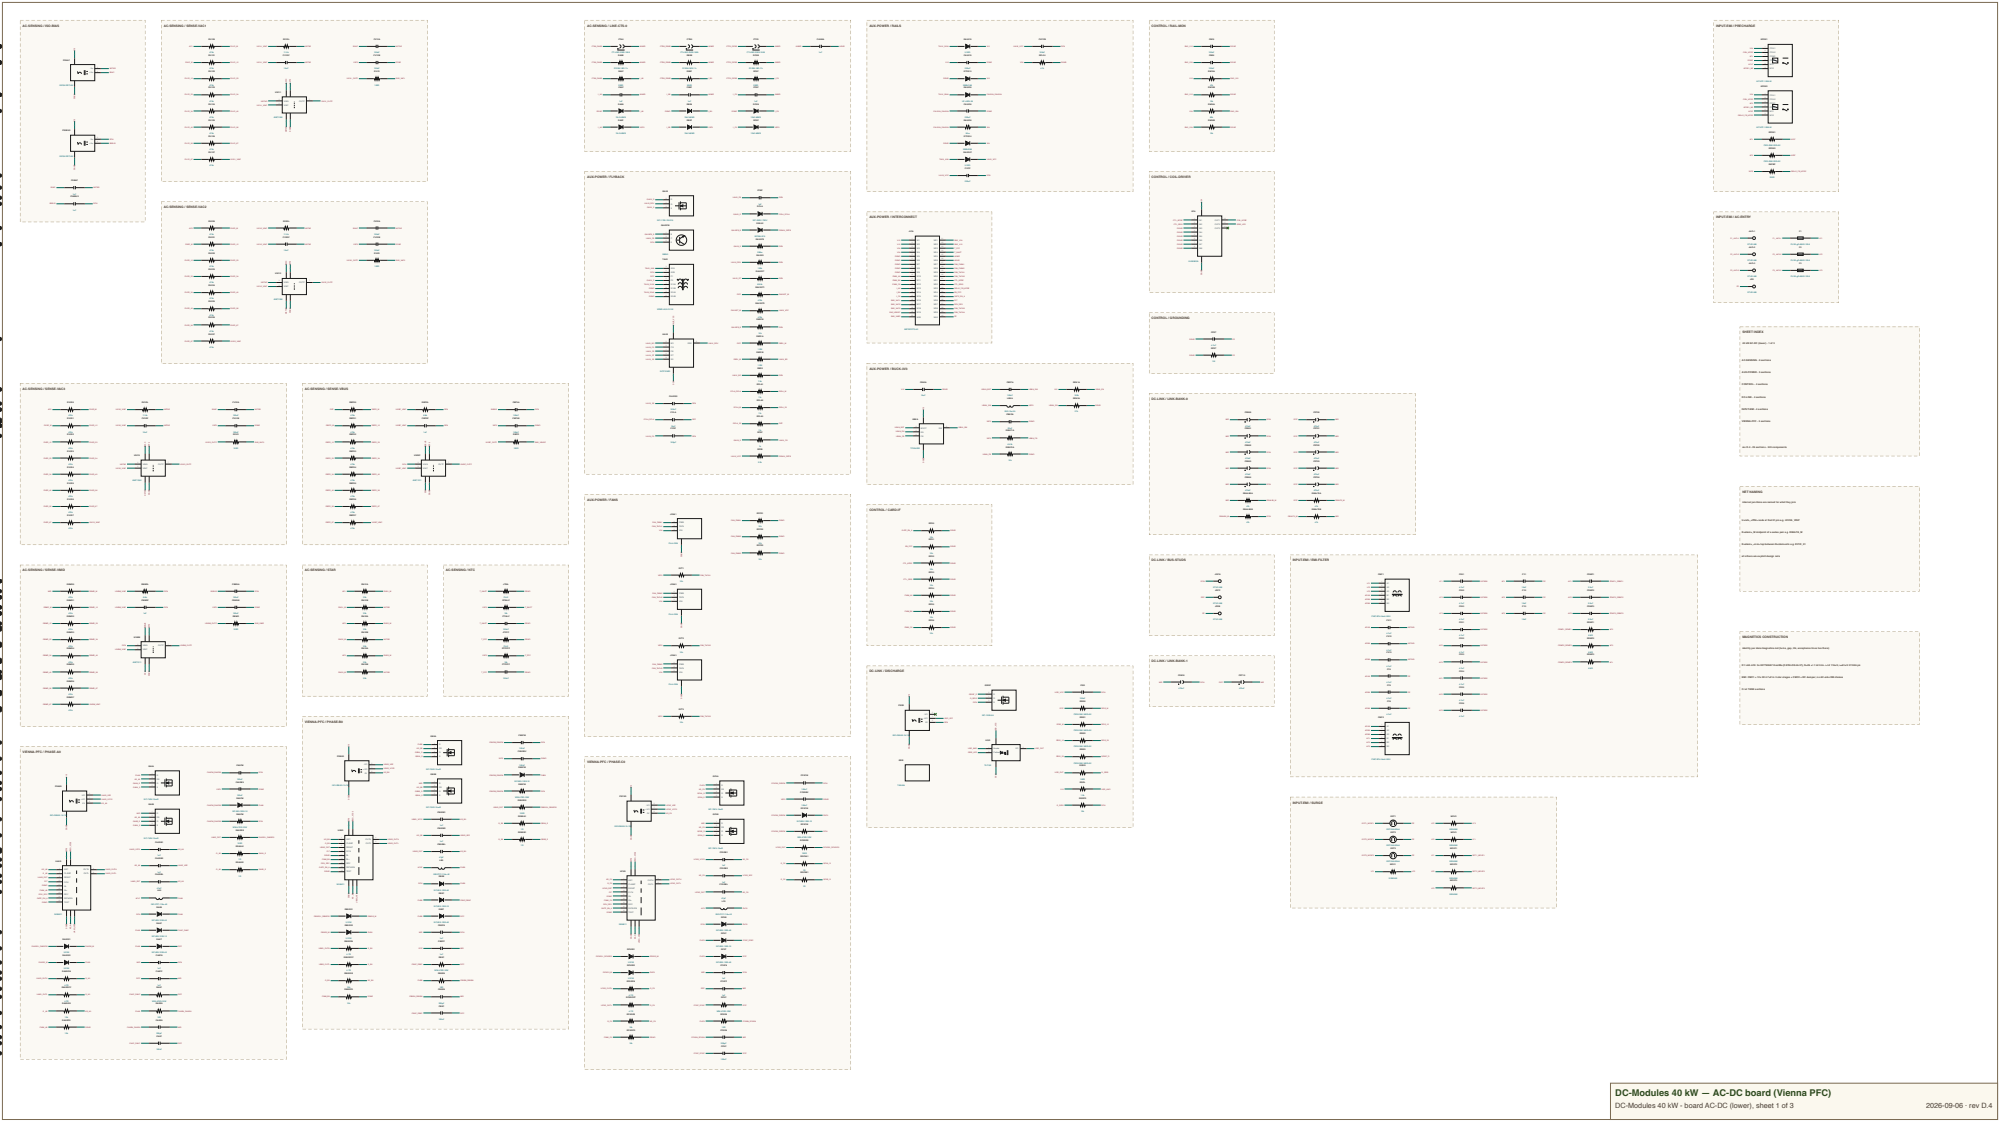
[picture p6: page 1]
SHEET INDEX; CONTROL - 4 sections; NET NAMING; MAGNETICS CONSTRUCTION; AC-SENSING / SENSE-VAC3; AC-SENSING / SENSE-VBUS; CONTROL / GROUNDING; RNS1A; RNS1B; RNS2A; RNS2B; RNS3A; RNS3B; VINN; VINP; OUTP; UIVV1; AMC1350; UIVV2; UIVV3; UIVBP; AMC1311; CBPDF; CBPVA; CBPVB; RBPD0; RBPD1; RBPD2; RBPD3; RBPD4; RBPD5; RBPD6; RBPD7; RBPDL; RBPO; UIVBM; CBMDF; CBMVA; CBMVB; RBMD0; RBMD1; RBMD2; RBMD3; RBMD4; RBMD5; RBMD6; RBMD7; RBMDL; RBMO; ISO5V-RFC-6K; PS5BUS; C5BAC; C5BBUS; CTINLF; CTPFCF; JTINL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

AC-SENSING / ISO-BIAS

AC-SENSING / LINE-CTS-0

AUX-POWER / RAILS

CONTROL / RAIL-MON

INPUT-EMI / PRECHARGE

AUX-POWER / FLYBACK

CONTROL / COIL-DRIVER

AUX-POWER / INTERCONNECT

INPUT-EMI / AC-ENTRY

XFMR-AUX-FLY-E

40 kW AC-DC (lower) - 1 of 3

AC-SENSING - 9 sections

AUX-POWER / BUCK-3V3

AUX-POWER - 5 sections

DC-LINK / LINK-BANK-0

DC-LINK - 4 sections

INPUT-EMI - 4 sections

VIENNA-PFC - 3 sections

rev D.4 - 29 sections - 343 components

AUX-POWER / FANS

internal junctions are named for what they join

CONTROL / CARD-IF

U<ref>_<PIN> node at that IC pin e.g. UIVOA_VINP

R<stem>_M midpoint of a series pair e.g. RBALTA_M

R<stem>_<nm> tap between R<stem>n/m e.g. RV1D_01

all others are explicit design nets

DC-LINK / BUS-STUDS

INPUT-EMI / EMI-FILTER

AC-SENSING / SENSE-VMID

AC-SENSING / STAR

AC-SENSING / NTC

identity per docs/magnetics.md (turns, gap, litz, acceptance lines live there)

DC-LINK / LINK-BANK-1

D1 LA0-LC0: 5x 0077908A7 KoolMu (CATALOG AL37), N=26 +/-1 lot trim -> L0 116uH, >=61uH @104A pk

DC-LINK / DISCHARGE

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

Cr at TANK sections

VIENNA-PFC / PHASE-B0

VIENNA-PFC / PHASE-A0

VIENNA-PFC / PHASE-C0

INPUT-EMI / SURGE

DC-Modules 40 kW — AC-DC board (Vienna PFC)
