vectivolt/DC-Modules/boards/out-pdf/DC-Modules 50kW AC-DC (Vienna PFC, liquid).pdf

AC-SENSING / STAR | AC-SENSING / SENSE-VAC1
AC-SENSING / SENSE-VAC2 | AC-SENSING / SENSE-VAC3

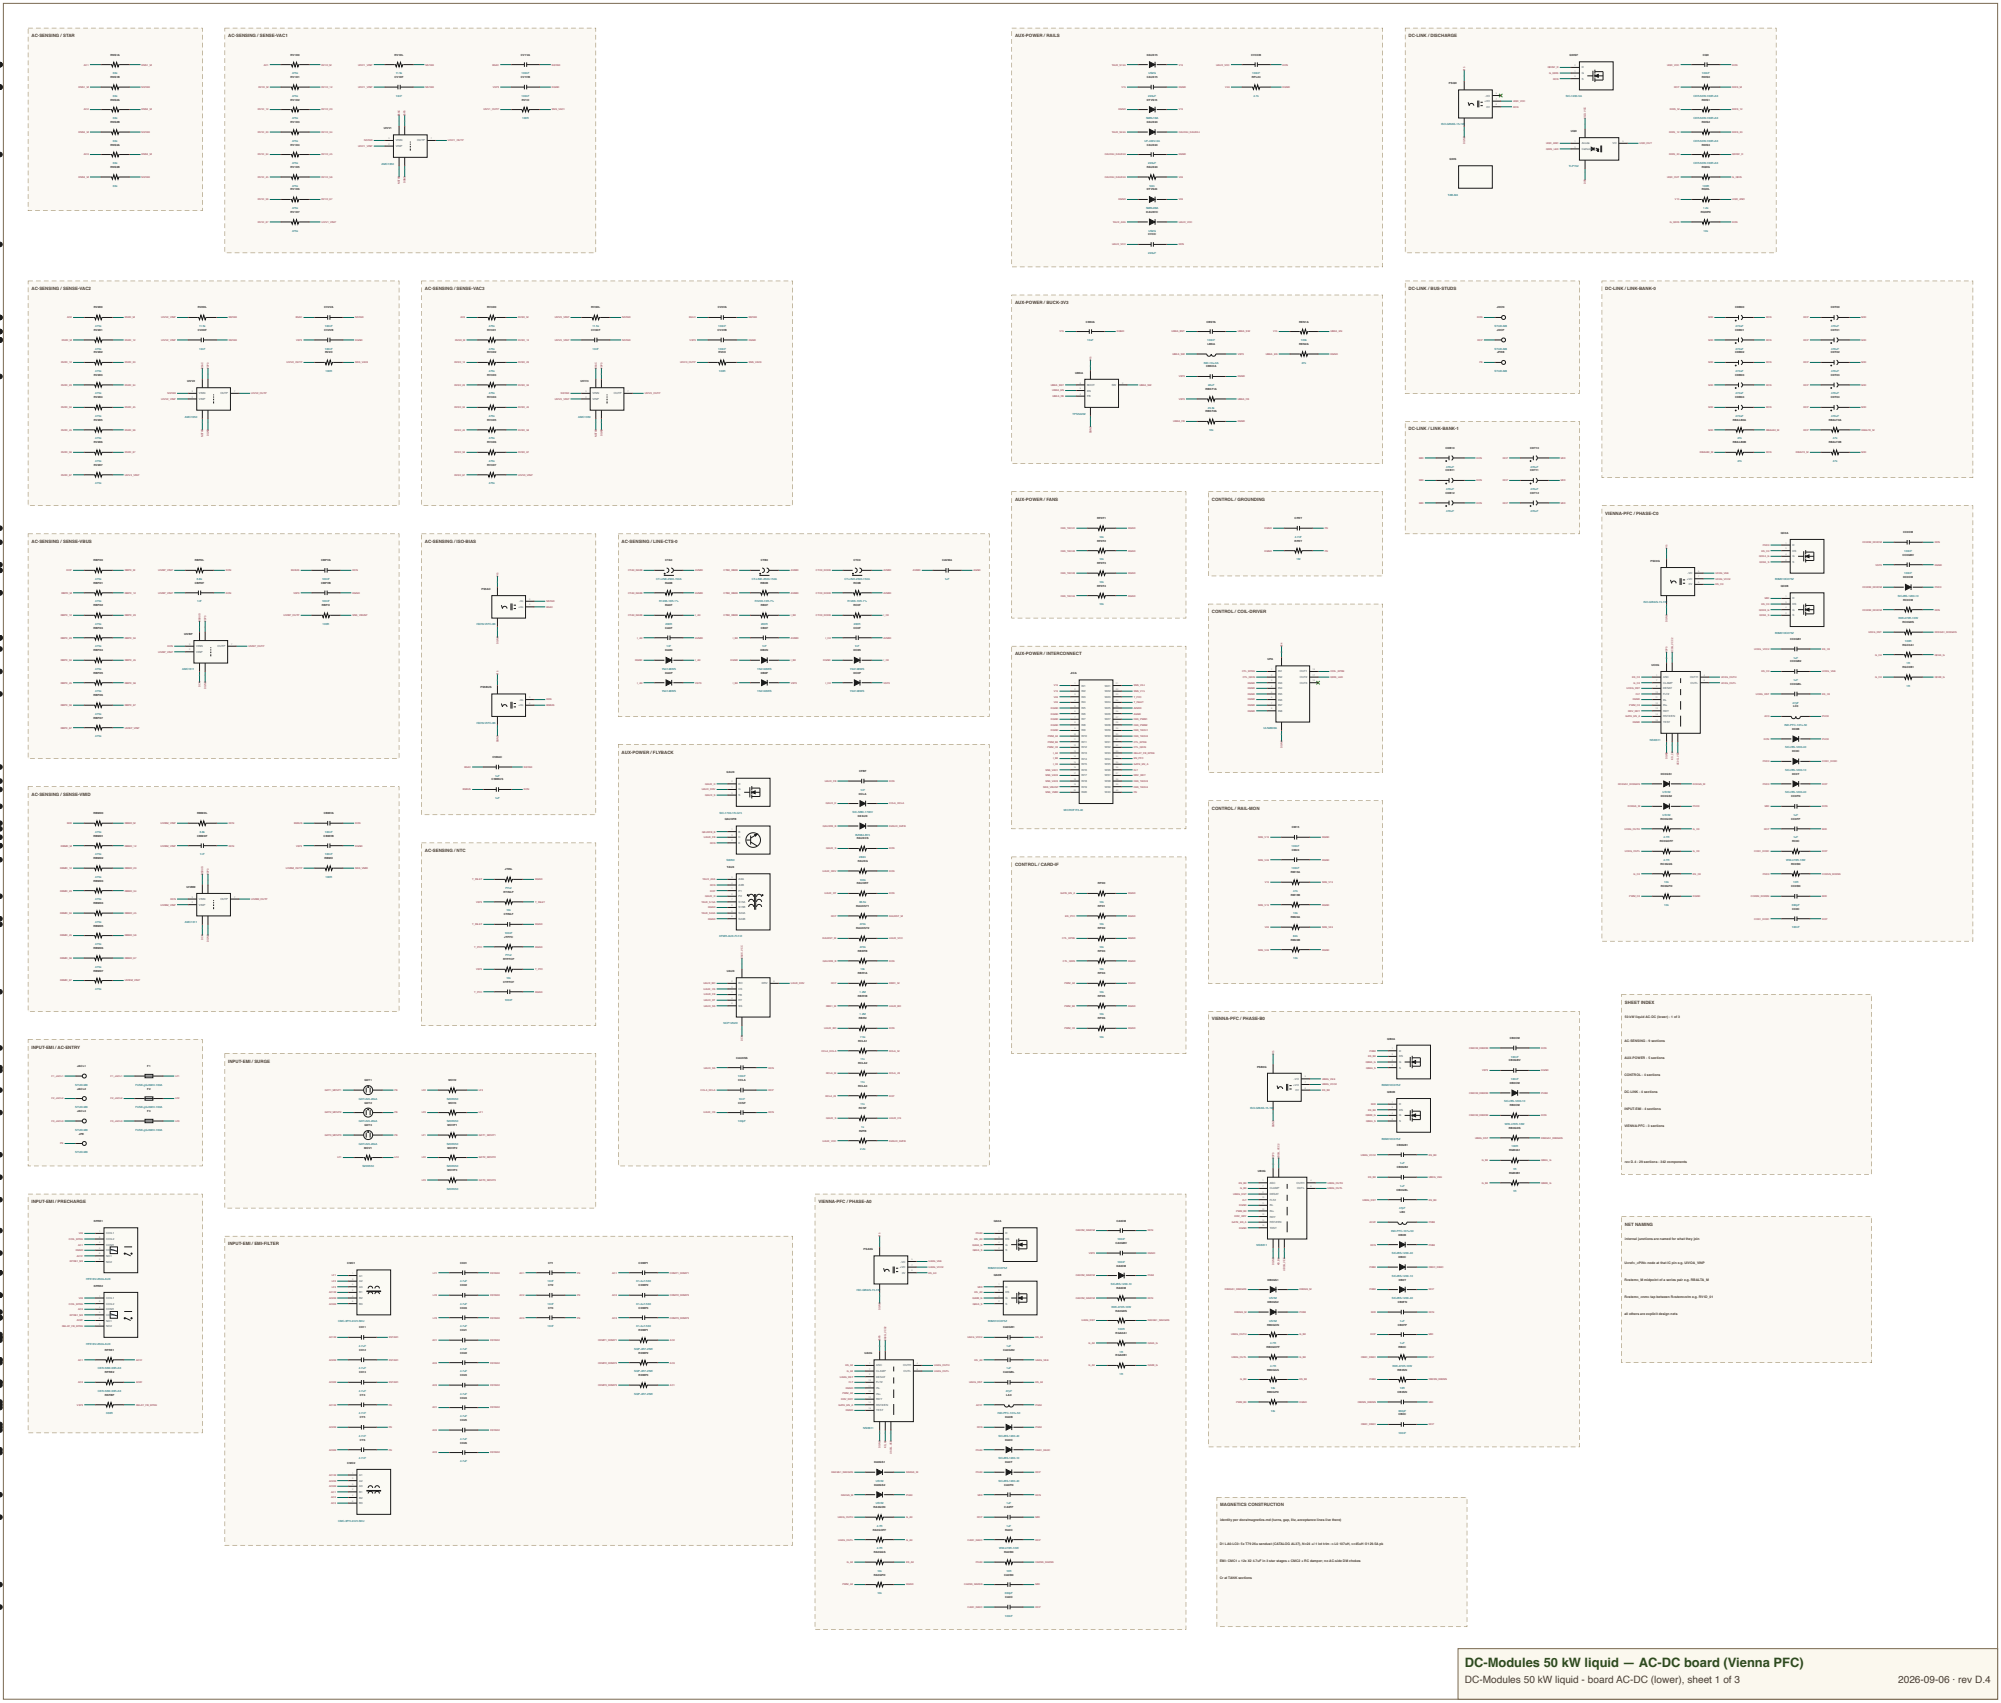
[picture p7: page 1]
SHEET INDEX; CONTROL - 4 sections; NET NAMING; MAGNETICS CONSTRUCTION; CONTROL / GROUNDING; DC-LINK / BUS-STUDS; DC-LINK / LINK-BANK-0; INPUT-EMI / PRECHARGE; VIENNA-PFC / PHASE-A0; RNS1A; RNS1B; RNS2A; RNS2B; RNS3A; RNS3B; VINN; VINP; OUTP; UIVV1; AMC1350; UIVV2; UIVV3; UIVBP; AMC1311; CBPDF; CBPVA; CBPVB; RBPD0; RBPD1; RBPD2; RBPD3; RBPD4; RBPD5; RBPD6; RBPD7; RBPDL; RBPO; UIVBM; CBMDF; CBMVA; CBMVB; RBMD0; RBMD1; RBMD2; RBMD3; RBMD4; RBMD5; RBMD6; RBMD7; RBMDL; RBMO; ISO5V-RFC-6K; PS5BUS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

AUX-POWER / RAILS

DC-LINK / DISCHARGE

AUX-POWER / BUCK-3V3

DC-LINK / LINK-BANK-1

AUX-POWER / FANS

VIENNA-PFC / PHASE-C0

AC-SENSING / SENSE-VBUS

AC-SENSING / ISO-BIAS

AC-SENSING / LINE-CTS-0

CONTROL / COIL-DRIVER

AUX-POWER / INTERCONNECT

AUX-POWER / FLYBACK

AC-SENSING / SENSE-VMID

CONTROL / RAIL-MON

AC-SENSING / NTC

CONTROL / CARD-IF

XFMR-AUX-FLY-E

50 kW liquid AC-DC (lower) - 1 of 3

VIENNA-PFC / PHASE-B0

AC-SENSING - 9 sections

INPUT-EMI / AC-ENTRY

AUX-POWER - 5 sections

INPUT-EMI / SURGE

DC-LINK - 4 sections

INPUT-EMI - 4 sections

VIENNA-PFC - 3 sections

rev D.4 - 29 sections - 342 components

internal junctions are named for what they join

INPUT-EMI / EMI-FILTER

U<ref>_<PIN> node at that IC pin e.g. UIVOA_VINP

R<stem>_M midpoint of a series pair e.g. RBALTA_M

R<stem>_<nm> tap between R<stem>n/m e.g. RV1D_01

all others are explicit design nets

identity per docs/magnetics.md (turns, gap, litz, acceptance lines live there)

D1 LA0-LC0: 5x T79 26u sendust (CATALOG AL37), N=24 +/-1 lot trim -> L0 107uH, >=45uH @129.5A pk

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

Cr at TANK sections

DC-Modules 50 kW liquid — AC-DC board (Vienna PFC)
