vectivolt/DC-Modules/boards/out-pdf/DC-Modules 50kW-Air AC-DC (Vienna PFC).pdf

# AC-SENSING / SENSE-VAC1

# AC-SENSING / SENSE-VAC2

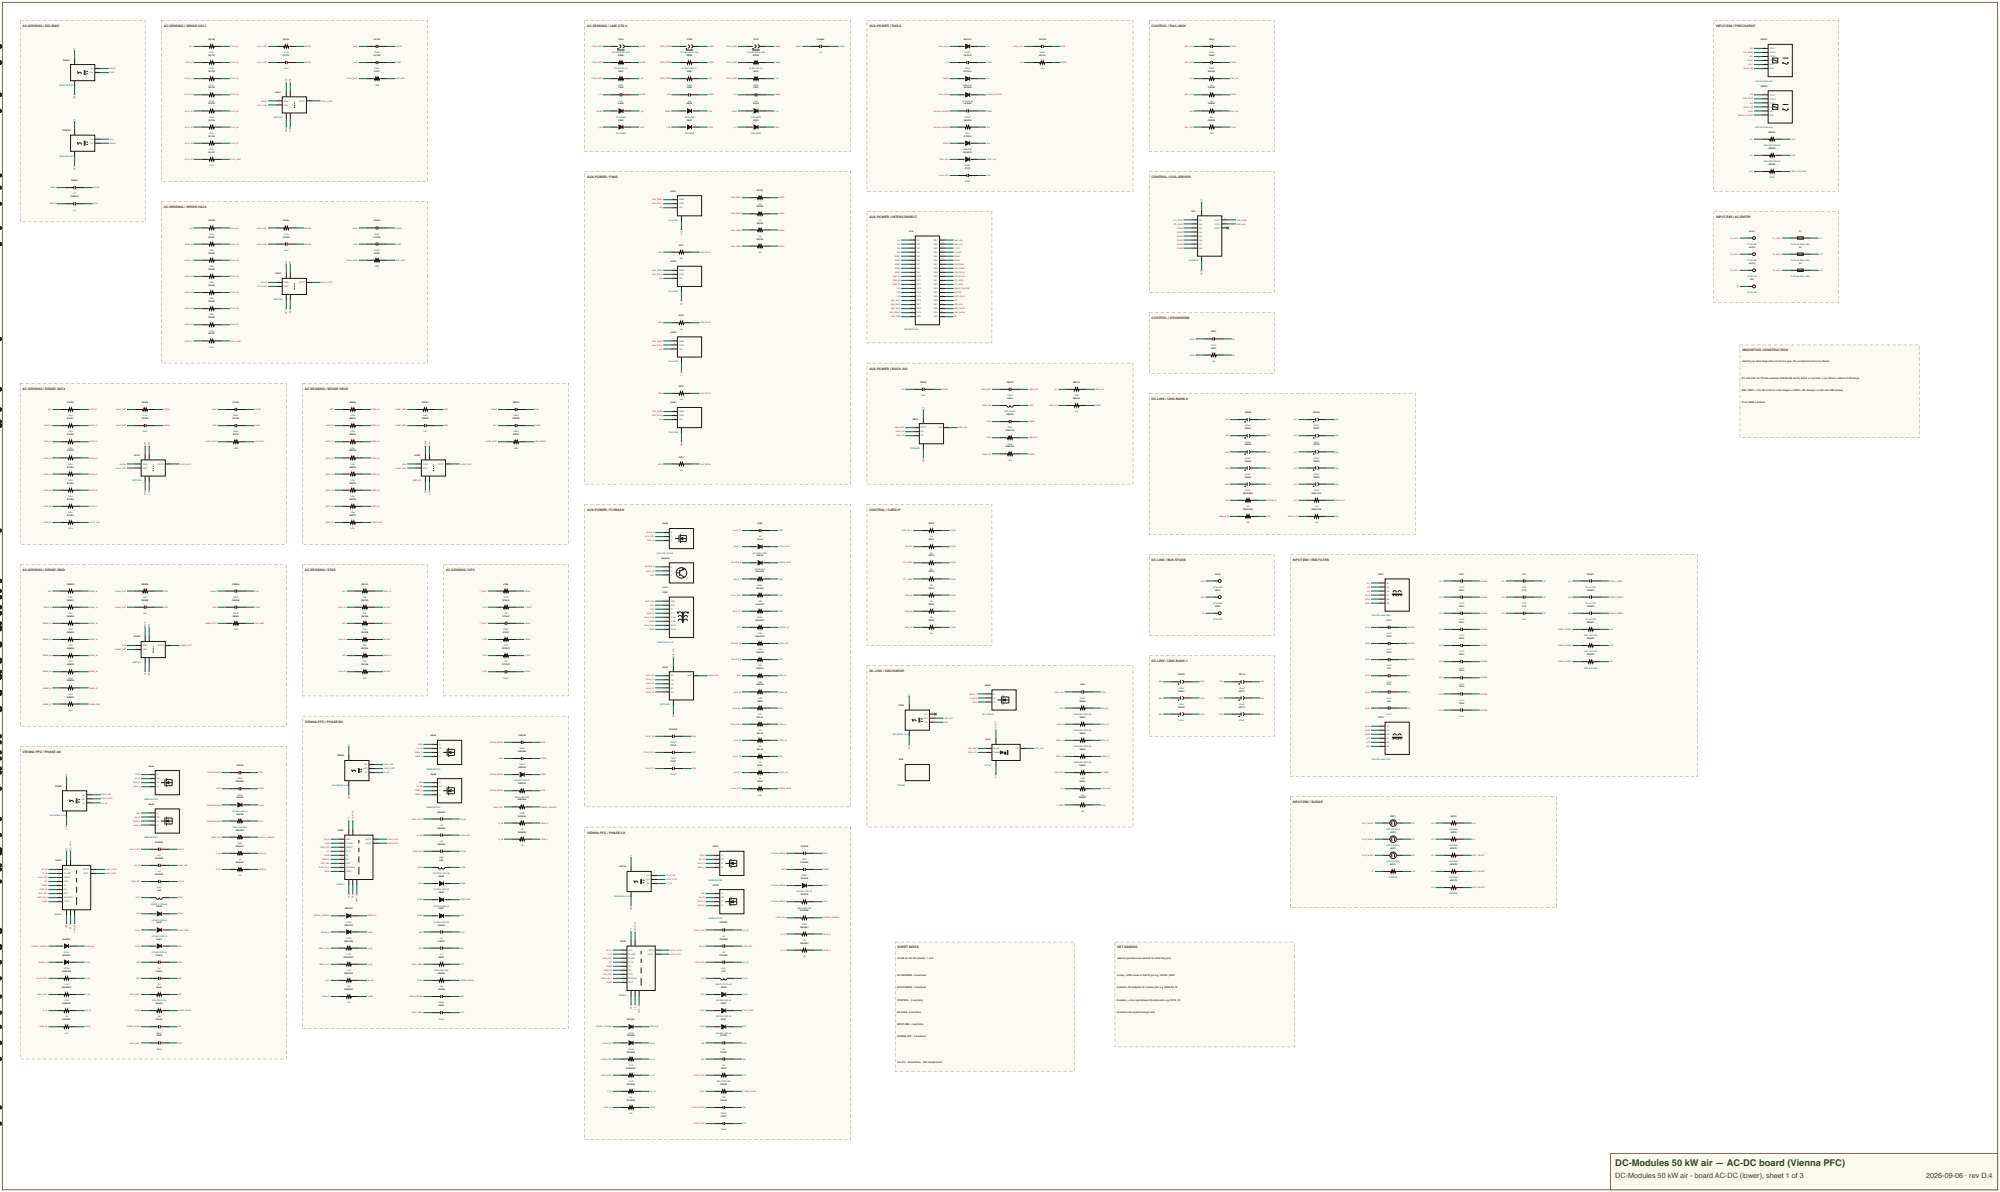
[picture p8: page 1]
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

AC-SENSING / ISO-BIAS

AC-SENSING / LINE-CTS-0

AUX-POWER / RAILS

CONTROL / RAIL-MON

INPUT-EMI / PRECHARGE

AUX-POWER / FANS

CONTROL / COIL-DRIVER

AUX-POWER / INTERCONNECT

INPUT-EMI / AC-ENTRY

identity per docs/magnetics.md (turns, gap, litz, acceptance lines live there)

AUX-POWER / BUCK-3V3

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

DC-LINK / LINK-BANK-0

Cr at TANK sections

AUX-POWER / FLYBACK

CONTROL / CARD-IF

DC-LINK / BUS-STUDS

INPUT-EMI / EMI-FILTER

AC-SENSING / SENSE-VMID

AC-SENSING / STAR

AC-SENSING / NTC

XFMR-AUX-FLY-E

DC-LINK / LINK-BANK-1

DC-LINK / DISCHARGE

VIENNA-PFC / PHASE-B0

VIENNA-PFC / PHASE-A0

INPUT-EMI / SURGE

VIENNA-PFC / PHASE-C0

50 kW air AC-DC (lower) - 1 of 3

internal junctions are named for what they join

AC-SENSING - 9 sections

U<ref>_<PIN> node at that IC pin e.g. UIVOA_VINP

AUX-POWER - 5 sections

R<stem>_M midpoint of a series pair e.g. RBALTA_M

R<stem>_<nm> tap between R<stem>n/m e.g. RV1D_01

DC-LINK - 4 sections

all others are explicit design nets

INPUT-EMI - 4 sections

VIENNA-PFC - 3 sections

rev D.4 - 29 sections - 350 components

DC-Modules 50 kW air — AC-DC board (Vienna PFC)
