vectivolt/DC-Modules/boards/out-pdf/DC-Modules Control Card (GD32G553VET7).pdf

# CONTROL / MCU

# CONTROL / SAFETY

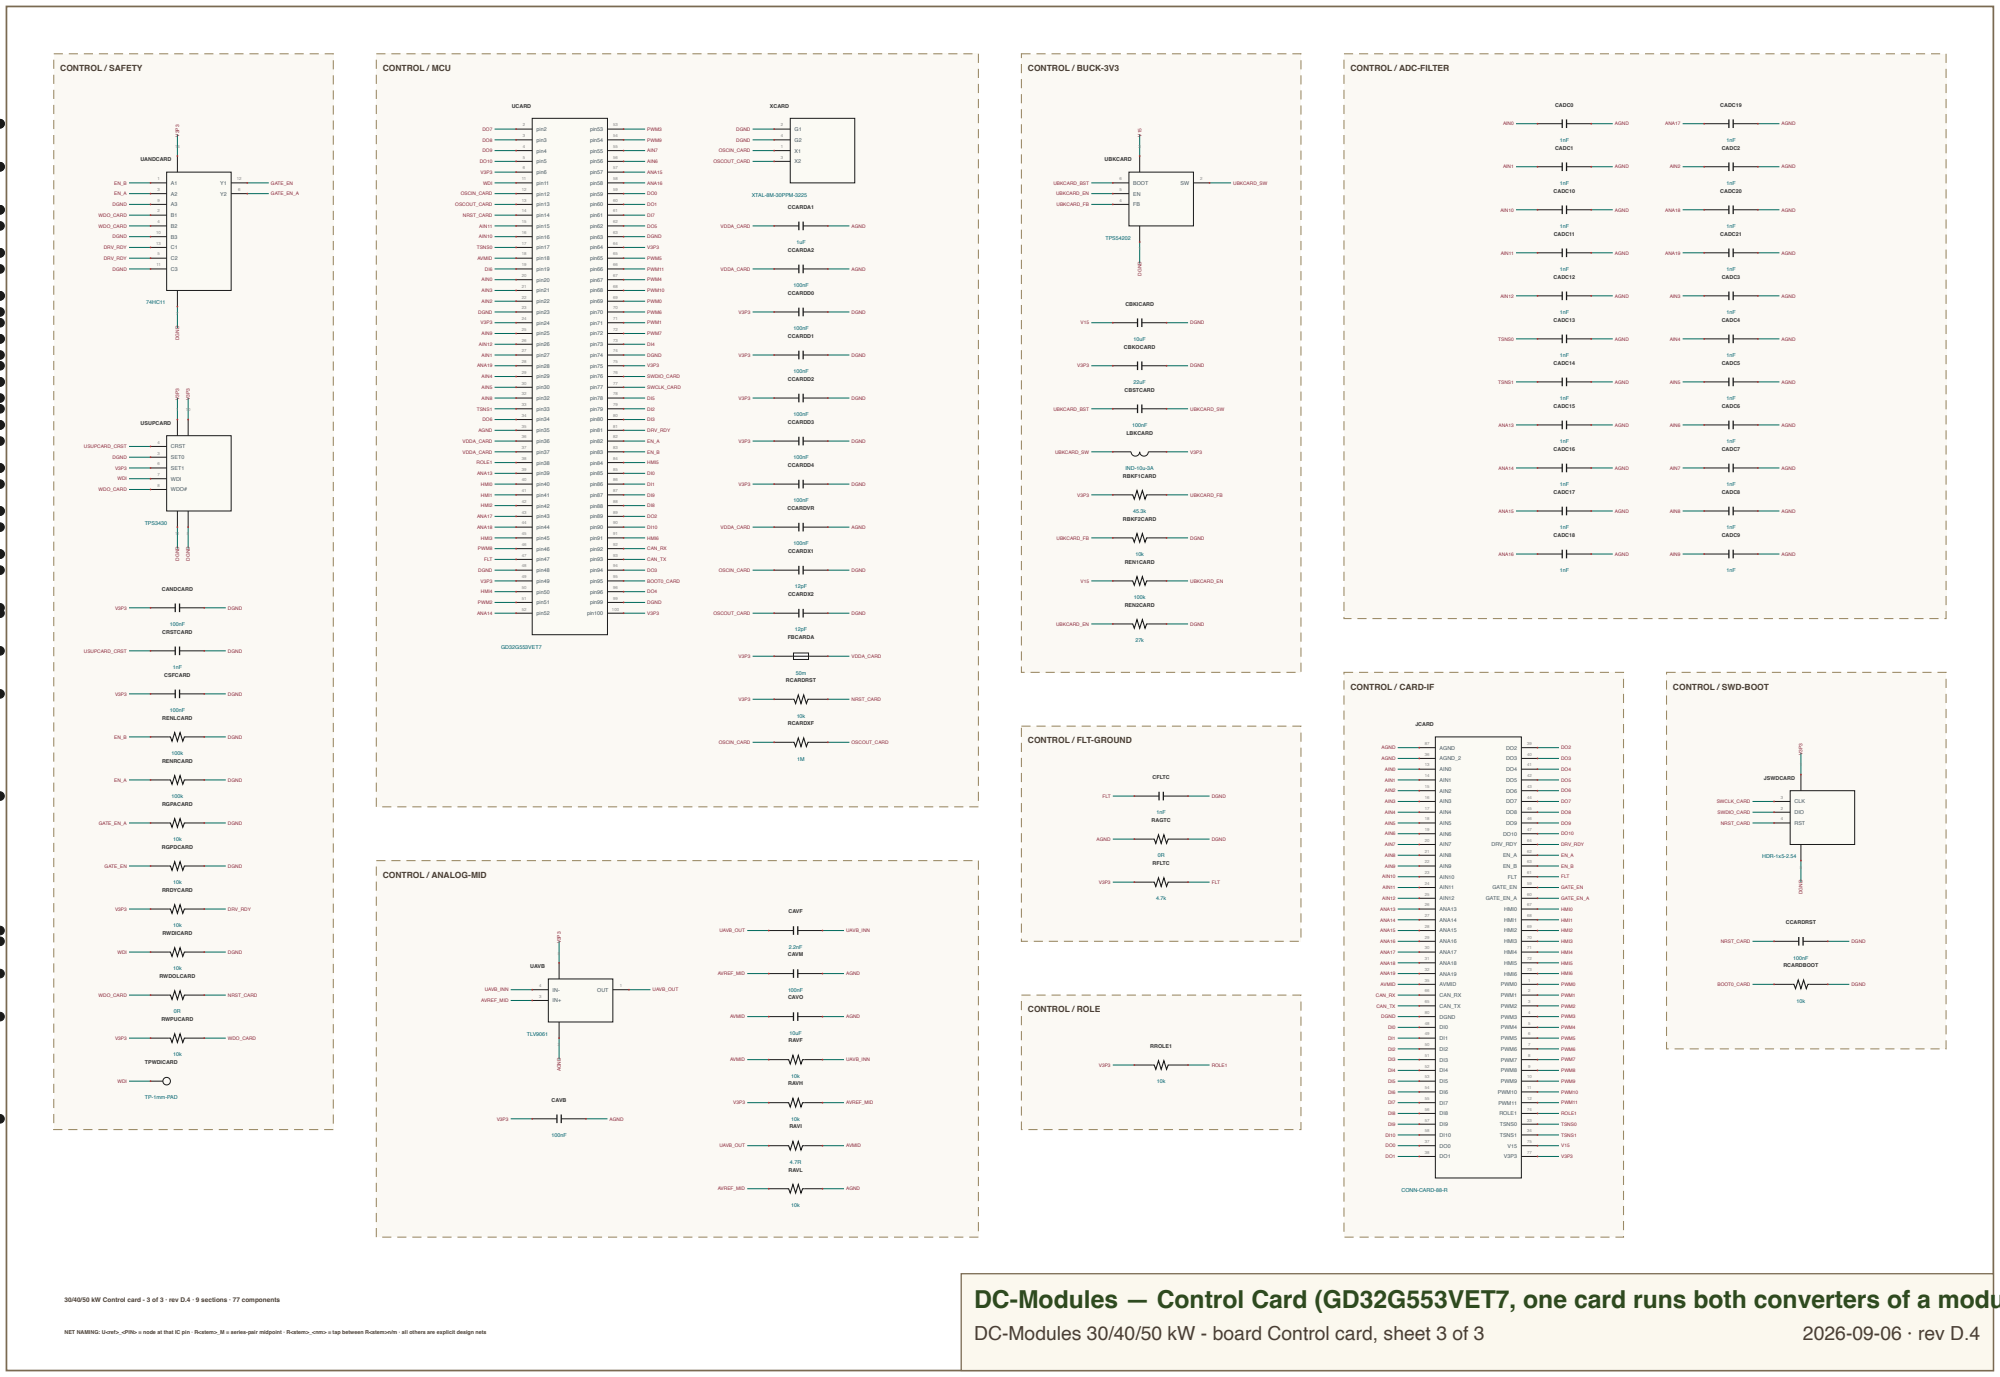
[picture p9: page 1]
CONTROL / BUCK-3V3; CONTROL / ROLE; pin2; pin3; pin4; pin5; pin6; pin11; pin12; pin13; pin14; pin15; pin16; pin17; pin18; pin19; pin20; pin21; pin22; pin23; pin24; pin25; pin26; pin27; pin28; pin29; pin30; pin32; pin33; pin34; pin35; pin36; pin37; pin38; pin39; pin40; pin41; pin42; pin43; pin44; pin45; pin46; pin47; pin48; pin49; pin50; pin51; pin52; pin53; pin54; pin55; pin56; pin57; pin58; pin59; pin60; pin61; pin62; pin63; pin64; pin65; pin66; pin67; pin68; pin69; pin70; pin71; pin72; pin73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

CONTROL / ADC-FILTER

CONTROL / CARD-IF

CONTROL / SWD-BOOT

CONTROL / FLT-GROUND

CONTROL / ANALOG-MID

DC-Modules — Control Card (GD32G553VET7, one card runs both converters of a modu

30/40/50 kW Control card - 3 of 3 · rev D.4 · 9 sections · 77 components

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
