vectivolt/DC-Modules/boards/out-pdf/DC-Modules 120kW AC-DC (Vienna PFC).pdf

# AC INPUT & PROTECTION

STUD-M8 | FUSE-gG-690V | S20K550

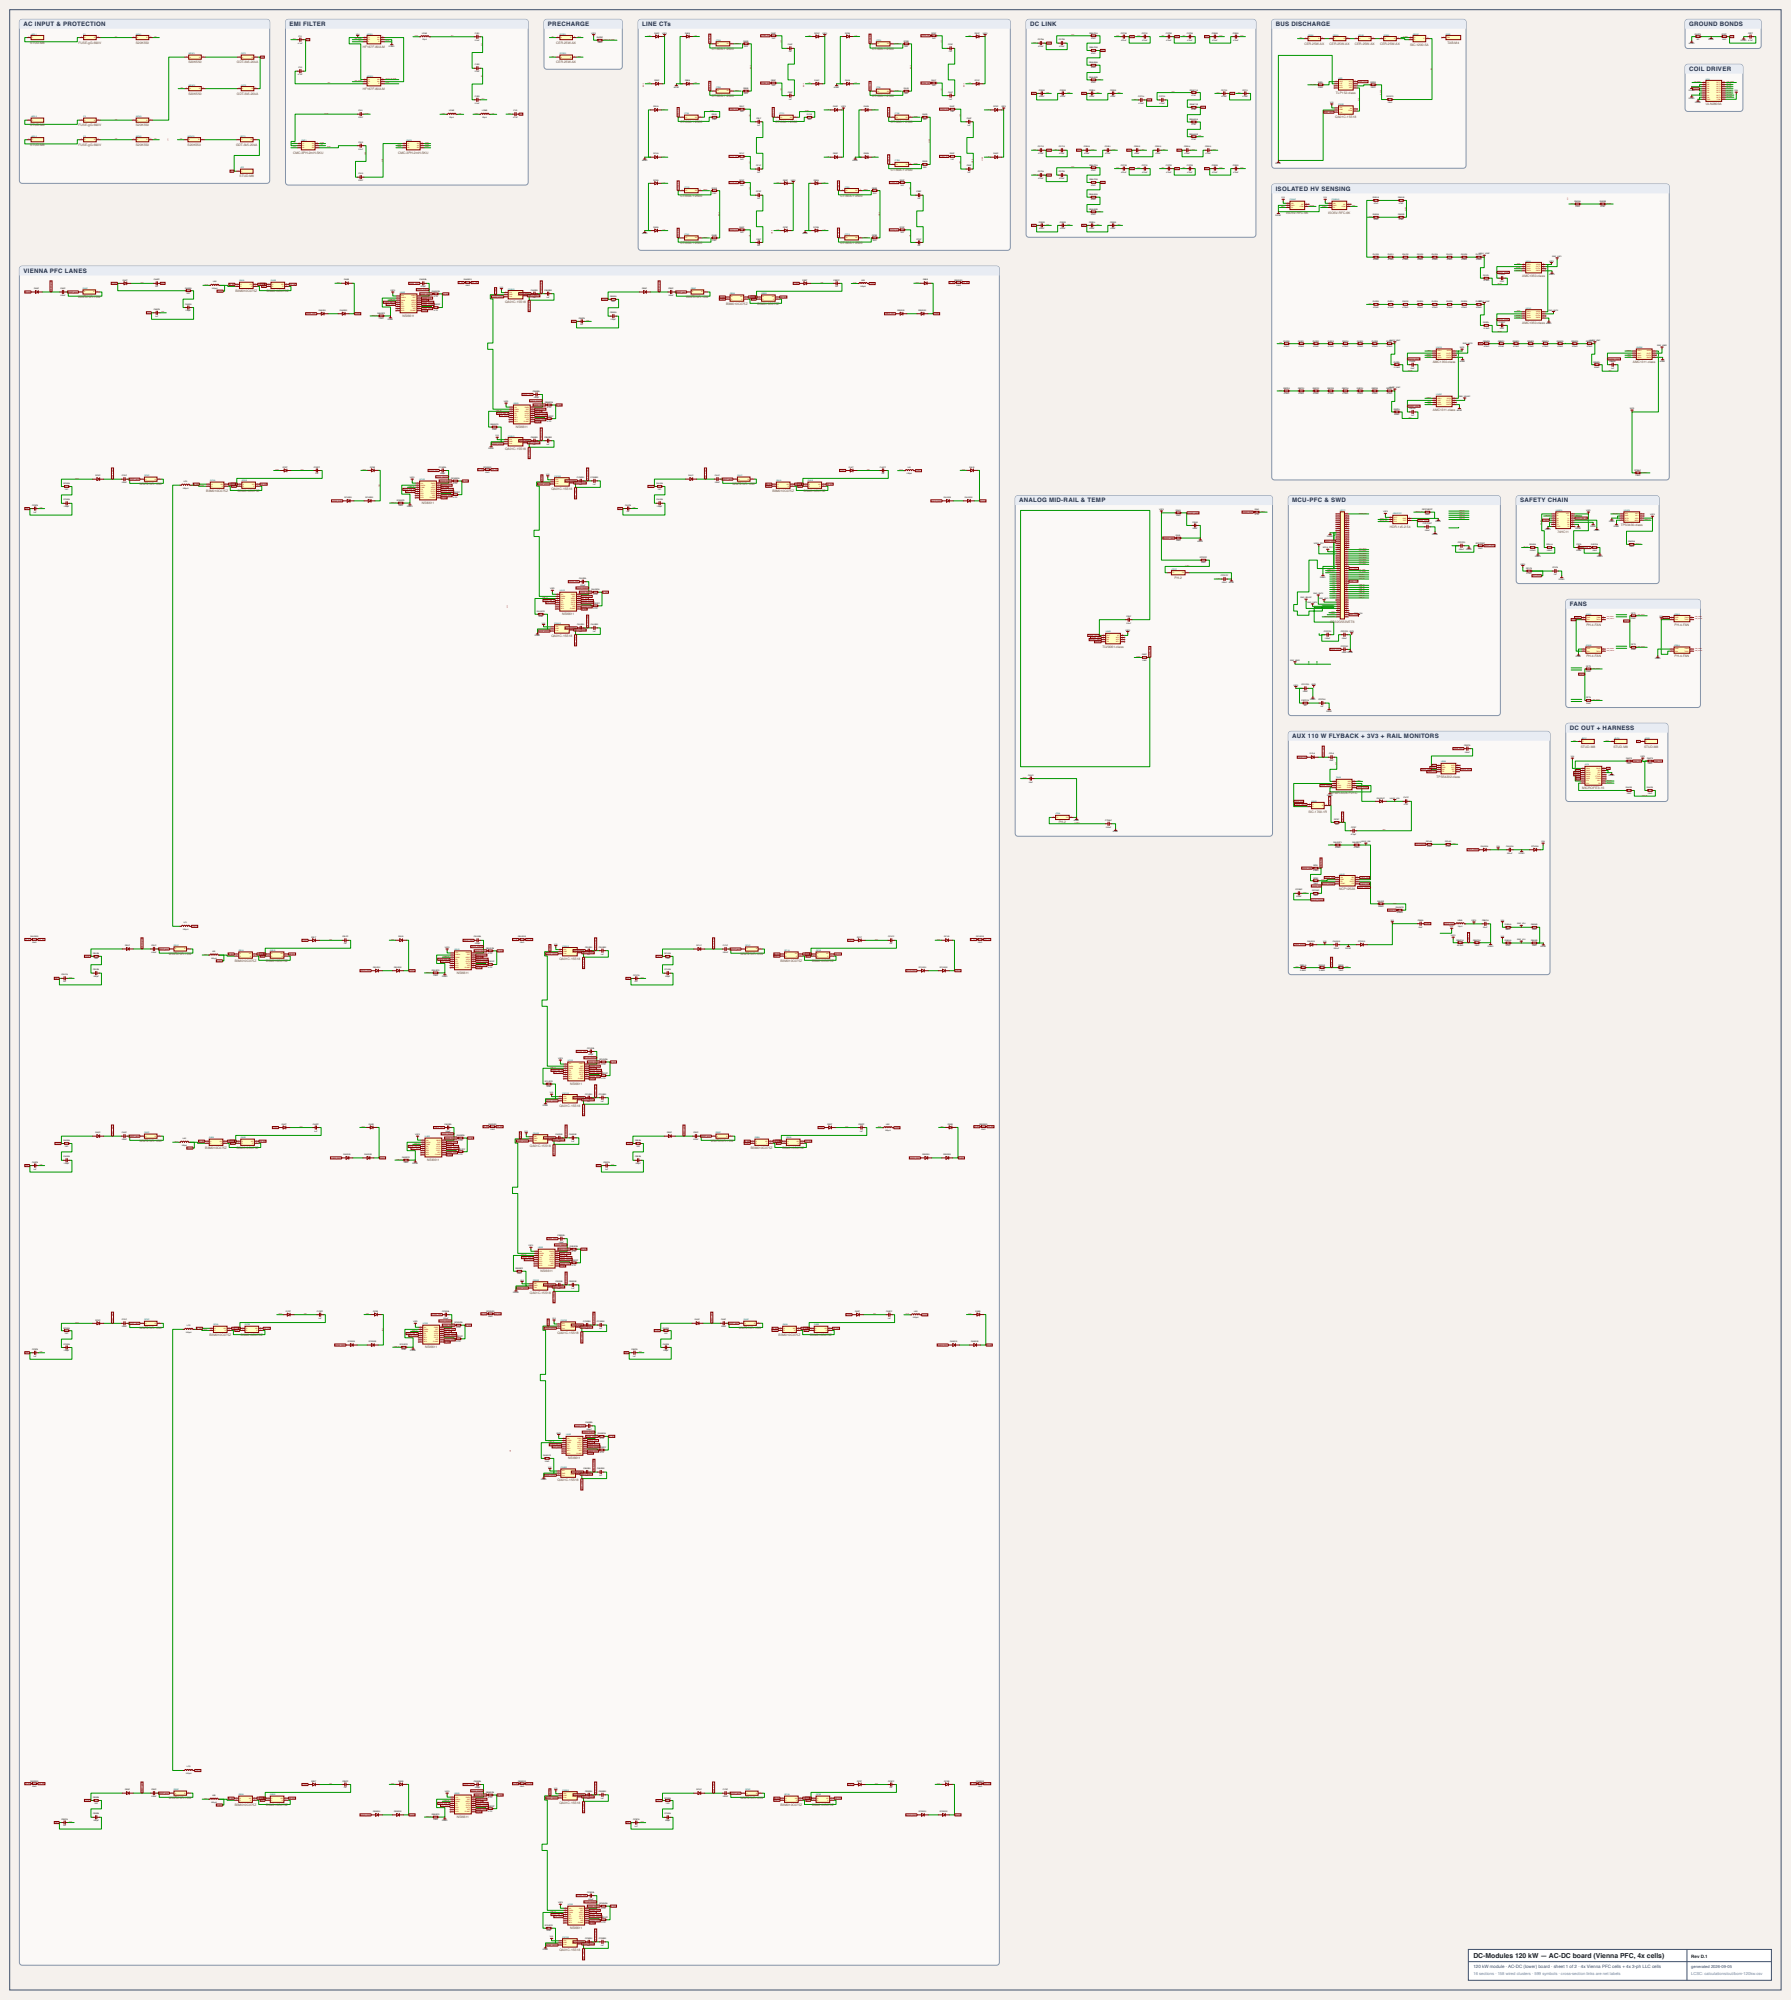
[picture p10: page 1]
JACL1; MOV1; JACL3; MOV3; MOVP1; MOVP2; GDT1; GDT2; STUD-M8; FUSE-gG-690V; GDT-3k5-20kA; JACL2; MOV2; JPE; MOVP3; GDT3; EMI FILTER; KPRE1; KPRE2; DGND; COIL_KPRE; RELAY_FB_KPRE; LDM1; CMC1; CMC2; CMC-3PH-2mH-SKU; LDM2; LDM3; PRECHARGE; RPRE1; CER-25W-AX; RKFBP; RPRE2; LINE CTs; AVMID; AGND; CTA0; CTB0; CTA0_S1 CTB0_S1; CTA0_S1; CTB0_S1; CTC0; CTA1; CTC0_S1 CTA1_S1; CTC0_S1; CTA1_S1; CTB1; CTB1_S1; CTC1_S1; CTC1; CTA2; CTB2; CTA2_S1 CTB2_S1; CTA2_S1; CTB2_S1; CTC2; CTA3; CTC2_S1 CTA3_S1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

ISOLATED HV SENSING

VIENNA PFC LANES

ANALOG MID-RAIL & TEMP

MCU-PFC & SWD

DC OUT + HARNESS

AUX 110 W FLYBACK + 3V3 + RAIL MONITORS

TAUX
XFMR-AUX-FLY-C
DGND

DC-Modules 120 kW — AC-DC board (Vienna PFC, 4x cells)

120 kW module · AC-DC (lower) board · sheet 1 of 2 · 4x Vienna PFC cells + 4x 3-ph LLC cells
16 sections · 158 wired clusters · 599 symbols · cross-section links are net labels

generated 2026-09-05
LCSC: calculations/out/bom-120kw.csv
