vectivolt/DC-Modules/boards/out-pdf/DC-Modules 120kW DC-DC (3-phase LLC).pdf

# BUS ENTRY & COMMUTATION FILMS

## STUD-M8

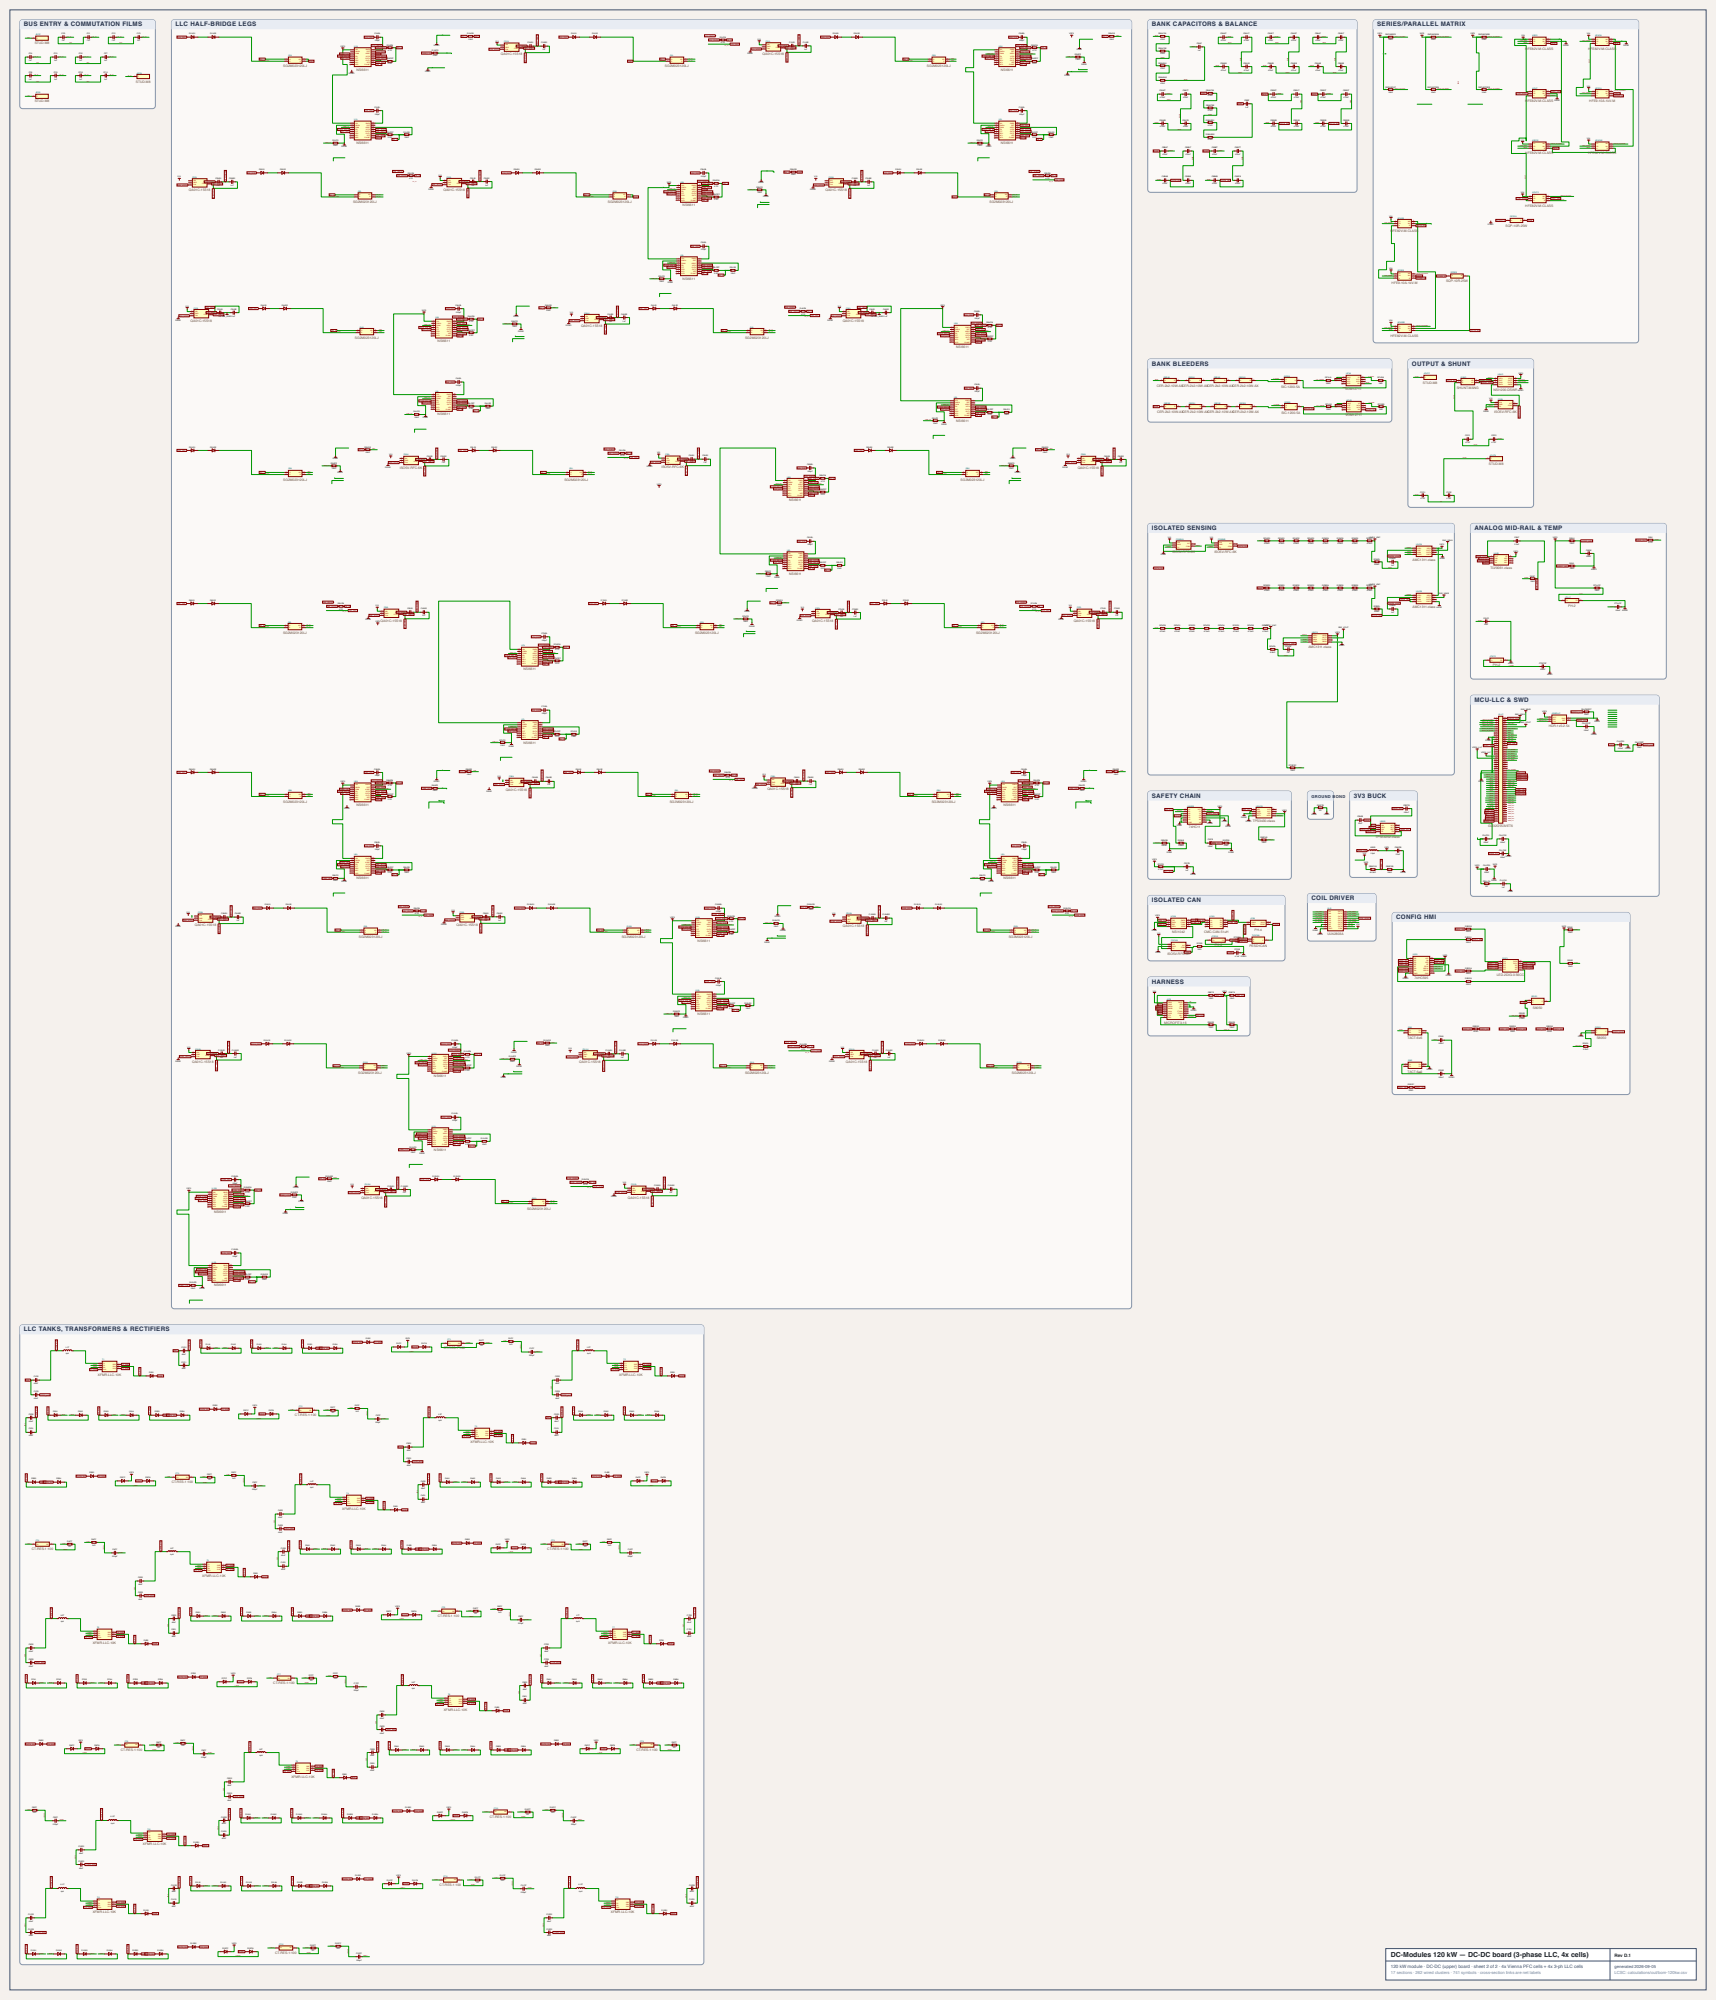
[picture p11: page 1]

LLC HALF-BRIDGE LEGS

ANALOG MID-RAIL & TEMP

LLC TANKS, TRANSFORMERS & RECTIFIERS

DC-Modules 120 kW — DC-DC board (3-phase LLC, 4x cells)

120 kW module · DC-DC (upper) board · sheet 2 of 2 · 4x Vienna PFC cells + 4x 3-ph LLC cells
17 sections · 262 wired clusters · 741 symbols ·
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
