vectivolt/DC-Modules/kicad5/dc-modules-30kw/30kw-acdc.sch

## KiCad design kicad5/dc-modules-30kw/30kw-acdc.sch (2026-09-17)

Schematic: 30kw-acdc.sch

Parts:
C5BAC, C5BBUS: 1uF; C0805; MPN CL21B105KBFNNNE; LCSC C28323
CA0C, CA0CM: 100nF; CAP-TH_L7.2-W3.5-P5.00; MPN FILM-100n-250; LCSC CLASS
CA0F: 1nF; C0603; MPN CC0603KRX7R9BB102; LCSC C100040
CA0FN, CA0FP: 1uF; CAP-TH_L26.5-W11.0-P22.50; MPN PP-1u-600; LCSC CLASS
CA0GB1, CA0GB2: 1uF; C0402; MPN CL05A105KO5NNNC; LCSC CLASS
CA0GBL: 47pF; C0603; MPN CC0603JRNPO9BN470; LCSC CLASS
CA0GBV: 100nF; C0603; MPN CC0603KRX7R9BB104; LCSC C14663
CA0SN: 330pF; C1812; MPN C1812-330p-1k; LCSC CLASS
CAUX15, CAUX24: 220uF; CAP-TH_L8.0-W8.0-P3.50; MPN GR227M035F12RR0VL4FP0; LCSC C45078
CAUXSS: 100nF; C0603; MPN CC0603KRX7R9BB104; LCSC C14663
CAVMA: 1uF; C0805; MPN CL21B105KBFNNNE; LCSC C28323
CB0C, CB0CM: 100nF; CAP-TH_L7.2-W3.5-P5.00; MPN FILM-100n-250; LCSC CLASS
CB0F: 1nF; C0603; MPN CC0603KRX7R9BB102; LCSC C100040
CB0FN, CB0FP: 1uF; CAP-TH_L26.5-W11.0-P22.50; MPN PP-1u-600; LCSC CLASS
CB0GB1, CB0GB2: 1uF; C0402; MPN CL05A105KO5NNNC; LCSC CLASS
CB0GBL: 47pF; C0603; MPN CC0603JRNPO9BN470; LCSC CLASS
CB0GBV: 100nF; C0603; MPN CC0603KRX7R9BB104; LCSC C14663
CB0SN: 330pF; C1812; MPN C1812-330p-1k; LCSC CLASS
CBKIA: 10uF; C0805; MPN CL21A106KAYNNNE; LCSC C15850
CBKOA: 22uF; C0805; MPN GRM21BR61C226ME44L; LCSC C86817
CBMDF: 1nF; C0805; MPN CC0805KRX7R9BB102; LCSC CLASS
CBMVA: 100nF; C0603; MPN CC0603KRX7R9BB104; LCSC C14663
CBMVB: 100nF; C0603; MPN CC0603KRX7R9BB104; LCSC C14663
CBPDF: 1nF; C0805; MPN CC0805KRX7R9BB102; LCSC CLASS
CBPVA: 100nF; C0603; MPN CC0603KRX7R9BB104; LCSC C14663
CBPVB: 100nF; C0603; MPN CC0603KRX7R9BB104; LCSC C14663
CBSTA: 100nF; C0603; MPN CC0603KRX7R9BB104; LCSC C14663
CC0C, CC0CM: 100nF; CAP-TH_L7.2-W3.5-P5.00; MPN FILM-100n-250; LCSC CLASS
CC0F: 1nF; C0603; MPN CC0603KRX7R9BB102; LCSC C100040
CC0FN, CC0FP: 1uF; CAP-TH_L26.5-W11.0-P22.50; MPN PP-1u-600; LCSC CLASS
CC0GB1, CC0GB2: 1uF; C0402; MPN CL05A105KO5NNNC; LCSC CLASS
CC0GBL: 47pF; C0603; MPN CC0603JRNPO9BN470; LCSC CLASS
CC0GBV: 100nF; C0603; MPN CC0603KRX7R9BB104; LCSC C14663
CC0SN: 330pF; C1812; MPN C1812-330p-1k; LCSC CLASS
CCLA: 10nF; CAP-TH_L18.0-W5.0-P15.00; MPN PP-10n-1200; LCSC CLASS
CCSF: 100pF; C0603; MPN CC0603JRNPO9BN101; LCSC C14665
CDB00, CDB01, CDB02, CDB03, CDB04: 470uF; CAP-TH_L30.0-W30.0-P10.00; MPN ELH-470u500; LCSC CLASS
CDMP1, CDMP2, CDMP3: 2.2uF; CAP-TH_L26.5-W11.0-P22.50; MPN X1-2u2-530; LCSC CLASS
CDT00, CDT01, CDT02, CDT03, CDT04: 470uF; CAP-TH_L30.0-W30.0-P10.00; MPN ELH-470u500; LCSC CLASS
CFBF: 1nF; C0603; MPN CC0603KRX7R9BB102; LCSC C100040
CM15, CM24: 100nF; C0603; MPN CC0603KRX7R9BB104; LCSC C14663
CMC1, CMC2: CMC-3PH-2mH-SKU; L_CMC_3ph_nanocryst_per-SKU; MPN CMC-3PH-2mH-SKU; LCSC CUSTOM
CPET: 4.7nF; CAP-TH_L11.0-W5.0-P10.00; MPN VY1472M63Y5UQ63V0; LCSC C499492
CQD: 100nF; C0603; MPN CC0603KRX7R9BB104; LCSC C14663
CTA0: ACX-1100; CT_window_100A_1-2500; MPN ACX-1100; LCSC DIRECT
CTB0: ACX-1100; CT_window_100A_1-2500; MPN ACX-1100; LCSC DIRECT
CTC0: ACX-1100; CT_window_100A_1-2500; MPN ACX-1100; LCSC DIRECT
CTINLF: 100nF; C0603; MPN CC0603KRX7R9BB104; LCSC C14663
CTPFCF: 100nF; C0603; MPN CC0603KRX7R9BB104; LCSC C14663
CV1DF, CV2DF, CV3DF: 10nF; C0805; MPN CC0805KRX7R9BB103; LCSC CLASS
CV1VA, CV1VB, CV2VA, CV2VB, CV3VA, CV3VB: 100nF; C0603; MPN CC0603KRX7R9BB104; LCSC C14663
CVCC: 220uF; CAP-TH_L8.0-W8.0-P3.50; MPN GR227M035F12RR0VL4FP0; LCSC C45078
CVCCB: 100nF; C0603; MPN CC0603KRX7R9BB104; LCSC C14663
CX01, CX02, CX03, CX11, CX12, CX13, CX21, CX22, CX23, CX24, CX25, CX26: 4.7uF; CAP-TH_L31.5-W17.0-P27.50; MPN X2-4u7-305; LCSC CLASS
CY1, CY2, CY3: 10nF; CAP-TH_L11.0-W6.0-P10.00; MPN Y2-10n-300; LCSC CLASS
CY4, CY5, CY6: 4.7nF; CAP-TH_L11.0-W5.0-P10.00; MPN VY1472M63Y5UQ63V0; LCSC C499492
DA0B, DA0T: SICJBS-1200-40; TO-247-3_L15.9-W5.0-P5.44-L; MPN GC4D20120D; LCSC C7435099
DA0C, DA0CM: SICJBS-1200-10; TO-247-3_L15.9-W5.0-P5.44-L; MPN GC4D10120H; LCSC C7435087
DA0GS1, DA0GS2: US1M; SMA_L4.4-W2.8-LS5.4-RD; MPN US1M; LCSC C412437
DA0N, DA0P: 1N4148WS; SOD-323_L1.8-W1.3-LS2.5-RD; MPN 1N4148WS; LCSC C2128
DAUX15: US2G; SMB_L4.5-W3.6-LS5.3-RD; MPN US2G; LCSC C49263
DAUX24: UF-400V-3A; SMC_L8.0-W5.9-LS9.0-RD; MPN US3M; LCSC C3039981
DAUXVC: US2G; SMB_L4.5-W3.6-LS5.3-RD; MPN US2G; LCSC C49263
DB0B, DB0T: SICJBS-1200-40; TO-247-3_L15.9-W5.0-P5.44-L; MPN GC4D20120D; LCSC C7435099
DB0C, DB0CM: SICJBS-1200-10; TO-247-3_L15.9-W5.0-P5.44-L; MPN GC4D10120H; LCSC C7435087
DB0GS1, DB0GS2: US1M; SMA_L4.4-W2.8-LS5.4-RD; MPN US1M; LCSC C412437
DB0N, DB0P: 1N4148WS; SOD-323_L1.8-W1.3-LS2.5-RD; MPN 1N4148WS; LCSC C2128
DC0B, DC0T: SICJBS-1200-40; TO-247-3_L15.9-W5.0-P5.44-L; MPN GC4D20120D; LCSC C7435099
DC0C, DC0CM: SICJBS-1200-10; TO-247-3_L15.9-W5.0-P5.44-L; MPN GC4D10120H; LCSC C7435087
DC0GS1, DC0GS2: US1M; SMA_L4.4-W2.8-LS5.4-RD; MPN US1M; LCSC C412437
DC0N, DC0P: 1N4148WS; SOD-323_L1.8-W1.3-LS2.5-RD; MPN 1N4148WS; LCSC C2128
DCLA: SIC-SBD-1700V; SMB_L4.5-W3.6-LS5.3-RD; MPN SIC-SBD-1700V; LCSC CLASS
DTVS15: SMBJ18A; SMB_L4.5-W3.6-LS5.3-RD; MPN SMBJ18A; LCSC ORDERABLE
DTVS24: SMBJ28A; SMB_L4.5-W3.6-LS5.3-RD; MPN SMBJ28A; LCSC ORDERABLE
DZAUX: BZX84-B15; SOT-23-3_L2.9-W1.3-P1.90-LS2.4-BR; MPN BZX84-B15; LCSC ORDERABLE
F1, F2, F3: FUSE-gG-690V-80A; FUSE_holder_22x58; MPN FUSE-gG-690V-80A; LCSC CLASS
GDT1, GDT2, GDT3: GDT-2k5-20kA; GDT-8mm_RM6; MPN GDT-2k5-20kA; LCSC CLASS
JACL1, JACL2, JACL3: STUD-M8; TERM_Stud_M8; MPN STUD-M8; LCSC CLASS
JDCN: STUD-M8; TERM_Stud_M8; MPN STUD-M8; LCSC CLASS
JDCP: STUD-M8; TERM_Stud_M8; MPN STUD-M8; LCSC CLASS
JFAN1, JFAN2, JFAN3: PH-4-FAN; CONN-TH_4P-P2.00_PH; MPN B4B-PH-K-S; LCSC C131334
JICA: MICROFIT3-40; CONN-TH_40P-P3.00_MicroFit; MPN MICROFIT3-40; LCSC CLASS
JPE: STUD-M8; TERM_Stud_M8; MPN STUD-M8; LCSC CLASS
JPEB: STUD-M8; TERM_Stud_M8; MPN STUD-M8; LCSC CLASS
JTINL: PH-2; CONN-TH_2P-P2.00_PH; MPN B2B-PH-K-S; LCSC C20504437
JTPFC: PH-2; CONN-TH_2P-P2.00_PH; MPN B2B-PH-K-S; LCSC C20504437
KPRE1, KPRE2: HF167F-80A-M; RELAY_HF167F_PCB; MPN HF167F/024-HATF(764); LCSC DIRECT
LA0: IND-PFC-165u; L_Toroid_3xT79_26u_custom; MPN IND-PFC-165u; LCSC CUSTOM
LB0: IND-PFC-165u; L_Toroid_3xT79_26u_custom; MPN IND-PFC-165u; LCSC CUSTOM
LBKA: IND-10u-3A; IND-SMD_L6.0-W6.0; MPN CYA0630-10UH; LCSC C5189958
LC0: IND-PFC-165u; L_Toroid_3xT79_26u_custom; MPN IND-PFC-165u; LCSC CUSTOM
MOV1, MOV2, MOV3: S20K550; DISC-20mm_RM10; MPN B72220S0551K101; LCSC CLASS
MOVP1, MOVP2, MOVP3: S20K550; DISC-20mm_RM10; MPN B72220S0551K101; LCSC CLASS
PS5AC, PS5BUS: ISO5V-RFC-6K; SIP-4_iso-module; MPN ISO5V-RFC-6K; LCSC C20613048
PSA0G: ISO-GBIAS-15-1W; PWRM-TH_QA01C; MPN ISO-GBIAS-15-1W; LCSC CLASS
PSB0G: ISO-GBIAS-15-1W; PWRM-TH_QA01C; MPN ISO-GBIAS-15-1W; LCSC CLASS
PSC0G: ISO-GBIAS-15-1W; PWRM-TH_QA01C; MPN ISO-GBIAS-15-1W; LCSC CLASS
PSQD: ISO-GBIAS-15-1W; PWRM-TH_QA01C; MPN ISO-GBIAS-15-1W; LCSC CLASS
QA0A, QA0B: SIC-750V-20mR; TO-247-4_L15.8-W5.0-P2.54-L; MPN SIC-750V-20mR; LCSC CLASS
QAUX: SIC-1700-1R-G15; TO-247-3_L15.9-W5.0-P5.44-L; MPN SIC-1700-1R-G15; LCSC CLASS
QAUXFB: S8050; SOT-23-3_L2.9-W1.3-P1.90-LS2.4-BR; MPN S8050; LCSC C2146
QB0A, QB0B: SIC-750V-20mR; TO-247-4_L15.8-W5.0-P2.54-L; MPN SIC-750V-20mR; LCSC CLASS
QC0A, QC0B: SIC-750V-20mR; TO-247-4_L15.8-W5.0-P2.54-L; MPN SIC-750V-20mR; LCSC CLASS
QDIS: TAB-M4; TERM_Tab_M4; MPN TAB-M4; LCSC CLASS
QDISF: SIC-1200-5A; TO-247-3_L15.9-W5.0-P5.44-L; MPN IMW120R350M1H; LCSC C536285
RA0B: 22R; R1206; MPN RC1206FR-0722RL; LCSC CLASS
RA0C, RA0CM: WW-470R-10W; RES-TH_L48.0-W8.0-P54.00; MPN WW-470R-10W; LCSC CLASS
RA0F: 200R; R0603; MPN R-small; LCSC CLASS
RA0GDS: 100R; R0603; MPN RC0603FR-07100RL; LCSC CLASS
RA0GGS: 10k; R0805; MPN RC0805FR-0710KL; LCSC C84376
RA0GOFF, RA0GON: 4.7R; R1206; MPN RC1206FR-7W4R7L; LCSC C859161
RA0GPD: 10k; R0603; MPN RC0603FR-0710KL; LCSC CLASS
RA0SN: 10R; R2512; MPN R2512-10R-3W-PULSE; LCSC CLASS
RAUX24: 50m; R2512; MPN R2512-R05-1W-1%; LCSC CLASS
RAUXCS: 280m; R1206; MPN R1206-R28-1%-0.5W; LCSC CLASS
RAUXG: 100k; R0603; MPN RC0603FR-07100KL; LCSC CLASS
RAUXRT: 66.5k; R0603; MPN R-small; LCSC CLASS
RAUXST1, RAUXST2: 470k; R2512; MPN R2512-HV; LCSC CLASS
RB0B: 22R; R1206; MPN RC1206FR-0722RL; LCSC CLASS
RB0C, RB0CM: WW-470R-10W; RES-TH_L48.0-W8.0-P54.00; MPN WW-470R-10W; LCSC CLASS
RB0F: 200R; R0603; MPN R-small; LCSC CLASS
RB0GDS: 100R; R0603; MPN RC0603FR-07100RL; LCSC CLASS
RB0GGS: 10k; R0805; MPN RC0805FR-0710KL; LCSC C84376
RB0GOFF, RB0GON: 4.7R; R1206; MPN RC1206FR-7W4R7L; LCSC C859161
RB0GPD: 10k; R0603; MPN RC0603FR-0710KL; LCSC CLASS
RB0SN: 10R; R2512; MPN R2512-10R-3W-PULSE; LCSC CLASS
RBALB0A, RBALB0B: 47k; R2512; MPN PS122WF4702T4E; LCSC C2793932
RBALT0A, RBALT0B: 47k; R2512; MPN PS122WF4702T4E; LCSC C2793932
RBEFB: 10k; R0603; MPN RC0603FR-0710KL; LCSC CLASS
RBKF1A: 45.3k; R0603; MPN RC0603FR-0745K3L; LCSC CLASS
RBKF2A: 10k; R0603; MPN RC0603FR-0710KL; LCSC CLASS
RBMD0, RBMD1, RBMD2, RBMD3, RBMD4, RBMD5, RBMD6, RBMD7: 475k; R1206; MPN HV732BTTD4753F; LCSC C4121673
RBMDL: 6.8k; R0805; MPN ARG05BTC6801; LCSC C3033907
RBMO: 100R; R0603; MPN RC0603FR-07100RL; LCSC CLASS
RBPD0, RBPD1, RBPD2, RBPD3, RBPD4, RBPD5, RBPD6, RBPD7: 475k; R1206; MPN HV732BTTD4753F; LCSC C4121673
RBPDL: 6.8k; R0805; MPN ARG05BTC6801; LCSC C3033907
RBPO: 100R; R0603; MPN RC0603FR-07100RL; LCSC CLASS
RBR1A, RBR1B: 1.2M; R2512; MPN R2512-HV; LCSC CLASS
RBR2: 7.5k; R0603; MPN RC0603FR-077K5L; LCSC CLASS
RC0B: 22R; R1206; MPN RC1206FR-0722RL; LCSC CLASS
RC0C, RC0CM: WW-470R-10W; RES-TH_L48.0-W8.0-P54.00; MPN WW-470R-10W; LCSC CLASS
RC0F: 200R; R0603; MPN R-small; LCSC CLASS
RC0GDS: 100R; R0603; MPN RC0603FR-07100RL; LCSC CLASS
RC0GGS: 10k; R0805; MPN RC0805FR-0710KL; LCSC C84376
RC0GOFF, RC0GON: 4.7R; R1206; MPN RC1206FR-7W4R7L; LCSC C859161
RC0GPD: 10k; R0603; MPN RC0603FR-0710KL; LCSC CLASS
RC0SN: 10R; R2512; MPN R2512-10R-3W-PULSE; LCSC CLASS
RCLA1, RCLA2, RCLA3: 11k; R2512; MPN R2512-11k-2W-AS; LCSC CLASS
RCSF: 1k; R0603; MPN RC0603FR-071KL; LCSC CLASS
RDIS0, RDIS1, RDIS2, RDIS3: CER-25W-160R-AX; RES-TH_L60.0-W9.0-P66.00; MPN CER-25W-160R-AX; LCSC CLASS
RDMP1, RDMP2, RDMP3: 6.8R; RES-TH_L60.0-W9.0-P66.00; MPN SQP-6R8-25W; LCSC CLASS
REN1A: 100k; R0603; MPN RC0603FR-07100KL; LCSC CLASS
REN2A: 27k; R0603; MPN R-small; LCSC CLASS
RFPD1, RFPD2, RFPD3: 10k; R0603; MPN HV732BTTD4753F; LCSC C4121673
RFT1, RFT2, RFT3: 10k; R0603; MPN RC0603FR-0710KL; LCSC CLASS
RGA0A1, RGA0B1: 1R; R0805; MPN R0805-2R2; LCSC CLASS
RGB0A1, RGB0B1: 1R; R0805; MPN R0805-2R2; LCSC CLASS
RGC0A1, RGC0B1: 1R; R0805; MPN R0805-2R2; LCSC CLASS
RKFBP: 330R; R0603; MPN RC0603FR-07330RL; LCSC CLASS
RM15A: 47k; R0603; MPN RC0603FR-0747KL; LCSC CLASS
RM15B, RM24B: 10k; R0603; MPN RC0603FR-0710KL; LCSC CLASS
RM24A: 82k; R0603; MPN R-small; LCSC CLASS
RNS1A, RNS1B, RNS2A, RNS2B, RNS3A, RNS3B: 33k; R2512; MPN R2512-33k-HV-AS; LCSC CLASS
RPD0, RPD1, RPD2, RPD3, RPD4, RPD5, RPD6: 10k; R0603; MPN R0603-10k; LCSC CLASS
RPET: 1M; R1206; MPN RC1206FR-071ML; LCSC CLASS
RPL24: 4.7k; R2512; MPN R2512-4k7-1W; LCSC CLASS
RPRE1, RPRE2: CER-25W-33R-AX; RES-TH_L60.0-W9.0-P66.00; MPN CER-25W-33R-AX; LCSC CLASS
RQDG: 100R; R0805; MPN RC0805FR-07100RL; LCSC C105577
RQDL: 1.2k; R1206; MPN R-small; LCSC CLASS
RQDPD: 10k; R0805; MPN RC0805FR-0710KL; LCSC C84376
RTINLP: 10k; R0603; MPN RC0603FR-0710KL; LCSC CLASS
RTPFCP: 10k; R0603; MPN RC0603FR-0710KL; LCSC CLASS
RV1D0, RV1D1, RV1D2, RV1D3, RV1D4, RV1D5, RV1D6, RV1D7, RV2D0, RV2D1, RV2D2, RV2D3, RV2D4, RV2D5, RV2D6, RV2D7, RV3D0, RV3D1, RV3D2, RV3D3, RV3D4, RV3D5, RV3D6, RV3D7: 475k; R1206; MPN HV732BTTD4753F; LCSC C4121673
RV1DL, RV2DL, RV3DL: 11.5k; R0805; MPN RT0805BRD0711K5L; LCSC C865153
RV1O, RV2O, RV3O: 100R; R0603; MPN RC0603FR-07100RL; LCSC CLASS
RZFB: 2.2k; R0603; MPN RC0603FR-072K2L; LCSC CLASS
TAUX: XFMR-AUX-FLY-E; XFMR_ETD44_custom; MPN XFMR-AUX-FLY-E; LCSC CUSTOM
UA0G: NSI6611; SOIC-16_L10.3-W7.5-P1.27-LS10.3-BL; MPN NSI6611; LCSC C7470934
UAUX: NCP1252D; SOIC-8_L4.9-W3.9-P1.27-LS6.0-BL; MPN NCP1252DDR2G; LCSC ORDERABLE
UB0G: NSI6611; SOIC-16_L10.3-W7.5-P1.27-LS10.3-BL; MPN NSI6611; LCSC C7470934
UBKA: TPS54202; SOT-23-6_L2.9-W1.6-P0.95-LS2.8-BL; MPN TPS54202DDCR; LCSC C191884
UC0G: NSI6611; SOIC-16_L10.3-W7.5-P1.27-LS10.3-BL; MPN NSI6611; LCSC C7470934
UIVBM: AMC1311; SOIC-8_L5.9-W7.5-P1.27-LS11.5-BL; MPN AMC1311DWVR; LCSC C456277
UIVBP: AMC1311; SOIC-8_L5.9-W7.5-P1.27-LS11.5-BL; MPN AMC1311DWVR; LCSC C456277
UIVV1, UIVV2, UIVV3: AMC1350; SOIC-8_L5.9-W7.5-P1.27-LS11.5-BL; MPN AMC1350QDWVRQ1; LCSC C5214206
UPA: ULN2803A; SOIC-18_L11.6-W7.5-P1.27-LS10.3-BL; MPN ULN2803A; LCSC C2865085
UQD: TLP152; SOP-6_L7.0-W4.4-P1.27-LS7.6-BL; MPN TLP152; LCSC C17255258

Notes on the sheet:
SHEET INDEX
30 kW AC-DC (lower) - 1 of 3
AC-SENSING - 9 sections
AUX-POWER - 5 sections
CONTROL - 4 sections
INPUT-EMI - 4 sections
DC-LINK - 3 sections
VIENNA-PFC - 3 sections
rev D.4 - 28 sections - 341 components
NET NAMING
internal junctions are named for what they join
U<ref>_<PIN> node at that IC pin e.g. UIVOA_VINP
R<stem>_M midpoint of a series pair e.g. RBALTA_M
R<stem>_<nm> tap between R<stem>n/m e.g. RV1D_01
all others are explicit design nets
MAGNETICS CONSTRUCTION
identity per docs/magnetics.md (turns, gap, litz, acceptance lines live there)
D1 LA0-LC0: 3x 0077908A7 KoolMu, N=39 (+/-1 lot trim), 3x(6x1mm) 18mm2 -> L0 169uH, >=75uH @82A pk (BIASED value governs ripple/trip calcs)
EMI: CMC1 + 12x X2 4.7uF in 3 star stages + CMC2 + RC damper; no AC-side DM chokes
Cr at TANK sections
AC-SENSING / STAR
AC-SENSING / SENSE-VAC1
AC-SENSING / SENSE-VAC2
AC-SENSING / SENSE-VAC3
AC-SENSING / SENSE-VBUS
AC-SENSING / SENSE-VMID
AC-SENSING / ISO-BIAS
AC-SENSING / NTC
AC-SENSING / LINE-CTS-0
AUX-POWER / FLYBACK
AUX-POWER / RAILS
AUX-POWER / BUCK-3V3
AUX-POWER / FANS
AUX-POWER / INTERCONNECT
CONTROL / CARD-IF
CONTROL / GROUNDING
CONTROL / COIL-DRIVER
CONTROL / RAIL-MON
DC-LINK / DISCHARGE
DC-LINK / BUS-STUDS
DC-LINK / LINK-BANK-0
INPUT-EMI / AC-ENTRY
INPUT-EMI / SURGE
INPUT-EMI / EMI-FILTER
INPUT-EMI / PRECHARGE
VIENNA-PFC / PHASE-A0
VIENNA-PFC / PHASE-B0
VIENNA-PFC / PHASE-C0
