vectivolt/DC-Modules/kicad5/dc-modules-30kw/30kw-dcdc.sch

## KiCad design kicad5/dc-modules-30kw/30kw-dcdc.sch (2026-09-17)

Schematic: 30kw-dcdc.sch

Parts:
C1AVM, C5BBKA, C5BBKB: 1uF; C0805; MPN CL21B105KBFNNNE; LCSC C28323
C1CF: 220pF; C0603; MPN CC0603JRNPO9BN221; LCSC C106210
C1HB1, C1HB2, C1LB1, C1LB2, C2HB1, C2HB2, C2LB1, C2LB2: 1uF; C0402; MPN CL05A105KO5NNNC; LCSC CLASS
C1HBL, C1LBL, C2HBL, C2LBL: 18pF; C0603; MPN MLCC-18p-0603; LCSC CLASS
C1HBV, C1LBV, C1WB, C2HBV, C2LBV: 100nF; C0603; MPN CC0603KRX7R9BB104; LCSC C14663
C1HOS1, C1LOS1, C2HOS1, C2LOS1: C1206-330p-1kV-C0G; C1206; MPN C1206-330p-1kV-C0G; LCSC CLASS
C1R0, C1R1, C1R2, C1R3, C1R4, C1R5, C1R6: 33nF; CAP-TH_L31.5-W13.0-P27.50; MPN PP-33n-1200V; LCSC CLASS
CCB5: 1uF; C0805; MPN CL21B105KBFNNNE; LCSC C28323
CCGB: 4.7nF; C1206; MPN CC1206KRX7R9BB472; LCSC C107208
CCV1, CCV2: 100nF; C0603; MPN CC0603KRX7R9BB104; LCSC C14663
CEXCL: 100nF; C0603; MPN CC0603KRX7R9BB104; LCSC C14663
CF0, CF1, CF2, CF3, CF4, CF5, CF6, CF7, CF8, CF9, CF10, CF11, CF12, CF13, CF14, CF15: 1uF; CAP-TH_L31.5-W13.0-P27.50; MPN PP-1u-1100; LCSC CLASS
CF11H, CF11L: 100nF; C0603; MPN CC0603KRX7R9BB104; LCSC C14663
CFA0, CFA1, CFA2, CFA3, CFA4, CFA5, CFA6, CFA7, CFA8: 2.2uF; CAP-TH_L31.5-W13.0-P27.50; MPN PP-2u2-630; LCSC CLASS
CFB0, CFB1, CFB2, CFB3, CFB4, CFB5, CFB6, CFB7, CFB8: 2.2uF; CAP-TH_L31.5-W13.0-P27.50; MPN PP-2u2-630; LCSC CLASS
CFDMP: 2.2uF; CAP-TH_L31.5-W13.0-P27.50; MPN PP-2u2-1100; LCSC CLASS
COADF: 1nF; C0805; MPN CC0805KRX7R9BB102; LCSC CLASS
COAVA: 100nF; C0603; MPN CC0603KRX7R9BB104; LCSC C14663
COAVB: 100nF; C0603; MPN CC0603KRX7R9BB104; LCSC C14663
COBDF: 1nF; C0805; MPN CC0805KRX7R9BB102; LCSC CLASS
COBVA: 100nF; C0603; MPN CC0603KRX7R9BB104; LCSC C14663
COBVB: 100nF; C0603; MPN CC0603KRX7R9BB104; LCSC C14663
COF1, COF2: 4.7uF; CAP-TH_L41.5-W20.0-P37.50; MPN PP-4u7-1200; LCSC CLASS
COVDF: 1nF; C0805; MPN CC0805KRX7R9BB102; LCSC CLASS
COVVA: 100nF; C0603; MPN CC0603KRX7R9BB104; LCSC C14663
COVVB: 100nF; C0603; MPN CC0603KRX7R9BB104; LCSC C14663
CROLEB: 100nF; C0603; MPN CC0603KRX7R9BB104; LCSC C14663
CSH1, CSH2: 100nF; C0603; MPN CC0603KRX7R9BB104; LCSC C14663
CSHB: 1uF; C0805; MPN CL21B105KBFNNNE; LCSC C28323
CSR1: 100nF; C0603; MPN CC0603KRX7R9BB104; LCSC C14663
CSW1, CSW2: 100nF; C0603; MPN CC0603KRX7R9BB104; LCSC C14663
CT1: CT-RES-1:100-100A; CT_window_res_1-100; MPN CT-RES-1:100-100A; LCSC CLASS
CTLLCF: 100nF; C0603; MPN CC0603KRX7R9BB104; LCSC C14663
CTXFRF: 100nF; C0603; MPN CC0603KRX7R9BB104; LCSC C14663
CYO1, CYO2: 4.7nF; CAP-TH_L11.0-W5.0-P10.00; MPN VY1472M63Y5UQ63V0; LCSC C499492
D1A1, D1A1P2, D1A2, D1A2P2, D1A3, D1A3P2, D1A4, D1A4P2, D1B1, D1B1P2, D1B2, D1B2P2, D1B3, D1B3P2, D1B4, D1B4P2: SICJBS-1200-40; TO-247-3_L15.9-W5.0-P5.44-L; MPN GC4D20120D; LCSC C7435099
D1CN, D1CP: 1N4148WS; SOD-323_L1.8-W1.3-LS2.5-RD; MPN 1N4148WS; LCSC C2128
D1HS1, D1HS2, D1LS1, D1LS2, D2HS1, D2HS2, D2LS1, D2LS2: US1M; SMA_L4.4-W2.8-LS5.4-RD; MPN US1M; LCSC C412437
D1W: BAT54A; SOT-23-3_L2.9-W1.3-P1.90-LS2.4-BR; MPN BAT54A; LCSC CLASS
DISP1: LED-2DIG-0.56CC; LED-SEG-TH_2DIG-0.56; MPN LED-2DIG-0.56CC; LCSC C9900021773
DOUT: DIODE-1600V-150A-MOD; DIODE_MOD_2T_34mm; MPN DIODE-1600V-150A-MOD; LCSC DIRECT
JB: CONN-CARD-88-H; HDR-TH_88P-2R-P2.54-V-M; MPN CONN-CARD-88-H; LCSC CLASS
JCAN: PH-4; CONN-TH_4P-P2.00_PH; MPN B4B-PH-K-S; LCSC C131334
JDCN: STUD-M8; TERM_Stud_M8; MPN STUD-M8; LCSC CLASS
JDCP: STUD-M8; TERM_Stud_M8; MPN STUD-M8; LCSC CLASS
JICB: MICROFIT3-40; CONN-TH_40P-P3.00_MicroFit; MPN MICROFIT3-40; LCSC CLASS
JOUTN: STUD-M8; TERM_Stud_M8; MPN STUD-M8; LCSC CLASS
JOUTP: STUD-M8; TERM_Stud_M8; MPN STUD-M8; LCSC CLASS
JPEB: STUD-M8; TERM_Stud_M8; MPN STUD-M8; LCSC CLASS
JTERM: PH-2; CONN-TH_2P-P2.00_PH; MPN B2B-PH-K-S; LCSC C20504437
JTLLC: PH-2; CONN-TH_2P-P2.00_PH; MPN B2B-PH-K-S; LCSC C20504437
JTXFR: PH-2; CONN-TH_2P-P2.00_PH; MPN B2B-PH-K-S; LCSC C20504437
KPARA: RELAY-PCB-120A-24V; RELAY_PCB_120A_4pin; MPN RELAY-PCB-120A-24V; LCSC DIRECT
KPARB: RELAY-PCB-120A-24V; RELAY_PCB_120A_4pin; MPN RELAY-PCB-120A-24V; LCSC DIRECT
KSER: RELAY-PCB-120A-24V; RELAY_PCB_120A_4pin; MPN RELAY-PCB-120A-24V; LCSC DIRECT
L1R: IND-LR-E70-30; L_E70_2set_gapped_custom; MPN IND-LR-E70-30; LCSC CUSTOM
LCAN: CMC-CAN-51uH; IND-SMD_L4.5-W3.2_CMC; MPN ACT45B-510-2P-TL003; LCSC C55213551
PS1H, PS1L, PS2H, PS2L: ISO-GBIAS-15-1W; PWRM-TH_QA01C; MPN ISO-GBIAS-15-1W; LCSC CLASS
PS5BKA, PS5BKB: ISO5V-RFC-6K; SIP-4_iso-module; MPN ISO5V-RFC-6K; LCSC C20613048
PSCAN: ISO5V-RFC-6K; SIP-4_iso-module; MPN ISO5V-RFC-6K; LCSC C20613048
PSSH: ISO5V-RFC-6K; SIP-4_iso-module; MPN ISO5V-RFC-6K; LCSC C20613048
Q1H, Q1L, Q2H, Q2L: SG2M023120LJ; TO-247-4_L15.8-W5.0-P2.54-L; MPN SG2M023120LJ; LCSC C5713523
QDIG1, QDIG2: S8050; SOT-23-3_L2.9-W1.3-P1.90-LS2.4-BR; MPN S8050; LCSC C2146
QDISA: SIC-1200-5A; TO-247-3_L15.9-W5.0-P5.44-L; MPN IMW120R350M1H; LCSC C536285
QDISB: SIC-1200-5A; TO-247-3_L15.9-W5.0-P5.44-L; MPN IMW120R350M1H; LCSC C536285
QPVD: S8050; SOT-23-3_L2.9-W1.3-P1.90-LS2.4-BR; MPN S8050; LCSC C2146
R1CF: 1k; R0603; MPN RC0603FR-071KL; LCSC CLASS
R1CT: 470m; R2512; MPN R2512-0R47-1W-1%; LCSC CLASS
R1HDS, R1LDS, R2HDS, R2LDS: 100R; R0603; MPN RC0603FR-07100RL; LCSC CLASS
R1HGS, R1LGS, R2HGS, R2LGS: 10k; R0805; MPN RC0805FR-0710KL; LCSC C84376
R1HOFF, R1LOFF, R2HOFF, R2LOFF: 0R; R1206; MPN R1206-RG-0.5W; LCSC CLASS
R1HON, R1LON, R2HON, R2LON: 4.7R; R1206; MPN RC1206FR-7W4R7L; LCSC C859161
R1HPD, R1LPD, R2HPD, R2LPD: 10k; R0603; MPN RC0603FR-0710KL; LCSC CLASS
R1WHA, R1WHB: 1M; R0805; MPN RC0805FR-071ML; LCSC C107700
RBDA0, RBDA1, RBDA2, RBDA3: CER-2k2-10W-AX; RES-TH_L48.0-W8.0-P54.00; MPN CER-2k2-10W-AX; LCSC CLASS
RBDB0, RBDB1, RBDB2, RBDB3: CER-2k2-10W-AX; RES-TH_L48.0-W8.0-P54.00; MPN CER-2k2-10W-AX; LCSC CLASS
RBO1, RBO2, RBO3: 150k; R2512; MPN R2512-150k-HV; LCSC CLASS
RCGB: 1M; R1206; MPN RC1206FR-071ML; LCSC CLASS
RDIG1, RDIG2: 2.2k; R0603; MPN RC0603FR-072K2L; LCSC CLASS
RF11H, RF11L: 2k; R0603; MPN R-small; LCSC CLASS
RF11M: 2.67k; R0603; MPN R-small; LCSC CLASS
RFDMP: RTF-50W-R33-TO247; TO-247-2_L15.9-W5.0-P10.88-L; MPN RTF-50W-R33-TO247; LCSC CLASS
RHPD1, RHPD2: 10k; R0603; MPN HV732BTTD4753F; LCSC C4121673
ROAD0, ROAD1, ROAD2, ROAD3, ROAD4, ROAD5, ROAD6, ROAD7: 475k; R1206; MPN HV732BTTD4753F; LCSC C4121673
ROADL: 6.8k; R0805; MPN ARG05BTC6801; LCSC C3033907
ROAO: 100R; R0603; MPN RC0603FR-07100RL; LCSC CLASS
ROBD0, ROBD1, ROBD2, ROBD3, ROBD4, ROBD5, ROBD6, ROBD7: 475k; R1206; MPN HV732BTTD4753F; LCSC C4121673
ROBDL: 6.8k; R0805; MPN ARG05BTC6801; LCSC C3033907
ROBO: 100R; R0603; MPN RC0603FR-07100RL; LCSC CLASS
ROVD0, ROVD1, ROVD2, ROVD3, ROVD4, ROVD5, ROVD6, ROVD7: 475k; R1206; MPN HV732BTTD4753F; LCSC C4121673
ROVDL: 6.8k; R0805; MPN ARG05BTC6801; LCSC C3033907
ROVO: 100R; R0603; MPN RC0603FR-07100RL; LCSC CLASS
RPDB0, RPDB1, RPDB2, RPDB3, RPDB4, RPDB5: 10k; R0603; MPN R0603-10k; LCSC CLASS
RPVBA: 6.8M; R0805; MPN R-small; LCSC CLASS
RPVBB: 6.8M; R0805; MPN R-small; LCSC CLASS
RPVDB: 4.7k; R0603; MPN RC0603FR-074K7L; LCSC CLASS
RPVDP: 10k; R0603; MPN RC0603FR-0710KL; LCSC CLASS
RPVLA: 1k; R1812; MPN R2010-1k-0.75W-1%; LCSC CLASS
RPVLB: 1k; R1812; MPN R2010-1k-0.75W-1%; LCSC CLASS
RROLEB: 0R; R0603; MPN RC0603JR-070RL; LCSC CLASS
RSEG0, RSEG1, RSEG2, RSEG3, RSEG4, RSEG5, RSEG6, RSEG7: 220R; R0603; MPN RC0603FR-07220RL; LCSC C107696
RSHO: SHUNT-50MV-100A; SHUNT_4-terminal_manganin; MPN SHUNT-50MV-100A; LCSC CLASS
RSHON: 100R; R0603; MPN RC0603FR-07100RL; LCSC CLASS
RSHOP: 100R; R0603; MPN RC0603FR-07100RL; LCSC CLASS
RSW1, RSW2: 10k; R0603; MPN RC0603FR-0710KL; LCSC CLASS
RTERM: 120R; R1206; MPN RC1206FR-07120RL; LCSC C114928
RTLLCP: 10k; R0603; MPN RC0603FR-0710KL; LCSC CLASS
RTXFRP: 10k; R0603; MPN RC0603FR-0710KL; LCSC CLASS
SW1, SW2: TACT-6x6; KEY-SMD_4P-L6.0-W6.0; MPN TACT-6x6; LCSC C318884
T1A, T1B: XFMR-LLC-CELL-2E70-30; XFMR_E70_cell_custom; MPN XFMR-LLC-CELL-2E70-30; LCSC CUSTOM
TVSCAN: PESD1CAN; SOT-23-3_L2.9-W1.3-P1.90-LS2.4-BR; MPN PESD1CAN; LCSC C143073
U1H, U1L, U2H, U2L: NSI6611; SOIC-16_L10.3-W7.5-P1.27-LS10.3-BL; MPN NSI6611; LCSC C7470934
U1W: TLV3202; SOIC-8_L4.9-W3.9-P1.27-LS6.0-BL; MPN TLV3202-class; LCSC CLASS
UCAN: NSI1042-DSWR; SOIC-16_L10.3-W7.5-P1.27-LS10.3-BL; MPN NSI1042-DSWR; LCSC C3445856
UEXCL: 74HC02; SOIC-14_L8.7-W3.9-P1.27-LS6.0-BL; MPN 74HC02D; LCSC ORDERABLE
UIVOA: AMC1311; SOIC-8_L5.9-W7.5-P1.27-LS11.5-BL; MPN AMC1311DWVR; LCSC C456277
UIVOB: AMC1311; SOIC-8_L5.9-W7.5-P1.27-LS11.5-BL; MPN AMC1311DWVR; LCSC C456277
UIVOV: AMC1311; SOIC-8_L5.9-W7.5-P1.27-LS11.5-BL; MPN AMC1311DWVR; LCSC C456277
ULB: ULN2803A; SOIC-18_L11.6-W7.5-P1.27-LS10.3-BL; MPN ULN2803A; LCSC C2865085
UPVA: VOM1271T; SOP-4_L4.4-W4.3-P2.54-LS7.0-BL; MPN VOM1271T; LCSC C146286
UPVB: VOM1271T; SOP-4_L4.4-W4.3-P2.54-LS7.0-BL; MPN VOM1271T; LCSC C146286
USHO: NSI1200-DSWR; SOIC-8_L5.9-W7.5-P1.27-LS11.5-BL; MPN NSI1200-DSWR; LCSC C3029747
USR1: 74HC595; SOIC-16_L9.9-W3.9-P1.27-LS6.0-BL; MPN 74HC595; LCSC C19192516

Notes on the sheet:
BANKS-SP / BANK-A
BANKS-SP / BANK-B
BANKS-SP / SP-MATRIX
BANKS-SP / BLEEDERS
COMMS-HMI / CAN
COMMS-HMI / HMI
CONTROL / CARD-IF
CONTROL / COIL-DRIVER
CONTROL / INTERCONNECT
LLC-LEGS / BUS-IN
LLC-LEGS / LEG-1
LLC-LEGS / LEG-2
LLC-TANKS / TANK
LLC-TANKS / RECT-A
LLC-TANKS / RECT-B
LLC-TANKS / F11-WINDOW
OUTPUT-SENSING / OUTPUT
OUTPUT-SENSING / SENSE-VBKA
OUTPUT-SENSING / SENSE-VBKB
OUTPUT-SENSING / SENSE-VOUT
OUTPUT-SENSING / ISO-BIAS
OUTPUT-SENSING / NTC
