vectivolt/DC-Modules/kicad5/dc-modules-60kw/60kw-acdc.sch

## KiCad design kicad5/dc-modules-60kw/60kw-acdc.sch (2026-09-08)

Schematic: 60kw-acdc.sch

Parts:
CA0C, CA1C: 100nF; CAP-TH_L7.2-W3.5-P5.00; MPN FILM-100n-250; LCSC CLASS
CA0F, CA1F: 1nF; C0805; MPN CC0603KRX7R9BB102; LCSC C100040
CA0FN, CA0FP, CA1FN, CA1FP: 1uF; CAP-TH_L26.5-W11.0-P22.50; MPN PP-1u-600; LCSC CLASS
CA0GB1, CA0GB2, CA1GB1, CA1GB2: 1uF; C0402; MPN CL21B105KBFNNNE; LCSC C28323
CA0GBL, CA1GBL: 100pF; C0805; MPN CC0603JRNPO9BN101; LCSC C14665
CA0SN, CA1SN: 100pF; C1812; MPN CC1812JKNPODBN101; LCSC C577319
CAUX15, CAUX24: 220uF; CAP-TH_L8.0-W8.0-P3.50; MPN GR227M035F12RR0VL4FP0; LCSC C45078
CB0C, CB1C: 100nF; CAP-TH_L7.2-W3.5-P5.00; MPN FILM-100n-250; LCSC CLASS
CB0F, CB1F: 1nF; C0805; MPN CC0603KRX7R9BB102; LCSC C100040
CB0FN, CB0FP, CB1FN, CB1FP: 1uF; CAP-TH_L26.5-W11.0-P22.50; MPN PP-1u-600; LCSC CLASS
CB0GB1, CB0GB2, CB1GB1, CB1GB2: 1uF; C0402; MPN CL21B105KBFNNNE; LCSC C28323
CB0GBL, CB1GBL: 100pF; C0805; MPN CC0603JRNPO9BN101; LCSC C14665
CB0SN, CB1SN: 100pF; C1812; MPN CC1812JKNPODBN101; LCSC C577319
CBMDF: 1nF; C0805; MPN CC0603KRX7R9BB102; LCSC C100040
CBPDF: 1nF; C0805; MPN CC0603KRX7R9BB102; LCSC C100040
CC0C, CC1C: 100nF; CAP-TH_L7.2-W3.5-P5.00; MPN FILM-100n-250; LCSC CLASS
CC0F, CC1F: 1nF; C0805; MPN CC0603KRX7R9BB102; LCSC C100040
CC0FN, CC0FP, CC1FN, CC1FP: 1uF; CAP-TH_L26.5-W11.0-P22.50; MPN PP-1u-600; LCSC CLASS
CC0GB1, CC0GB2, CC1GB1, CC1GB2: 1uF; C0402; MPN CL21B105KBFNNNE; LCSC C28323
CC0GBL, CC1GBL: 100pF; C0805; MPN CC0603JRNPO9BN101; LCSC C14665
CC0SN, CC1SN: 100pF; C1812; MPN CC1812JKNPODBN101; LCSC C577319
CCLA: 10nF; CAP-TH_L18.0-W5.0-P15.00; MPN PP-10n-1200; LCSC CLASS
CCOMP: 100nF; C0805; MPN CC0603KRX7R9BB104; LCSC C14663
CCSF: 470pF; C0805; MPN CC0805KRX7R9BB471; LCSC C107152
CDB00, CDB01, CDB02, CDB03, CDB04, CDB10, CDB11, CDB12, CDB13: 470uF; CAP-TH_L30.0-W30.0-P10.00; MPN ELH-470u450; LCSC CLASS
CDT00, CDT01, CDT02, CDT03, CDT04, CDT10, CDT11, CDT12, CDT13: 470uF; CAP-TH_L30.0-W30.0-P10.00; MPN ELH-470u450; LCSC CLASS
CMC1, CMC2: CMC-3PH-2mH-SKU; L_CMC_3ph_nanocryst_per-SKU; MPN CMC-3PH-2mH-SKU; LCSC CUSTOM
CPET: 4.7nF; CAP-TH_L11.0-W5.0-P10.00; MPN VY1472M63Y5UQ63V0; LCSC C499492
CTA0, CTA1: ACX-1100; MPN ACX-1100; LCSC REVIEW
CTB0, CTB1: ACX-1100; MPN ACX-1100; LCSC REVIEW
CTC0, CTC1: ACX-1100; MPN ACX-1100; LCSC REVIEW
CTINLF: 100nF; C0805; MPN CC0603KRX7R9BB104; LCSC C14663
CTPFCF: 100nF; C0805; MPN CC0603KRX7R9BB104; LCSC C14663
CV1DF, CV2DF, CV3DF: 10nF; C0805; MPN CC0603KRX7R9BB103; LCSC C100042
CVCC: 47uF; CAP-TH_L6.3-W6.3-P2.50; MPN KS476M035E07RR0VH2FP0; LCSC C13654
CX11, CX12, CX13, CX21, CX22, CX23: 2.2uF; CAP-TH_L26.5-W11.0-P22.50; MPN X1-2u2-530; LCSC CLASS
CY1, CY2, CY3: 4.7nF; CAP-TH_L11.0-W5.0-P10.00; MPN VY1472M63Y5UQ63V0; LCSC C499492
DA0B, DA0T, DA1B, DA1T: SICJBS-1200-40; TO-247-3_L15.9-W5.0-P5.44-L; MPN GC4D20120D; LCSC C7435099
DA0C, DA1C: SICJBS-1200-10; TO-247-3_L15.9-W5.0-P5.44-L; MPN GC4D10120H; LCSC C7435087
DA0GS1, DA0GS2, DA1GS1, DA1GS2: US1M; SMA_L4.4-W2.8-LS5.4-RD; MPN US1M; LCSC C412437
DA0N, DA0P, DA1N, DA1P: 1N4148WS; SOD-323_L1.8-W1.3-LS2.5-RD; MPN 1N4148WS; LCSC C2128
DAUX15: US2G; SMB_L4.5-W3.6-LS5.3-RD; MPN US2G; LCSC C49263
DAUX24: UF-400V-3A; SMC_L8.0-W5.9-LS9.0-RD; MPN US3M; LCSC C3039981
DAUXVC: US2G; SMB_L4.5-W3.6-LS5.3-RD; MPN US2G; LCSC C49263
DB0B, DB0T, DB1B, DB1T: SICJBS-1200-40; TO-247-3_L15.9-W5.0-P5.44-L; MPN GC4D20120D; LCSC C7435099
DB0C, DB1C: SICJBS-1200-10; TO-247-3_L15.9-W5.0-P5.44-L; MPN GC4D10120H; LCSC C7435087
DB0GS1, DB0GS2, DB1GS1, DB1GS2: US1M; SMA_L4.4-W2.8-LS5.4-RD; MPN US1M; LCSC C412437
DB0N, DB0P, DB1N, DB1P: 1N4148WS; SOD-323_L1.8-W1.3-LS2.5-RD; MPN 1N4148WS; LCSC C2128
DC0B, DC0T, DC1B, DC1T: SICJBS-1200-40; TO-247-3_L15.9-W5.0-P5.44-L; MPN GC4D20120D; LCSC C7435099
DC0C, DC1C: SICJBS-1200-10; TO-247-3_L15.9-W5.0-P5.44-L; MPN GC4D10120H; LCSC C7435087
DC0GS1, DC0GS2, DC1GS1, DC1GS2: US1M; SMA_L4.4-W2.8-LS5.4-RD; MPN US1M; LCSC C412437
DC0N, DC0P, DC1N, DC1P: 1N4148WS; SOD-323_L1.8-W1.3-LS2.5-RD; MPN 1N4148WS; LCSC C2128
DCLA: FAST-1200-1A; SMB_L4.5-W3.6-LS5.3-RD; MPN STTH112U; LCSC C56792
DTVS15: SMBJ16A; SMB_L4.5-W3.6-LS5.3-RD; MPN SMBJ16A; LCSC C151859
DTVS24: SMBJ26A; SMB_L4.5-W3.6-LS5.3-RD; MPN SMBJ26A; LCSC C127562
F1, F2, F3: FUSE-gG-690V-125A; FUSE_holder_NH00; MPN FUSE-gG-690V-125A; LCSC CLASS
GDT1, GDT2, GDT3: GDT-3k5-20kA; GDT-8mm_RM6; MPN GDT-3k5-20kA; LCSC C9900081756
JA: CONN-CARD-88-H; MPN CONN-CARD-88-H; LCSC UNMAPPED
JACL1, JACL2, JACL3: STUD-M8; TERM_Stud_M8; MPN STUD-M8; LCSC CLASS
JDCN: STUD-M8; TERM_Stud_M8; MPN STUD-M8; LCSC CLASS
JDCP: STUD-M8; TERM_Stud_M8; MPN STUD-M8; LCSC CLASS
JFAN1, JFAN2: PH-4-FAN; CONN-TH_4P-P2.00_PH; MPN B4B-PH-K-S; LCSC C131334
JICA: MICROFIT3-16; CONN-TH_16P-P3.00_MicroFit; MPN MICROFIT3-16; LCSC C277731
JPE: STUD-M8; TERM_Stud_M8; MPN STUD-M8; LCSC CLASS
JPEB: STUD-M8; TERM_Stud_M8; MPN STUD-M8; LCSC CLASS
JTINL: PH-2; CONN-TH_2P-P2.00_PH; MPN B2B-PH-K-S; LCSC C20504437
JTPFC: PH-2; CONN-TH_2P-P2.00_PH; MPN B2B-PH-K-S; LCSC C20504437
KPRE1, KPRE2: HF167F-120A-M; RELAY_HF167F_PCB; MPN HF167F-120A-M; LCSC REVIEW
LA0, LA1: IND-PFC-165u; L_Toroid_3xT79_26u_custom; MPN IND-PFC-165u; LCSC CLASS
LB0, LB1: IND-PFC-165u; L_Toroid_3xT79_26u_custom; MPN IND-PFC-165u; LCSC CLASS
LC0, LC1: IND-PFC-165u; L_Toroid_3xT79_26u_custom; MPN IND-PFC-165u; LCSC CLASS
LDM1, LDM2, LDM3: DM-22u-SKU; L_Toroid_sendust_per-SKU; MPN DM-22u-SKU; LCSC CLASS
MOV1, MOV2, MOV3: S20K550; DISC-20mm_RM10; MPN S20K550; LCSC C317868
MOVP1, MOVP2, MOVP3: S20K550; DISC-20mm_RM10; MPN S20K550; LCSC C317868
PS5AC, PS5BUS: ISO5V-RFC-6K; SIP-4_iso-module; MPN ISO5V-RFC-6K; LCSC C20613048
PSA0G, PSA1G: QA01C; PWRM-TH_QA01C; MPN QA01C; LCSC C2757491
PSB0G, PSB1G: QA01C; PWRM-TH_QA01C; MPN QA01C; LCSC C2757491
PSC0G, PSC1G: QA01C; PWRM-TH_QA01C; MPN QA01C; LCSC C2757491
PSQD: QA01C; PWRM-TH_QA01C; MPN QA01C; LCSC C2757491
QA0A, QA0B, QA1A, QA1B: B3M010C075Z; TO-247-4_L15.8-W5.0-P2.54-L; MPN B3M010C075Z; LCSC C5713521
QAUX: SIC-1700-1R; TO-247-3_L15.9-W5.0-P5.44-L; MPN C2M1000170D; LCSC C5713500
QB0A, QB0B, QB1A, QB1B: B3M010C075Z; TO-247-4_L15.8-W5.0-P2.54-L; MPN B3M010C075Z; LCSC C5713521
QC0A, QC0B, QC1A, QC1B: B3M010C075Z; TO-247-4_L15.8-W5.0-P2.54-L; MPN B3M010C075Z; LCSC C5713521
QDIS: TAB-M4; TERM_Tab_M4; MPN TAB-M4; LCSC CLASS
QDISF: SIC-1200-5A; TO-247-3_L15.9-W5.0-P5.44-L; MPN IMW120R350M1H; LCSC C536285
RA0B, RA1B: 27R; MPN RC1206FR-0727RL; LCSC undefined
RA0C, RA1C: WW-470R-10W; RES-TH_L48.0-W8.0-P54.00; MPN WW-470R-10W; LCSC CLASS
RA0F, RA1F: 1k; R0805; MPN RC0805FR-071KL; LCSC C95781
RA0GGS, RA0GPD, RA1GGS, RA1GPD: 10k; R0805; MPN RC0805FR-0710KL; LCSC C84376
RA0GOFF, RA0GON, RA1GOFF, RA1GON: 4.7R; R1206; MPN RC1206FR-7W4R7L; LCSC C859161
RA0SN, RA1SN: 10R; R2512; MPN CRM2512-FX-10R0ELF; LCSC C840605
RALRS: 100R; R0805; MPN RC0805FR-07100RL; LCSC C105577
RALRX: 10k; R0805; MPN RC0805FR-0710KL; LCSC C84376
RALTS: 100R; R0805; MPN RC0805FR-07100RL; LCSC C105577
RALTX: 10k; R0805; MPN RC0805FR-0710KL; LCSC C84376
RAUXCS: 310m; R1206; MPN PT1206FR-7W0R31L; LCSC C6148847
RAUXG: 100k; R0805; MPN RC0805FR-07100KL; LCSC C96346
RAUXRT: 66.5k; R0805; MPN R-small; LCSC CLASS
RAUXST1, RAUXST2: 470k; R2512; MPN R2512-HV; LCSC CLASS
RB0B, RB1B: 27R; MPN RC1206FR-0727RL; LCSC undefined
RB0C, RB1C: WW-470R-10W; RES-TH_L48.0-W8.0-P54.00; MPN WW-470R-10W; LCSC CLASS
RB0F, RB1F: 1k; R0805; MPN RC0805FR-071KL; LCSC C95781
RB0GGS, RB0GPD, RB1GGS, RB1GPD: 10k; R0805; MPN RC0805FR-0710KL; LCSC C84376
RB0GOFF, RB0GON, RB1GOFF, RB1GON: 4.7R; R1206; MPN RC1206FR-7W4R7L; LCSC C859161
RB0SN, RB1SN: 10R; R2512; MPN CRM2512-FX-10R0ELF; LCSC C840605
RBALB0A, RBALB0B, RBALB1A, RBALB1B: 47k; R2512; MPN PS122WF4702T4E; LCSC C2793932
RBALT0A, RBALT0B, RBALT1A, RBALT1B: 47k; R2512; MPN PS122WF4702T4E; LCSC C2793932
RBMD0, RBMD1, RBMD2, RBMD3, RBMD4, RBMD5, RBMD6, RBMD7: 475k; R1206; MPN HV732BTTD4753F; LCSC C4121673
RBMDL: 6.8k; R0805; MPN ARG05BTC6801; LCSC C3033907
RBPD0, RBPD1, RBPD2, RBPD3, RBPD4, RBPD5, RBPD6, RBPD7: 475k; R1206; MPN HV732BTTD4753F; LCSC C4121673
RBPDL: 6.8k; R0805; MPN ARG05BTC6801; LCSC C3033907
RBR1A, RBR1B: 2.4M; R2512; MPN R2512-HV; LCSC CLASS
RBR2: 15k; R0805; MPN RC0805FR-0715KL; LCSC C114559
RC0B, RC1B: 27R; MPN RC1206FR-0727RL; LCSC undefined
RC0C, RC1C: WW-470R-10W; RES-TH_L48.0-W8.0-P54.00; MPN WW-470R-10W; LCSC CLASS
RC0F, RC1F: 1k; R0805; MPN RC0805FR-071KL; LCSC C95781
RC0GGS, RC0GPD, RC1GGS, RC1GPD: 10k; R0805; MPN RC0805FR-0710KL; LCSC C84376
RC0GOFF, RC0GON, RC1GOFF, RC1GON: 4.7R; R1206; MPN RC1206FR-7W4R7L; LCSC C859161
RC0SN, RC1SN: 10R; R2512; MPN CRM2512-FX-10R0ELF; LCSC C840605
RCLA1, RCLA2: 47k; R2512; MPN R2512-HV; LCSC CLASS
RCOMP: 10k; R0805; MPN RC0805FR-0710KL; LCSC C84376
RCSF: 1k; R0805; MPN RC0805FR-071KL; LCSC C95781
RDIS0, RDIS1, RDIS2, RDIS3: CER-25W-AX; RES-TH_L60.0-W9.0-P66.00; MPN CER-25W-AX; LCSC CLASS
RFB1: 118k; R0805; MPN RC0805FR-07118KL; LCSC C274001
RFB2: 10k; R0805; MPN RC0805FR-0710KL; LCSC C84376
RFT1, RFT2: 10k; R0805; MPN RC0805FR-0710KL; LCSC C84376
RKFBP: 10k; R0805; MPN RC0805FR-0710KL; LCSC C84376
RM15A: 47k; R0805; MPN RC0805FR-0747KL; LCSC C126351
RM15B, RM24B: 10k; R0805; MPN RC0805FR-0710KL; LCSC C84376
RM24A: 68k; R0805; MPN RC0805FR-0768KL; LCSC C114548
RNS1A, RNS1B, RNS2A, RNS2B, RNS3A, RNS3B: 47k; R2512; MPN PS122WF4702T4E; LCSC C2793932
RPD0, RPD1, RPD2, RPD3, RPD4: 10k; MPN R0603-10k; LCSC UNMAPPED
RPET: 1M; R1206; MPN RC0805FR-071ML; LCSC C107700
RPRE1, RPRE2: CER-25W-AX; RES-TH_L60.0-W9.0-P66.00; MPN CER-25W-AX; LCSC CLASS
RQDG: 100R; R0805; MPN RC0805FR-07100RL; LCSC C105577
RQDL: 330R; R0805; MPN RC0805FR-07330RL; LCSC C110440
RQDPD: 10k; R0805; MPN RC0805FR-0710KL; LCSC C84376
RROLE: 10k; R0805; MPN RC0805FR-0710KL; LCSC C84376
RTINLP: 10k; R0805; MPN RC0805FR-0710KL; LCSC C84376
RTPFCP: 10k; R0805; MPN RC0805FR-0710KL; LCSC C84376
RV1D0, RV1D1, RV1D2, RV1D3, RV1D4, RV1D5, RV1D6, RV1D7, RV2D0, RV2D1, RV2D2, RV2D3, RV2D4, RV2D5, RV2D6, RV2D7, RV3D0, RV3D1, RV3D2, RV3D3, RV3D4, RV3D5, RV3D6, RV3D7: 475k; R1206; MPN HV732BTTD4753F; LCSC C4121673
RV1DL, RV2DL, RV3DL: 11.5k; R0805; MPN RT0805BRD0711K5L; LCSC C865153
TAUX: XFMR-AUX-FLY-C; XFMR_ETD34_custom; MPN XFMR-AUX-FLY-C; LCSC CUSTOM
UA0G, UA1G: NSI6611; SOIC-16_L10.3-W7.5-P1.27-LS10.3-BL; MPN NSI6611; LCSC C7470934
UAUX: NCP1252A; SOIC-8_L4.9-W3.9-P1.27-LS6.0-BL; MPN NCP1252A; LCSC C80800
UB0G, UB1G: NSI6611; SOIC-16_L10.3-W7.5-P1.27-LS10.3-BL; MPN NSI6611; LCSC C7470934
UC0G, UC1G: NSI6611; SOIC-16_L10.3-W7.5-P1.27-LS10.3-BL; MPN NSI6611; LCSC C7470934
UIVBM: AMC1311; SOIC-8_L5.9-W7.5-P1.27-LS11.5-BL; MPN AMC1311DWVR; LCSC C456277
UIVBP: AMC1311; SOIC-8_L5.9-W7.5-P1.27-LS11.5-BL; MPN AMC1311DWVR; LCSC C456277
UIVV1, UIVV2, UIVV3: AMC1350; SOIC-8_L5.9-W7.5-P1.27-LS11.5-BL; MPN AMC1350QDWVRQ1; LCSC C5214206
UPA: ULN2803A; SOIC-18_L11.6-W7.5-P1.27-LS10.3-BL; MPN ULN2803A; LCSC C2865085
UQD: TLP152; SOP-6_L7.0-W4.4-P1.27-LS7.6-BL; MPN TLP152; LCSC C17255258

Notes on the sheet:
SHEET INDEX
60 kW AC-DC (lower) - 1 of 3
AC-SENSING - 10 sections
VIENNA-PFC - 6 sections
AUX-POWER - 4 sections
CONTROL - 4 sections
DC-LINK - 4 sections
INPUT-EMI - 4 sections
rev D.3 - 32 sections - 370 components
NET NAMING
internal junctions are named for what they join
U<ref>_<PIN> node at that IC pin e.g. UIVOA_VINP
R<stem>_M midpoint of a series pair e.g. RBALTA_M
R<stem>_<nm> tap between R<stem>n/m e.g. RV1D_01
all others are explicit design nets
AC-SENSING / STAR
AC-SENSING / SENSE-VAC1
AC-SENSING / SENSE-VAC2
AC-SENSING / SENSE-VAC3
AC-SENSING / SENSE-VBUS
AC-SENSING / SENSE-VMID
AC-SENSING / ISO-BIAS
AC-SENSING / NTC
AC-SENSING / LINE-CTS-0
AC-SENSING / LINE-CTS-1
AUX-POWER / FLYBACK
AUX-POWER / RAILS
AUX-POWER / FANS
AUX-POWER / INTERCONNECT
CONTROL / CARD-IF
CONTROL / GROUNDING
CONTROL / COIL-DRIVER
CONTROL / RAIL-MON
DC-LINK / DISCHARGE
DC-LINK / BUS-STUDS
DC-LINK / LINK-BANK-0
DC-LINK / LINK-BANK-1
INPUT-EMI / AC-ENTRY
INPUT-EMI / SURGE
INPUT-EMI / EMI-FILTER
INPUT-EMI / PRECHARGE
VIENNA-PFC / PHASE-A0
VIENNA-PFC / PHASE-B0
VIENNA-PFC / PHASE-C0
VIENNA-PFC / PHASE-A1
VIENNA-PFC / PHASE-B1
VIENNA-PFC / PHASE-C1
