vectivolt/DC-Modules/kicad5/dc-modules-60kw/60kw-dcdc.sch

## KiCad design kicad5/dc-modules-60kw/60kw-dcdc.sch (2026-09-08)

Schematic: 60kw-dcdc.sch

Parts:
C1CF, C2CF, C3CF, C4CF, C5CF, C6CF: 220pF; C0805; MPN CC0603JRNPO9BN221; LCSC C106210
C1HB1, C1HB2, C1LB1, C1LB2, C2HB1, C2HB2, C2LB1, C2LB2, C3HB1, C3HB2, C3LB1, C3LB2, C4HB1, C4HB2, C4LB1, C4LB2, C5HB1, C5HB2, C5LB1, C5LB2, C6HB1, C6HB2, C6LB1, C6LB2: 1uF; C0402; MPN CL21B105KBFNNNE; LCSC C28323
C1HBL, C1LBL, C2HBL, C2LBL, C3HBL, C3LBL, C4HBL, C4LBL, C5HBL, C5LBL, C6HBL, C6LBL: 100pF; C0805; MPN CC0603JRNPO9BN101; LCSC C14665
C1R0, C1R1, C1R2, C1R3, C2R0, C2R1, C2R2, C2R3, C3R0, C3R1, C3R2, C3R3, C4R0, C4R1, C4R2, C4R3, C5R0, C5R1, C5R2, C5R3, C6R0, C6R1, C6R2, C6R3: 46nF; CAP-TH_L31.5-W13.0-P27.50; MPN PP-46n-1200; LCSC CLASS
CBA0B, CBA0T, CBA1B, CBA1T, CBA2B, CBA2T, CBA3B, CBA3T: 470uF; CAP-TH_L30.0-W30.0-P10.00; MPN ELH-470u450; LCSC CLASS
CBAF: 1uF; CAP-TH_L31.5-W13.0-P27.50; MPN PP-1u-1100; LCSC CLASS
CBB0B, CBB0T, CBB1B, CBB1T, CBB2B, CBB2T, CBB3B, CBB3T: 470uF; CAP-TH_L30.0-W30.0-P10.00; MPN ELH-470u450; LCSC CLASS
CBBF: 1uF; CAP-TH_L31.5-W13.0-P27.50; MPN PP-1u-1100; LCSC CLASS
CCGB: 4.7nF; C1206; MPN CC1206KRX7R9BB472; LCSC C107208
CF0, CF1, CF2, CF3, CF4, CF5: 1uF; CAP-TH_L31.5-W13.0-P27.50; MPN PP-1u-1100; LCSC CLASS
COADF: 1nF; C0805; MPN CC0603KRX7R9BB102; LCSC C100040
COBDF: 1nF; C0805; MPN CC0603KRX7R9BB102; LCSC C100040
COF1, COF2: 4.7uF; CAP-TH_L41.5-W20.0-P37.50; MPN PP-4u7-1200; LCSC CLASS
COVDF: 1nF; C0805; MPN CC0603KRX7R9BB102; LCSC C100040
CSW1, CSW2: 100nF; C0805; MPN CC0603KRX7R9BB104; LCSC C14663
CT1, CT2, CT3, CT4, CT5, CT6: AS-404; MPN AS-404; LCSC REVIEW
CTLLCF: 100nF; C0805; MPN CC0603KRX7R9BB104; LCSC C14663
CTXFRF: 100nF; C0805; MPN CC0603KRX7R9BB104; LCSC C14663
CYO1, CYO2: 4.7nF; CAP-TH_L11.0-W5.0-P10.00; MPN VY1472M63Y5UQ63V0; LCSC C499492
D1A1, D1A2, D1A3, D1A4, D1B1, D1B2, D1B3, D1B4, D2A1, D2A2, D2A3, D2A4, D2B1, D2B2, D2B3, D2B4, D3A1, D3A2, D3A3, D3A4, D3B1, D3B2, D3B3, D3B4, D4A1, D4A2, D4A3, D4A4, D4B1, D4B2, D4B3, D4B4, D5A1, D5A2, D5A3, D5A4, D5B1, D5B2, D5B3, D5B4, D6A1, D6A2, D6A3, D6A4, D6B1, D6B2, D6B3, D6B4: SICJBS-1200-20; TO-247-3_L15.9-W5.0-P5.44-L; MPN C4D20120D; LCSC C5713501
D1CN, D1CP, D2CN, D2CP, D3CN, D3CP, D4CN, D4CP, D5CN, D5CP, D6CN, D6CP: 1N4148WS; SOD-323_L1.8-W1.3-LS2.5-RD; MPN 1N4148WS; LCSC C2128
D1HS1, D1HS2, D1LS1, D1LS2, D2HS1, D2HS2, D2LS1, D2LS2, D3HS1, D3HS2, D3LS1, D3LS2, D4HS1, D4HS2, D4LS1, D4LS2, D5HS1, D5HS2, D5LS1, D5LS2, D6HS1, D6HS2, D6LS1, D6LS2: US1M; SMA_L4.4-W2.8-LS5.4-RD; MPN US1M; LCSC C412437
DISP1: LED-2DIG-0.56CC; LED-SEG-TH_2DIG-0.56; MPN LED-2DIG-0.56CC; LCSC C9900021773
JB: CONN-CARD-88-H; MPN CONN-CARD-88-H; LCSC UNMAPPED
JCAN: PH-4; CONN-TH_4P-P2.00_PH; MPN B4B-PH-K-S; LCSC C131334
JDCN: STUD-M8; TERM_Stud_M8; MPN STUD-M8; LCSC CLASS
JDCP: STUD-M8; TERM_Stud_M8; MPN STUD-M8; LCSC CLASS
JICB: MICROFIT3-16; CONN-TH_16P-P3.00_MicroFit; MPN MICROFIT3-16; LCSC C277731
JOUTN: STUD-M8; TERM_Stud_M8; MPN STUD-M8; LCSC CLASS
JOUTP: STUD-M8; TERM_Stud_M8; MPN STUD-M8; LCSC CLASS
JPEB: STUD-M8; TERM_Stud_M8; MPN STUD-M8; LCSC CLASS
JTERM: PH-2; CONN-TH_2P-P2.00_PH; MPN B2B-PH-K-S; LCSC C20504437
JTLLC: PH-2; CONN-TH_2P-P2.00_PH; MPN B2B-PH-K-S; LCSC C20504437
JTXFR: PH-2; CONN-TH_2P-P2.00_PH; MPN B2B-PH-K-S; LCSC C20504437
KOUT: HFE82V-M; RELAY_HFE82V_PCB; MPN HFE82V-M-CLASS; LCSC REVIEW
KPARA: HFE82V-M; RELAY_HFE82V_PCB; MPN HFE82V-M-CLASS; LCSC REVIEW
KPARB: HFE82V-M; RELAY_HFE82V_PCB; MPN HFE82V-M-CLASS; LCSC REVIEW
KPREA: HFE82V-20-M; MPN HFE82V-20-M-CLASS; LCSC REVIEW
KPREB: HFE82V-20-M; MPN HFE82V-20-M-CLASS; LCSC REVIEW
KSER: HFE82V-M; RELAY_HFE82V_PCB; MPN HFE82V-M-CLASS; LCSC REVIEW
L1T, L2T, L3T, L4T, L5T, L6T: IND-TRIM-BIN4; L_Toroid_trim_bin_custom; MPN IND-TRIM-BIN4; LCSC CLASS
LCAN: CMC-CAN-51uH; IND-SMD_L4.5-W3.2_CMC; MPN ACT45B-510-2P-TL003; LCSC C55213551
PS1H, PS1L, PS2H, PS2L, PS3H, PS3L, PS4H, PS4L, PS5H, PS5L, PS6H, PS6L: QA01C; PWRM-TH_QA01C; MPN QA01C; LCSC C2757491
PS5BKA, PS5BKB: ISO5V-RFC-6K; SIP-4_iso-module; MPN ISO5V-RFC-6K; LCSC C20613048
PSCAN: ISO5V-RFC-6K; SIP-4_iso-module; MPN ISO5V-RFC-6K; LCSC C20613048
PSSH: ISO5V-RFC-6K; SIP-4_iso-module; MPN ISO5V-RFC-6K; LCSC C20613048
Q1H, Q1L, Q2H, Q2L, Q3H, Q3L, Q4H, Q4L, Q5H, Q5L, Q6H, Q6L: SG2M023120LJ; TO-247-4_L15.8-W5.0-P2.54-L; MPN SG2M023120LJ; LCSC C5713523
QDIG1, QDIG2: S8050; SOT-23-3_L2.9-W1.3-P1.90-LS2.4-BR; MPN S8050; LCSC C2146
QDISA: SIC-1200-5A; TO-247-3_L15.9-W5.0-P5.44-L; MPN IMW120R350M1H; LCSC C536285
QDISB: SIC-1200-5A; TO-247-3_L15.9-W5.0-P5.44-L; MPN IMW120R350M1H; LCSC C536285
R1CF, R2CF, R3CF, R4CF, R5CF, R6CF: 1k; R0805; MPN RC0805FR-071KL; LCSC C95781
R1CT, R2CT, R3CT, R4CT, R5CT, R6CT: 2R; R2512; MPN 25121WF200KT4E; LCSC C49298
R1HGS, R1HPD, R1LGS, R1LPD, R2HGS, R2HPD, R2LGS, R2LPD, R3HGS, R3HPD, R3LGS, R3LPD, R4HGS, R4HPD, R4LGS, R4LPD, R5HGS, R5HPD, R5LGS, R5LPD, R6HGS, R6HPD, R6LGS, R6LPD: 10k; R0805; MPN RC0805FR-0710KL; LCSC C84376
R1HOFF, R1LOFF, R2HOFF, R2LOFF, R3HOFF, R3LOFF, R4HOFF, R4LOFF, R5HOFF, R5LOFF, R6HOFF, R6LOFF: 2.2R; R1206; MPN SR1206FR-7W2R2L; LCSC C873951
R1HON, R1LON, R2HON, R2LON, R3HON, R3LON, R4HON, R4LON, R5HON, R5LON, R6HON, R6LON: 4.7R; R1206; MPN RC1206FR-7W4R7L; LCSC C859161
RBALBA1, RBALBA2: 47k; R2512; MPN PS122WF4702T4E; LCSC C2793932
RBALBB1, RBALBB2: 47k; R2512; MPN PS122WF4702T4E; LCSC C2793932
RBALTA1, RBALTA2: 47k; R2512; MPN PS122WF4702T4E; LCSC C2793932
RBALTB1, RBALTB2: 47k; R2512; MPN PS122WF4702T4E; LCSC C2793932
RBDA0, RBDA1, RBDA2, RBDA3: CER-2k2-10W-AX; RES-TH_L48.0-W8.0-P54.00; MPN CER-2k2-10W-AX; LCSC CLASS
RBDB0, RBDB1, RBDB2, RBDB3: CER-2k2-10W-AX; RES-TH_L48.0-W8.0-P54.00; MPN CER-2k2-10W-AX; LCSC CLASS
RBLRS: 100R; R0805; MPN RC0805FR-07100RL; LCSC C105577
RBLRX: 10k; R0805; MPN RC0805FR-0710KL; LCSC C84376
RBLTS: 100R; R0805; MPN RC0805FR-07100RL; LCSC C105577
RBLTX: 10k; R0805; MPN RC0805FR-0710KL; LCSC C84376
RCGB: 1M; R1206; MPN RC0805FR-071ML; LCSC C107700
RDIG1, RDIG2: 2.2k; R0805; MPN RC0805FR-072K2L; LCSC C114561
RKPUKOUT: 10k; R0805; MPN RC0805FR-0710KL; LCSC C84376
RKPUKPARA: 10k; R0805; MPN RC0805FR-0710KL; LCSC C84376
RKPUKPARB: 10k; R0805; MPN RC0805FR-0710KL; LCSC C84376
RKPUKPREA: 10k; R0805; MPN RC0805FR-0710KL; LCSC C84376
RKPUKPREB: 10k; R0805; MPN RC0805FR-0710KL; LCSC C84376
RKPUKSER: 10k; R0805; MPN RC0805FR-0710KL; LCSC C84376
ROAD0, ROAD1, ROAD2, ROAD3, ROAD4, ROAD5, ROAD6, ROAD7: 475k; R1206; MPN HV732BTTD4753F; LCSC C4121673
ROADL: 6.8k; R0805; MPN ARG05BTC6801; LCSC C3033907
ROBD0, ROBD1, ROBD2, ROBD3, ROBD4, ROBD5, ROBD6, ROBD7: 475k; R1206; MPN HV732BTTD4753F; LCSC C4121673
ROBDL: 6.8k; R0805; MPN ARG05BTC6801; LCSC C3033907
ROVD0, ROVD1, ROVD2, ROVD3, ROVD4, ROVD5, ROVD6, ROVD7: 475k; R1206; MPN HV732BTTD4753F; LCSC C4121673
ROVDL: 6.8k; R0805; MPN ARG05BTC6801; LCSC C3033907
RPDB0, RPDB1, RPDB2, RPDB3, RPDB4, RPDB5, RPDB6, RPDB7, RPDB8: 10k; MPN R0603-10k; LCSC UNMAPPED
RPREA: SQP-10R-25W; RES-TH_L60.0-W9.0-P66.00; MPN SQP-10R-25W; LCSC CLASS
RPREB: SQP-10R-25W; RES-TH_L60.0-W9.0-P66.00; MPN SQP-10R-25W; LCSC CLASS
RPVBA: 1M; R0805; MPN RC0805FR-071ML; LCSC C107700
RPVBB: 1M; R0805; MPN RC0805FR-071ML; LCSC C107700
RPVLA: 330R; R0805; MPN RC0805FR-07330RL; LCSC C110440
RPVLB: 330R; R0805; MPN RC0805FR-07330RL; LCSC C110440
RROLEB: 10k; R0805; MPN RC0805FR-0710KL; LCSC C84376
RSEG0, RSEG1, RSEG2, RSEG3, RSEG4, RSEG5, RSEG6, RSEG7: 220R; R0805; MPN RC0603FR-07220RL; LCSC C107696
RSHO: SHUNT-MANG; SHUNT_4-terminal_manganin; MPN SHUNT-MANG; LCSC C508584
RSW1, RSW2: 10k; R0805; MPN RC0805FR-0710KL; LCSC C84376
RTERM: 120R; R1206; MPN RC1206FR-07120RL; LCSC C114928
RTLLCP: 10k; R0805; MPN RC0805FR-0710KL; LCSC C84376
RTXFRP: 10k; R0805; MPN RC0805FR-0710KL; LCSC C84376
SW1, SW2: TACT-6x6; KEY-SMD_4P-L6.0-W6.0; MPN TACT-6x6; LCSC C318884
T1, T2, T3, T4, T5, T6: XFMR-LLC-10K; XFMR_3xPQ50-50_custom; MPN XFMR-LLC-10K; LCSC CUSTOM
TVSCAN: PESD1CAN; SOT-23-3_L2.9-W1.3-P1.90-LS2.4-BR; MPN PESD1CAN; LCSC C143073
U1H, U1L, U2H, U2L, U3H, U3L, U4H, U4L, U5H, U5L, U6H, U6L: NSI6611; SOIC-16_L10.3-W7.5-P1.27-LS10.3-BL; MPN NSI6611; LCSC C7470934
UCAN: NSI1042; SOIC-16_L10.3-W7.5-P1.27-LS10.3-BL; MPN NSI1042; LCSC C3445856
UIVOA: AMC1311; SOIC-8_L5.9-W7.5-P1.27-LS11.5-BL; MPN AMC1311DWVR; LCSC C456277
UIVOB: AMC1311; SOIC-8_L5.9-W7.5-P1.27-LS11.5-BL; MPN AMC1311DWVR; LCSC C456277
UIVOV: AMC1311; SOIC-8_L5.9-W7.5-P1.27-LS11.5-BL; MPN AMC1311DWVR; LCSC C456277
ULB: ULN2803A; SOIC-18_L11.6-W7.5-P1.27-LS10.3-BL; MPN ULN2803A; LCSC C2865085
UPVA: VOM1271T; SOP-4_L4.4-W4.3-P2.54-LS7.0-BL; MPN VOM1271T; LCSC C146286
UPVB: VOM1271T; SOP-4_L4.4-W4.3-P2.54-LS7.0-BL; MPN VOM1271T; LCSC C146286
USHO: NSI1200-DSWR; SOIC-8_L5.9-W7.5-P1.27-LS11.5-BL; MPN NSI1200-DSWR; LCSC C3029747
USR1: 74HC595; SOIC-16_L9.9-W3.9-P1.27-LS6.0-BL; MPN 74HC595; LCSC C19192516

Notes on the sheet:
SHEET INDEX
60 kW DC-DC (upper) - 2 of 3
LLC-LEGS - 7 sections
LLC-TANKS - 6 sections
OUTPUT-SENSING - 6 sections
BANKS-SP - 4 sections
CONTROL - 3 sections
COMMS-HMI - 2 sections
rev D.3 - 28 sections - 425 components
NET NAMING
internal junctions are named for what they join
U<ref>_<PIN> node at that IC pin e.g. UIVOA_VINP
R<stem>_M midpoint of a series pair e.g. RBALTA_M
R<stem>_<nm> tap between R<stem>n/m e.g. RV1D_01
all others are explicit design nets
BANKS-SP / BANK-A
BANKS-SP / BANK-B
BANKS-SP / SP-MATRIX
BANKS-SP / BLEEDERS
COMMS-HMI / CAN
COMMS-HMI / HMI
CONTROL / CARD-IF
CONTROL / COIL-DRIVER
CONTROL / INTERCONNECT
LLC-LEGS / BUS-IN
LLC-LEGS / LEG-1
LLC-LEGS / LEG-2
LLC-LEGS / LEG-3
LLC-LEGS / LEG-4
LLC-LEGS / LEG-5
LLC-LEGS / LEG-6
LLC-TANKS / TANK-1
LLC-TANKS / TANK-2
LLC-TANKS / TANK-3
LLC-TANKS / TANK-4
LLC-TANKS / TANK-5
LLC-TANKS / TANK-6
OUTPUT-SENSING / OUTPUT
OUTPUT-SENSING / SENSE-VBKA
OUTPUT-SENSING / SENSE-VBKB
OUTPUT-SENSING / SENSE-VOUT
OUTPUT-SENSING / ISO-BIAS
OUTPUT-SENSING / NTC
