vectivolt/DC-Modules/kicad5/dc-modules-120kw/120kw-acdc.sch

## KiCad design kicad5/dc-modules-120kw/120kw-acdc.sch (2026-09-06)

Schematic: 120kw-acdc.sch

Parts:
CA0C, CA1C, CA2C, CA3C: 100nF; CAP-TH_L7.2-W3.5-P5.00; MPN FILM-100n-250; LCSC CLASS
CA0F, CA1F, CA2F, CA3F: 1nF; C0805; MPN CC0603KRX7R9BB102; LCSC C100040
CA0FN, CA0FP, CA1FN, CA1FP, CA2FN, CA2FP, CA3FN, CA3FP: 1uF; CAP-TH_L26.5-W11.0-P22.50; MPN PP-1u-600; LCSC CLASS
CA0GB1, CA0GB2, CA1GB1, CA1GB2, CA2GB1, CA2GB2, CA3GB1, CA3GB2: 1uF; C0805; MPN CL21B105KBFNNNE; LCSC C28323
CA0GBL, CA1GBL, CA2GBL, CA3GBL: 100pF; C0805; MPN CC0603JRNPO9BN101; LCSC C14665
CA0SN, CA1SN, CA2SN, CA3SN: 100pF; C1812; MPN CC1812JKNPODBN101; LCSC C577319
CAUX15, CAUX24: 220uF; CAP-TH_L8.0-W8.0-P3.50; MPN GR227M035F12RR0VL4FP0; LCSC C45078
CAVF: 2.2nF; C0805; MPN CC0805KRX7R9BB222; LCSC C107146
CAVM: 100nF; C0805; MPN CC0603KRX7R9BB104; LCSC C14663
CAVO: 10uF; C0805; MPN CL21A106KAYNNNE; LCSC C15850
CB0C, CB1C, CB2C, CB3C: 100nF; CAP-TH_L7.2-W3.5-P5.00; MPN FILM-100n-250; LCSC CLASS
CB0F, CB1F, CB2F, CB3F: 1nF; C0805; MPN CC0603KRX7R9BB102; LCSC C100040
CB0FN, CB0FP, CB1FN, CB1FP, CB2FN, CB2FP, CB3FN, CB3FP: 1uF; CAP-TH_L26.5-W11.0-P22.50; MPN PP-1u-600; LCSC CLASS
CB0GB1, CB0GB2, CB1GB1, CB1GB2, CB2GB1, CB2GB2, CB3GB1, CB3GB2: 1uF; C0805; MPN CL21B105KBFNNNE; LCSC C28323
CB0GBL, CB1GBL, CB2GBL, CB3GBL: 100pF; C0805; MPN CC0603JRNPO9BN101; LCSC C14665
CB0SN, CB1SN, CB2SN, CB3SN: 100pF; C1812; MPN CC1812JKNPODBN101; LCSC C577319
CBKIA: 10uF; C0805; MPN CL21A106KAYNNNE; LCSC C15850
CBKOA: 22uF; C0805; MPN GRM21BR61C226ME44L; LCSC C86817
CBMDF: 1nF; C0805; MPN CC0603KRX7R9BB102; LCSC C100040
CBPDF: 1nF; C0805; MPN CC0603KRX7R9BB102; LCSC C100040
CBSTA: 100nF; C0805; MPN CC0603KRX7R9BB104; LCSC C14663
CC0C, CC1C, CC2C, CC3C: 100nF; CAP-TH_L7.2-W3.5-P5.00; MPN FILM-100n-250; LCSC CLASS
CC0F, CC1F, CC2F, CC3F: 1nF; C0805; MPN CC0603KRX7R9BB102; LCSC C100040
CC0FN, CC0FP, CC1FN, CC1FP, CC2FN, CC2FP, CC3FN, CC3FP: 1uF; CAP-TH_L26.5-W11.0-P22.50; MPN PP-1u-600; LCSC CLASS
CC0GB1, CC0GB2, CC1GB1, CC1GB2, CC2GB1, CC2GB2, CC3GB1, CC3GB2: 1uF; C0805; MPN CL21B105KBFNNNE; LCSC C28323
CC0GBL, CC1GBL, CC2GBL, CC3GBL: 100pF; C0805; MPN CC0603JRNPO9BN101; LCSC C14665
CC0SN, CC1SN, CC2SN, CC3SN: 100pF; C1812; MPN CC1812JKNPODBN101; LCSC C577319
CCLA: 10nF; CAP-TH_L18.0-W5.0-P15.00; MPN PP-10n-1200; LCSC CLASS
CCOMP: 100nF; C0805; MPN CC0603KRX7R9BB104; LCSC C14663
CCSF: 470pF; C0805; MPN CC0805KRX7R9BB471; LCSC C107152
CDB00, CDB01, CDB02, CDB03, CDB04, CDB05, CDB10, CDB11, CDB12, CDB13, CDB14, CDB15, CDB20, CDB21, CDB22, CDB23, CDB24, CDB25: 470uF; CAP-TH_L30.0-W30.0-P10.00; MPN ELH-470u450; LCSC CLASS
CDT00, CDT01, CDT02, CDT03, CDT04, CDT05, CDT10, CDT11, CDT12, CDT13, CDT14, CDT15, CDT20, CDT21, CDT22, CDT23, CDT24, CDT25: 470uF; CAP-TH_L30.0-W30.0-P10.00; MPN ELH-470u450; LCSC CLASS
CFLTA: 1nF; C0805; MPN CC0603KRX7R9BB102; LCSC C100040
CMC1, CMC2: CMC-3PH-2mH-SKU; L_CMC_3ph_nanocryst_per-SKU; MPN CMC-3PH-2mH-SKU; LCSC CUSTOM
CPET: 4.7nF; CAP-TH_L11.0-W5.0-P10.00; MPN VY1472M63Y5UQ63V0; LCSC C499492
CPFCA1: 1uF; C0805; MPN CL21B105KBFNNNE; LCSC C28323
CPFCA2: 100nF; C0402; MPN CC0603KRX7R9BB104; LCSC C14663
CPFCD0, CPFCD1, CPFCD2, CPFCD3: 100nF; C0402; MPN CC0402KRX7R7BB104; LCSC C60474
CPFCRST: 100nF; C0805; MPN CC0603KRX7R9BB104; LCSC C14663
CRSTA: 1nF; C0805; MPN CC0603KRX7R9BB102; LCSC C100040
CSFA: 100nF; C0805; MPN CC0603KRX7R9BB104; LCSC C14663
CTA0, CTA1, CTA2, CTA3: CT-100A-1:2500; CT_window_100A_1-2500; MPN CT-100A-1:2500; LCSC C94571
CTB0, CTB1, CTB2, CTB3: CT-100A-1:2500; CT_window_100A_1-2500; MPN CT-100A-1:2500; LCSC C94571
CTC0, CTC1, CTC2, CTC3: CT-100A-1:2500; CT_window_100A_1-2500; MPN CT-100A-1:2500; LCSC C94571
CTINLF: 100nF; C0805; MPN CC0603KRX7R9BB104; LCSC C14663
CTPFCF: 100nF; C0805; MPN CC0603KRX7R9BB104; LCSC C14663
CV1DF, CV2DF, CV3DF: 10nF; C0805; MPN CC0603KRX7R9BB103; LCSC C100042
CVCC: 47uF; CAP-TH_L6.3-W6.3-P2.50; MPN KS476M035E07RR0VH2FP0; LCSC C13654
CWDA: 1nF; C0805; MPN CC0603KRX7R9BB102; LCSC C100040
CX11, CX12, CX13, CX21, CX22, CX23: 2.2uF; CAP-TH_L26.5-W11.0-P22.50; MPN X1-2u2-530; LCSC CLASS
CY1, CY2, CY3: 4.7nF; CAP-TH_L11.0-W5.0-P10.00; MPN VY1472M63Y5UQ63V0; LCSC C499492
DA0B, DA0T, DA1B, DA1T, DA2B, DA2T, DA3B, DA3T: SICJBS-1200-40; TO-247-3_L15.9-W5.0-P5.44-L; MPN GC4D20120D; LCSC C7435099
DA0C, DA1C, DA2C, DA3C: SICJBS-1200-10; TO-247-3_L15.9-W5.0-P5.44-L; MPN GC4D10120H; LCSC C7435087
DA0GS1, DA0GS2, DA1GS1, DA1GS2, DA2GS1, DA2GS2, DA3GS1, DA3GS2: US1M; SMA_L4.4-W2.8-LS5.4-RD; MPN US1M; LCSC C412437
DA0N, DA0P, DA1N, DA1P, DA2N, DA2P, DA3N, DA3P: 1N4148WS; SOD-323_L1.8-W1.3-LS2.5-RD; MPN 1N4148WS; LCSC C2128
DAUX15: US2G; SMB_L4.5-W3.6-LS5.3-RD; MPN US2G; LCSC C49263
DAUX24: UF-400V-3A; SMC_L8.0-W5.9-LS9.0-RD; MPN US3M; LCSC C3039981
DAUXVC: US2G; SMB_L4.5-W3.6-LS5.3-RD; MPN US2G; LCSC C49263
DB0B, DB0T, DB1B, DB1T, DB2B, DB2T, DB3B, DB3T: SICJBS-1200-40; TO-247-3_L15.9-W5.0-P5.44-L; MPN GC4D20120D; LCSC C7435099
DB0C, DB1C, DB2C, DB3C: SICJBS-1200-10; TO-247-3_L15.9-W5.0-P5.44-L; MPN GC4D10120H; LCSC C7435087
DB0GS1, DB0GS2, DB1GS1, DB1GS2, DB2GS1, DB2GS2, DB3GS1, DB3GS2: US1M; SMA_L4.4-W2.8-LS5.4-RD; MPN US1M; LCSC C412437
DB0N, DB0P, DB1N, DB1P, DB2N, DB2P, DB3N, DB3P: 1N4148WS; SOD-323_L1.8-W1.3-LS2.5-RD; MPN 1N4148WS; LCSC C2128
DC0B, DC0T, DC1B, DC1T, DC2B, DC2T, DC3B, DC3T: SICJBS-1200-40; TO-247-3_L15.9-W5.0-P5.44-L; MPN GC4D20120D; LCSC C7435099
DC0C, DC1C, DC2C, DC3C: SICJBS-1200-10; TO-247-3_L15.9-W5.0-P5.44-L; MPN GC4D10120H; LCSC C7435087
DC0GS1, DC0GS2, DC1GS1, DC1GS2, DC2GS1, DC2GS2, DC3GS1, DC3GS2: US1M; SMA_L4.4-W2.8-LS5.4-RD; MPN US1M; LCSC C412437
DC0N, DC0P, DC1N, DC1P, DC2N, DC2P, DC3N, DC3P: 1N4148WS; SOD-323_L1.8-W1.3-LS2.5-RD; MPN 1N4148WS; LCSC C2128
DCLA: FAST-1200-1A; SMB_L4.5-W3.6-LS5.3-RD; MPN STTH112U; LCSC C56792
DTVS15: SMBJ16A; SMB_L4.5-W3.6-LS5.3-RD; MPN SMBJ16A; LCSC C151859
DTVS24: SMBJ26A; SMB_L4.5-W3.6-LS5.3-RD; MPN SMBJ26A; LCSC C127562
F1, F2, F3: FUSE-gG-690V-250A; FUSE_holder_NH01; MPN FUSE-gG-690V-250A; LCSC CLASS
FBPFCA: 0R; L0805; MPN GZ2012D601TF; LCSC C1017
GDT1, GDT2, GDT3: GDT-3k5-20kA; GDT-8mm_RM6; MPN GDT-3k5-20kA; LCSC C9900081756
JACL1, JACL2, JACL3: STUD-M8; TERM_Stud_M8; MPN STUD-M8; LCSC CLASS
JDCN: STUD-M8; TERM_Stud_M8; MPN STUD-M8; LCSC CLASS
JDCP: STUD-M8; TERM_Stud_M8; MPN STUD-M8; LCSC CLASS
JFAN1, JFAN2, JFAN3, JFAN4: PH-4-FAN; CONN-TH_4P-P2.00_PH; MPN B4B-PH-K-S; LCSC C131334
JICA: MICROFIT3-16; CONN-TH_16P-P3.00_MicroFit; MPN MICROFIT3-16; LCSC C277731
JPE: STUD-M8; TERM_Stud_M8; MPN STUD-M8; LCSC CLASS
JPEB: STUD-M8; TERM_Stud_M8; MPN STUD-M8; LCSC CLASS
JSWDPFC: HDR-1x5-2.54; HDR-TH_5P-P2.54-V-M; MPN PZ254V-11-05P; LCSC C492404
JTINL: PH-2; CONN-TH_2P-P2.00_PH; MPN B2B-PH-K-S; LCSC C20504437
JTPFC: PH-2; CONN-TH_2P-P2.00_PH; MPN B2B-PH-K-S; LCSC C20504437
KPRE1, KPRE2: HF167F-250A-M; RELAY_contactor_250A_stud; MPN HF167F-250A-M; LCSC REVIEW
LA0, LA1, LA2, LA3: IND-PFC-165u; L_Toroid_3xT79_26u_custom; MPN IND-PFC-165u; LCSC CLASS
LB0, LB1, LB2, LB3: IND-PFC-165u; L_Toroid_3xT79_26u_custom; MPN IND-PFC-165u; LCSC CLASS
LBKA: IND-10u-3A; IND-SMD_L6.0-W6.0; MPN CYA0630-10UH; LCSC C5189958
LC0, LC1, LC2, LC3: IND-PFC-165u; L_Toroid_3xT79_26u_custom; MPN IND-PFC-165u; LCSC CLASS
LDM1, LDM2, LDM3: DM-22u-SKU; L_Toroid_sendust_per-SKU; MPN DM-22u-SKU; LCSC CLASS
MOV1, MOV2, MOV3: S20K550; DISC-20mm_RM10; MPN S20K550; LCSC C317868
MOVP1, MOVP2, MOVP3: S20K550; DISC-20mm_RM10; MPN S20K550; LCSC C317868
PS5AC, PS5BUS: ISO5V-RFC-6K; MPN ISO5V-RFC-6K; LCSC C20613048
PSA0G, PSA1G, PSA2G, PSA3G: QA01C; PWRM-TH_QA01C; MPN QA01C; LCSC C2757491
PSB0G, PSB1G, PSB2G, PSB3G: QA01C; PWRM-TH_QA01C; MPN QA01C; LCSC C2757491
PSC0G, PSC1G, PSC2G, PSC3G: QA01C; PWRM-TH_QA01C; MPN QA01C; LCSC C2757491
PSQD: QA01C; PWRM-TH_QA01C; MPN QA01C; LCSC C2757491
QA0A, QA0B, QA1A, QA1B, QA2A, QA2B, QA3A, QA3B: B3M010C075Z; TO-247-4_L15.8-W5.0-P2.54-L; MPN B3M010C075Z; LCSC C5713521
QAUX: SIC-1700-1R; TO-247-3_L15.9-W5.0-P5.44-L; MPN C2M1000170D; LCSC C5713500
QB0A, QB0B, QB1A, QB1B, QB2A, QB2B, QB3A, QB3B: B3M010C075Z; TO-247-4_L15.8-W5.0-P2.54-L; MPN B3M010C075Z; LCSC C5713521
QC0A, QC0B, QC1A, QC1B, QC2A, QC2B, QC3A, QC3B: B3M010C075Z; TO-247-4_L15.8-W5.0-P2.54-L; MPN B3M010C075Z; LCSC C5713521
QDIS: TAB-M4; TERM_Tab_M4; MPN TAB-M4; LCSC CLASS
QDISF: SIC-1200-5A; TO-247-3_L15.9-W5.0-P5.44-L; MPN IMW120R350M1H; LCSC C536285
RA0B, RA1B, RA2B, RA3B: 33R; R1206; MPN RC1206FR-0733RL; LCSC C137308
RA0C, RA1C, RA2C, RA3C: WW-470R-10W; RES-TH_L48.0-W8.0-P54.00; MPN WW-470R-10W; LCSC CLASS
RA0F, RA1F, RA2F, RA3F: 1k; R0805; MPN RC0805FR-071KL; LCSC C95781
RA0GGS, RA0GPD, RA1GGS, RA1GPD, RA2GGS, RA2GPD, RA3GGS, RA3GPD: 10k; R0805; MPN RC0805FR-0710KL; LCSC C84376
RA0GOFF, RA0GON, RA1GOFF, RA1GON, RA2GOFF, RA2GON, RA3GOFF, RA3GON: 4.7R; R1206; MPN RC1206FR-7W4R7L; LCSC C859161
RA0SN, RA1SN, RA2SN, RA3SN: 10R; R2512; MPN CRM2512-FX-10R0ELF; LCSC C840605
RAGTA: 0R; R0805; MPN RC0805JR-070RL; LCSC C96345
RALRS: 100R; R0805; MPN RC0805FR-07100RL; LCSC C105577
RALRX: 10k; R0805; MPN RC0805FR-0710KL; LCSC C84376
RALTS: 100R; R0805; MPN RC0805FR-07100RL; LCSC C105577
RALTX: 10k; R0805; MPN RC0805FR-0710KL; LCSC C84376
RAUXCS: 310m; R1206; MPN PT1206FR-7W0R31L; LCSC C6148847
RAUXG: 100k; R0805; MPN RC0805FR-07100KL; LCSC C96346
RAUXRT: 100k; R0805; MPN RC0805FR-07100KL; LCSC C96346
RAUXST1, RAUXST2: 470k; R2512; MPN R2512-HV; LCSC CLASS
RAVF: 10k; R0805; MPN RC0805FR-0710KL; LCSC C84376
RAVH: 10k; R0805; MPN RC0805FR-0710KL; LCSC C84376
RAVI: 4.7R; R0805; MPN RC0805FR-074R7L; LCSC C137513
RAVL: 10k; R0805; MPN RC0805FR-0710KL; LCSC C84376
RB0B, RB1B, RB2B, RB3B: 33R; R1206; MPN RC1206FR-0733RL; LCSC C137308
RB0C, RB1C, RB2C, RB3C: WW-470R-10W; RES-TH_L48.0-W8.0-P54.00; MPN WW-470R-10W; LCSC CLASS
RB0F, RB1F, RB2F, RB3F: 1k; R0805; MPN RC0805FR-071KL; LCSC C95781
RB0GGS, RB0GPD, RB1GGS, RB1GPD, RB2GGS, RB2GPD, RB3GGS, RB3GPD: 10k; R0805; MPN RC0805FR-0710KL; LCSC C84376
RB0GOFF, RB0GON, RB1GOFF, RB1GON, RB2GOFF, RB2GON, RB3GOFF, RB3GON: 4.7R; R1206; MPN RC1206FR-7W4R7L; LCSC C859161
RB0SN, RB1SN, RB2SN, RB3SN: 10R; R2512; MPN CRM2512-FX-10R0ELF; LCSC C840605
RBALB0A, RBALB0B, RBALB1A, RBALB1B, RBALB2A, RBALB2B: 47k; R2512; MPN PS122WF4702T4E; LCSC C2793932
RBALT0A, RBALT0B, RBALT1A, RBALT1B, RBALT2A, RBALT2B: 47k; R2512; MPN PS122WF4702T4E; LCSC C2793932
RBKF1A: 45.3k; R0805; MPN RC0805FR-0745K3L; LCSC C273885
RBKF2A: 10k; R0805; MPN RC0805FR-0710KL; LCSC C84376
RBMD0, RBMD1, RBMD2, RBMD3, RBMD4, RBMD5, RBMD6, RBMD7: 475k; R1206; MPN HV732BTTD4753F; LCSC C4121673
RBMDL: 6.8k; R0805; MPN ARG05BTC6801; LCSC C3033907
RBPD0, RBPD1, RBPD2, RBPD3, RBPD4, RBPD5, RBPD6, RBPD7: 475k; R1206; MPN HV732BTTD4753F; LCSC C4121673
RBPDL: 6.8k; R0805; MPN ARG05BTC6801; LCSC C3033907
RBR1A, RBR1B: 2.4M; R2512; MPN R2512-HV; LCSC CLASS
RBR2: 15k; R0805; MPN RC0805FR-0715KL; LCSC C114559
RC0B, RC1B, RC2B, RC3B: 33R; R1206; MPN RC1206FR-0733RL; LCSC C137308
RC0C, RC1C, RC2C, RC3C: WW-470R-10W; RES-TH_L48.0-W8.0-P54.00; MPN WW-470R-10W; LCSC CLASS
RC0F, RC1F, RC2F, RC3F: 1k; R0805; MPN RC0805FR-071KL; LCSC C95781
RC0GGS, RC0GPD, RC1GGS, RC1GPD, RC2GGS, RC2GPD, RC3GGS, RC3GPD: 10k; R0805; MPN RC0805FR-0710KL; LCSC C84376
RC0GOFF, RC0GON, RC1GOFF, RC1GON, RC2GOFF, RC2GON, RC3GOFF, RC3GON: 4.7R; R1206; MPN RC1206FR-7W4R7L; LCSC C859161
RC0SN, RC1SN, RC2SN, RC3SN: 10R; R2512; MPN CRM2512-FX-10R0ELF; LCSC C840605
RCLA1, RCLA2: 47k; R2512; MPN R2512-HV; LCSC CLASS
RCOMP: 10k; R0805; MPN RC0805FR-0710KL; LCSC C84376
RCSF: 1k; R0805; MPN RC0805FR-071KL; LCSC C95781
RDIS0, RDIS1, RDIS2, RDIS3: CER-50W-AX; RES-TH_L75.0-W12.0-P82.00; MPN CER-50W-AX; LCSC CLASS
RENLA: 100k; R0805; MPN RC0805FR-07100KL; LCSC C96346
RENRA: 100k; R0805; MPN RC0805FR-07100KL; LCSC C96346
RFB1: 118k; R0805; MPN RC0805FR-07118KL; LCSC C274001
RFB2: 10k; R0805; MPN RC0805FR-0710KL; LCSC C84376
RFLTA: 4.7k; R0805; MPN RC0805FR-074K7L; LCSC C60816
RFT1, RFT2, RFT3, RFT4: 10k; R0805; MPN RC0805FR-0710KL; LCSC C84376
RGPDA: 10k; R0805; MPN RC0805FR-0710KL; LCSC C84376
RKFBP: 10k; R0805; MPN RC0805FR-0710KL; LCSC C84376
RM15A: 47k; R0805; MPN RC0805FR-0747KL; LCSC C126351
RM15B, RM24B: 10k; R0805; MPN RC0805FR-0710KL; LCSC C84376
RM24A: 68k; R0805; MPN RC0805FR-0768KL; LCSC C114548
RNS1A, RNS1B, RNS2A, RNS2B, RNS3A, RNS3B: 47k; R2512; MPN PS122WF4702T4E; LCSC C2793932
RPET: 1M; R1206; MPN RC0805FR-071ML; LCSC C107700
RPFCBOOT: 10k; R0805; MPN RC0805FR-0710KL; LCSC C84376
RPFCRST: 10k; R0402; MPN RC0805FR-0710KL; LCSC C84376
RPRE1, RPRE2: CER-50W-AX; RES-TH_L75.0-W12.0-P82.00; MPN CER-50W-AX; LCSC CLASS
RQDG: 100R; R0805; MPN RC0805FR-07100RL; LCSC C105577
RQDL: 330R; R0805; MPN RC0805FR-07330RL; LCSC C110440
RQDPD: 10k; R0805; MPN RC0805FR-0710KL; LCSC C84376
RRDYA: 10k; R0805; MPN RC0805FR-0710KL; LCSC C84376
RTINLP: 10k; R0805; MPN RC0805FR-0710KL; LCSC C84376
RTPFCP: 10k; R0805; MPN RC0805FR-0710KL; LCSC C84376
RV1D0, RV1D1, RV1D2, RV1D3, RV1D4, RV1D5, RV1D6, RV1D7, RV2D0, RV2D1, RV2D2, RV2D3, RV2D4, RV2D5, RV2D6, RV2D7, RV3D0, RV3D1, RV3D2, RV3D3, RV3D4, RV3D5, RV3D6, RV3D7: 475k; R1206; MPN HV732BTTD4753F; LCSC C4121673
RV1DL, RV2DL, RV3DL: 11.5k; R0805; MPN RT0805BRD0711K5L; LCSC C865153
RWPUA: 10k; R0805; MPN RC0805FR-0710KL; LCSC C84376
TAUX: XFMR-AUX-FLY-C; XFMR_ETD34_custom; MPN XFMR-AUX-FLY-C; LCSC CUSTOM
UA0G, UA1G, UA2G, UA3G: NSI6611; SOIC-16_L10.3-W7.5-P1.27-LS10.3-BL; MPN NSI6611; LCSC C7470934
UANDA: 74HC11; SOIC-14_L8.7-W3.9-P1.27-LS6.0-BL; MPN 74HC11; LCSC C5524384
UAUX: NCP1252A; SOIC-8_L4.9-W3.9-P1.27-LS6.0-BL; MPN NCP1252A; LCSC C80800
UAVB: TLV9061; SOT-23-5_L3.0-W1.7-P0.95-LS2.8-BL; MPN TLV9061IDBVR; LCSC C398358
UB0G, UB1G, UB2G, UB3G: NSI6611; SOIC-16_L10.3-W7.5-P1.27-LS10.3-BL; MPN NSI6611; LCSC C7470934
UBKA: TPS54202; SOT-23-6_L2.9-W1.6-P0.95-LS2.8-BL; MPN TPS54202DDCR; LCSC C191884
UC0G, UC1G, UC2G, UC3G: NSI6611; SOIC-16_L10.3-W7.5-P1.27-LS10.3-BL; MPN NSI6611; LCSC C7470934
UIVBM: AMC1311; SOIC-8_L5.9-W7.5-P1.27-LS11.5-BL; MPN AMC1311DWVR; LCSC C456277
UIVBP: AMC1311; SOIC-8_L5.9-W7.5-P1.27-LS11.5-BL; MPN AMC1311DWVR; LCSC C456277
UIVV1, UIVV2, UIVV3: AMC1350; SOIC-8_L5.9-W7.5-P1.27-LS11.5-BL; MPN AMC1350QDWVRQ1; LCSC C5214206
UPA: ULN2803A; SOIC-18_L11.6-W7.5-P1.27-LS10.3-BL; MPN ULN2803A; LCSC C2865085
UPFC: GD32G553VET6; LQFP-100_L14.0-W14.0-P0.50-LS16.0-BL; MPN GD32G553VET6; LCSC C9900185865
UQD: TLP152; SOP-6_L7.0-W4.4-P1.27-LS7.6-BL; MPN TLP152; LCSC C17255258
USUPA: TPS3430; VSON-10_L3.0-W3.0-P0.50-TL-EP; MPN TPS3430WDRCR; LCSC C2870545

Notes on the sheet:
SHEET INDEX
120 kW AC-DC (lower) - 1 of 2
AC-SENSING - 13 sections
VIENNA-PFC - 12 sections
CONTROL - 6 sections
AUX-POWER - 5 sections
DC-LINK - 5 sections
INPUT-EMI - 4 sections
rev D.3 - 45 sections - 603 components
NET NAMING
internal junctions are named for what they join
U<ref>_<PIN> node at that IC pin e.g. UIVOA_VINP
R<stem>_M midpoint of a series pair e.g. RBALTA_M
R<stem>_<nm> tap between R<stem>n/m e.g. RV1D_01
all others are explicit design nets
AC-SENSING / STAR
AC-SENSING / SENSE-VAC1
AC-SENSING / SENSE-VAC2
AC-SENSING / SENSE-VAC3
AC-SENSING / SENSE-VBUS
AC-SENSING / SENSE-VMID
AC-SENSING / ISO-BIAS
AC-SENSING / ANALOG-MID
AC-SENSING / NTC
AC-SENSING / LINE-CTS-0
AC-SENSING / LINE-CTS-1
AC-SENSING / LINE-CTS-2
AC-SENSING / LINE-CTS-3
AUX-POWER / FLYBACK
AUX-POWER / RAILS
AUX-POWER / BUCK-3V3
AUX-POWER / FANS
AUX-POWER / INTERCONNECT
CONTROL / MCU
CONTROL / SWD
CONTROL / SAFETY
CONTROL / GROUNDING
CONTROL / COIL-DRIVER
CONTROL / RAIL-MON
DC-LINK / DISCHARGE
DC-LINK / BUS-STUDS
DC-LINK / LINK-BANK-0
DC-LINK / LINK-BANK-1
DC-LINK / LINK-BANK-2
INPUT-EMI / AC-ENTRY
INPUT-EMI / SURGE
INPUT-EMI / EMI-FILTER
INPUT-EMI / PRECHARGE
VIENNA-PFC / PHASE-A0
VIENNA-PFC / PHASE-B0
VIENNA-PFC / PHASE-C0
VIENNA-PFC / PHASE-A1
VIENNA-PFC / PHASE-B1
VIENNA-PFC / PHASE-C1
VIENNA-PFC / PHASE-A2
VIENNA-PFC / PHASE-B2
VIENNA-PFC / PHASE-C2
VIENNA-PFC / PHASE-A3
VIENNA-PFC / PHASE-B3
VIENNA-PFC / PHASE-C3
