vectivolt/DC-Modules/kicad5/dc-modules-120kw/120kw-dcdc.sch

## KiCad design kicad5/dc-modules-120kw/120kw-dcdc.sch (2026-09-06)

Schematic: 120kw-dcdc.sch

Parts:
C1CF, C2CF, C3CF, C4CF, C5CF, C6CF, C7CF, C8CF, C9CF, C10CF, C11CF, C12CF: 220pF; C0805; MPN CC0603JRNPO9BN221; LCSC C106210
C1HB1, C1HB2, C1LB1, C1LB2, C2HB1, C2HB2, C2LB1, C2LB2, C3HB1, C3HB2, C3LB1, C3LB2, C4HB1, C4HB2, C4LB1, C4LB2, C5HB1, C5HB2, C5LB1, C5LB2, C6HB1, C6HB2, C6LB1, C6LB2, C7HB1, C7HB2, C7LB1, C7LB2, C8HB1, C8HB2, C8LB1, C8LB2, C9HB1, C9HB2, C9LB1, C9LB2, C10HB1, C10HB2, C10LB1, C10LB2, C11HB1, C11HB2, C11LB1, C11LB2, C12HB1, C12HB2, C12LB1, C12LB2: 1uF; C0805; MPN CL21B105KBFNNNE; LCSC C28323
C1HBL, C1LBL, C2HBL, C2LBL, C3HBL, C3LBL, C4HBL, C4LBL, C5HBL, C5LBL, C6HBL, C6LBL, C7HBL, C7LBL, C8HBL, C8LBL, C9HBL, C9LBL, C10HBL, C10LBL, C11HBL, C11LBL, C12HBL, C12LBL: 100pF; C0805; MPN CC0603JRNPO9BN101; LCSC C14665
C1R0, C1R1, C1R2, C1R3, C2R0, C2R1, C2R2, C2R3, C3R0, C3R1, C3R2, C3R3, C4R0, C4R1, C4R2, C4R3, C5R0, C5R1, C5R2, C5R3, C6R0, C6R1, C6R2, C6R3, C7R0, C7R1, C7R2, C7R3, C8R0, C8R1, C8R2, C8R3, C9R0, C9R1, C9R2, C9R3, C10R0, C10R1, C10R2, C10R3, C11R0, C11R1, C11R2, C11R3, C12R0, C12R1, C12R2, C12R3: 46nF; CAP-TH_L31.5-W13.0-P27.50; MPN PP-46n-1200; LCSC CLASS
CAVF: 2.2nF; C0805; MPN CC0805KRX7R9BB222; LCSC C107146
CAVM: 100nF; C0805; MPN CC0603KRX7R9BB104; LCSC C14663
CAVO: 10uF; C0805; MPN CL21A106KAYNNNE; LCSC C15850
CBA0B, CBA0T, CBA1B, CBA1T, CBA2B, CBA2T, CBA3B, CBA3T, CBA4B, CBA4T, CBA5B, CBA5T, CBA6B, CBA6T, CBA7B, CBA7T: 470uF; CAP-TH_L30.0-W30.0-P10.00; MPN ELH-470u450; LCSC CLASS
CBAF: 1uF; CAP-TH_L31.5-W13.0-P27.50; MPN PP-1u-1100; LCSC CLASS
CBB0B, CBB0T, CBB1B, CBB1T, CBB2B, CBB2T, CBB3B, CBB3T, CBB4B, CBB4T, CBB5B, CBB5T, CBB6B, CBB6T, CBB7B, CBB7T: 470uF; CAP-TH_L30.0-W30.0-P10.00; MPN ELH-470u450; LCSC CLASS
CBBF: 1uF; CAP-TH_L31.5-W13.0-P27.50; MPN PP-1u-1100; LCSC CLASS
CBKIB: 10uF; C0805; MPN CL21A106KAYNNNE; LCSC C15850
CBKOB: 22uF; C0805; MPN GRM21BR61C226ME44L; LCSC C86817
CBSTB: 100nF; C0805; MPN CC0603KRX7R9BB104; LCSC C14663
CCGB: 4.7nF; C1206; MPN CC1206KRX7R9BB472; LCSC C107208
CF0, CF1, CF2, CF3, CF4, CF5, CF6, CF7, CF8, CF9, CF10, CF11: 1uF; CAP-TH_L31.5-W13.0-P27.50; MPN PP-1u-1100; LCSC CLASS
CFLTB: 1nF; C0805; MPN CC0603KRX7R9BB102; LCSC C100040
CLLCA1: 1uF; C0805; MPN CL21B105KBFNNNE; LCSC C28323
CLLCA2: 100nF; C0402; MPN CC0603KRX7R9BB104; LCSC C14663
CLLCD0, CLLCD1, CLLCD2, CLLCD3: 100nF; C0402; MPN CC0402KRX7R7BB104; LCSC C60474
CLLCRST: 100nF; C0805; MPN CC0603KRX7R9BB104; LCSC C14663
COADF: 1nF; C0805; MPN CC0603KRX7R9BB102; LCSC C100040
COBDF: 1nF; C0805; MPN CC0603KRX7R9BB102; LCSC C100040
COF1, COF2: 4.7uF; CAP-TH_L41.5-W20.0-P37.50; MPN PP-4u7-1200; LCSC CLASS
COVDF: 1nF; C0805; MPN CC0603KRX7R9BB102; LCSC C100040
CRSTB: 1nF; C0805; MPN CC0603KRX7R9BB102; LCSC C100040
CSFB: 100nF; C0805; MPN CC0603KRX7R9BB104; LCSC C14663
CSW1, CSW2: 100nF; C0805; MPN CC0603KRX7R9BB104; LCSC C14663
CT1, CT2, CT3, CT4, CT5, CT6, CT7, CT8, CT9, CT10, CT11, CT12: CT-RES-1:100; CT_window_res_1-100; MPN CT-RES-1:100; LCSC C94571
CTLLCF: 100nF; C0805; MPN CC0603KRX7R9BB104; LCSC C14663
CTXFRF: 100nF; C0805; MPN CC0603KRX7R9BB104; LCSC C14663
CWDB: 1nF; C0805; MPN CC0603KRX7R9BB102; LCSC C100040
CYO1, CYO2: 4.7nF; CAP-TH_L11.0-W5.0-P10.00; MPN VY1472M63Y5UQ63V0; LCSC C499492
D1A1, D1A2, D1A3, D1A4, D1B1, D1B2, D1B3, D1B4, D2A1, D2A2, D2A3, D2A4, D2B1, D2B2, D2B3, D2B4, D3A1, D3A2, D3A3, D3A4, D3B1, D3B2, D3B3, D3B4, D4A1, D4A2, D4A3, D4A4, D4B1, D4B2, D4B3, D4B4, D5A1, D5A2, D5A3, D5A4, D5B1, D5B2, D5B3, D5B4, D6A1, D6A2, D6A3, D6A4, D6B1, D6B2, D6B3, D6B4, D7A1, D7A2, D7A3, D7A4, D7B1, D7B2, D7B3, D7B4, D8A1, D8A2, D8A3, D8A4, D8B1, D8B2, D8B3, D8B4, D9A1, D9A2, D9A3, D9A4, D9B1, D9B2, D9B3, D9B4, D10A1, D10A2, D10A3, D10A4, D10B1, D10B2, D10B3, D10B4, D11A1, D11A2, D11A3, D11A4, D11B1, D11B2, D11B3, D11B4, D12A1, D12A2, D12A3, D12A4, D12B1, D12B2, D12B3, D12B4: SICJBS-1200-20; TO-247-3_L15.9-W5.0-P5.44-L; MPN C4D20120D; LCSC C5713501
D1CN, D1CP, D2CN, D2CP, D3CN, D3CP, D4CN, D4CP, D5CN, D5CP, D6CN, D6CP, D7CN, D7CP, D8CN, D8CP, D9CN, D9CP, D10CN, D10CP, D11CN, D11CP, D12CN, D12CP: 1N4148WS; SOD-323_L1.8-W1.3-LS2.5-RD; MPN 1N4148WS; LCSC C2128
D1HS1, D1HS2, D1LS1, D1LS2, D2HS1, D2HS2, D2LS1, D2LS2, D3HS1, D3HS2, D3LS1, D3LS2, D4HS1, D4HS2, D4LS1, D4LS2, D5HS1, D5HS2, D5LS1, D5LS2, D6HS1, D6HS2, D6LS1, D6LS2, D7HS1, D7HS2, D7LS1, D7LS2, D8HS1, D8HS2, D8LS1, D8LS2, D9HS1, D9HS2, D9LS1, D9LS2, D10HS1, D10HS2, D10LS1, D10LS2, D11HS1, D11HS2, D11LS1, D11LS2, D12HS1, D12HS2, D12LS1, D12LS2: US1M; SMA_L4.4-W2.8-LS5.4-RD; MPN US1M; LCSC C412437
DISP1: LED-2DIG-0.56CC; LED-SEG-TH_2DIG-0.56; MPN LED-2DIG-0.56CC; LCSC C9900021773
FBLLCA: 0R; L0805; MPN GZ2012D601TF; LCSC C1017
JCAN: PH-4; CONN-TH_4P-P2.00_PH; MPN B4B-PH-K-S; LCSC C131334
JDCN: STUD-M8; TERM_Stud_M8; MPN STUD-M8; LCSC CLASS
JDCP: STUD-M8; TERM_Stud_M8; MPN STUD-M8; LCSC CLASS
JICB: MICROFIT3-16; CONN-TH_16P-P3.00_MicroFit; MPN MICROFIT3-16; LCSC C277731
JOUTN: STUD-M8; TERM_Stud_M8; MPN STUD-M8; LCSC CLASS
JOUTP: STUD-M8; TERM_Stud_M8; MPN STUD-M8; LCSC CLASS
JPEB: STUD-M8; TERM_Stud_M8; MPN STUD-M8; LCSC CLASS
JSWDLLC: HDR-1x5-2.54; HDR-TH_5P-P2.54-V-M; MPN PZ254V-11-05P; LCSC C492404
JTERM: PH-2; CONN-TH_2P-P2.00_PH; MPN B2B-PH-K-S; LCSC C20504437
JTLLC: PH-2; CONN-TH_2P-P2.00_PH; MPN B2B-PH-K-S; LCSC C20504437
JTXFR: PH-2; CONN-TH_2P-P2.00_PH; MPN B2B-PH-K-S; LCSC C20504437
KOUT, KOUT2: HFE82V-M; RELAY_HFE82V_PCB; MPN HFE82V-M-CLASS; LCSC REVIEW
KPARA, KPARA2: HFE82V-M; RELAY_HFE82V_PCB; MPN HFE82V-M-CLASS; LCSC REVIEW
KPARB, KPARB2: HFE82V-M; RELAY_HFE82V_PCB; MPN HFE82V-M-CLASS; LCSC REVIEW
KPREA: HFE82V-20-M; MPN HFE82V-20-M-CLASS; LCSC REVIEW
KPREB: HFE82V-20-M; MPN HFE82V-20-M-CLASS; LCSC REVIEW
KSER, KSER2: HFE82V-M; RELAY_HFE82V_PCB; MPN HFE82V-M-CLASS; LCSC REVIEW
L1T, L2T, L3T, L4T, L5T, L6T, L7T, L8T, L9T, L10T, L11T, L12T: IND-TRIM-BIN4; L_Toroid_trim_bin_custom; MPN IND-TRIM-BIN4; LCSC CLASS
LBKB: IND-10u-3A; IND-SMD_L6.0-W6.0; MPN CYA0630-10UH; LCSC C5189958
LCAN: CMC-CAN-51uH; IND-SMD_L4.5-W3.2_CMC; MPN ACT45B-510-2P-TL003; LCSC C55213551
PS1H, PS1L, PS2H, PS2L, PS3H, PS3L, PS4H, PS4L, PS5H, PS5L, PS6H, PS6L, PS7H, PS7L, PS8H, PS8L, PS9H, PS9L, PS10H, PS10L, PS11H, PS11L, PS12H, PS12L: QA01C; PWRM-TH_QA01C; MPN QA01C; LCSC C2757491
PS5BKA, PS5BKB: ISO5V-RFC-6K; MPN ISO5V-RFC-6K; LCSC C20613048
PSCAN: ISO5V-RFC-6K; MPN ISO5V-RFC-6K; LCSC C20613048
PSSH: ISO5V-RFC-6K; MPN ISO5V-RFC-6K; LCSC C20613048
Q1H, Q1L, Q2H, Q2L, Q3H, Q3L, Q4H, Q4L, Q5H, Q5L, Q6H, Q6L, Q7H, Q7L, Q8H, Q8L, Q9H, Q9L, Q10H, Q10L, Q11H, Q11L, Q12H, Q12L: SG2M023120LJ; TO-247-4_L15.8-W5.0-P2.54-L; MPN SG2M023120LJ; LCSC C5713523
QDIG1, QDIG2: S8050; SOT-23-3_L2.9-W1.3-P1.90-LS2.4-BR; MPN S8050; LCSC C2146
QDISA: SIC-1200-5A; TO-247-3_L15.9-W5.0-P5.44-L; MPN IMW120R350M1H; LCSC C536285
QDISB: SIC-1200-5A; TO-247-3_L15.9-W5.0-P5.44-L; MPN IMW120R350M1H; LCSC C536285
R1CF, R2CF, R3CF, R4CF, R5CF, R6CF, R7CF, R8CF, R9CF, R10CF, R11CF, R12CF: 1k; R0805; MPN RC0805FR-071KL; LCSC C95781
R1CT, R2CT, R3CT, R4CT, R5CT, R6CT, R7CT, R8CT, R9CT, R10CT, R11CT, R12CT: 2R; R2512; MPN 25121WF200KT4E; LCSC C49298
R1HGS, R1HPD, R1LGS, R1LPD, R2HGS, R2HPD, R2LGS, R2LPD, R3HGS, R3HPD, R3LGS, R3LPD, R4HGS, R4HPD, R4LGS, R4LPD, R5HGS, R5HPD, R5LGS, R5LPD, R6HGS, R6HPD, R6LGS, R6LPD, R7HGS, R7HPD, R7LGS, R7LPD, R8HGS, R8HPD, R8LGS, R8LPD, R9HGS, R9HPD, R9LGS, R9LPD, R10HGS, R10HPD, R10LGS, R10LPD, R11HGS, R11HPD, R11LGS, R11LPD, R12HGS, R12HPD, R12LGS, R12LPD: 10k; R0805; MPN RC0805FR-0710KL; LCSC C84376
R1HOFF, R1LOFF, R2HOFF, R2LOFF, R3HOFF, R3LOFF, R4HOFF, R4LOFF, R5HOFF, R5LOFF, R6HOFF, R6LOFF, R7HOFF, R7LOFF, R8HOFF, R8LOFF, R9HOFF, R9LOFF, R10HOFF, R10LOFF, R11HOFF, R11LOFF, R12HOFF, R12LOFF: 2.2R; R1206; MPN SR1206FR-7W2R2L; LCSC C873951
R1HON, R1LON, R2HON, R2LON, R3HON, R3LON, R4HON, R4LON, R5HON, R5LON, R6HON, R6LON, R7HON, R7LON, R8HON, R8LON, R9HON, R9LON, R10HON, R10LON, R11HON, R11LON, R12HON, R12LON: 4.7R; R1206; MPN RC1206FR-7W4R7L; LCSC C859161
RAGTB: 0R; R0805; MPN RC0805JR-070RL; LCSC C96345
RAVF: 10k; R0805; MPN RC0805FR-0710KL; LCSC C84376
RAVH: 10k; R0805; MPN RC0805FR-0710KL; LCSC C84376
RAVI: 4.7R; R0805; MPN RC0805FR-074R7L; LCSC C137513
RAVL: 10k; R0805; MPN RC0805FR-0710KL; LCSC C84376
RBALBA1, RBALBA2: 47k; R2512; MPN PS122WF4702T4E; LCSC C2793932
RBALBB1, RBALBB2: 47k; R2512; MPN PS122WF4702T4E; LCSC C2793932
RBALTA1, RBALTA2: 47k; R2512; MPN PS122WF4702T4E; LCSC C2793932
RBALTB1, RBALTB2: 47k; R2512; MPN PS122WF4702T4E; LCSC C2793932
RBDA0, RBDA1, RBDA2, RBDA3: CER-2k2-10W-AX; RES-TH_L48.0-W8.0-P54.00; MPN CER-2k2-10W-AX; LCSC CLASS
RBDB0, RBDB1, RBDB2, RBDB3: CER-2k2-10W-AX; RES-TH_L48.0-W8.0-P54.00; MPN CER-2k2-10W-AX; LCSC CLASS
RBKF1B: 45.3k; R0805; MPN RC0805FR-0745K3L; LCSC C273885
RBKF2B: 10k; R0805; MPN RC0805FR-0710KL; LCSC C84376
RBLRS: 100R; R0805; MPN RC0805FR-07100RL; LCSC C105577
RBLRX: 10k; R0805; MPN RC0805FR-0710KL; LCSC C84376
RBLTS: 100R; R0805; MPN RC0805FR-07100RL; LCSC C105577
RBLTX: 10k; R0805; MPN RC0805FR-0710KL; LCSC C84376
RCGB: 1M; R1206; MPN RC0805FR-071ML; LCSC C107700
RDIG1, RDIG2: 2.2k; R0805; MPN RC0805FR-072K2L; LCSC C114561
RENLB: 100k; R0805; MPN RC0805FR-07100KL; LCSC C96346
RENRB: 100k; R0805; MPN RC0805FR-07100KL; LCSC C96346
RFLTB: 4.7k; R0805; MPN RC0805FR-074K7L; LCSC C60816
RGPDB: 10k; R0805; MPN RC0805FR-0710KL; LCSC C84376
RKPUKOUT: 10k; R0805; MPN RC0805FR-0710KL; LCSC C84376
RKPUKPARA: 10k; R0805; MPN RC0805FR-0710KL; LCSC C84376
RKPUKPARB: 10k; R0805; MPN RC0805FR-0710KL; LCSC C84376
RKPUKPREA: 10k; R0805; MPN RC0805FR-0710KL; LCSC C84376
RKPUKPREB: 10k; R0805; MPN RC0805FR-0710KL; LCSC C84376
RKPUKSER: 10k; R0805; MPN RC0805FR-0710KL; LCSC C84376
RLLCBOOT: 10k; R0805; MPN RC0805FR-0710KL; LCSC C84376
RLLCRST: 10k; R0402; MPN RC0805FR-0710KL; LCSC C84376
ROAD0, ROAD1, ROAD2, ROAD3, ROAD4, ROAD5, ROAD6, ROAD7: 475k; R1206; MPN HV732BTTD4753F; LCSC C4121673
ROADL: 6.8k; R0805; MPN ARG05BTC6801; LCSC C3033907
ROBD0, ROBD1, ROBD2, ROBD3, ROBD4, ROBD5, ROBD6, ROBD7: 475k; R1206; MPN HV732BTTD4753F; LCSC C4121673
ROBDL: 6.8k; R0805; MPN ARG05BTC6801; LCSC C3033907
ROVD0, ROVD1, ROVD2, ROVD3, ROVD4, ROVD5, ROVD6, ROVD7: 475k; R1206; MPN HV732BTTD4753F; LCSC C4121673
ROVDL: 6.8k; R0805; MPN ARG05BTC6801; LCSC C3033907
RPREA: SQP-10R-25W; RES-TH_L60.0-W9.0-P66.00; MPN SQP-10R-25W; LCSC CLASS
RPREB: SQP-10R-25W; RES-TH_L60.0-W9.0-P66.00; MPN SQP-10R-25W; LCSC CLASS
RPVBA: 1M; R0805; MPN RC0805FR-071ML; LCSC C107700
RPVBB: 1M; R0805; MPN RC0805FR-071ML; LCSC C107700
RPVLA: 330R; R0805; MPN RC0805FR-07330RL; LCSC C110440
RPVLB: 330R; R0805; MPN RC0805FR-07330RL; LCSC C110440
RRDYB: 10k; R0805; MPN RC0805FR-0710KL; LCSC C84376
RSEG0, RSEG1, RSEG2, RSEG3, RSEG4, RSEG5, RSEG6, RSEG7: 220R; R0805; MPN RC0603FR-07220RL; LCSC C107696
RSHO: SHUNT-MANG; SHUNT_4-terminal_manganin; MPN SHUNT-MANG; LCSC C508584
RSW1, RSW2: 10k; R0805; MPN RC0805FR-0710KL; LCSC C84376
RTERM: 120R; R1206; MPN RC1206FR-07120RL; LCSC C114928
RTLLCP: 10k; R0805; MPN RC0805FR-0710KL; LCSC C84376
RTXFRP: 10k; R0805; MPN RC0805FR-0710KL; LCSC C84376
RWPUB: 10k; R0805; MPN RC0805FR-0710KL; LCSC C84376
SW1, SW2: TACT-6x6; KEY-SMD_4P-L6.0-W6.0; MPN TACT-6x6; LCSC C318884
T1, T2, T3, T4, T5, T6, T7, T8, T9, T10, T11, T12: XFMR-LLC-10K; XFMR_3xPQ50-50_custom; MPN XFMR-LLC-10K; LCSC CUSTOM
TVSCAN: PESD1CAN; SOT-23-3_L2.9-W1.3-P1.90-LS2.4-BR; MPN PESD1CAN; LCSC C143073
U1H, U1L, U2H, U2L, U3H, U3L, U4H, U4L, U5H, U5L, U6H, U6L, U7H, U7L, U8H, U8L, U9H, U9L, U10H, U10L, U11H, U11L, U12H, U12L: NSI6611; SOIC-16_L10.3-W7.5-P1.27-LS10.3-BL; MPN NSI6611; LCSC C7470934
UANDB: 74HC11; SOIC-14_L8.7-W3.9-P1.27-LS6.0-BL; MPN 74HC11; LCSC C5524384
UAVB: TLV9061; SOT-23-5_L3.0-W1.7-P0.95-LS2.8-BL; MPN TLV9061IDBVR; LCSC C398358
UBKB: TPS54202; SOT-23-6_L2.9-W1.6-P0.95-LS2.8-BL; MPN TPS54202DDCR; LCSC C191884
UCAN: NSI1042; SOIC-16_L10.3-W7.5-P1.27-LS10.3-BL; MPN NSI1042; LCSC C3445856
UIVOA: AMC1311; SOIC-8_L5.9-W7.5-P1.27-LS11.5-BL; MPN AMC1311DWVR; LCSC C456277
UIVOB: AMC1311; SOIC-8_L5.9-W7.5-P1.27-LS11.5-BL; MPN AMC1311DWVR; LCSC C456277
UIVOV: AMC1311; SOIC-8_L5.9-W7.5-P1.27-LS11.5-BL; MPN AMC1311DWVR; LCSC C456277
ULB: ULN2803A; SOIC-18_L11.6-W7.5-P1.27-LS10.3-BL; MPN ULN2803A; LCSC C2865085
ULLC: GD32G553VET6; LQFP-100_L14.0-W14.0-P0.50-LS16.0-BL; MPN GD32G553VET6; LCSC C9900185865
UPVA: VOM1271T; SOP-4_L4.4-W4.3-P2.54-LS7.0-BL; MPN VOM1271T; LCSC C146286
UPVB: VOM1271T; SOP-4_L4.4-W4.3-P2.54-LS7.0-BL; MPN VOM1271T; LCSC C146286
USHO: NSI1200-DSWR; SOIC-8_L5.9-W7.5-P1.27-LS11.5-BL; MPN NSI1200-DSWR; LCSC C3029747
USR1: 74HC595; SOIC-16_L9.9-W3.9-P1.27-LS6.0-BL; MPN 74HC595; LCSC C19192516
USUPB: TPS3430; VSON-10_L3.0-W3.0-P0.50-TL-EP; MPN TPS3430WDRCR; LCSC C2870545

Notes on the sheet:
SHEET INDEX
120 kW DC-DC (upper) - 2 of 2
LLC-LEGS - 13 sections
LLC-TANKS - 12 sections
CONTROL - 7 sections
OUTPUT-SENSING - 7 sections
BANKS-SP - 4 sections
COMMS-HMI - 2 sections
rev D.3 - 45 sections - 744 components
NET NAMING
internal junctions are named for what they join
U<ref>_<PIN> node at that IC pin e.g. UIVOA_VINP
R<stem>_M midpoint of a series pair e.g. RBALTA_M
R<stem>_<nm> tap between R<stem>n/m e.g. RV1D_01
all others are explicit design nets
BANKS-SP / BANK-A
BANKS-SP / BANK-B
BANKS-SP / SP-MATRIX
BANKS-SP / BLEEDERS
COMMS-HMI / CAN
COMMS-HMI / HMI
CONTROL / MCU
CONTROL / SWD
CONTROL / SAFETY
CONTROL / GROUNDING
CONTROL / BUCK-3V3
CONTROL / COIL-DRIVER
CONTROL / INTERCONNECT
LLC-LEGS / BUS-IN
LLC-LEGS / LEG-1
LLC-LEGS / LEG-2
LLC-LEGS / LEG-3
LLC-LEGS / LEG-4
LLC-LEGS / LEG-5
LLC-LEGS / LEG-6
LLC-LEGS / LEG-7
LLC-LEGS / LEG-8
LLC-LEGS / LEG-9
LLC-LEGS / LEG-10
LLC-LEGS / LEG-11
LLC-LEGS / LEG-12
LLC-TANKS / TANK-1
LLC-TANKS / TANK-2
LLC-TANKS / TANK-3
LLC-TANKS / TANK-4
LLC-TANKS / TANK-5
LLC-TANKS / TANK-6
LLC-TANKS / TANK-7
LLC-TANKS / TANK-8
LLC-TANKS / TANK-9
LLC-TANKS / TANK-10
LLC-TANKS / TANK-11
LLC-TANKS / TANK-12
OUTPUT-SENSING / OUTPUT
OUTPUT-SENSING / SENSE-VBKA
OUTPUT-SENSING / SENSE-VBKB
OUTPUT-SENSING / SENSE-VOUT
OUTPUT-SENSING / ISO-BIAS
OUTPUT-SENSING / ANALOG-MID
OUTPUT-SENSING / NTC
