vectivolt/DC-Modules/kicad5/dc-modules-control-card/control-card-card.sch

## KiCad design kicad5/dc-modules-control-card/control-card-card.sch (2026-09-18)

Schematic: control-card-card.sch

Parts:
CADC0, CADC1, CADC2, CADC3, CADC4, CADC5, CADC6, CADC7, CADC8, CADC9, CADC10, CADC11, CADC12, CADC13, CADC14, CADC15, CADC16, CADC17, CADC18, CADC19, CADC20, CADC21: 1nF; C0402; MPN MLCC-1n-0402-C0G; LCSC CLASS
CANDCARD: 100nF; C0603; MPN CC0603KRX7R9BB104; LCSC C14663
CAVB: 100nF; C0603; MPN CC0603KRX7R9BB104; LCSC C14663
CAVF: 2.2nF; C0603; MPN CC0603KRX7R9BB222; LCSC CLASS
CAVM: 100nF; C0603; MPN CC0603KRX7R9BB104; LCSC C14663
CAVO: 10uF; C0603; MPN CL10A106KP8NNNC; LCSC CLASS
CBKICARD: 10uF; C0603; MPN CL10A106KP8NNNC; LCSC CLASS
CBKOCARD: 22uF; C0603; MPN GRM21BR61C226ME44L; LCSC C86817
CBSTCARD: 100nF; C0603; MPN CC0603KRX7R9BB104; LCSC C14663
CCARDA1: 1uF; C0603; MPN CL10A105KB8NNNC; LCSC CLASS
CCARDA2: 100nF; C0603; MPN CC0603KRX7R9BB104; LCSC C14663
CCARDD0, CCARDD1, CCARDD2, CCARDD3, CCARDD4: 100nF; C0603; MPN CC0603KRX7R9BB104; LCSC C14663
CCARDRST: 100nF; C0603; MPN CC0603KRX7R9BB104; LCSC C14663
CCARDVR: 100nF; C0603; MPN CC0603KRX7R9BB104; LCSC C14663
CCARDX1, CCARDX2: 12pF; C0603; MPN MLCC-small; LCSC CLASS
CFLTC: 1nF; C0603; MPN CC0603KRX7R9BB102; LCSC C100040
CRSTCARD: 1nF; C0603; MPN CC0603KRX7R9BB102; LCSC C100040
CSFCARD: 100nF; C0603; MPN CC0603KRX7R9BB104; LCSC C14663
FBCARDA: 50m; L0805; MPN GZ2012D601TF; LCSC C1017
JCARD: CONN-CARD-88-R; SKT-TH_88P-2R-P2.54-V; MPN CONN-CARD-88-R; LCSC CLASS
JSWDCARD: HDR-1x5-2.54; HDR-TH_5P-P2.54-V-M; MPN PZ254V-11-05P; LCSC C492404
LBKCARD: IND-10u-3A; IND-SMD_L6.0-W6.0; MPN CYA0630-10UH; LCSC C5189958
RAGTC: 0R; R0805; MPN RC0805JR-070RL; LCSC C96345
RAVF: 10k; R0805; MPN RC0805FR-0710KL; LCSC C84376
RAVH: 10k; R0805; MPN RC0805FR-0710KL; LCSC C84376
RAVI: 4.7R; R0805; MPN RC0805FR-074R7L; LCSC C137513
RAVL: 10k; R0805; MPN RC0805FR-0710KL; LCSC C84376
RBKF1CARD: 45.3k; R0805; MPN RC0805FR-0745K3L; LCSC C273885
RBKF2CARD: 10k; R0805; MPN RC0805FR-0710KL; LCSC C84376
RCARDBOOT: 10k; R0805; MPN RC0805FR-0710KL; LCSC C84376
RCARDRST: 10k; R0805; MPN RC0805FR-0710KL; LCSC C84376
RCARDXF: 1M; R0805; MPN RC0805FR-071ML; LCSC C107700
REN1CARD: 100k; R0805; MPN RC0805FR-07100KL; LCSC C96346
REN2CARD: 27k; R0805; MPN R-small; LCSC CLASS
RENLCARD: 100k; R0805; MPN RC0805FR-07100KL; LCSC C96346
RENRCARD: 100k; R0805; MPN RC0805FR-07100KL; LCSC C96346
RFLTC: 4.7k; R0805; MPN RC0805FR-074K7L; LCSC C60816
RGPACARD: 10k; R0805; MPN RC0805FR-0710KL; LCSC C84376
RGPDCARD: 10k; R0805; MPN RC0805FR-0710KL; LCSC C84376
RRDYCARD: 10k; R0805; MPN RC0805FR-0710KL; LCSC C84376
RROLE1: 10k; R0805; MPN RC0805FR-0710KL; LCSC C84376
RWDICARD: 10k; R0805; MPN RC0805FR-0710KL; LCSC C84376
RWDOLCARD: 0R; R0805; MPN RC0805JR-070RL; LCSC C96345
RWPUCARD: 10k; R0805; MPN RC0805FR-0710KL; LCSC C84376
TPWDICARD: TP-1mm-PAD; TP_PAD_1mm; MPN TP-1mm-PAD; LCSC CLASS
UANDCARD: 74HC11; SOIC-14_L8.7-W3.9-P1.27-LS6.0-BL; MPN 74HC11; LCSC C5524384
UAVB: TLV9061; SOT-23-5_L3.0-W1.7-P0.95-LS2.8-BL; MPN TLV9061IDBVR; LCSC C398358
UBKCARD: TPS54202; SOT-23-6_L2.9-W1.6-P0.95-LS2.8-BL; MPN TPS54202DDCR; LCSC C191884
UCARD: GD32G553VET7; LQFP-100_L14.0-W14.0-P0.50-LS16.0-BL; MPN GD32G553VET7; LCSC REVIEW
USUPCARD: TPS3430; VSON-10_L3.0-W3.0-P0.50-TL-EP; MPN TPS3430WDRCR; LCSC C2870545
XCARD: XTAL-8M-30PPM-3225; XTAL-SMD_L3.2-W2.5-4PAD; MPN XTAL-8M-30PPM-3225; LCSC CLASS

Notes on the sheet:
30/40/50 kW Control card - 3 of 3 · rev D.4 · 9 sections · 77 components
NET NAMING: U<ref>_<PIN> = node at that IC pin · R<stem>_M = series-pair midpoint · R<stem>_<nm> = tap between R<stem>n/m · all others are explicit design nets
CONTROL / MCU
CONTROL / SWD-BOOT
CONTROL / SAFETY
CONTROL / FLT-GROUND
CONTROL / BUCK-3V3
CONTROL / ANALOG-MID
CONTROL / ROLE
CONTROL / ADC-FILTER
CONTROL / CARD-IF
