vectivolt/DC-Modules/docs/reference/microchip-11kw-three-phase-pfc/dspic33c_11kw_three_phase_pfc_primary.X/main_tasks.c

/**
 * @file main_tasks.c
 * @brief This file contains the implementation of periodic and background tasks for the main application.
 *
 * @details This source file defines functions for tasks that run in the background
 * and tasks that are executed every 100 microseconds. These tasks manage
 * communication peripherals (SPI, CAN, I2C) and provide system heartbeat indication.
 *
 * @copyright
 * (c) 2025 Microchip Technology Inc. and its subsidiaries. You may use this
 * software and any derivatives exclusively with Microchip products.
 *
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
 * IN NO EVENT WILL MICROCHIP BE LIABLE FOR ANY INDIRECT, SPECIAL, PUNITIVE,
 * INCIDENTAL OR CONSEQUENTIAL LOSS, DAMAGE, COST OR EXPENSE OF ANY KIND
 * WHATSOEVER RELATED TO THE SOFTWARE, HOWEVER CAUSED, EVEN IF MICROCHIP HAS
 * BEEN ADVISED OF THE POSSIBILITY OR THE DAMAGES ARE FORESEEABLE. TO THE
 * FULLEST EXTENT ALLOWED BY LAW, MICROCHIP'S TOTAL LIABILITY ON ALL CLAIMS IN
 * ANY WAY RELATED TO THIS SOFTWARE WILL NOT EXCEED THE AMOUNT OF FEES, IF ANY,
 * THAT YOU HAVE PAID DIRECTLY TO MICROCHIP FOR THIS SOFTWARE.
 *
 * MICROCHIP PROVIDES THIS SOFTWARE CONDITIONALLY UPON YOUR ACCEPTANCE OF THESE
 * TERMS.
 */

/**
 * @section Included_Files Included Files
 * @brief This section lists the header files included in this file.
 */

#include "system/pins.h"
#include "sources/driver/spi/drv_spi.h"
#include "driver/can/drv_can.h"
#include "driver/i2c/i2c2.h"

/**
 * @brief Executes background tasks.
 * @details This function contains tasks that run in the background, typically
 * non-time-critical operations. Currently, it primarily handles the I2C slave
 * tasks by polling the I2C2 interrupt flag. It also includes a commented-out
 * call to clear the watchdog timer.
 * @param None
 * @return None
 */
void Tasks_Background(void)
{
    // I2C handler, poll interrupt flag
    // note that I2C handler is not interrupt driven
    if (IFS2bits.SI2C2IF)
    {
        I2C2_SlaveTasks();
        IFS2bits.SI2C2IF = 0;
    }

    // clear Watchdog
    //  WATCHDOG_TimerClear();
}

/**
 * @brief Executes tasks that run every 100 microseconds.
 * @details This function is called periodically (e.g., every 100us) to perform
 * time-critical operations. It is currently based on polling Timer 1's interrupt
 * flag. The tasks include:
 * - Checking for SPI communication timeouts (`Drv_SPI_Timeout()`). This function
 * will trigger an SPI timeout after 1ms if no messages are received, helping
 * to establish a reliable SPI communication channel.
 * - (Commented out) Checking for I2C handler timeouts (`Drv_I2C_Timeout()`).
 * - Receiving CAN data from the GUI (`CAN_Receive_from_GUI()`).
 * - Sending data to the GUI if the FIFO from the secondary core is full (`CAN_Transmit_to_GUI()`).
 * - Toggling an LED (LD2_RD15) at a 1Hz rate to serve as a heartbeat indicator.
 * @param None
 * @return None
 */
void Tasks_100us(void)
{
    // the DMA is triggered when an SPI message is received
    // an SPI message should be received every 10us
    // so this function will trigger an SPI timeout after 1ms
    // and will keep doing this until a reliable SPI comms channel
    // has been established
    Drv_SPI_Timeout();

    // timeout for I2C handler
    // expect I2C message from PIC16 on power board every 50ms.
    // If has not being received within 60ms of last message, then set timeout error flag
    //  Drv_I2C_Timeout();

    // check for CAN data from GUI
    CAN_Receive_from_GUI();

    // send data to GUI if FIFO from secondary core is full
    CAN_Transmit_to_GUI();

    // red LED blinking @ 1Hz as heartbeat
    static uint16_t led_blink_counter = 0;
    if (++led_blink_counter > 5000)
    {
        LD2_RD15_Toggle();
        led_blink_counter = 0;
    }
}
/**
 End of File
 */
