vectivolt/DC-Modules/(commit log)

2026-09-04 DC-Modules platform: 30/60/120 kW EV charging modules — design, sims, firmware, BOM, docs
    Complete pre-hardware engineering baseline:
    - Frozen decision register E1–E24 (Vienna 50 kHz + 3-φ LLC 140 kHz, two-board
    sandwich, S/P banks 500/525 crossover, JBS secondary, CT sensing, config HMI)
    - Simulation matrix closed in ngspice-46: DPT sweeps, line-cycle THD 0.59–1.05%,
    LLC op-points ZVS-clean, S/P transient study, aux flyback, LISN estimate,
    3024-pt envelope grid (0 fail), 6× Monte-Carlo batches, 26-scenario FSM suite
    - Production C99 supervisory firmware + CAN codec, 33/33 under ASan/UBSan
    (caught & fixed the E12b K_OUT gate defect)
    - Six TSCircuit board schematics, 0 netlist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
    [aux-flyback.csv, bom-120kw.csv, bom-30kw.csv, bom-60kw.csv, busbar.csv, cost-model.csv, dclink.csv, derating.csv]
2026-09-04 chore: drop tsci cache from repo
    [pcb_C17414-11a8b099a2142470c79db333f04a78c2.json, pcb_C17772-707c6623b1c6d6b63c6368c7e159b9c3.json, pcb_C25717-41a46adc1af515678bbb594d542738e9.json]
2026-09-04 review: adversarial production-readiness audit — verdict NO, 15 blockers documented
    Full A–R engineering review in docs/design-review-production.md: every finding
    source-verified (cells.tsx/boards.tsx/parts-db) with calculations, fault-matrix
    deltas, datasheet gate, layout dependencies and quantified fixes (~+INR 1.4–3.9k
    BOM impact). README/docs/verification-matrix updated to carry the honest status.
2026-09-04 rev C (partial): review closure — cells v3, boards v3, parts-db rev C, aux rev B sim, docs, review gate
    All 15 blockers + HR/MR implemented; review-checks.mjs 31/31 PASS; firmware 33/33;
    aux flyback re-simulated 342/560/850 V PASS. 120kw/dcdc rebuild in flight; BOM regen
    + final cost roll-up follow in the next commit.
    [aux-flyback.csv, loss-budget.csv]
2026-09-04 rev C complete: six boards rebuilt, BOM regenerated (100% matched), COGS restated honestly
    30kW ₹36,066 / 60kW ₹61,415 / 120kW ₹114,833 @1k — review closure bought
    safety/buildability with BOM (+4.2/6.1/10.3k incl. E23→ECO-1 deferral); R12
    updated. review-checks 31/31, firmware 33/33, aux rev B sims PASS, ERC clean.
    [bom-120kw.csv, bom-30kw.csv, bom-60kw.csv]
2026-09-04 R2 re-audit + rev D/D.1 closure: 7 new CBs fixed, 10k-volume basis, ECO-2, per-SKU decks
    R2 adversarial re-audit of rev C (docs/design-review-production-r2.md): NO again —
    CB-16 resonant burden 33R (15x mis-scale, 7 W in a 0.25 W part, F.11 dead),
    CB-17 DC-DC board had no 3.3 V source, CB-18 15 V-fed LDO thermally impossible,
    CB-19 100 V aux rectifiers at 160-200 V PIV, CB-20 60 W aux vs ~90 W @120 kW load,
    CB-21 FLT_LLC on no MCU pin, CB-22 drawn tank = rev D not frozen rev D2;
    + HR-13..20, MR-11..25. Every finding falsification-checked before action (one
    HR-14 sub-claim retracted — fsm.c F.20 is tolerant as coded; the same pass found
    F.21 existed only in docs).
    rev D (cells v4 / board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
    [aux-flyback.csv, bom-120kw.csv, bom-30kw.csv, bom-60kw.csv, ct-frontend.csv, loss-budget.csv, mcu-pinmap.csv, prechg-disch-sku.csv]
2026-09-05 E34 schematic presentation standard: engineered sheet layouts, sections, label-only cross-wiring
    Full re-layout of every schematic coordinate (rev D.2). Every cell now carries a
    documented schematic envelope on a grid; boards place sections in a planned sheet
    architecture (power flow left-to-right, control row beneath, per-column sensing).
    Every component carries schSectionName - cross-section connectivity renders as
    named net labels, never routed wires (schMaxTraceDistance=0 + per-trace
    schDisplayLabel on 420+ traces); wires remain only for local in-section
    connections (gate loops, filter chains, dividers).
    New tooling:
    - calculations/schematic-check.mjs: geometric overlap gate from built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
2026-09-05 Schematic magnetics: true inductor symbols with values for all 2-pin inductors
    PFC chokes (165uH), DM line chokes (22uH), resonant trim inductors (4uH nominal,
    D2 bin set per BOM), and 3V3 buck inductors (10uH) now render as real coil
    symbols with printed values instead of generic chip boxes (the LDM line also
    gained its missing EMI schSectionName). Multi-winding customs (LLC transformers,
    CM chokes, CTs, aux transformer) correctly remain labeled multi-pin boxes.
    All six boards rebuilt: 0 netlist port errors, schematic-check CLEAN
    (0 symbol overlaps everywhere), all six sectioned SVGs re-exported, BOM
    regenerated 100% matched (totals unchanged - names/parts identical).
    Gate 67 asserts + fir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
2026-09-05 EasyEDA transcription of 30 kW schematics + verification gate
    Adds the netlist->EasyEDA pipeline and its ground-truth checker:
    - easyeda-pages.mjs: circuit.json -> 12 per-page payloads (blocks/nets/NC)
    - easyeda-apply-gen.mjs: payloads -> apply chunks with per-part pin remaps
    - easyeda-verify.mjs: readback vs intent diff, emits repair plans
    - part-uuid-map.json: 91 part families resolved to LCSC part_uuids
    Project "DC Modules" carries 607/608 components across 12 pages at
    94.08% pin accuracy (1622/1724). Residual defects and the four
    extension-build blockers behind them are documented in
    docs/easyeda-transcription.md. The tscircuit source remains
    authoritative; the EasyEDA project is not fa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
    [acdc-AC-SENSING.json, acdc-AUX-POWER.json, acdc-CONTROL.json, acdc-DC-LINK.json, acdc-INPUT-EMI.json, acdc-VIENNA-PFC.json, dcdc-BANKS-SP.json, dcdc-COMMS-HMI.json]
2026-09-05 Composed presentation-grade schematic sheets + LCSC assignment
    schematic-compose.mjs re-lays each board deliberately instead of framing
    whatever the compiler emitted. The movable unit is a wire-connected
    cluster, not a named section: measurement found 126 (AC-DC) and 142
    (DC-DC) wires crossing section boundaries, so translating whole sections
    would silently tear them. Clusters cannot be torn by construction, and
    packing at cluster granularity also removes the whitespace inside a
    section. Clusters shelf-pack inside their frame; frames skyline-pack on
    the sheet in signal-flow order with uniform gutters (sheet fill 46% -> 60%).
    Self-checks: no frame or cluster overlaps, nothing unplaced, every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
    [bom-120kw.csv, bom-30kw.csv, bom-60kw.csv, page-uuids-new.json]
2026-09-05 Self-identifying title blocks + fit guard on composed sheets
    Each sheet now states which SKU it belongs to, which board of the pair it
    is, its sheet number, and how that board scales across the 30/60/120 kW
    set, so a printed sheet identifies itself. The block sizes itself to its
    text -- a fixed width clipped the longer SKU titles into the divider --
    and the composer now fails if any title-block text crosses the divider or
    the box edge. All six boards compose clean.
2026-09-05 Document the drawing set, LCSC statuses, and EasyEDA findings
    docs/schematic-drawing-set.md covers the composed release sheets: how the
    cluster-based composition works and why (126/142 wires cross section
    boundaries, so section-level moves tear them), the five checks that fail
    the build, and the LCSC status split across all 97 parts -- including the
    ten REVIEW lines where the library part does not meet the stated rating.
    docs/easyeda-transcription.md records three further findings: one extract
    call per block is the only reliable recipe; deleting a page orphans its
    components onto the next page under auto-renamed designators; and a single
    fatal DRC error blocks netlist export for an entire s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
2026-09-05 Fix blank symbols and detached net labels in the drawing set
    Two distinct defects, different causes:
    1. Detached net labels — MY BUG, introduced with the composer. Loose
    elements were bound to the nearest cluster by centroid distance, which
    mis-assigned 39 of 305 labels (13%) on the AC-DC board, so a label
    could travel away from the pin it annotates. Net labels and port
    markers carry ids, so they are now bound to the exact component whose
    pin they annotate; remaining unbound text binds to its nearest symbol.
    2. Blank-looking components — PRE-EXISTING in the design source, not an
    omission. 73/300 (AC-DC) and 79/308 (DC-DC) parts are declared as a
    generic chip, which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
    [acdc-AC-SENSING.kicad_sch, acdc-AUX-POWER.kicad_sch, acdc-CONTROL.kicad_sch, acdc-DC-LINK.kicad_sch, acdc-INPUT-EMI.kicad_sch, acdc-VIENNA-PFC.kicad_sch, dcdc-BANKS-SP.kicad_sch, dcdc-COMMS-HMI.kicad_sch]
2026-09-05 Board and page PDFs of the drawing set
    sheets-to-pdf.mjs renders each composed board sheet to a single-page PDF
    at the sheet's own size (vector in, vector out via headless Chrome), so
    the drawing stays zoomable and the text selectable. Six board PDFs, plus
    twelve per-page PDFs for the 30 kW pair exported from the KiCad source.
2026-09-05 KiCad 5.1 legacy schematics — the format EasyEDA Pro can actually import
    Root cause of the EasyEDA dead end: EasyEDA Pro imports KiCad 5.1/5.9
    projects, which is the pre-S-expression Eeschema format. The KiCad 10
    .kicad_sch files could never have been read by it, so the hand-placed
    geometry had no route in.
    kicad5-gen.mjs emits the same hand-placed layout as .sch + .lib + .pro
    with a root sheet referencing all twelve pages, so one import brings the
    whole board set. Legacy units are mils and 1.27mm == 50mil exactly, so
    the grid maps without rounding.
    kicad5-verify.mjs re-derives the netlist from the emitted files from
    scratch (library pin offsets, placements, wire geometry, labels) since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
    [acdc-AC-SENSING.sch, acdc-AUX-POWER.sch, acdc-CONTROL.sch, acdc-DC-LINK.sch, acdc-INPUT-EMI.sch, acdc-VIENNA-PFC.sch, dc-modules-30kw.sch, dcdc-BANKS-SP.sch]
2026-09-06 R3: verify external PDF review against datasheets; fix confirmed defects
    The reviewer's headline claim -- MOSFET/driver/MCU/regulator pin numbers do
    not match the real parts -- is TRUE OF THE PDFs and FALSE OF THE NETLIST.
    The design is authored with logical pin ids and remapped to physical package
    pins before any netlist leaves the repo; that remap was never published, so
    the drawing was unfalsifiable. It is now docs/symbol-pin-map.md (107
    families, 27 remapped, 407 pins). Datasheet checks confirm our physical map
    MATCHES for B3M010C075Z, SG2M023120LJ, TPS54202, NCP1252A, TLV9061,
    VOM1271T, TLP152. Five further claims (VAC1/VAC2 same phase, PWM stubs,
    SNS_VMID, shorted shunt sense, 185.5 kH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
    [acdc-AC-SENSING.kicad_sch, acdc-AC-SENSING.sch, acdc-AUX-POWER.kicad_sch, acdc-AUX-POWER.sch, acdc-CONTROL.kicad_sch, acdc-CONTROL.sch, acdc-DC-LINK.kicad_sch, acdc-DC-LINK.sch]
2026-09-06 Fix HR-10 gate: it pinned a part number that does not exist
    The assertion grepped for QA01C-15S18. MORNSUN has no such part (QA01C is
    +20/-4 V, QA01C-18 is +18/-3 V), so the gate was holding a typo in place and
    failed the moment the part was named correctly. Now matches QA01C.
2026-09-06 Rebuild the GD32G553VET6 pin map against the datasheet
    The map was STM32G474-derived and headed pin(symbolic); gate item A6 had
    recorded the GD32G553 check as pending and it was never closed. It put the
    fault output on pin 74 (VSS) and BOOT0 on pin 100 (VDD) -- two hard shorts
    -- and SWD on PA6/PA7, so the part was also unprogrammable as drawn.
    Allocated against GD32G553xx Rev 2.0 Table 2-4 for the 120 kW worst case
    (59 PFC / 80 LLC signals on 100 pins), then adversarially audited. The audit
    caught a safety-critical error in the first LLC pass: PA6 cannot be
    TIMER0_BRKIN0 and TIMER7_BRKIN0 at once (AF6 vs AF4, one AFSEL per pin),
    which would have left four legs -- eight switches at 120 kW -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
    [acdc-CONTROL.kicad_sch, acdc-CONTROL.sch, acdc-DC-LINK.kicad_sch, acdc-INPUT-EMI.kicad_sch, acdc-VIENNA-PFC.kicad_sch, dcdc-BANKS-SP.kicad_sch, dcdc-COMMS-HMI.kicad_sch, dcdc-CONTROL.kicad_sch]
2026-09-06 Close gate item A6 with the R3 datasheet check
    A6 read 'pin map on G474 conventions | GD32G553 datasheet check (R9)'. That
    check is now done and the map rebuilt, so the row records the outcome --
    including that HRTIMER has 8 slave units / 16 outputs, not the 6/12 assumed,
    and that four architecture decisions remain open rather than defaulted.
2026-09-06 Visual pass on the hand-placed sheets: four draughting defects fixed
    End-to-end inspection at zoom found four things the wide view hides:
    1. The reference designator collided with the first top pin's number on
    every multi-pin IC. The library default had been moved but the INSTANCE
    property is what renders -- fixed there, right-justified clear of the body.
    2. Power pins on the top/bottom edges drew their name INSIDE the body,
    rotated, straight through the first left/right pin name (VDD over PC13 on
    the MCU). Their names are now suppressed; the net label outside already
    says V3P3 / DGND, which is standard practice on a large MCU.
    3. Unbound symbol pins rendered as bare stubs th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
    [acdc-AC-SENSING.kicad_sch, acdc-AC-SENSING.sch, acdc-AUX-POWER.kicad_sch, acdc-AUX-POWER.sch, acdc-CONTROL.kicad_sch, acdc-CONTROL.sch, acdc-DC-LINK.kicad_sch, acdc-DC-LINK.sch]
2026-09-06 Machine-check the drawing rules across all 12 sheets
    Eyes only sampled 2 of 12 pages. kicad5-visual.mjs checks every glyph:
    label-vs-label, label-vs-symbol, field-text-vs-field-text and
    field-text-vs-symbol collisions, on the emitted legacy geometry.
    First run reported 40+ collisions, nearly all of them phantom: vertical
    labels (the V3P3/DGND supply combs) are rotated, so measuring them with a
    horizontal bounding box flagged the whole comb. Fixed the checker rather
    than the drawing -- then: 608 symbols, 1735 labels, no collisions anywhere.
    So the four defects found by eye were the real ones, and the drawing rule
    'no overlapping wires, labels, components, or sections' is now enforced
    rather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
2026-09-06 Resolve the EasyEDA import DRC: footprints + cross-page connectivity
    Two root causes behind every error and warning in the 30 kW import.
    FATAL (44 per page): every component lacked a Footprint property. My KiCad
    symbols emitted an empty F2 field. footprint-map.mjs now gives the intended
    package for all 99 part families, resolved BY DESIGNATOR through parts-db --
    not by the payload's value field, since most passives carry no MPN there and
    would have fallen back to "47k". 608/608 components now carry a footprint.
    PCB layout is out of scope, so these are specified packages rather than
    placed library footprints; the schematic states the intent honestly.
    WARN ("Pins floating" on JFAN1.1, JICA.1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
    [30kw-acdc.sch, 30kw-dcdc.sch, acdc-AC-SENSING.sch, acdc-AUX-POWER.sch, acdc-CONTROL.sch, acdc-DC-LINK.sch, acdc-INPUT-EMI.sch, acdc-VIENNA-PFC.sch]
2026-09-06 Use EasyEDA footprint naming so auto-association actually matches
    The first corrected import still returned 300 fatal errors -- one per
    component -- because "Associate footprint automatically" matches against
    EasyEDA's OWN footprint library by name, and I had emitted KiCad-style
    names (R_1206_3216Metric, SOT-23-6, TO-247-4). Nothing matched, so every
    Footprint property came in empty and the fatal count was unchanged.
    Converted the map to EasyEDA's canonical names: R1206, C0603, R2512,
    SOIC-8_L4.9-W3.9-P1.27-LS6.0-BL, TO-247-2_L16.0-W5.0-P10.90-TL,
    LQFP-100_L14.0-W14.0-P0.50-LS16.0-BL and so on -- 66 distinct footprints
    across 608 components.
    Confirmed working in the meantime: the per-board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
    [30kw-acdc.sch, 30kw-dcdc.sch]
2026-09-06 Correct footprint names against the real EasyEDA library
    The EasyEDA-style names were still partly invented. Harvested the real
    strings via component_search on parts we already specify:
    TO-247-4 -> TO-247-4_L15.8-W5.0-P2.54-L (was ..._L16.0-W5.0-P5.45-TL)
    TO-247-2/3 -> TO-247-3_L15.9-W5.0-P5.44-L
    SMA -> SMA_L4.4-W2.8-LS5.4-RD (was ..._L4.3-W2.6-LS5.0-RD)
    Import result so far, measured in EasyEDA rather than assumed:
    - project imports as TWO schematics (30kw-acdc, 30kw-dcdc), section grid
    and title block intact, Rev D.1 carried through
    - global labels arrive as project-scoped global nets (N_ACDC_51 shows
    Relevance across the board), so cross-page connectivit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
    [30kw-acdc.sch, 30kw-dcdc.sch]
2026-09-06 Extend the whole chain to 60 kW and 120 kW
    The generators only ever produced 30 kW. The lane-indexed blocks were
    pinned to lane 0 (LA0, CTA0, CDT0x, legs 1-3), so on the bigger SKUs every
    lane above the first would have been silently dropped from the drawing.
    The page generator now discovers the indices from the netlist and expands
    per lane: Vienna phases (3/6/12 blocks), line CTs, DC-link banks, LLC legs
    and tanks (3/6/12). Two regexes were too narrow and were caught by the
    "UNASSIGNED" report rather than by eye: CF\d missed CF10/CF11, and the
    DC-link bank had no lane expander at all -- 12 parts at 60 kW and 32 at
    120 kW. All three SKUs now assign every component.
    Titles, filenames and ro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
    [120kw-acdc.sch, 120kw-dcdc.sch, 30kw-acdc.sch, 30kw-dcdc.sch, 60kw-acdc.sch, 60kw-dcdc.sch, acdc-AC-SENSING.json, acdc-DC-LINK.json]
2026-09-06 Register the footprints that must be drawn, rather than mis-assign them
    I could clear the remaining 106 fatal DRC errors right now: EasyEDA's
    library does contain names that would make the check pass -- RES-TH_12R_2W,
    CAP-TH_BD25.4-P10.00-D2.3-FD, both verified to exist via component_search.
    Using them would put a 2 W axial land pattern under a 25 W wirewound and a
    25.4 mm can under a 30 mm snap-in electrolytic.
    That is fabricated manufacturing data to satisfy a checkbox, and it is the
    same failure mode this session has been catching elsewhere -- the external
    review's pinout claims, my own two rounds of invented footprint names. A
    green DRC bought that way is worse than a red one, because i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
2026-09-06 Add No-Connect flags to the EasyEDA-bound sheets
    Inspecting the imported project at working zoom -- not the fit-to-page view
    -- showed unbound IC pins rendering as bare stubs. That is exactly what
    EasyEDA's own warning asks for: "Found some components Pins floating,
    suggest placing No Connect Flag on the Pins: QAUX.1, TAUX.1, UAUX.1 ...".
    The KiCad-10 generator got no-connect markers during the earlier visual
    pass; the LEGACY generator -- the one that actually feeds EasyEDA -- never
    did, so the fix had not reached the artifact. Legacy `NoConn ~ X Y` is now
    emitted at every unbound IC pin: 41 / 38 / 36 across 30 / 60 / 120 kW.
    An unmarked floating pin is ambiguous: it reads as a forgotten c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
    [120kw-acdc.sch, 120kw-dcdc.sch, 30kw-acdc.sch, 30kw-dcdc.sch, 60kw-acdc.sch, 60kw-dcdc.sch]
2026-09-06 Fix broken output return path (R4); normalize EasyEDA net-label size
    A net-to-net <trace> in SeriesParallelRelayMatrix bound nothing — tscircuit
    traces join ports, not nets — so the bank-negative rail BKBN never reached the
    output shunt. OUTN_SH carried one pin (RSHO.1) and the DC return path
    dead-ended; the output current sense measured a node with no current in it.
    ERC stayed clean throughout because no port was left unbound.
    Found from an EasyEDA schematic-DRC "single network connected to only one
    component pin" warning while inspecting the imported 30 kW sheets.
    - cells.tsx: drop the no-op trace and the now-dead `outn` prop
    - boards.tsx: OutputShunt inn = net.BKBN, so the shunt sit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
    [120kw-acdc.sch, 120kw-dcdc.sch, 30kw-acdc.sch, 30kw-dcdc.sch, 60kw-acdc.sch, 60kw-dcdc.sch, dcdc-OUTPUT-SENSING.json]
2026-09-06 Fix EasyEDA importer's vertical symbol mirror (R5) — 454 silently mis-wired pins
    EasyEDA Pro's KiCad-legacy importer places pins at (ux+px, uy+py); it does not
    apply the "1 0 0 -1" matrix mapping library Y-up to sheet Y-down, so every
    symbol imports mirrored about its own Y axis.
    Measured, not guessed. EasyEDA's exported DRC log listed 90 floating pins on
    30kw-dcdc. Scoring four candidate transforms against that list:
    (ux+px, uy-py) KiCad matrix, what we assumed : 9 predicted, 0/90 matched
    (ux+px, uy+py) vertical mirror : 99 predicted, 90/90 matched
    body-end shift outward by pin length : 943 predicted, 90/90, 853 extra
    (ux-px, uy-py) horizontal mirro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
    [120kw-acdc.sch, 120kw-dcdc.sch, 30kw-acdc.sch, 30kw-dcdc.sch, 60kw-acdc.sch, 60kw-dcdc.sch]
2026-09-06 Compose the sheets: column grid, grouped families, sheet identity, LCSC on every part
    Layout was shelf-packed: a row's height came from its tallest frame, so short
    frames left dead bands, right margins were ragged by up to 28850 mil, and 45
    frames landed on 31 distinct left edges with near-misses 50-200 mil apart.
    Almost-aligned reads as careless where clearly aligned reads as deliberate.
    - Column grid: each frame's width is quantised up to a whole number of columns,
    so every left edge comes from the same small set and the sheet has real
    columns. The width a frame gains becomes symmetric padding inside it.
    - Family-aware placement: packing purely by lowest-y scattered VIENNA-PFC
    PHASE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
    [120kw-acdc.sch, 120kw-dcdc.sch, 30kw-acdc.sch, 30kw-dcdc.sch, 60kw-acdc.sch, 60kw-dcdc.sch, dc-modules-30kw.sch]
2026-09-06 Net labels instead of net ports; search family width to level the sheets
    The chevron overflow is fixed at the root, without touching a net name.
    EasyEDA renders an imported GLOBAL label as a net port: a fixed-width chevron
    holding ~7 characters with the text scaled independently, so 43% of this
    design's names spilled past it at any font size. A plain net label has no
    enclosing glyph, so nothing can overflow. Scope is not lost -- each board is one
    sheet and EasyEDA merges net labels by name across it; the only nets leaving a
    sheet are the 14 cross-board ones, which cross physically on the studs and
    harness. Verified in EasyEDA (rev L): 0 errors, 0 warnings, and RELAY_FB_KPRE /
    SWDIO_PFC / SWC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
    [120kw-acdc.sch, 120kw-dcdc.sch, 30kw-acdc.sch, 30kw-dcdc.sch, 60kw-acdc.sch, 60kw-dcdc.sch]
2026-09-06 Resolve QA01C footprint from LCSC; classify the remaining footprint gap
    Harvested from EasyEDA's own LCSC catalogue via component_search, not invented:
    QA01C -> PWRM-TH_QA01C (LCSC C2757491). Closes 62 instances; EasyEDA fatal
    errors on 30kw-acdc drop 89 -> 85.
    The HF167F relays were also pointed at the catalogue land RELAY-TH_HF167F-24-HF
    (LCSC C2757422) and EasyEDA's DRC rejected it:
    [Error] The pin of the component HF167F-80A-M does not correspond to the pad
    (Pin has no corresponding pad: 5, 6, 8 ; Pad has no corresponding pin: 2)
    The catalogue part is a plain 4-pad SPST-NO relay; E30 needs the MIRROR-CONTACT
    variant, where pins 5/6/8 carry the mirror that drives RELAY_FB_*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
    [120kw-acdc.sch, 120kw-dcdc.sch, 30kw-acdc.sch, 30kw-dcdc.sch, 60kw-acdc.sch, 60kw-dcdc.sch]
2026-09-06 End-to-end visual pass: measure the void the eye sees, and let it drive the layout
    Inspected all six sheets, not the two I had looked at. 30kw-dcdc had a blank
    channel through its middle and LLC-TANKS split across the sheet; 120kw-acdc had
    its whole bottom-left empty. Neither showed up in any metric I had: "density"
    is blind to one ugly hole in an otherwise full sheet, and "ragged bottom" only
    measures where columns finish.
    So measure it directly: largestVoid() rasterises the sheet and runs the
    largest-rectangle-in-histogram sweep to get the biggest empty block as a
    fraction of sheet area. It is both a scoring term and a gate, and the
    title-block corner is marked occupied first -- that corn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
    [120kw-acdc.sch, 120kw-dcdc.sch, 30kw-acdc.sch, 30kw-dcdc.sch, 60kw-acdc.sch, 60kw-dcdc.sch]
2026-09-06 Resolve ordinary passives to real LCSC parts: real C-numbers 34% -> 56%
    "CLASS" was covering two different situations. For an HV73 divider, a PP film
    cap rated by voltage class, or a wound choke, CLASS *is* the specification and
    substituting a generic part would silently drop a rating the design depends on.
    But for a 10k 0805 or a 100nF 0603 decoupler it was just an unresolved lookup.
    Nine ordinary passive families are now resolved to catalogue parts, every one
    read back from EasyEDA's LCSC catalogue via component_search (none from memory):
    10k 0805 1% RC0805FR-0710KL C84376
    1k 0805 1% RC0805FR-071KL C95781
    220R 0603 1% RC0603FR-07220RL C107696
    100nF 0603 X7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
    [120kw-acdc.sch, 120kw-dcdc.sch, 30kw-acdc.sch, 30kw-dcdc.sch, 60kw-acdc.sch, 60kw-dcdc.sch, bom-120kw.csv, bom-30kw.csv]
2026-09-06 Draw the 12 deterministic footprints: 456 of 696 placeholder instances closed
    A land pattern whose dimensions are already in its own name is not something to
    leave as a placeholder. CAP-TH_L26.5-W11.0-P22.50 carries the body length, body
    width and lead pitch from the part's datasheet; the land follows from them --
    two pads on the pitch, hole = lead + 0.3 mm (IPC-2222 cl.2), pad = hole + 2x0.45
    annular, silk the body, courtyard 0.5 clear. footprint-gen.mjs emits them as
    KiCad .kicad_mod, which EasyEDA Pro imports directly.
    The one number not in the name is lead diameter, so it is stated per family and
    is the single value to correct against a datasheet: 1.0 mm axial power
    resistors, 0.8 mm fi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
2026-09-06 Detail renderer for working-zoom inspection; ink checker now covers pin-name text
    EasyEDA is on another Space and cannot be driven, but EasyEDA was never the
    source of truth -- the .sch + .lib pair is what it imports, so anything wrong
    there is wrong here. kicad5-detail.mjs renders any region of any sheet at
    working zoom, faithfully: symbol bodies and their shapes, pin lines, pin NAMES
    inside the body, pin NUMBERS outside, net-label text at its real size and
    rotation, designator/value fields at their real positions, and no-connect
    crosses. Tiles a sheet so the whole thing can be walked.
    Two renderer bugs found and fixed while building it, both of which had made the
    drawing look worse than i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
2026-09-06 Close the three R3 floating-pin defects; tighten the void gate to 9%
    A working-zoom pass over the emitted sheets showed USUPA with only
    SET0/SET1/WDI/WDO# bound. Checking my own R3 notes against the built netlist
    confirmed all three were still open, months after being written down:
    NSI6611 x9/board pin 12 RDY open-drain power-good, floating -- could
    never pull, so it could neither assert nor
    be read
    TPS3430 USUPA/B pin 2 CWD watchdog timeout program, floating
    pin 4 CRST reset-delay program, floating
    -> the E27/CB-10 safety chain's centrepiece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
    [120kw-acdc.sch, 120kw-dcdc.sch, 30kw-acdc.sch, 30kw-dcdc.sch, 60kw-acdc.sch, 60kw-dcdc.sch, acdc-AUX-POWER.json, acdc-CONTROL.json]
2026-09-06 Draw the connector/header/disc footprints too: 521 of 696 instances now real
    Same argument as the two-lead parts: the name already carries the part's own
    dimensions, so the land follows. A way count and a pitch pin down a header or
    connector completely; the only thing left is the hole, which follows from the
    contact the series uses, and that is stated per family in the generator.
    CONN-TH_nP-P2.00_PH JST PH contact -> 0.8 mm hole
    CONN-TH_nP-P3.00_MicroFit Micro-Fit 3.0 -> 1.1 mm hole, dual row
    HDR-TH_nP-P2.54-V-M 0.64 mm square post -> 1.0 mm hole
    DISC-..mm_RM.., GDT-..mm_RM.. 0.8 mm leads -> 1.1 mm hole
    Geometry spot-checked against the names: Micro-Fi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
2026-09-06 Record two rejected part assignments; inspect all six sheets at working zoom
    Tried to push LCSC and footprint coverage further and stopped at two places
    where the obvious catalogue part would have silently changed a rating. Both are
    now recorded so nobody repeats them:
    gate resistor R1206-RG-0.5W -> RC1206FR-074R7L (C137258) is 250 mW, half the
    specified rating, on the resistor that takes the gate-drive pulse. CLASS is
    the correct status here, not an unfinished lookup; the 0.5 W class needs a
    pulse-rated series chosen at RFQ.
    tactile TACT-6x6 -> TS-1088-AR02016 (C720477) is a 3.9 x 3.0 mm switch; the
    design specifies 6 x 6 mm, so the land differs.
    Same failure mode as t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
2026-09-06 Add unwired-pin detector; it finds a floating leg on all 8 isolated voltage senses
    Generalises a defect that kept turning up one at a time by eye (NSI6611 RDY,
    TPS3430 CWD/CRST, NCP1252A RT): a pin the symbol DECLARES, that really exists on
    the part and really does something, which no trace ever reaches. ERC cannot see
    it -- nothing is unbound from its point of view, because the pin was never asked
    to connect.
    unwired-pins.mjs compares declared pins against pins reached by a trace in the
    BUILT netlist, per SKU. Everything excluded carries a reason: explicit NC pins,
    spare AND-gate outputs, the shift-register cascade output, internally-paired
    tactile contacts, the CAN shield, harness spares,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
2026-09-06 Resolve 5 more passive values; adjudicate the whole LCSC column
    Real C-numbers 1591 -> 1672 (56% -> 59%), all read back from EasyEDA's LCSC
    catalogue via component_search:
    10k 1206 1% RC1206FR-0710KL C132649 24x
    33R 1206 1% RC1206FR-0733RL C137308 21x
    100R 0805 1% RC0805FR-07100RL C105577 15x
    100k 0805 1% RC0805FR-07100KL C96346 12x
    10nF 0603 X7R CC0603KRX7R9BB103 C100042 9x
    More usefully, docs/lcsc-status.md now itemises the remaining 1113 CLASS
    instances by WHY, so the column reads as adjudicated rather than unfinished:
    866 class IS the spec -- safety-certified X1/Y1 (the certification is the
    part, not the value), voltage-class film, anti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
    [120kw-acdc.sch, 120kw-dcdc.sch, 30kw-acdc.sch, 30kw-dcdc.sch, 60kw-acdc.sch, 60kw-dcdc.sch, bom-120kw.csv, bom-30kw.csv]
2026-09-06 Approximate footprints for the magnetics and shunt, per SKU: 647 of 696 drawn
    Requested so the PCB can be laid out now against realistic outlines, with the
    real parts wound or made to that size later. The schematics do not move: the
    footprint NAME is identical on every SKU and each SKU's file carries its own
    geometry, so DC-Modules-footprints-<sku>.zip imports alongside that SKU's bundle.
    Every core dimension is quoted from the design's own drawings -- magnetics.md
    D1/D2/D3/D4/D6/D7 and its CT section, architecture.md for the shunt current,
    parts-db for its 50 mV class. What is approximate is only the winding build and
    the lead exits, and each rule is stated in the generator: +2x4 mm on a t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
    [120kw-acdc.sch, 120kw-dcdc.sch, 30kw-acdc.sch, 30kw-dcdc.sch, 60kw-acdc.sch, 60kw-dcdc.sch]
2026-09-06 Cost the R7 decision so it only needs a yes
    The design's own precedent settles the method: SNS_IOUT is on PC0 (ADC0_IN5)
    and SNS_IOUTN on PC1 (ADC0_IN6) -- two ordinary single-ended channels on one
    ADC, subtracted in firmware, not a hardware differential pair. Applying the same
    to the voltage senses costs 5 extra ADC channels on UPFC (SNS_VAC1/2/3,
    SNS_VBUSP, SNS_VMID) and 3 on ULLC (SNS_VOUT, SNS_VBKA, SNS_VBKB). Both parts
    have room: 61 and 77 of 100 pins allocated.
    Also recorded what happens if it is left alone, because that is a legitimate
    answer: a floating VOUTN is electrically safe -- it is an output, nothing is
    damaged and nothing is unbound. The cost is measurement quality; the ADC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
2026-09-06 Seven more passive values resolved: real C-numbers 59% -> 61%
    All read back from EasyEDA's LCSC catalogue, none from memory:
    10uF 0805 X5R 25V CL21A106KAYNNNE C15850 12x
    22uF 0805 X5R 16V GRM21BR61C226ME44L C86817 6x
    2.2nF 0805 X7R CC0805KRX7R9BB222 C107146 6x
    2.2k 0805 1% RC0805FR-072K2L C114561 6x
    4.7R 0805 1% RC0805FR-074R7L C137513 6x
    1uF 0805 reuses C28323 (same part as MLCC-1u-0805)
    100k on 0805 land reuses C96346 (same part as R-small|100k)
    Two ratings checked before assigning, not after:
    - the 10uF sits on V15, so it takes the 25 V class, not the 6.3/10 V part a
    "10uF 0805" search returns first.
    - R-small|4.7 i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
    [120kw-acdc.sch, 120kw-dcdc.sch, 30kw-acdc.sch, 30kw-dcdc.sch, 60kw-acdc.sch, 60kw-dcdc.sch, bom-120kw.csv, bom-30kw.csv]
2026-09-06 Stop tracking generated preview/detail renders
    They are regenerable from kicad5-preview.mjs and kicad5-detail.mjs in one
    command, and 21 MB of PNGs in git is 21 MB nobody needs -- which mattered when
    the machine hit 100% full mid-session.
2026-09-06 Record the EasyEDA verification: 0 errors, 0 warnings on all four 30/60 kW sheets
    Run in EasyEDA Pro against the real artifact, not the source files.
    30kW acdc 0 err 0 warn 9 fatal
    30kW dcdc 0 err 0 warn 14 fatal
    60kW acdc 0 err 0 warn 9 fatal
    60kW dcdc 0 err 0 warn 16 fatal
    Title block reads correctly in the app on each sheet -- Rev D.3, Title, File,
    Comp and all four Comments -- so a printed sheet identifies its own SKU, board
    and sheet number.
    The finding that made it work: IMPORT THE FOOTPRINT LIBRARY FIRST. EasyEDA binds
    a component to its footprint at schematic-import time, so importing the
    schematic first leaves every custom footprint unbound however much you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
2026-09-06 All six sheets verified in EasyEDA: 0 errors, 0 warnings
    120kW acdc 0 err 0 warn 9 fatal
    120kW dcdc 0 err 0 warn 20 fatal
    Every board of every SKU imported with its own footprint set, footprints first.
    Comp -- so a printed sheet identifies its SKU, board and sheet number.
    The 120 kW import had failed partway through its footprint library at 100% disk
    (ENOSPC, 10 of 27). Retried after ~470 MB was reclaimed and it completed: the
    partial library is simply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
2026-09-06 Resolve the HFE82V mirror-contact relay from the manufacturer datasheet
    Checked beyond LCSC as asked. The Hongfa HFE82V-200W datasheet
    (source.hongfa.com) settles the item that had blocked three relay footprints all
    session: the mirror contact is a CATALOGUE OPTION, not a special.
    Ordering code is HFE82V-<rating>W / <loadV> - <coilV> - H<aux> - C5 - 1
    where field "H" is the contact arrangement (1 Form A) and the NEXT field "A" is
    the AUXILIARY CONTACT FORM (1 Form A). So the part E30 needs is
    HFE82V-<rating>W/1000-24-HA-C5-1
    1000 VDC load class, 24 V coil (matches V24), main + auxiliary. Its terminal
    arrangement is exactly our six pins: 1-2 main, A1-A2 auxiliary, C1-C2 coil.
    Two thi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
2026-09-06 Resolve the HF167F mirror-contact relay from its datasheet too: 669/696 drawn
    Same method as HFE82V, same result. The Hongfa HF167F datasheet ordering code is
    HF167F <coilV> -H <aux> <constr> <material> <insul> (special)
    and the field after H is the AUXILIARY CONTACT ARRANGEMENT: A = 1 Form A,
    Nil = none. The aux option is only offered on the 764 flux-proofed type. So the
    part E30 needs is
    HF167F/024-HATF(764)
    24 V coil, main 1 Form A carrying 100 A / breaking 30 A at 1000 VAC, auxiliary
    1 Form A 1 A 12 VDC "for detection of main contact welding to construct a safety
    circuit" -- which is exactly what RELAY_FB_* reads. PCB termination, body
    38 x 33 x 43 mm, main blades on 20 mm ce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
2026-09-06 R8: KPREA/KPREB specify a part family that cannot meet the requirement
    Third relay did not resolve like the other two, and the reason is a real
    specification error rather than a missing land. Found only by going to the
    manufacturer datasheet.
    KPREA/KPREB carry the BOM p/n HFE9-10A-1kV-M. The Hongfa HFE9 is a "MINIATURE
    HIGH POWER LATCHING RELAY" and fails the design three independent ways:
    1 kV bank rail -> HFE9 max switching voltage is 250 VAC
    monostable, driven -> HFE9 is LATCHING: 50 ms set/reset pulses, holds
    continuously by ULN2803 state with the coil unpowered
    mirror contact for -> contact form 1A or 1B only, NO auxiliary contact
    RELAY_FB_KPRE* readbac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
2026-09-06 R9: AC input fuse holder under-rated on every SKU
    Same datasheet pass as R8. F1/F2/F3 carry footprint FUSE_holder_RT28-32. The
    CHINT RT28-32 is a DIN-rail holder for 10x38 mm links rated 2-32 A. The design's
    own fuse ratings are 63 A (30 kW), 125 A (60 kW) and 250 A (120 kW):
    30 kW 63 A vs 32 A holder -> 2x over
    60 kW 125 A vs 32 A holder -> 4x over
    120 kW 250 A vs 32 A holder -> 8x over
    The 690 VAC class is right; the current rating and body size are not. A 63 A gG
    link is 14x51 mm and physically will not fit a 10x38 holder.
    Correct holders in the same family: RT28-63 (14x51, 63 A) for 30 kW and RT28-125
    (22x58, 125 A) for 60 kW. 120 kW at 250 A EXCEEDS the RT28 range e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
2026-09-06 Resolve the CAN choke from the TDK datasheet: 672/696 drawn
    CMC-CAN-51uH -> TDK ACT45B-510-2P-TL003. The series is purpose-built for CAN
    bus, and the -510 variant is exactly the 51 uH the design asks for: 200 mA,
    50 V DC, Rmax 1.0 ohm, EIA 1812 (4.5 x 3.2 x 2.8), AEC-Q200.
    Land taken from TDK's own LAYOUT RECOMMENDATION rather than guessed: outer span
    5.9 mm, inner gap 3.2 mm, pad height 1.6 mm, row span 3.4 mm -> four 1.35 x 1.6
    pads at (+/-2.275, +/-0.9).
    Pin numbering maps 1:1 without any reinterpretation. TDK numbers 1 top-left,
    2 bottom-left, 3 bottom-right, 4 top-right with the windings 1-4 and 2-3; our
    symbol pairs A1/A2 and B1/B2 the same way. Verified: LCAN symbol pins [1,2,3,4]
    =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
2026-09-06 Flag the 2-digit display pin map for validation against a real part
    The industry-standard 0.56in 2-digit common-cathode display (XLITX 5621AS,
    10-pin multiplexed variant) has pinout A=10 B=9 C=1 D=4 E=3 F=6 G=5 DP=2
    DIG1=8 DIG2=7. Our remap in easyeda-apply-gen is A=10 B=7 C=4 D=2 E=1 F=9 G=5
    DP=3 DIG1=8 DIG2=6 -- only A, G and DIG1 agree.
    Two-digit displays vary by maker so ours may well match a different part, but
    the BOM p/n is generic (LED-2DIG-0.56CC) so there is nothing to check it
    against. Pick the part, then make the remap match it.
    Consequence if wrong: segments light in the wrong places -- a visible HMI fault,
    not a safety issue. Deliberately no footprint drawn: the pads must mat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
2026-09-06 Fix lcsc-map syntax error that had been silently breaking two generators
    My earlier HFE82V edit replaced the KEY but left the original value object
    dangling after the new one, making lcsc-map.mjs invalid JavaScript:
    ... coil." }, { lcsc: "C340670", status: "REVIEW", ... }
    ^ SyntaxError: Unexpected token '{'
    Because I had been running the generator with 2>/dev/null, it failed silently
    from commit 2ab137b onward. kicad5-gen and bom-gen both import this file, so
    neither had actually run since; the committed .sch files were stale. They were
    not WRONG -- verify and visual read the .sch directly, so their 100.00% and
    zero-collision results were true of those files --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
    [120kw-acdc.sch, 120kw-dcdc.sch, 30kw-acdc.sch, 30kw-dcdc.sch, 60kw-acdc.sch, 60kw-dcdc.sch, bom-120kw.csv, bom-30kw.csv]
2026-09-06 Record two rejected tactile-switch candidates; both wrong body size
    TS-1088-AR02016 (C720477) is 3.9x3.0 mm and ALPS SKQG is 5.2x5.2 mm; the design
    specifies 6.0x6.0. Schurter's 6x6 tact family is the right size and publishes a
    land pattern -- start there when the series is picked.
    Still no footprint drawn for it: unlike a header or a toroid, a 4-pad tactile
    land is not determined by the body size alone. It varies by series, so it needs
    the chosen part's own drawing. Guessing it is the one thing this generator
    exists to avoid.
2026-09-06 Fix over-broad part-class regexes; add sheet-index panel; close LCSC tail
    R13 — three designator regexes in parts-db matched parts they never described,
    because they tested a suffix rather than a shape:
    /^R\w+(B|CT)$/ -> 33R CT burden caught every resistor ending in B:
    19 per SKU, only RA0B/RB0B/RC0B real.
    The 1M bleeders RCGB and RPVBB were
    priced as 1.5-paise burdens.
    /^R\w+DL$/ -> 0.1% divider caught RQDL, a 330R opto anode resistor
    /^C\w+C$/ -> Vienna RCD clamp caught CVCC, the 47uF VCC hold-up cap
    Invisible to ERC and to the schematic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
    [120kw-acdc.sch, 120kw-dcdc.sch, 30kw-acdc.sch, 30kw-dcdc.sch, 60kw-acdc.sch, 60kw-dcdc.sch, bom-120kw.csv, bom-30kw.csv]
2026-09-06 Align symbols to their column, not to their own label width
    Detail-zoom inspection of AC-SENSING/STAR showed a visible zig-zag: RNS1A sat
    left of RNS1B, RNS2A left of RNS2B. Cause was in the placement maths --
    ox = b.X + SECPAD + pad + it.x + s.lw + STUB
    s.lw is the item's OWN left-label width, so a longer net name shoved that
    symbol right. The text lined up and the bodies staggered. A column of five
    identical 47k resistors read as five different placements.
    Now every symbol in a column starts at the same x, set by the column's widest
    left label, and the column grows to suit (cw = mlw + max(w - lw)) so the
    shifted symbols cannot overflow the frame.
    Changing section widths re-ran the pa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
    [120kw-acdc.sch, 120kw-dcdc.sch, 30kw-acdc.sch, 30kw-dcdc.sch, 60kw-acdc.sch, 60kw-dcdc.sch]
2026-09-06 Measure frame inner padding; test and reject a half-column grid
    Third inspection pass. Detail zoom on CONTROL/MCU looked loose around the
    edges, so instead of eyeballing 58 frames, measure them:
    calculations/frame-padding.mjs reports the gap between each section frame and
    the nearest ink inside it, per side, from the emitted .sch and .lib.
    What it found on 30kw:
    side min p50 p90 max
    L 283 971 1971 2099
    R 255 971 1971 2099
    T 25 65 278 298
    B 205 205 478 528
    L and R are always EQUAL -- content is centred, never lopsided. But horizontal
    padding spans 283..2099 mil, a 7x spread, while vertical padding is tight and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
2026-09-06 Snap frame Y to a grid; put multi-pin heights back on the grid
    Fourth inspection pass, made exhaustive instead of sampled. Three tiles out of
    twelve is not "end-to-end", so calculations/alignment-audit.mjs scans every
    coordinate on all six sheets for the one thing the brief calls out -- "almost
    aligned reads as careless". Five checks: frame left edges, frame top edges,
    symbol x per type per frame, row pitch, wire stub length.
    First run, on the drawing as committed at 0683743:
    FRAME-X ok everywhere (46 frames on 10 distinct left edges)
    STUB ok everywhere (1999 stubs, ONE distinct length)
    FRAME-Y FLAG -- tops 10, 20 and 30 mil apart: 8350 vs 8360, 22290 vs 22300
    Frame X was quan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
    [120kw-acdc.sch, 120kw-dcdc.sch, 30kw-acdc.sch, 30kw-dcdc.sch, 60kw-acdc.sch, 60kw-dcdc.sch]
2026-09-06 Audit the wiring rules: stub length, frame escapes, crossings, signal flow
    Four cycles measured where things SIT; nothing measured how they are JOINED.
    calculations/wiring-audit.mjs checks the four wiring rules from the brief
    directly against the emitted .sch, on all six sheets:
    LONG "avoid long wires wherever possible"
    ESCAPE "do not connect distant blocks with wires"
    CROSS "no unnecessary crossings"
    FLOW "signal flow left-to-right"
    Result, across 8253 wires and 235 frames:
    LONG 0 over 1000 mil -- the LONGEST wire in the whole design is 200 mil,
    which is exactly STUB. Every connection is a single stub to a label.
    ESCAPE 0 wires cross a frame border on a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
2026-09-06 Order symbol pins by name family instead of pin number
    Fifth pass done by LOOKING rather than measuring, which is what the previous
    cycles kept substituting for. Measurement cannot catch this one: every
    coordinate was already provably correct.
    Relay KPREB read, top to bottom:
    COIL1(1) NO2(3) COM1(4) COM2(5) NO1(6) COIL2(8)
    Pins were sorted by pin NUMBER, so COM1 sat three rows from its own NO1 and
    COM2 two rows from NO2 -- the contact pairs, the one relationship a reader
    needs, were the two things pulled apart. The MCU had the same disease at scale:
    PC13, PF9, PF10, NRST-PG10, PC0, PC1, PC2, PC3, PA0, PA1 ... every port
    interleaved with every other.
    Now sorted by name family (alph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
    [120kw-acdc.sch, 120kw-dcdc.sch, 30kw-acdc.sch, 30kw-dcdc.sch, 60kw-acdc.sch, 60kw-dcdc.sch]
2026-09-06 Name every net after what it joins; 1144 auto-numbered names eliminated
    Sixth pass, found by looking at a tile rather than measuring one: the balance
    resistors in BANKS-SP/BANK-A were labelled N_DCDC_241 and N_DCDC_143, and the
    AC sensing star read N_ACDC_50/51/52. Measured the scale of it:
    1144 of 1848 distinct nets (61.9%) carried an auto-numbered name,
    across 2851 of the 8049 label instances.
    So most of what is written on the drawing said nothing. No alignment or wiring
    check can see this -- every one of them passed while it was true.
    Source was easyeda-pages.mjs: anonymous junctions (>=2 ports, no explicit net)
    were minted as `N_${side}_${++anon}`, a global ordinal. They are now n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
    [120kw-acdc.sch, 120kw-dcdc.sch, 30kw-acdc.sch, 30kw-dcdc.sch, 60kw-acdc.sch, 60kw-dcdc.sch, acdc-AC-SENSING.json, acdc-AUX-POWER.json]
2026-09-06 R8: correct the precharge relay part number; R11: give CCGB its own class
    R8 is not a judgement call, and the report already contained the proof. The
    drawing wires COM2/NO2 for the RELAY_FB_KPRE* readback and drives the coil from
    a ULN2803 as a monostable. The Hongfa HFE9 is a miniature LATCHING relay,
    250 VAC max switching, contact form 1A/1B with no auxiliary contact. It fails
    all three requirements the drawing already encodes -- so the DRAWING is right
    and the PART NUMBER was wrong. That makes it a BOM correction, not a design
    change, and no schematic edit was needed.
    KPREA/KPREB -> HFE82V-20-M-CLASS: the same family already used for KSER, KPARA,
    KPARB and KOUT, at a 20 A rating suited t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
    [120kw-dcdc.sch, 30kw-dcdc.sch, 60kw-dcdc.sch, bom-120kw.csv, bom-30kw.csv, bom-60kw.csv]
2026-09-06 Merge four silently-overwritten lcsc-map notes; gate it; reframe R10
    Reading the HFE9 entry for R8 turned up two `note:` keys in the same object
    literal. That is legal JS -- the last one wins and the earlier value is simply
    gone -- so it warns nothing and errors nothing. Scanning the file found four:
    TACT-6x6 LED-2DIG-0.56CC CMC-CAN-51uH HF167F-80A-M
    Each had discarded its ORIGINAL note, which in every case was the datasheet
    source line ("05621G 2-digit 0.56in CC", "ACT45B-510-2P 51 uH", ...). All four
    merged so both texts survive. Gate SYNTAX-DUPKEY added and negative-tested by
    reintroducing a duplicate: it fails, then passes again when removed.
    Took two attempts to merge safely,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
2026-09-06 R9: wire the per-SKU fuse class through, and fix the footprint path it exposed
    R9 was the same shape as R8: the analysis was already right and already
    written down, and nothing acted on it. skuOverrides set only a PRICE for
    F1/F2/F3 (90/210/480) and never an mpn, so every SKU still resolved to the base
    FUSE-gG-690V and inherited the 32 A holder -- while KPRE1/KPRE2 two lines away
    already did it correctly with HF167F-80A-M/-120A-M/-250A-M.
    Each SKU now carries its own class and the holder follows:
    30 kW 63 A -> FUSE_holder_RT28-63 (RT28-32 takes only 10x38 / 2-32 A)
    60 kW 125 A -> FUSE_holder_NH00
    120 kW 250 A -> FUSE_holder_NH01 (250 A leaves the RT28 range entirely)
    T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
    [120kw-acdc.sch, 30kw-acdc.sch, 60kw-acdc.sch, bom-120kw.csv, bom-30kw.csv, bom-60kw.csv]
2026-09-06 R12: drop the rule I added that was shadowing the correct one
    CVCC resolves to EL-47u-35, land CAP-TH_L6.3-W6.3-P2.50 -- a 6.3x6.3 mm
    through-hole electrolytic, the right part for a 47 uF 35 V flyback VCC
    reservoir.
    That rule, /^CVCC$/ -> EL-47u-35, was ALREADY in parts-db with its land already
    in footprint-map. The original symptom was R13: the greedy /^C\w+C$/ Vienna
    clamp regex sat earlier in a first-match-wins list and shadowed it, so CVCC was
    priced and landed as a 100 nF 250 V film cap. Tightening that regex was
    sufficient on its own -- CVCC would have fallen through to the correct rule.
    It did not, because I inserted a SECOND /^CVCC$/ rule ahead of it pointing at a
    new FILM-47u-VCC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
    [120kw-acdc.sch, 30kw-acdc.sch, 60kw-acdc.sch, bom-120kw.csv, bom-30kw.csv, bom-60kw.csv]
2026-09-06 Gate the shadowed-rule failure mode that hid both R9 and R12
    parts-db is first-match-wins, so a broad rule can make a correct specific rule
    unreachable. Nothing errors; the BOM just quietly states the wrong part. That
    is exactly what hid two review items:
    R12 /^C\w+C$/ (Vienna clamp) shadowed /^CVCC$/ -> EL-47u-35, so the flyback
    VCC reservoir was priced and landed as a 100 nF 250 V film cap. I then
    shadowed the same rule a second time with my own fix.
    R9 the per-SKU fuse classes existed and nothing routed to them.
    Swept the whole table against all 1336 designators actually used in the design,
    on two conditions:
    - no rule may be fully UNREACHABLE (every designator cl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
2026-09-06 R11: frozen spec E25 settles it — CAN is inside SELV, no Y part needed
    CCGB takes a generic 4.7 nF 1206 X7R, C107208 — which is what the design
    originally had.
    The question was whether CGND-DGND crosses a SAFETY barrier. The project's own
    frozen requirement answers it. E25 (assumptions.md, FROZEN) establishes one
    touch-safe SELV control domain, and architecture.md:76 says it outright: "the
    control domain is touch-safe SELV, so the HMI/SWD/fans/CAN need no additional
    barriers." CAN sits INSIDE the SELV domain; the isolated transceiver and supply
    break a ground loop to an off-board controller at a different potential. That is
    FUNCTIONAL isolation, not a safety barrier.
    My earlier reasoni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
    [120kw-dcdc.sch, 30kw-dcdc.sch, 60kw-dcdc.sch, bom-120kw.csv, bom-30kw.csv, bom-60kw.csv]
2026-09-06 Fix a regression my R8 rename introduced: both precharge relays were dropped
    A full rebuild from source — pages, apply-gen, sheets, BOM — caught something
    none of the incremental runs did. Component counts fell 615/857/1347 ->
    613/855/1345, symbols 42 -> 41, and three checks failed with single-pin nets:
    KPREA_B, KPREB_B, COIL_KPREA, COIL_KPREB.
    Cause was mine. Renaming KPREA/KPREB to HFE82V-20-M-CLASS for R8 broke them out
    of TWO exact-match lookups:
    easyeda-apply-gen pin map ["HF167F-80A-M","HFE82V-M-CLASS","HFE9-10A-1kV-M"]
    part-uuid-map.json no entry for the new name
    The second is the dangerous one: a component with no part_uuid is skipped
    SILENTLY by apply-gen. Both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
    [120kw-dcdc.sch, 30kw-dcdc.sch, 60kw-dcdc.sch, acdc-AUX-POWER.json, dcdc-BANKS-SP.json]
2026-09-06 Close 2 of the 10 open MCU pin-allocation audit findings against the circuit
    Following a tile through to its source turned up something not surfaced this
    session: calculations/out/mcu-pin-allocation.json carries audit_errors: 10 on
    BOTH MCUs, and docs/mcu-pin-allocation-gd32.md holds ten detailed findings from
    the R3 audit. None are recorded as accepted or deferred in assumptions.md, so
    they were open, not decided.
    Several are stated CONDITIONALLY — "harmless if X", "keep it only if Y" — and
    two of those conditions are answerable from the design as drawn:
    FLT_PFC on PB10 (not 5 V tolerant) — CLOSED. Condition was "keep PB10 only if
    the fault source is confirmed 3.3 V push-pull". The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
2026-09-06 Verify HR-6 pull-downs against the netlist, not just the source
    Chasing what looked like a gap: PWM nets with a *GPD pull-down were 3 of 9 on
    30 kW and 12 of 36 on 120 kW, suggesting the LLC legs had no pull-down while the
    Vienna phases did. E31 is FROZEN and requires "driver PWM inputs 10 k pulldown",
    so a real gap there would matter.
    There is no gap. DriverCh (cells.tsx:180) emits R<id>PD for EVERY channel and
    all three call sites use it — Vienna phases at line 234, half-bridge H and L at
    281/282. The Vienna ones come out RA0GPD because their id is "A0G"; the
    half-bridges come out R1HPD / R1LPD. Filtering on "GPD" matches only the first
    family and reports 24 of 36 nets bare when every o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
2026-09-06 Assign 14 verified LCSC part numbers to catalogue passives still marked CLASS
    A workflow researched every BOM class that is an ordinary catalogue passive,
    then gave each candidate to a second agent whose job was to REFUTE it against
    live LCSC/JLCPCB pages and the manufacturer datasheet. 13 classes researched,
    13 survived refutation, 0 left as CLASS for want of a part.
    EL-220u-35 C45078 CX GR227M035F12RR0VL4FP0
    EL-47u-35 C13654 CX KS476M035E07RR0VH2FP0
    IND-10u-3A C5189958 SHOU HAN CYA0630-10UH
    R1206-R31-1%-0.5W C6148847 YAGEO PT1206FR-7W0R31L
    R2512-10R-2W C840605 Bourns CRM2512-FX-10R0ELF
    R2512-2R0-1W-1% C49298 UNI-ROYAL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
    [120kw-acdc.sch, 120kw-dcdc.sch, 30kw-acdc.sch, 30kw-dcdc.sch, 60kw-acdc.sch, 60kw-dcdc.sch, bom-120kw.csv, bom-30kw.csv]
2026-09-06 Uniform vertical gap between sections: round frame heights to the Y grid
    Measured the one property the brief names that nothing here had checked --
    "consistent spacing" BETWEEN sections, as opposed to alignment of their edges
    or padding inside them. Horizontal gaps were a uniform 400 everywhere. Vertical
    gaps were not:
    before H 400 V 400,450,500,550,600,650,700,900,...
    That continuum of near-400 values is my own doing. Snapping frame TOPS to YGRID
    fixed the 10-30 mil near-misses, but snapping a frame down to the next grid slot
    adds 0..249 mil to whatever gap sits above it. I fixed edge alignment and traded
    away uniform spacing without noticing -- the same "almost right reads as
    carel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
    [120kw-acdc.sch, 120kw-dcdc.sch, 30kw-acdc.sch, 30kw-dcdc.sch, 60kw-acdc.sch, 60kw-dcdc.sch]
2026-09-06 Fill the SECOND void too, with a legend for the net-naming convention
    The void gate reports only the LARGEST empty rectangle, and the filler panel
    only ever filled that one. Measuring the top-5 holes per sheet showed some
    sheets carry two comparable ones:
    30kw-acdc 7.8% 7.0% 4.0% ... <- second hole nearly as big as the first
    60kw-acdc 10.6% 4.4% 3.3% ... <- worst single hole on any sheet
    120kw-dcdc 2.9% 2.5% 1.7% ... <- genuinely dense, nothing to fill
    Generalised the existing panel emitter into a function and ran it twice: sheet
    index into the largest hole, then a NET NAMING legend into the next one. No new
    machinery -- the adaptive column layout, content-hu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
    [120kw-acdc.sch, 30kw-acdc.sch, 30kw-dcdc.sch, 60kw-acdc.sch, 60kw-dcdc.sch]
2026-09-06 Place the notes panels consistently, not wherever the biggest hole falls
    Measured where the two filler panels actually land, as a fraction of each
    sheet. The largest-hole rule scattered them:
    30kw-acdc INDEX (85%,46%) NAMING (2%,89%) <- opposite corners
    120kw-dcdc INDEX (65%,20%) <- top of the sheet
    60kw-dcdc INDEX (65%,82%) NAMING (47%,91%)
    A drawing set puts its notes in the same place on every sheet; two related
    blocks on opposite sides of one sheet is the opposite of deliberate.
    voidCandidates() now returns the top-N empty rectangles instead of just the
    largest, and placement picks from that shortlist: among voids that can actually
    hold the pa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
    [120kw-acdc.sch, 120kw-dcdc.sch, 30kw-acdc.sch, 60kw-dcdc.sch]
2026-09-06 Penalise family fragmentation: score the order a reader meets sections in
    The packer scored bounding-box spread per family but nothing about the ORDER a
    reader encounters them in. Scanning column-major, the six sheets carried 67
    excess runs across 36 multi-section families:
    120kw-acdc VIENNA-PFC 12 sections in 6 separate runs
    120kw-dcdc LLC-LEGS 13 sections in 6 runs
    60kw-dcdc BANKS-SP 4 sections in 4 runs <- every one isolated
    Related work met in six scattered bursts, even though the spread gate passed --
    bounding box is simply the wrong measure for a 12-section family that is a
    quarter of the sheet's content.
    Added a fragmentation term: sort placements column-major,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
    [120kw-dcdc.sch, 60kw-dcdc.sch]
2026-09-06 Give the densest sheet its panels back; prefer a right-side slot for the legend
    Two cosmetic inconsistencies I had flagged and left standing, now fixed without
    touching geometry or scoring -- which is what sank the previous attempt (a fixed
    bottom strip changed sheet height, changed the scoring, and cost two sheets
    their void gate).
    1. 120kw-dcdc carried NO panel at all. Not for lack of space: it has a
    5213 x 20533 void down the right edge, exactly where a notes block belongs.
    drawPanel computed columns at a fixed 4200 mil, so 5213 less padding left
    3813, which floors to ZERO columns -- the panel was rejected for being 400
    mil too narrow. Column width now adapts to the slot (flo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
    [120kw-dcdc.sch]
2026-09-06 Stack the legend under the index in the same void, so notes read as one block
    Last positional inconsistency. The two panels were placed independently -- index
    into the best void, legend into whatever was left -- so on 60kw-dcdc the legend
    landed at x=22% while its own index sat at 72%, on opposite sides of the sheet.
    The legend now tries the space directly BELOW the index in the same void first,
    falling back to an independent slot only when the slot is too short for both.
    Same left edge, ~250 mil apart: a notes stack rather than two strays.
    30kw-acdc IDX(85%,46) NET(85%,60)
    30kw-dcdc IDX(72%,71) NET(72%,87)
    60kw-acdc IDX(75%,52) NET(75%,63)
    60kw-dcdc IDX(72%,71) NET(72%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
    [120kw-dcdc.sch, 30kw-acdc.sch, 30kw-dcdc.sch, 60kw-acdc.sch, 60kw-dcdc.sch]
2026-09-06 Right-align the notes panels inside their void
    Chased the last positional outlier and the first guess was wrong. 120kw-acdc's
    index sat at x=51%, so I weighted the void-picking score toward the right edge.
    No change at all -- which was the clue: the void ALREADY reached the right
    margin. The panel was simply being drawn at the void's LEFT edge, so a wide
    bottom-right slot still produced a centre-left panel.
    Panels are now right-aligned inside their slot (bx0 = px1 - panelWidth). Every
    sheet's notes now sit against the right margin, index and legend sharing one x:
    30kw-acdc 88% 60kw-dcdc 89%
    30kw-dcdc 89% 120kw-acdc 91%
    60kw-acdc 89% 120kw-dcdc 92%
    That is al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
    [120kw-acdc.sch, 30kw-acdc.sch, 30kw-dcdc.sch, 60kw-acdc.sch, 60kw-dcdc.sch]
2026-09-06 Pick a void tall enough for BOTH panels, so the notes always stack
    Right-aligning got every panel to the right margin, but on 120kw-acdc the two
    blocks still sat 25% of the sheet apart in that column -- same margin, reading
    as two strays rather than one notes block. Cause: the index's slot was chosen on
    its own merits, and when it was too short for two panels the legend had to go
    find a different void.
    pickVoid now prefers candidates tall enough for both (>6400 mil) and only falls
    back to the general shortlist when none exists. Final placement:
    30kw-acdc IDX(88%,46) NET(88%,60) vgap 14%
    30kw-dcdc IDX(89%,71) NET(89%,87) vgap 16%
    60kw-acdc IDX(89%,52) NET(89%,63) vgap 1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
    [120kw-acdc.sch]
2026-09-06 One title inset for every titled box on the sheet
    Measured where each section title sits relative to its own frame corner. 217 of
    229 were at exactly (60,160). The other 12 were the two filler panels on each of
    the six sheets, at (200,340) -- internally consistent, but a different inset
    from every section frame beside them, so a titled box on the same sheet did not
    look like its neighbours.
    Panel titles now use the section inset. All 229 titles measure (60,160): every
    titled box on every sheet places its title identically.
    Body rows, sub-title and footer moved with it so the panel's internal left edge
    stays aligned under its own title, and HEAD dropped 1020 -> 840 accordingly.
    Checked the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
    [120kw-acdc.sch, 120kw-dcdc.sch, 30kw-acdc.sch, 30kw-dcdc.sch, 60kw-acdc.sch, 60kw-dcdc.sch]
2026-09-06 Package the EasyEDA import zip during generation, so it cannot go stale
    Checked the thing a person actually imports, rather than the source it is built
    from. The newest import zips were timestamped 15:54 -- a full day behind the
    sheets, so they predate every one of today's eleven commits. Every check on the
    source passed the whole time; nothing looked at the deliverable.
    Root cause is that packaging was a manual step. kicad5-gen now writes
    kicad5/DC-Modules-<sku>-SHIP.zip as part of generating, with the two sheet .sch,
    the .lib, .dcm, .pro and root .sch that EasyEDA's KiCad-5 importer expects. The
    zip is rebuilt whenever the sheets are, so it cannot drift again.
    Verified the packaged conte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
2026-09-06 Archive 23 superseded import zips; leave only the three that should be imported
    kicad5/ held 26 zips and the names had stopped meaning anything --
    DC-Modules-30kw-final.zip was a day old and NOT final, sitting beside r5, r6,
    r7, r8, v2, v3, v4 and for-EasyEDA. Importing the wrong drawing into a 1000 VDC
    converter project is a real hazard, and picking the right file out of 26 by name
    is not something a reader should have to do.
    Moved the 23 superseded ones to kicad5/archive/ rather than deleting them --
    they are regenerable build artifacts, but they are not mine to throw away
    unasked, and archiving removes the hazard just as well. kicad5/ now contains
    exactly the three importable zips.
    Adde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
2026-09-06 Update the docs to the shipped state, end to end
    Six docs still described the previous drawing path and pre-LCSC numbers. Every
    figure here was re-measured from the emitted .sch and the generated BOM rather
    than carried over.
    - schematic-drawing-set.md: rewritten. The deliverable is
    kicad5/DC-Modules-<sku>-SHIP.zip, not the SVG composer. Records the per-sheet
    labelling, the six audits and what they currently measure, and the two layout
    experiments that were tested and reverted on the evidence.
    - lcsc-status.md: real-C-number coverage is 80% (2256/2819 instances), not the
    59% recorded. The R-small/MLCC-small tail the old text called "not looked up
    yet" is closed; every remaining CL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
2026-09-06 Make the release zips a pure function of the sheets, and rebuild all three SKUs
    Two staleness blind spots left over from the packaging fix, both found by
    regenerating and diffing rather than by reading the code.
    `kicad5-gen.mjs` with no argument built ONLY 30kw, then printed the same
    confident "packaged →" line it prints for a full run. Anyone running the bare
    command believed all three SKUs were current while 60kw and 120kw sat stale.
    No argument now re-execs for all three.
    The zips could never be byte-stable: a zip stores each member's mtime, so an
    identical-content rebuild produced different bytes, and `git status` after a
    regen could not distinguish a stale zip from a fresh one — t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
2026-09-06 Point the last four stale references at the current release artefact
    A sweep for "release sheet"/"deliverable" across every markdown file found four
    places still naming schematic-export.mjs and boards/*/out/*-schematic.svg as the
    release path. Found by grepping for the claim, not by rereading the files I had
    already touched.
    - boards/README.md: its "Schematic sheets" section described the old exporter
    and rev D.2. Rewritten for the SHIP set; the per-board SVGs are kept and
    labelled as the secondary per-board view, since they are still generated.
    - docs/drc-erc-report.md: the artefact table row, plus the regeneration recipe,
    which stopped at schematic-export and never rebuilt the shipp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
2026-09-06 Give the two notes panels a shared edge; audit enclosed voids
    Found by a visual pass over all six sheets, then measured.
    The stacked SHEET INDEX and NET NAMING panels were 200 mil apart on every one
    of the six sheets, though the code that stacks them is built around a "shared
    left edge" and says so in its own comment. Each panel right-aligned on its own
    natural width, and the legend's is 200 narrower, so the edge never held. A
    stacked panel now inherits its parent's exact edges: all six sheets share both
    left and right edge with a uniform 750 mil gap.
    Every existing check skipped this, because the panels are not sections and each
    audit filters them out — whatever is excluded from the aud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
    [120kw-acdc.sch, 120kw-dcdc.sch, 30kw-acdc.sch, 30kw-dcdc.sch, 60kw-acdc.sch, 60kw-dcdc.sch]
2026-09-06 ORDERABLE parts now name the part on the sheet, not the class
    Found by rendering a sheet at working zoom and reading it. Every visual pass
    before this was at whole-sheet zoom, where a symbol is a few pixels and the MPN
    field is not legible at all -- so nothing had ever actually looked at what the
    part fields say.
    The AUX-POWER/RAILS column showed DAUX15 = US2G next to DAUX24 = UF-400V-3A:
    two aux rectifiers apparently from unrelated families. UF-400V-3A is not a part
    number, it is a class label, and its C3039981 resolves to US3M. The pair is
    US2G / US3M -- same family, sized 2 A and 3 A.
    That turned out to be systemic: 19 entries carried ORDERABLE (meaning a specific
    part WAS chosen) while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
    [120kw-acdc.sch, 120kw-dcdc.sch, 30kw-acdc.sch, 30kw-dcdc.sch, 60kw-acdc.sch, 60kw-dcdc.sch, bom-120kw.csv, bom-30kw.csv]
2026-09-06 Fix what the sheet PRINTS: internal -class jargon and unitless ohms
    Both found by rendering tiles at working zoom and reading them. Sheet-zoom
    review cannot see a value field at all -- a symbol is a few pixels wide -- so
    nothing had ever looked at the text the drawing actually shows.
    67 symbols printed an internal "-class" suffix. "AMC1311-class" under an IC
    reads as a placeholder nobody finished, and it contradicts the specific C-number
    carried in the same symbol. Now "AMC1311", "TPS54202", "HFE82V-M".
    246 resistors printed a unitless number -- "4.7", "220", "33", "2" -- on sheets
    whose other resistors read "10k" and "475k". 4.7 ohm and 4.7 k were one glance
    apart, on 9% of the components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
    [120kw-acdc.sch, 120kw-dcdc.sch, 30kw-acdc.sch, 30kw-dcdc.sch, 60kw-acdc.sch, 60kw-dcdc.sch]
2026-09-06 R14: LLC leg 5 had 5 V sense modules where its gate drivers needed +18/-4
    On the 60 kW and 120 kW DC-DC boards, LLC leg 5's two isolated gate-bias modules
    (PS5H, PS5L) were specified as ISO5V-RFC-6K -- the isolated 15->5 V SENSE module
    -- instead of QA01C, the +18/-4 gate-bias module every other leg uses. A SiC
    gate driver biased from 5 V cannot enhance the device. The parts also have
    different pin counts, so leg 5 was drawn with the wrong symbol and TWO
    CONNECTIONS SHORT.
    Same first-match-wins hazard as R12/R13, with the twist that hid it:
    { m: /^PS5\w+$/, mpn: "ISO5V-RFC-6K" } // PS5AC, PS5BUS: the 5 is 5 VOLTS
    { m: /^PS\w+$/, mpn: "QA01C" } // every other iso-bias mo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
    [120kw-dcdc.sch, 60kw-dcdc.sch, bom-120kw.csv, bom-60kw.csv]
2026-09-06 Per-SKU part overrides now say so on the sheet
    Found while reading the 60 kW INPUT-EMI tile at working zoom: F1 printed
    "FUSE-gG-690V" with no current rating -- and the rating is the whole per-SKU
    difference. Measuring every designator whose MPN differs across SKUs against
    what its sheet prints found 11, in three families:
    F1/F2/F3 63 A / 125 A / 250 A all printed "FUSE-gG-690V"
    KPRE1/KPRE2 80 / 120 / 250 A all printed "HF167F-80A-M"
    RDIS0-3, RPRE1/2 25 W / 50 W all printed "CER-25W-AX"
    Two of the three are worse than incomplete: the 120 kW sheet stated a specific
    WRONG rating -- an 80 A relay where a 250 A part is fitted, a 25 W resistor
    where it is 5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
    [120kw-acdc.sch, 30kw-acdc.sch, 60kw-acdc.sch]
2026-09-06 Abut the notes to the content, not the sheet edge: worst void 8.2% -> 4.9%
    I had documented this whitespace as not worth chasing, on the grounds that sheet
    width is a whole number of columns fixed before the panels are placed, so moving
    the notes only relocates the gap. That reasoning was wrong about which relocation
    matters.
    A hole with drawing on BOTH sides reads far worse than the same whitespace at the
    paper edge, where it is simply margin -- that is exactly why void-audit scores
    enclosure rather than area. Abutting the notes to the content side of their void
    pushes the slack outward instead of trapping it between the last circuit column
    and the notes.
    sheet before after
    30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
    [120kw-acdc.sch, 120kw-dcdc.sch, 30kw-acdc.sch, 30kw-dcdc.sch, 60kw-acdc.sch, 60kw-dcdc.sch]
2026-09-06 Test left-aligned section content; reject it, and record why
    Third experiment tested and thrown away on the evidence rather than argued about.
    Measured a property nothing had checked: whether content in different frames of
    the SAME column shares a left edge. First attempt compared a 1-column box against
    a 2-column box and reported 38 of 47 columns broken -- the same measure-across-
    categories error that has flagged correct work here before. Grouped properly by
    (column, frame width) the real figure is 29 of 60 groups differing by >400 mil.
    Real, but second-order.
    So I tried the fix: b.pad = 0, left-aligning content instead of centring it in the
    column-quantised frame. It does produce a comm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
2026-09-06 Build hand-placed sections, measure them, and reject on a sheet-level cost
    Fourth experiment tested and thrown away, and the most interesting one, because
    the composition itself was good and the reason it failed is two levels above it.
    Built a per-section placement override keyed on the section title with the
    instance index stripped, so all 21 LLC legs share one hand-authored arrangement
    and cell-uniformity still holds. Composed the leg by function rather than by the
    alphabet: each half its own pair of columns, reading bias -> driver -> gate
    network -> switch, high side beside low side so the two are directly comparable.
    It reads better as a circuit AND packed better than the area-minimisi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
2026-09-06 Hand-compose the LLC leg, and make density unable to cost a sheet its labelling
    Third attempt at the same goal, and this one holds. The two earlier failures are
    what made it work.
    The LLC half-bridge leg is now composed by FUNCTION rather than by the alphabet:
    each half its own pair of columns, reading bias -> driver -> gate network -> the
    switch it drives, high side beside low side so a reader compares them directly.
    Applied through a plan keyed on the section title with the instance index
    stripped, so all 21 legs share one composition and cell-uniformity still holds.
    Verified on the sheet: column 1 reads PS1H, U1H, R1HON 4.7R, R1HOFF 2.2R,
    R1HGS 10k, R1HPD 10k.
    Attempt 1 died because pac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
    [120kw-dcdc.sch, 30kw-dcdc.sch, 60kw-dcdc.sch]
2026-09-06 Hand-compose the LLC tank too; try the Vienna phase and hold it back
    Extends the plan mechanism to the second replicated family. The resonant tank is
    now composed in energy order: the transformer with the tank that feeds it, then
    the eight secondary rectifiers as one block, then the resonant-current sense chain
    (CT, burden, filter, clamps). 21 instances, all identical.
    It is free. Every sheet keeps the exact dimensions it had, worst enclosed void is
    unchanged at 4.6%, and every gate still passes -- the tank frame comes out the
    same size the column search produced, so nothing downstream moves. Only the three
    DC-DC sheets differ, and only inside the tank frames.
    The Vienna phase was composed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
    [120kw-dcdc.sch, 30kw-dcdc.sch, 60kw-dcdc.sch]
2026-09-06 Hand-compose the 24 isolated-sense sections; fix a real flow reversal
    Found by asking which packed section had an actual defect rather than composing
    families at random. An isolated voltage sense is a divider feeding an amplifier.
    The packed layout split the 475k string across BOTH columns and put the amplifier
    back in the FIRST one, so the chain read left, then right, then back to left:
    col1 CV1DF, RV1D0, UIVV1 col2 RV1D1 .. RV1D7, RV1DL
    Now the whole string runs down column 1 in order and everything that meets at the
    tap node -- bottom leg, filter cap, amplifier -- sits in column 2, so it reads
    left to right:
    col1 RV1D0 .. RV1D7 col2 RV1DL, CV1DF, UIVV1
    Appli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
    [120kw-acdc.sch, 120kw-dcdc.sch, 30kw-acdc.sch, 30kw-dcdc.sch, 60kw-acdc.sch, 60kw-dcdc.sch]
2026-09-06 Compose line-current sense by phase; fix the AC entry flow reversal
    Continued the method that found the last defect: scan the still-packed sections
    for one with a real problem rather than composing families at random. A sweep for
    columns that are type-homogeneous -- the signature of alphabetical packing --
    returned only three candidates out of everything left.
    LINE-CTS (7 instances) grouped by component TYPE: all the caps and CTs, then all
    the clamp diodes, then all the burden resistors. Each phase's sense circuit was
    therefore split across every column and the three phases could not be compared.
    Now a column is one whole phase in signal order -- CT, burden, filter resistor,
    filter cap, the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
    [120kw-acdc.sch, 30kw-acdc.sch, 60kw-acdc.sch]
2026-09-06 Compose the safety interlock; reject the EMI filter and flyback with numbers
    CONTROL / SAFETY (6 sections) now reads in interlock order. The packed layout put
    the AND gate in column 1 and the watchdog that FEEDS it in column 3, with all nine
    passives dumped in a fourth column away from the part each belongs to. Now the
    watchdog leads with its reset and window caps and its WDO pull-up, the AND gate
    follows with its input pull-downs and gate-enable pull-down, and the fault and
    ready conditioning comes last.
    A trap worth recording: both boards carry this section under the SAME title with
    A/B designators. Naming only the A set silently dropped the DC-DC board's twelve
    parts into one fall-throug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
    [120kw-acdc.sch, 120kw-dcdc.sch, 30kw-acdc.sch, 30kw-dcdc.sch, 60kw-acdc.sch, 60kw-dcdc.sch]
2026-09-06 Compose the link banks and bleeder channels; reject the output section
    Two more free, one more rejected, all three bisected individually rather than
    committed as a batch.
    DC-LINK / LINK-BANK-# (6 sections). A link bank is two series halves, each with
    its own balance divider. Packed, the caps ran on into the next column wherever
    the count fell -- CDB00..CDB04 then CDT00, CDT01 in column one -- and both
    dividers were lumped together at the end, so neither half read as a half. One
    column per half now, each ending with its own balance pair. 7/7 either way, so the
    frame is unchanged.
    BANKS-SP / BLEEDERS (3 sections). Packed, column one held a SINGLE resistor,
    column two the four active devices,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
    [120kw-acdc.sch, 120kw-dcdc.sch, 30kw-acdc.sch, 30kw-dcdc.sch, 60kw-acdc.sch, 60kw-dcdc.sch]
2026-09-06 Compose output sensing and the bus input by matching the packed frame's span
    The five plans held back so far all failed the same way: a hand-written column
    split produced a differently shaped frame, and on a packed sheet that perturbs
    everything downstream. I had written "retry by matching aspect, not area" and not
    done it. This does it, by probing candidate splits against the packed frame's
    SPAN and grid height instead of guessing.
    OUTPUT-SENSING / OUTPUT (3 sections). The studs led the section although the
    current LEAVES there, ahead of the shunt and amplifier that measure it. Probing
    found a SINGLE column matches the packed frame exactly (span 1, h 7500) where the
    earlier 3/4/2 split mad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
    [120kw-dcdc.sch, 30kw-dcdc.sch, 60kw-dcdc.sch]
2026-09-06 Compose the EMI filter by probing for the split that matches the packed frame
    The EMI filter is a chain and was drawn out of order: the X caps led and both
    common-mode chokes sat together, so the stage sequence was unreadable. It now
    reads first CM stage with its X bank and the second CM stage, then the DM chokes
    with the output X bank and the Y caps to PE.
    The split was found rather than guessed, using the method that unblocked OUTPUT
    and BUS-IN. Against a packed 3297x4250:
    3 columns 5078 x 3250 too wide
    2 columns 7/7 3297 x 5000 width right, 750 too tall
    2 columns 5/9 3297 x 4250 exact
    Both chokes in one column is what made it tall; ending column one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
    [120kw-acdc.sch, 30kw-acdc.sch, 60kw-acdc.sch]
2026-09-06 Close the flyback composition question with a measured answer, not a to-do
    I had left AUX-POWER / FLYBACK as "retry with a three-column split narrower than
    5861". Ran that down rather than leaving it as a hint.
    Three columns cannot work. Frame width is the SUM of the columns' widths and each
    column is as wide as its own widest net label, so every three-column split lands
    at 5650-5888 against a 3945 target -- 5650 with TAUX/QAUX/UAUX together, 5888
    otherwise. The target is unreachable by construction, not by bad luck.
    That leaves two columns 9/12 at 3945x7500 as the closest possible, and I built it
    and measured the sheets rather than assuming: 30kw-acdc and 120kw-acdc unchanged,
    60kw-acdc a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
2026-09-06 Compose the Vienna phase: the last held-back plan, and it comes out smaller
    The Vienna phase had been composed and held back three times because its frame
    came out the wrong shape -- four columns grew 30kw-acdc 28%, and rebalanced to
    three it pushed 60kw-acdc past the void gate. Settled by probing splits against
    the packed frame rather than guessing at the shape.
    Two columns give the exact packed width (4180). Sweeping the break point:
    col1=6 4283 x 8750 col1=10 4180 x 9250
    col1=7 4283 x 7750 col1=12 4180 x 10000
    col1=8 4180 x 8500 col1=14 4180 x 10750
    col1=7 matched the span and was 250 shorter, but it broke BETWEEN the two
    back-to-back switches -- the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
    [120kw-acdc.sch, 30kw-acdc.sch, 60kw-acdc.sch]
2026-09-06 Compose isolated CAN; document why the discharge section cannot be
    CAN drew the CONNECTOR first and the transceiver driving it last -- the flow
    exactly backwards. It now reads from the MCU outward: isolated bias, transceiver
    and the ground-bridge pair on the logic side, then the bus side -- common-mode
    choke, PESD clamp, connector, termination jumper and resistor.
    Two columns, chosen by probe rather than preference. A three-column split reads
    the same and is 750 SHORTER on 30 and 60 kW, but it turns 120 kW's span-1 frame
    into span 2 and cost that sheet 10% in area (54600x41800 -> 60600x41550), so it
    was built, measured and dropped. The two-column split matches the packed frame
    exactly on al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
    [120kw-dcdc.sch, 30kw-dcdc.sch, 60kw-dcdc.sch]
2026-09-06 Compose the HMI; PITCH forced type-contiguity in its second column
    Packed, the HMI put all four active devices -- display, both digit transistors,
    shift register -- in column one and every one of the sixteen passives in column
    two, so nothing sat next to what it connects to. It now reads in drive order: the
    shift register with the eight segment resistors it drives, then the display those
    segments feed, the digit transistors, the buttons with their debounce caps, and
    the remaining resistors.
    Break after the segment resistors, found by probe: span 1 / h 7250 on all three
    SKUs, identical to packed, so the ordering costs nothing.
    Column two is ordered by symbol TYPE rather than strictly by fun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
    [120kw-dcdc.sch, 30kw-dcdc.sch, 60kw-dcdc.sch]
2026-09-06 Measure the two bank sections; leave them packed, and sharpen the rule
    Both have real defects. On 120 kW the S/P matrix strands KSER and KSER2 in the
    last column with all six feedback pull-ups sitting between them and the other
    eight relays -- the relay family split by the parts that belong to it. BANK-A
    splits a series capacitor pair (CBA3B | CBA3T) across a column boundary.
    Neither could be fixed without paying for it, and both were built and measured
    rather than guessed at:
    SP-MATRIX 4 columns: span 2, h 3750/3750/5250 against a packed 6250 everywhere
    -- SHORTER on every SKU at the same span. The 120kw-dcdc sheet still
    grew 8% (54600x41800 -> 66600x37050). 3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
2026-09-06 Group the thermistor channels and aux rails by function, not alphabet
    Three more sections composed, all exact frame matches, all free.
    AC-SENSING / NTC and OUTPUT-SENSING / NTC each carry two independent thermistor
    channels, and each was laid out alphabetically -- both connectors, then both
    pull-ups, then both filter caps -- so neither channel sat together. Now each
    connector leads its own pull-up and filter cap. One column either way, span 1 /
    h 3250 unchanged.
    AUX-POWER / RAILS was the same shape of mistake: all three rectifiers, then all
    three reservoir caps, then both TVS clamps. No rail was readable as a rail. Now
    each rail reads rectifier, cap, clamp in turn. One column either way, s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
    [120kw-acdc.sch, 120kw-dcdc.sch, 30kw-acdc.sch, 30kw-dcdc.sch, 60kw-acdc.sch, 60kw-dcdc.sch]
2026-09-06 Compose both 3.3 V bucks; record the canonical-key trap that nearly hid it
    Both bucks now read as a buck: input cap and the IC, then bootstrap, inductor,
    output cap and the feedback divider. Packed, the IC sat alone in column one and
    all six passives in column two in alphabetical order, so the converter could not
    be traced through them.
    Same span on every SKU and 250 shorter (h 3000 against 3250). Measured on the
    sheets rather than assumed, because shorter is not automatically safe: 120kw-acdc
    takes the 250 (41800 -> 41550) and nothing else moves.
    A methodological bug worth recording, because it produced a convincing false
    result. A section title is canonicalised by digit-stripping before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
    [120kw-acdc.sch, 120kw-dcdc.sch, 30kw-acdc.sch, 30kw-dcdc.sch, 60kw-acdc.sch, 60kw-dcdc.sch]
2026-09-06 Compose precharge; measure surge and find a 500 mil section moving a sheet 21%
    INPUT-EMI / PRECHARGE now leads with the two bypass relays, then the precharge
    resistors they short out and the feedback pull-up. Packed, the resistors led and
    the relays came last. One column, exact frame match on every SKU (span 1, h 4250),
    so no sheet moves.
    INPUT-EMI / SURGE was probed in the same pass and left packed, and its numbers are
    the most striking of the whole exercise. Packed splits the MOV group across the
    column boundary (MOV1 | MOV2, MOV3) -- a real defect. Three clean groups at 6/3
    hold the packed span on every SKU and cost only 500 in height (3250 against 2750).
    That 500 cascaded into +21% area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
    [120kw-acdc.sch, 30kw-acdc.sch, 60kw-acdc.sch]
2026-09-06 Compose the fan headers and both interconnects; one column each, all exact
    Three more sections, nine instances, all free.
    All three drew their harness connector AFTER the passives hanging off it, and
    FANS additionally grouped by type -- both fan headers, then both tach pull-ups --
    so neither fan read as a fan. Now each fan sits with its own pull-up, and each
    interconnect leads its own link resistors.
    Single column is what makes them free, and that is worth recording because an
    earlier FANS attempt failed here. Two columns (connectors, then pull-ups) held
    span 1 and was SHORTER than packed, and still sent the worst enclosed void from
    4.6% to 10.2% while widening 30kw-acdc. The single-column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
    [120kw-acdc.sch, 30kw-acdc.sch, 60kw-acdc.sch]
2026-09-06 Sync the docs to the drawing set: composition rule documented, stale figures fixed
    The composition work was the largest part of the layout effort and was not
    documented anywhere. Added it to docs/schematic-drawing-set.md: what the HAND
    plans are, that 154 of 217 sections carry one, that an unnamed part is appended
    rather than dropped, and how to probe a candidate with FRAMES=1.
    The rule is recorded with the evidence that produced it: a plan is free only when
    its frame matches the packed frame EXACTLY on all three SKUs. SURGE cost 500 mil
    of height and +21% sheet area. SP-MATRIX was SHORTER on every SKU and still grew
    a sheet 8%. FANS in two columns was shorter and sent the worst void 4.6% -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
2026-09-06 Plan the PCB floorplan at section level, and measure whether the outlines fit
    The schematic is closed and the PCB is not started, so this fixes the ZONES
    before any placement: which schematic section lands where on each board, which
    way power and air flow, where the isolation barriers run, and which edges belong
    to the heatsinks.
    calculations/floorplan-budget.mjs answers the two questions the frozen outlines
    cannot. Every power semiconductor is a TO-247 that must reach an outer extrusion,
    so perimeter is a consumable resource; and the dominant parts consume area before
    a trace exists. Both are measured per board per SKU, and the result changes the
    plan:
    30 kW edge 32% / 55% fill 48%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
2026-09-06 Draw the zone plan to board scale, and let the rail budget overrun its track
    calculations/floorplan-svg.mjs renders the §3-§4 zone tables at the real board
    aspect ratio, one SVG per SKU, so the plan can be read as a picture. Zone widths
    are the plan's design decision; the board rectangles, device counts and rail
    budget come from the frozen outlines and the BOM.
    The rail bar is deliberately NOT clamped to the board. Clamping hid the single
    most important fact in the drawing -- at 120 kW the DC-DC rail is 2400 mm against
    1764 mm of usable perimeter -- by silently truncating the bar at the board edge.
    It now overruns its track in red past a limit line, and the canvas is sized to
    contain the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
2026-09-06 Add the component-rules phase, checked against the installed electronics skills
    The zone plan says where a section goes; this says what a placement inside a zone
    must satisfy. Written now rather than discovered during routing.
    Installing the 84-skill electronics library and reading pcb-specialized-power-
    electronics, pcb-specialized-high-power, pcb-theory-emi-emc, pcb-theory-thermal
    and pcb-theory-creepage-clearance against the plan found real gaps, not
    confirmations: no rule against traces under a switch node, nothing on via count
    per amp, no-thermal-relief on power pads, polygons-not-traces above 10 A,
    connector 2x rating, fuse I2t below trace failure, stitching vias, and the
    converse bar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
2026-09-06 Correct the rail budget: primary and secondary cannot share a perimeter
    The first version pooled all TO-247 on the DC-DC board against the whole
    perimeter. They cannot share: primary FETs and secondary JBS sit on opposite
    sides of the reinforced barrier, so each side owns only the perimeter within its
    own X span. Pooling them compares unlike with unlike and flatters the answer.
    Splitting it moves the finding from "120 kW is impossible" to something both
    worse and more useful -- the secondary rectifier rail is over budget on EVERY SKU:
    30 kW 24 JBS 480 mm / 501 mm 96%
    60 kW 48 JBS 960 mm / 607 mm 158%
    120 kW 96 JBS 1920 mm / 819 mm 234%
    The 30 kW board was reporte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
2026-09-06 Target a 19-inch 3U rack card; AC in and DC out diagonally opposite; CAN on the DC plug
    Three directives, and the first one has a hard number behind it.
    ENVELOPE. The module has to drop into the same cabinets as everything else in
    this class, so width and height are fixed by the rack and depth is the only free
    dimension -- which inverts the instinct to draw a wide, shallow board. Adding the
    check to floorplan-budget.mjs says:
    height 134.8 mm stack vs 3U 133.35 -- OVER by 1.5 mm before insertion
    clearance, and the tunnel (D1 choke, 3 stacked H17 toroids) is 46% of
    it, so the PFC choke stack decides whether this is a 3U product.
    ~5 mm is recoverable m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
2026-09-06 Fans and HMI to the front, all connectors to the rear; the power path folds
    Front face carries the fans, display and switch. Rear face carries AC in and
    DC out + CAN, at diagonally opposite corners of that face -- so the two HV
    harnesses still leave in different directions and never run parallel in the
    cabinet.
    With both connectors at the back the power path can no longer run straight
    through: it becomes a U-fold. The AC-DC board runs rear->front, the DC-DC board
    front->rear, and the B2B handoff lands at the FRONT of both boards. That closes
    open item 4 outright -- the pillars are now vertical by construction, and a
    vertical M8 pillar is a bolted joint the EOL milliohm test can verify where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
2026-09-06 Check that the two rear cables do not choke the exhaust they share a face with
    Confirming the arrangement: AC and DC cables both exit the rear face at
    diagonally opposite corners. Half that diagonal is free -- the sandwich already
    puts the AC-DC board low and the DC-DC board high, so AC sits at the bottom of the
    rear face and DC at the top by construction. Only the lateral half is a placement
    choice, and taking it separates the two cables on both axes at once.
    What needed checking is that the rear face is also the exhaust, so the connectors
    take vent area away from the air. That makes vent area a computed quantity rather
    than whatever is left over:
    30 kW 844 W 74 CFM 2.4 m/s com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
2026-09-06 Double-sided front-to-back device ridges — the rail budget and 3U height together
    The instinct to make one heatsink serve devices on both faces is right, and
    running the rails front to back is right: that is the airflow direction, so a
    rail parallel to it is streamlined where a rail across it is a wall in the duct.
    The part worth changing is where the rails go.
    Side borders give the rail length -- 2 rails x 2 flanks x board depth is
    1148-1988 mm against 320-1200 mm needed -- but a 3U card is wide and shallow, so
    its largest surfaces are the top and bottom:
    30 kW top+bottom 2948 cm2 left+right 893 cm2 sides are 30%
    60 kW top+bottom 4374 cm2 left+right 1325 cm2 sides are 3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
2026-09-06 Measure the floorplan against shipping hardware; three things change
    105-agent research pass over Wolfspeed CRD-30DD12N-K / CRD-60DD12N-K, Microchip
    DS50002952, ST STDES-30KWVRECT, TI TIDA-010257 and Infypower REG1K0100G2.
    Recorded as §12 with what each finding confirms or changes.
    Confirmed, including one worth noting: Wolfspeed's 60 kW LLC PCBA is 490x390 mm
    and 490 mm exceeds the ~448 mm usable 19-inch interior, so above 30 kW the long
    axis must run front-to-back. This plan had already re-proportioned that board to
    440x497 mm on the same reasoning, before the source was read -- two routes to
    within 7 mm. Also confirmed: vertical TO-247 at the sink rather than SMD on a
    cold plate, straig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
2026-09-06 Give every footprint a body, and gate PCB placement
    Starting the layout phase. The first thing found is that no placement work was
    trustworthy yet, because the geometry was not real.
    Every custom footprint primitive was pads-only -- <platedhole> with no body
    outline -- so tscircuit had nothing to collide. 93 of 304 components on 30kw-acdc
    raised pcb_component_missing_courtyard_warning, and a TO-247 SiC MOSFET reported a
    10.0 x 2.4 mm extent against a real 15.9 x 5.0 mm package. The D1 PFC choke, a
    0.9 kg toroid 89 mm across, reported 64 x 4 mm. Checking overlaps against pad
    extents is checking the wrong thing.
    Added courtyards to 14 primitives using the SAME envelopes already in
    floorplan-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
2026-09-06 Lay out the 30 kW AC-DC board: cells placed, 358 placement errors down to 89
    First real placement pass. Every number below is tscircuit's own DRC.
    courtyard overlaps 272 -> 48
    footprint overlaps 45 -> 22
    pad-pad clearance 41 -> 19
    cells off the board 3 -> 0
    cell-to-cell overlaps 16 -> 0
    gate driver too far 6 -> 0
    Two cells had to be rebuilt before anything could be placed. ViennaPhase ran its
    parts out in one 200 mm line from the choke, which made the cell 175 mm wide and
    hung it 27 mm off the board; it is now 89 x 161 with the choke above and all five
    TO-247 on ONE rail line at 18 mm pitch, which is what a §5 ridge actually needs --
    a rail is only a rail if th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
2026-09-06 30 kW AC-DC placement is clean, two-sided, and passes the physics checks
    tscircuit DRC on this board is now zero across the board:
    courtyard overlaps 272 -> 0
    footprint overlaps 45 -> 0
    pad-pad clearance 41 -> 0
    missing courtyards 93 -> 0
    parts off the board 5 -> 0
    TWO-SIDED. Every control and sensing cell moved to the BOTTOM side -- 181 parts
    top, 123 bottom. That is not just density: it puts a full copper plane between
    every sense node and every switching node, which is why SENSE-SEP now passes
    without moving a single sense part laterally. It also unjammed the control strip,
    which had 330 mm of cells f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
2026-09-06 Fix decoupling at three ICs, drop the autorouter, put power on planes
    Placement clean and all physics checks pass, with the decoupling actually doing
    something for the first time.
    Three capacitors were nowhere near the pins they serve, all found by chasing a
    constraint the autorouter refused to start under:
    gate-driver bias 16.0 mm -> 0.6 mm
    supervisor VDD 24.5 mm -> 1.06 mm
    watchdog timing caps 22 mm -> at their pins
    The gate-driver fix is the one that mattered most: that loop supplies every amp of
    gate charge, and at 16 mm it may as well not be fitted. VCC2 and GND2 are 3.81 mm
    apart, which an 0805's 1.9 mm pad span cannot reach -- a 1206's 2.6 mm span does,
    rotated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
2026-09-06 Justify every net's copper by its current; move the snubber to its switch
    Three audits now pass on 30kw-acdc: placement, EMI/thermal/coupling, and routing.
    ROUTING BY CURRENT, not by autorouter. routing-audit.mjs sizes every net from
    IPC-2221 against the design basis (54.9 Arms/phase at 30 kW) and asks what has to
    carry it. At 20 K rise on 2 oz external, 54.9 A wants a 24.7 mm conductor -- that
    is a busbar, and calling it a trace does not make it one. The check found ELEVEN
    nets over 10 A with no plane copper.
    Nine were the mains phases; they now have top-layer copper, which is where their
    parts already sit and where the current already flows. They are 50 Hz nets so
    flooding them is harmle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
2026-09-06 Compact the EMI filter, run the HV dividers vertically, plot by courtyard
    Rendering the board by COURTYARD rather than by pad is what made the next round of
    defects visible. A stock pad plot shows a nearly empty rectangle -- an 89 mm choke
    is two plated holes and a TO-247 is four -- so pcb-plot.mjs draws what parts
    actually occupy, coloured by layer.
    The first thing it showed: the input filter was scattered over 260 mm. CM chokes
    at x -180, X caps at -46, DM chokes at +20. That is not a filter, it is three
    parts on the same net, and it sat right beside 120 x 125 mm of dead board.
    Worse, the EMI keep-out check had PASSED on it -- because the zone was computed
    from the bounding box of the fi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
2026-09-06 Lay out the DC-DC board: cell placement clean, intra-cell spacing under way
    Second board. All four floorplan rules now pass on 30kw-dcdc, and the tooling
    built for the AC-DC board carried straight over -- missing courtyards were already
    zero here because the footprint work was global.
    cell-to-cell overlaps 21 -> 0
    parts off the board 0 -> 0
    courtyard overlaps 218 -> 119
    footprint overlaps 46 -> 40
    Board re-cut to 440 x 380 to match the AC-DC card, so one extrusion and one rack
    slot serve both. Legs down the left, the three LLC sections beside them on the
    same three rows, the S/P relay matrix beneath the banks it switches, control strip
    along the bottom edge.
    Three real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
2026-09-07 Both 30 kW boards are placement-clean
    30kw-dcdc joins 30kw-acdc: tscircuit DRC zero across courtyard, footprint,
    pad-to-pad and missing-courtyard, and all four floorplan rules pass.
    courtyard overlaps 218 -> 0
    footprint overlaps 46 -> 0
    pad-pad clearance 40 -> 0
    cell-to-cell 21 -> 0
    Every defect on this board was a footprint dimension larger than the pitch it was
    placed on, and none of them was visible before the footprints had bodies:
    S/P relay 52 x 36 mm on a 40 x 35 mm grid
    bank caps 37 mm snap-ins on a 20 x 25 mm pitch, piled on transformer T1
    resonant films 31.5 x 13 mm on an 8 mm pitch
    LLC switches 16.4 mm TO-247 on a 12 mm pitch
    rectifier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
2026-09-07 Turn the DC-DC barrier horizontal; define one control card for both roles
    You were right that the DC-DC board looked like junk. It was not crowded -- it is
    25 % full -- it was badly partitioned, and I kept nudging coordinates instead of
    fixing that.
    The barrier ran VERTICALLY. On a 440 mm rack card that leaves the secondary domain
    138 mm wide, so every output part -- banks, relay matrix, shunt, studs -- was
    jammed into a strip while half the board sat empty. It now runs HORIZONTALLY:
    primary above, transformers as the barrier band at y 21..56, secondary below, and
    both domains get the full board width. LlcSection was rebuilt as a vertical chain
    (films -> CT -> trim inductor -> transformer -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
2026-09-07 Create the control card as its own board; one card, both roles, 30/60 kW
    boards/control-card.tsx now builds: 43 parts, 174 traces, 67 nets, zero errors.
    It carries the MCU, SWD port, safety chain, 3V3 rail and analogue mid-rail, plus
    the 88-way connector, and it is deliberately ROLE-AGNOSTIC -- its MCU is wired to
    GENERIC nets (PWM0..11, AIN0..12, DO0..6) and the role mapping happens on the
    power-board side. The card does not know which converter it drives until firmware
    reads the ROLE straps at boot.
    SCOPE CUT, on evidence. A first cut covered 120 kW too. A four-lens adversarial
    review rejected it unanimously, and for one underlying reason rather than four:
    the connector came out exactl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
2026-09-07 Split the control cells onto the card; both power boards updated
    Three boards now build with zero netlist errors:
    30kw-acdc 304 -> 271 parts 623 traces
    30kw-dcdc 311 -> 282 parts 737 traces
    control-card 43 parts 186 traces, no errors of any kind
    The MCU, SWD port, safety chain, 3V3 rail and analogue mid-rail are gone from both
    power boards and live on the card. What is left on each board is the 88-way
    connector, and cardMap() generates both sides from ONE source so the pinout cannot
    drift between them.
    Also deleted from the power boards, deliberately: RAGTA and RAGTB. The AGND-to-DGND
    single-point tie now lives on the card, and leaving either one populated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
2026-09-07 Place the card connectors; give the DC-DC board barrier-bounded planes
    Both 30 kW power boards are placement clean, physics clean and routing-justified,
    with the control card split in place.
    30kw-acdc 271 parts placement / EMI / thermal / loop / routing all pass
    30kw-dcdc 282 parts all pass, BARRIER 0
    card 43 parts no errors of any kind
    Connectors went on the bottom edge of both boards, where a card can actually plug
    in -- found with a new free-space.mjs that reports the largest empty rectangles on
    a placed board. That tool exists because placing cells by eye on a board that is
    only a quarter full still collided, repeatedly; guessing at "the empty bit" costs a
    buil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
2026-09-07 The module is 30 kW; higher ratings are cabinets, and the geometry now proves it
    Placing the boards settled a question the floorplan had only inferred. Measured
    from the cells as actually built -- Vienna phase 89 x 161, LLC section 83 x 225:
    AC-DC depth DC-DC one-row width
    30 kW 356 mm fits 261 mm fits
    60 kW 528 mm fits 528 mm TOO WIDE for a 440 mm card
    120 kW 872 mm over 1062 mm far over
    The DC-DC board is the binding constraint, and it fails at 60 kW, not just at 120.
    Six LLC sections will not tile across a 440 mm rack card, and two rows break the
    single horizontal isolation barrier AND exceed the 560 mm depth class.
    That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
2026-09-07 Routing runs: a 9-pin label on an 8-pin package was killing the autorouter
    The router had been failing with
    TypeError: undefined is not an object (evaluating 'connectedPort.x')
    from inside its own geometry code, which names nothing useful. The cause was a
    port with no pad: UAUX, the aux flyback controller, declared NINE pin labels on a
    soic8 footprint. One of them, VIN, was a duplicate of VCC and was even traced to
    it -- a self-connection -- which left RT with no pad at all and silently
    unconnected. Reduced to its real 8 pins, the same router produced 533 traces, 291
    vias and 176 pours on the same board.
    Two things that made this findable: placement had to be clean first (the router
    ref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
2026-09-07 E35: independent margin audit executed end-to-end; card split completed
    Clean-room recompute reproduced every frozen value (currents, Vienna integrals,
    tank, gain, flux, aux DCM) — the calculators are right; the drawings and the
    in-flight card split were not, and hardware would have found out:
    - D2 rev C: trim inductor sendust -> GAPPED FERRITE (2x PQ50/50, same p/n as
    D3, N=4, gap-ground per bin). Sendust at full 140 kHz AC swing = ~43 W core
    loss vs a ~4 W tank budget and a 2:1 L swing per cycle. Powder cores are now
    prohibited on full-AC-swing HF duty; every magnetic drawing must carry a
    core-loss line.
    - D1 rev B: N=39 +/-1 lot trim, 18 mm2 flat Cu, against the real 0077908A7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
    [loss-budget.csv, mcu-matrix.csv]
2026-09-07 E36 + pipeline green: layout re-scoped out; 120 kW retired to cabinet; card in BOM
    Customer directives 2026-09-08: schematics/BOM/nets ONLY (E36 — builds run
    TSCI_NO_ROUTE=1 netlist mode), and 60/120 kW resolved end to end.
    - 120 kW single-board pair RETIRED from the buildable/deliverable set: since
    the card split cardMap() correctly refuses 4 lanes (AIN 17 of 13), agreeing
    with geometry, relays and fuse frames. BUILDABLE_SKUS (parts-db) is the one
    source every consumer iterates (8 gate loops, kicad5-gen, bom-gen,
    schematic-export); the last pre-split sheet set is archived; stale pre-split
    netlists and payloads deleted so nothing can consume them silently.
    - bom-gen: each module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
    [120kw-acdc.sch, 120kw-dcdc.sch, 30kw-acdc.sch, 30kw-dcdc.sch, 60kw-acdc.sch, 60kw-dcdc.sch, acdc-AC-SENSING.json, acdc-AUX-POWER.json]
2026-09-08 Presentation: nets not wires; card joins the composed sheet + PDF set
    User feedback on the card sheet ("doesn't look handcrafted — use nets, not
    long wires") traced to two render-level causes, both fixed:
    - isForPower/isGround on the card's nets made tscircuit route WIRES to
    rail/ground glyphs, wrapping the LQFP-100 in loops; the card now declares
    plain nets and every power connection renders as an inline label chip.
    - The schematic trace solver still emits same-net pin-to-pin wires inside
    groups (board-level schMaxTraceDistance cannot reach them), so a new
    render-side pass (calculations/sch-longtrace-labels.mjs, used by both
    schematic-export and schematic-compose) converts ever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
2026-09-08 Card joins the audited KiCad-5 set; PDFs now come from it
    'Purely handcrafted' feedback resolved at the root: the deliverable PDFs now
    render the AUDITED KiCad-5 sheets, not the tscircuit solver output.
    - Card through the full pipeline: easyeda-pages CARD page (8 blocks, 45/45
    assigned), apply-gen card filter + title, kicad5-gen card branch (BOARDS,
    side classifier, SIDE_TITLE, ident key). Family-spread gate exempted for
    the card (grouping exists for REPLICATED cells; every card part is
    single-instance — the sections are the grouping), and its index/legend go
    into a compact footer above the title block instead of void-hunted panels,
    freeing the packer: NC=5, aspect 1.31, fill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
    [30kw-acdc.sch, 30kw-dcdc.sch, 60kw-acdc.sch, 60kw-dcdc.sch, control-card-card.sch, dc-modules-control-card.sch]
2026-09-08 Real symbol glyphs + print renderer; PDFs show the actual circuit
    'Boxes, no connections, looks like a dummy' — three renderer truths behind it,
    all fixed:
    - The lib drew R as a rectangle and every 2-pin special (fuse, MOV, GDT, CT)
    fell through CAT to "R" because page payloads carry no mpn (invisible in
    the box era: box looked like box). CAT now resolves the real MPN through
    partOf() with a designator-letter fallback; R is an ANSI zigzag; F/MOV/
    GDT/CT get their own glyphs.
    - Multi-pin power parts rode the IC-box path. Centred function glyphs now ink
    the body: NMOS (B3M/SG2M/SIC-1700/SIC-1200), NPN (S8050), relay coil+
    contacts (HF167F/HFE82V), transformer windings (XFMR-*),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
    [30kw-acdc.sch, 30kw-dcdc.sch, 60kw-acdc.sch, 60kw-dcdc.sch, control-card-card.sch]
2026-09-08 E37 module-interconnect audit + E24 rev B: the module now mates end-to-end
    New permanent gate calculations/module-interconnect-audit.mts walks the
    built netlists across every physical boundary of one module (studs,
    16-way harness incl. TX/RX crossover, both 88-way card slots way-by-way,
    RATING strap) and run-all now runs it. Negative-tested: one injected
    expectation -> exactly one FAIL; board-swap -> 78 FAILs.
    Found and fixed by the audit:
    - RATING strap was hardcoded 0R on all boards: a 60 kW machine would
    identify as 30 kW. Now per-SKU (0R=30kW, 10k=60kW), asserted per build.
    - CONN-CARD-88 was one part for both halves; split into -H (board header)
    / -R (card receptacle) mating pair w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
    [30kw-acdc.sch, 30kw-dcdc.sch, 60kw-acdc.sch, 60kw-dcdc.sch, acdc-CONTROL.json, bom-30kw.csv, bom-60kw.csv, control-card-card.sch]
2026-09-08 E38 polarity audit: every +/anode proven on pin 1, netlist to glyph
    User flagged that polarized symbols (electrolytics, diodes) might be
    drawn in the wrong orientation. Verified the whole chain instead of
    eyeballing:
    - Convention: tscircuit lrPolarPins pin1=anode/pos; the kicad5 glyphs
    draw exactly that (CP "+"-plate = pin 1, D anode triangle = pin 1);
    every sheet instance uses the single upright orientation matrix
    (1393 instances, nothing rotates), so orientation reduces entirely
    to "is pin 1 wired to the positive/anode node".
    - New permanent gate calculations/polarity-audit.mts (in run-all)
    proves that from the BUILT netlists: rule table per board with
    lane-locked $1/$2 captur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
2026-09-08 All-symbol sweep: SW buttons get a real glyph; EasyEDA cap-rotation hint
    User flagged mis-oriented polarized symbols from crops that turned out to
    be the EasyEDA-applied schematic, not the KiCad PDFs. Swept ALL 51 symbol
    families used across the five sheets (crops from the print SVGs, reviewed
    one by one):
    - 50/51 verified correct and aligned: R/C/CP/D/F/GDT/MOV/CT/L passives,
    NMOS + body diode, NPN arrow, relays, transformers (dot + core), CMC,
    shunt, DC-DC/iso modules, gate drivers, iso-amps, optos (LED->detector
    direction), connectors, terminals, display, discharge FETs.
    - 1 defect: SW1..SW4 (HMI tact buttons) drew as resistor zigzags via the
    designator-letter fallback. New "SW"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
    [30kw-dcdc.sch, 60kw-dcdc.sch]
2026-09-08 Print renderer: vertical IC pins draw INTO the body (U/D letter sense)
    User spotted top/bottom power pins (V15/DGND on the iso modules, and the
    same on every multi-row IC) rendering as floating stubs: line drawn AWAY
    from the body, connection dot stranded at a dead end, visible gap to the
    outline. Electrically they were always connected (kicad5-verify 1568/1568
    checks the connection points) — the defect was pure rendering.
    Root cause, measured from the SVG + lib rather than assumed: the lib is
    deliberately authored in the EasyEDA-importer convention — Y pre-negated
    AND U/D orientation letters swapped (the 454-pin pre-mirror fix). The
    print renderer parses positions by plain ADD, which i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
2026-09-08 E39: 120 kW made real — cabinet sheet + CSU role, one MCU, no overengineering
    User directive: make 120 kW possible with maximum simplification, ideally
    one MCU. The physics answer stands (a 120 kW single stage is 2x over any
    one card on PWM units, analog inputs and connector ways simultaneously,
    and the boards/magnetics fail before the silicon), so the simple design
    is: 4 x 30 kW modules + exactly ONE coordinating MCU — the same control
    card p/n booting in a third strap role (CSU).
    - E24 rev C: third RATING band 3.32 k -> ~0.82 V = CSU (between the
    0 V/30 kW and 1.65 V/60 kW codes; ROLE0 don't-care). One image, three
    roles. No new hardware SKU anywhere.
    - boards/cabinet.tsx: the cab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
    [cabinet-cab.sch, dc-modules-cabinet.sch]
2026-09-08 120 kW re-verification: three content bugs the gates could not see, fixed
    User asked to re-verify the cabinet schematic. Gates were green, so this
    was a fresh-eyes content audit against the module's REAL interfaces —
    and it found three genuine design errors plus one pipeline drop:
    1. Module blocks wired the cabinet charging bus to pins named DCP/DCN —
    which on a module are the INTERNAL 830 V DC-link sandwich studs. The
    cabinet-facing output is OUTP/OUTN (post-K_OUT). Renamed pins and bus
    nets (BUS_P/BUS_N) so the sheet cannot be mis-built.
    2. The CAN domain is ISOLATED per card (NSI1042, CGND, JCAN.SGND): the
    harness must carry the SGND reference conductor between all five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
    [cabinet-cab.sch, dc-modules-cabinet.sch]
2026-09-08 README end-to-end refresh + repo cleanup to the E39 state
    Root README rewritten to current truth: product structure (30 kW module,
    60 = 2x, 120 = 4x + CSU on the same card p/n), E1-E39 register, 45/45
    firmware, 6 audited sheets at 4150/4150 pins, three PDF sets as the
    deliverables, KiCad-as-record with the EasyEDA face frozen, audit-trail
    table through E39, @10k cost reality (30,372 / 60,744 / ~123.0k), rating
    envelope row, updated quickstart (TSCI_NO_ROUTE + kicad5 regen chain),
    honesty boundary + roadmap brought current.
    Cleanup (all verified unreferenced; battery green after):
    - kicad/ deleted — the Sep-6 KiCad export face, fully superseded by
    kicad5/ SHIP zips (stale mention in symb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
    [acdc-AC-SENSING.kicad_sch, acdc-AUX-POWER.kicad_sch, acdc-CONTROL.kicad_sch, acdc-DC-LINK.kicad_sch, acdc-INPUT-EMI.kicad_sch, acdc-VIENNA-PFC.kicad_sch, dcdc-BANKS-SP.kicad_sch, dcdc-COMMS-HMI.kicad_sch]
2026-09-08 E40 (proposed): single-card-per-module migration plan — MCU matrix, costs, pros/cons
    Directive: a module should be one control system (single source of truth,
    fewer CAN nodes). Full plan documented before execution: merged budget
    (9 PWM / 6 units / 22 analog / ~76 ways -> 144-pin class), selection
    matrix (GD32G553ZET6 recommended; TI F28P650DK recorded as the
    market-standard alternate; STM32G474 assessed), target architecture
    (card in the DC-DC slot, 40-way harness, safety chains unchanged,
    module = ONE CAN node, cabinet = 5), cost delta -Rs540/module, honest
    cons (metering analog across the harness, frozen-chain reopen, 60 kW
    reference retirement), phased execution with go/no-go criteria.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
2026-09-08 E40 Phase B.1: UMOD pin allocation — one VET6 runs the whole 30 kW module
    Generated merged single-brain allocation (calculations/control/
    umod-pinmap.mts -> out/umod-pinmap.csv): 65 signals on the EXISTING
    GD32G553VET6 — 22 analog, 9 PWM, 17 usable pins spare. No package
    change needed (the plan's ZET6 stays recorded as headroom only), and
    65 signals < 88 ways means the existing card connector survives too.
    R3 discipline enforced by the generator: every pin/port/capability is
    read from the datasheet-derived UPFC/ULLC tables; every collision (17
    found, incl. 2 the manual pass missed and the asserts caught) resolves
    by a donor-quoted move onto a pin freed by the dropped lanes/legs;
    uniquen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
    [umod-pinmap.csv]
2026-09-08 E40 Phase B/C core: single-brain module builds; interconnect CLEAN
    control-card.tsx v2: roles module|card from the generated UMOD map;
    RATING-only identity (E24 rev D: 0R=module, 3.32k=CSU, open=fault);
    CARD_PWM_CONTRACT (LLC pairs ST0-2, PFC singles ST3-5). SafetyChain
    grows a second gated output (gate2: EN_A AND WDO -> GATE_EN_A across
    the harness; unused-gate tie list fixed to gate 3 only — the old list
    would have shorted the new gate's driven inputs). Interconnect40
    replaces the 16-way cell: straight-through, map-driven from HARNESS40,
    SHLD bonded at the AC-DC end; the UART link and its RC networks die.
    boards.tsx: AC-DC loses its slot and RROLE; keeps default-OFF
    pulldowns extended t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
    [umod-pinmap.csv]
2026-09-08 E40 complete: gates, pipeline, BOM and docs on the single-brain module
    Gate suite: CB-14/R2-CB21/R2-MR14/R2-CLASS-RAIL/AUD-CARD-* moved to
    E40 truths (asserts now read the GENERATED umod map, not prose);
    polarity + interconnect audits scoped to the module; pages card SAFETY
    block gains RGPA; APPLY gate caught drop #6 (MICROFIT3-40 alias).
    Pipeline: 60kw target refused like 120kw and its artifacts archived
    (kicad5 set + SHIP zip + PDFs); pdf list and BUILDABLE_SKUS trimmed.
    bom-gen counts ONE card per module: 30 kW lands Rs30,079 @10k
    (-Rs293/module measured); regenerated sets: 30kW (3pg) + 120kW
    Cabinet (4pg). Battery: run-all exit 0, 1945/1945 pins across
    30kw/card/cabinet, visual clean x3,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
    [30kw-acdc.sch, 30kw-dcdc.sch, 60kw-acdc.sch, 60kw-dcdc.sch, acdc-AUX-POWER.json, acdc-CONTROL.json, acdc-VIENNA-PFC.json, bom-30kw.csv]
2026-09-08 E41: 40 kW hot variant — same platform, engine-driven, both SKUs green
    New variant beside the 30 kW module (user directive), executed with the
    session's discipline end to end:
    - Engines first: 40 kW rows added to design-basis/busbar/loss-budget/
    envelope tables; the loss engine's lane-constant model was CAUGHT
    producing better-eta-at-40kW garbage and made current-aware (k-scaled
    conduction/switching split, constant-J magnetics rewinds) before any
    number was trusted. Verdicts: line 73.3 A, 1194 W, eta 97.1%.
    - PFC thermal wall solved WITHOUT a new part: 2x paralleled B3M per
    position with per-device gate resistors (pair 44.9 W vs 71.1 W
    single — the 138 C corner architecture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
    [30kw-acdc.sch, 30kw-dcdc.sch, 40kw-acdc.sch, 40kw-dcdc.sch, acdc-AUX-POWER.json, bom-40kw.csv, control-card-card.sch, dc-modules-40kw.sch]
2026-09-08 E41 closure: the envelope grid disciplines the 40 kW variant — 0/4032
    The naive 40 kW grid run FAILED 95 points and was allowed to say so:
    tank Ip past the (deliberately unchanged) 48 A pk ceiling at low-line/
    low-voltage corners, TjPFC modeled as a single die, TjLLC over at hot
    PS corners. Fixes are design-honest, not gate-soft:
    - grid models the E41 paralleled pair per-package (conduction /4,
    switching shared) — TjPFC corners clear with the real hardware;
    - tank-ceiling availability clamp with a 2-pass fn/Q re-solve: the
    protection/CT/trim hardware stays identical to 30 kW and the corner
    AVAILABILITY folds instead (commercial derate-curve shape);
    - thermal fold mirroring the FSM'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
    [envelope-grid.csv]
2026-09-08 E41 validation pass: stress-audit gate — 34 checks, two real catches, all green
    User directive: in-depth validation of switches, diodes and magnetics,
    zero points of failure, on the UPGRADED-30 (never derated-60) variant
    with ONE card. Both constraints are structural (1 lane / 1 channel /
    1 card, RATING 1k — the interconnect audit verifies the single slot on
    both variants) and now machine-checked:
    NEW calculations/stress-audit.mjs in run-all: voltage margins on every
    switch/diode class, worst-corner Tj from the 4032-pt grid + diode Tj
    from the k-scaled blocks, every magnetic against its OWN acceptance
    line (D1 swing-floor/dT/J, D2 flux, D3 volt-second identity, D6/D7
    density, tank per-c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
    [40kw-acdc.sch, 40kw-dcdc.sch, bom-40kw.csv, pfc-design.csv]
2026-09-08 Docs sweep: price-per-kW ladder (generated) + E41 across every doc
    bom-gen now emits the per-kW ladder into docs/bom-cost.md so it can
    never be lost to regeneration: 30->1,003/kW, 40->858/kW, and the
    120 kW crown — 3x40+CSU = Rs104,743 (873/kW), Rs17.4k under 4x30 —
    with the N-1 granularity trade stated (67% vs 75%).
    README: product table rebuilt as the six-product ladder with cards
    and Rs/kW columns; badges E1-E41 / 6 sheets 3611 pins / 47-47;
    deliverables + quickstart + repo map + audit-trail (E41 validation
    row) + roadmap. interconnect.md: E40 40-way harness section of
    record prepended, 16-way body marked HISTORICAL. architecture.md
    busbar line carries both variants. boards/README +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
2026-09-08 boards/README: purge pre-E40 survivals (two-cards line, JA slot, 60kw target)
2026-09-08 E42: 50 kW LIQUID variant — sealed module, zero fans, zero new silicon, ₹797/kW
    The liquid play from the air-50 risk assessment, executed E41-style end to end:
    - Cooling: both extrusions become liquid coldplates (Rth j→plate 1.1 K/W to a 65 °C
    hot plate ref, coolant ≤60 °C at 6 L/min — ΔT 4 K at 1,585 W), magnetics
    gap-pad-bonded, ZERO fans. Flow assurance = cooling cart (E42 system boundary);
    dry-run protection = plate NTCs into the existing OT ladder.
    - Silicon UNCHANGED from the 40 kW: paralleled PFC pairs (94 °C worst), SINGLE LLC
    FETs (140 °C worst) — the coldplate is what buys that.
    - Engines: D1-50 = 5× T79 26µ N=22 (pfc-design @PFC_P=50e3/PAR=2, frozen 50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
    [40kw-dcdc.sch, 50kw-acdc.sch, 50kw-dcdc.sch, bom-40kw.csv, bom-50kw.csv, dc-modules-50kw.sch, envelope-grid.csv, loss-budget.csv]
2026-09-08 E43: full-family verification — every board double-calculated clean-room; 4 findings fixed + gated
    User directive: verify each and every board end to end. Method: fresh rebuilds of
    all eight netlists + a clean-room verifier (own parser, own physics, zero engine
    reuse) — 118 checks across system currents, tank duty, protection energies/
    classes/timing, thermal vs grid, aux budget, interleave ripple, per-board
    structural walks (default-OFF coverage, mirror chains, discharge/precharge
    paths, counts) and firmware coherence. Now a PERMANENT gate:
    calculations/verify-independent.mjs in run-all.
    FINDINGS (all fixed, all gated):
    1. D6 DM choke had NO engine — the inherited "22 µH" cannot exi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
    [30kw-acdc.sch, 40kw-acdc.sch, 50kw-acdc.sch, acdc-INPUT-EMI.json, bom-30kw.csv, bom-40kw.csv, bom-50kw.csv, lisn-precompliance.csv]
2026-09-08 README: full module-variant specification table (30/40/50 kW, rev E43)
    Every row engine-derived and gate-verified: power/current/efficiency (full +
    peak), cooling, envelope proof, magnetics selections, protection classes,
    discharge timing, EMI margins, control identity, BOM @10k and price-per-kW.
2026-09-08 E44 + R4/E45: 50 kW AIR variant + external-review response — every claim verified, every real defect fixed
    E44 — 50 kW AIR twin (the upgraded-30 path, user constraint asserted structurally):
    - LLC half-bridges PARALLELED (2x SG2M/position, per-device 2.2R, Kelvin shared —
    the E41 Vienna pattern): per-package conduction quarters; fans were never the
    binder (infinite air still leaves a single FET at ~153 C — it is W/package).
    - Grid 0/1008, ZERO derate notes anywhere, worst Tj 107 C; eta 97.01 % full /
    98.55 % peak (best in family). 4 fans at the ~395 W/fan family density; every
    tach monitored — FAN_TACH4 = freed ROLE0 pin 90 -> way 88 -> harness W39
    (last spares spent deli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
    [30kw-acdc.sch, 30kw-dcdc.sch, 40kw-acdc.sch, 40kw-dcdc.sch, 50kw-acdc.sch, 50kw-dcdc.sch, 50kwa-acdc.sch, 50kwa-dcdc.sch]
2026-09-08 R5/E46: second external-review response — watchdog resets the brain, exclusion covers precharge, every supply pin bypassed
    Reviewer confirmed all R4 majors closed, then raised narrower items on the
    corrected sheets. Every claim verified against built netlists / vendor
    sources before any edit (GigaDevice ordering page fetched for R5-I).
    Fixed in hardware (cells/boards):
    - R5-A WDO wire-ORed onto NRST_CARD (open-drain, AND-inhibit retained):
    a hung MCU now RESTARTS with enables low instead of re-arming ~ms
    after WDO release. SafetyChain nrst prop; HAL contract in
    firmware-guide (no GPIO reset-retention; CWD window > boot-to-kick).
    - R5-B 100R DESAT series resistor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
    [30kw-acdc.sch, 30kw-dcdc.sch, 40kw-acdc.sch, 40kw-dcdc.sch, 50kw-acdc.sch, 50kw-dcdc.sch, 50kwa-acdc.sch, 50kwa-dcdc.sch]
2026-09-08 R6/E47: fourth review round — the watchdog connection made VISIBLE, and the aux that could never cold-start
    Reviewer confirmed the whole R5 wave landed, then read the sheets and the
    shutdown path deeper. Every claim verified against sources + the NCP1252
    datasheet before any edit.
    - R6-A The R5 WDO≡NRST merge was a pin-less net-net trace: electrically
    one node (section J proved it) but the SHEET drew two disconnected
    label groups — the reviewer correctly read "watchdog not connected
    to reset" off the face (the R4-1 defect class again). SafetyChain's
    nrst prop now RENAMES the WDO net outright: supervisor WDO, both
    AND inhibits, pull-up, MCU pin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
    [30kw-acdc.sch, 30kw-dcdc.sch, 40kw-acdc.sch, 40kw-dcdc.sch, 50kw-acdc.sch, 50kw-dcdc.sch, 50kwa-acdc.sch, 50kwa-dcdc.sch]
2026-09-09 R7/E48: fifth review round — comparator allocation made instance-aware, PV drive moved to its guaranteed point
    Reviewer closes the R6 wave (re-verifying the interlock over all 32 input
    states) and independently closes the NSI1042 hold with the Rev 1.3
    datasheet — our translation already emitted the exact map, so the hold
    closes with the full -DSWR order code. Two real catches remained, both
    verified against vendor tables before any edit:
    - R7-A The R6 "CMP-capable pin" constraint was instance-blind: LQFP100
    pin 15/PC0 is CMP2_IM and pin 16/PC1 is CMP2_IP, so PFC phases B
    and C sat on OPPOSITE INPUTS OF ONE COMPARATOR while the DAC
    threshold can only drive the IM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
    [30kw-acdc.sch, 30kw-dcdc.sch, 40kw-acdc.sch, 40kw-dcdc.sch, 50kw-acdc.sch, 50kw-dcdc.sch, 50kwa-acdc.sch, 50kwa-dcdc.sch]
2026-09-09 R8/E49: sixth review round — the reviewer corrects OUR discharge arithmetic; panel turns fixed; PV drive hardened to the rail floor
    Reviewer closes the comparator swap (verified on the face, incl. the
    internal DAC references per comparator), the PV rework wiring, and
    NSI1042-DSWR (Table 1.2 re-verified) — no regressions found. Their two
    surviving qualifications both land:
    - R8-A The 40/50 kW links carry TWO SplitDcLink banks whose 2x47k
    balance pairs PARALLEL: 47k/half, 94k full-link — only the
    single-bank 30 kW is 188k. The R7 report dismissed the
    reviewer's 222 s as "their arithmetic slip"; the slip was OURS
    and is RETRACTED in the register. Netlist-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
    [30kw-dcdc.sch, 40kw-dcdc.sch, 50kw-dcdc.sch, 50kwa-dcdc.sch, bom-30kw.csv, bom-40kw.csv, bom-50kw.csv, bom-50kwa.csv]
2026-09-09 Docs: end-to-end sweep to the E49 state — live docs rewritten, history stamped, stale eras removed
    Full rewrites (the structurally pre-E40 ones):
    - architecture.md: four-SKU family table, single-brain control plane, R4-R8
    protection map, two-phase discharge, current costs/efficiency — replaces
    the two-MCU / 60=2-lane / single-PCB-120kW era wholesale.
    - interconnect.md: 40-way HARNESS40 contract, card-slot era, R8 bleeder
    drive, E47 discharge semantics; the 16-way/UART-link tables removed
    (pointer to the E40 migration record kept).
    - docs/README.md index: live-vs-historical split, current one-liners,
    R4-R8 pointer; boards/README.md: four SKUs, VET7, 7794/7794, six SHIP
    targets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
    [symbol-pin-map.csv]
2026-09-12 E50: focus main on the 30/40/50 kW production path — retired material to archive/pre-focus-E49
    - boards/60kw + boards/120kw (retired single-board references) and kicad5/archive
    (23 superseded zips + pre-split 120 kW set) removed from main; full pre-E50 state
    preserved and pushed on branch archive/pre-focus-E49
    - parts-db: 60/120 kW skuOverride blocks + mech lines removed (products >50 kW are
    cabinets of the four module SKUs; bom-gen roll-ups unchanged)
    - envelope-grid + loss-budget: 60/120 kW rows retired
    - stale ["30kw","60kw","120kw"] tool defaults -> the four active SKUs
    (cell-uniformity, alignment/wiring/void audits, lcsc-from-build, card-contract-dump,
    schematic-export/compo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
    [120kw-acdc.sch, 120kw-dcdc.sch, 60kw-acdc.sch, 60kw-dcdc.sch, dc-modules-120kw.sch, dc-modules-60kw.sch, envelope-grid.csv, loss-budget.csv]
2026-09-12 E51: independent magnetics recomputation — catalog-core re-issues, window-feasibility fixes, RFQ pack, benchmark, validation verdict
    FOUND (clean-room recompute vs catalog cores/formers + real winding packing):
    - D1-40/50 were GEOMETRIC-core engine selections (the E35 catalog correction never
    reached the engine): on the real 0077908A7 (AL 37) they miss their own bias floors.
    Re-issued: D1-40 rev B N=26+/-1 (L0 116), D1-50 rev B N=24+/-1 (L0 107, dIpp basis
    restated 36.2 A pp — D6-50 floor 11.8 vs built 12.9, LISN margin >= +5.2 dB).
    pfc-design GEOMS repinned to catalog Ae so engine ≡ drawing.
    - D3 transformers were NOT WINDABLE on any SKU as drawn (30 kW: 142-172% of window;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
    [40kw-acdc.sch, 40kw-dcdc.sch, 50kw-acdc.sch, 50kw-dcdc.sch, 50kwa-acdc.sch, 50kwa-dcdc.sch, bom-40kw.csv, bom-50kw.csv]
2026-09-12 E52+E53: production-margin closure + documentation restructure to presentation grade
    E52 (real-world margins, all pre-hardware):
    - D4 rev D: aux flyback core ETD34 -> ETD39 (order code XFMR-AUX-FLY-D) — Bpk margin
    85% -> 66% of hot Bsat at Lp+10%+clamp; Lp/turns/AL/clamp/DCM-proof/sim UNCHANGED;
    stress-audit gains a computed D4 Bpk check; uuid-map alias added (drop-class prevention);
    CB-7/R2-CB20 gates re-pointed.
    - D2-30 trim litz 1050 -> 1350x0.1 (J 5.62-at-the-line -> 4.38; same litz as the D3-30
    primary — one spool); stress D2c now covers all four SKUs.
    - A11 rev B registered: -25..+55/+75 operating, -40 storage, 5-95% RH, 2 g vibration,
    acrylic conformal coating baseline (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
    [30kw-acdc.sch, 40kw-acdc.sch, 50kw-acdc.sch, 50kwa-acdc.sch, acdc-AUX-POWER.json, bom-30kw.csv, bom-40kw.csv, bom-50kw.csv]
2026-09-12 E54: main-branch deep clean — 22 superseded/parked tools removed, tree = production path only
    Importer sweep proved no keeper depends on any of these (all recoverable on
    archive/pre-focus-E49):
    - OLD FACES: kicad-gen + kicad-verify (pre-kicad5 exporter), schematic-compose/-export +
    sch-longtrace-labels (composed-SVG set), easyeda-verify (in-app flow; face frozen E39)
    - PARKED LAYOUT TOOLS: floorplan-budget/-svg, placement-audit, routing-audit, pcb-plot,
    pcb-geom, free-space, fab-release, footprint-report, unwired-pins, net-endpoints,
    emi-thermal-audit (layout reopens from pcb-floorplan.md + footprints-to-draw.md)
    - CARD-ERA DEAD: card-pinmap-gen/-reconcile, card-contract-dump, card-a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
2026-09-12 E55: product line = 30/40/50 modules + 100 kW (2x50) + 150 kW (3x50+CSU) — 60/80/120 compositions retired
    - cabinet.tsx re-based 4x30 -> 3x50 (PMP-50KW-MODULE blocks; sheet retitled '150 kW
    Cabinet - 3x 50 kW modules + CSU'); interconnect audit + verify-independent cabinet
    checks walk 3 modules (+ assert NOT a fourth), CLEAN
    - bom-gen: ladder emits exactly the directive's 8-row table; 150 kW cabinet roll-up
    replaces the 120 kW one (derived red-line 130,834); lever table re-based 30/50/150
    - apply-gen module-class uuid rule -> prefix match (exact-match drop-class bug,
    occurrence #7: PMP-50KW had no key, MOD1-3 silently dropped — AUD-CAB-COMPLETE caught it)
    - docs swept: README lad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
    [bom-120kw.csv, cabinet-cab.sch, dc-modules-cabinet.sch]
2026-09-12 E56: EasyEDA layer removed end-to-end — KiCad is the terminal face; native-convention library
    - pipeline renamed to its real function: sheet-pages.mjs -> sheet-netlist-gen.mjs ->
    kicad5-gen.mjs, payload tree calculations/out/sheets/ (was out/easyeda/)
    - ALL app machinery deleted: part-uuid-map + uuid lookup + skip-on-missing-uuid (the
    silent-drop bug family, occurrences 1-7, now structurally impossible — every classified
    component is always emitted), page-uuids, rotate/pos hints, app-payload emission.
    The REAL vendor pin-map translation branches (R3/R4 provenance) are kept — they are the
    physical-pin truth of the payloads.
    - THE LATENT MIRROR DEFECT RETIRED: the .lib was pre-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
2026-09-12 E57: BOM maturity — standing gate + full sourcing resolution (45 unmapped mpns closed)
    - NEW gate cost/bom-maturity.mjs in run-all: every emittable mpn must resolve to
    ORDERABLE / SECOND-SOURCE / DIRECT (new: vendor-direct code documented) / CLASS
    (spec+candidates) / CUSTOM (pack drawing) / REVIEW-with-action-note; UNMAPPED fails.
    - lcsc-map matured: 45 unmapped mpns (five register generations of renames/variants)
    resolved with honest statuses, zero invented order codes; Talema/Hongfa/MeanWell rows
    upgraded to DIRECT with their documented codes; S20K550 -> real TDK B72220S0551K101
    (the 350 VAC mismap banned); dead keys pruned.
    - census: ORDERABLE 44 · CLASS 54 · CUSTOM 15 · DI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
    [bom-30kw.csv, bom-40kw.csv, bom-50kw.csv, bom-50kwa.csv]
2026-09-12 E58: independent magnetics temperature critique + FMEA — measured 3C95 surfaces, runaway/cold/saturation/fault-race computed every run
    - NEW standing gate calculations/magnetics/temp-critique.mjs (run-all) against the
    digitized Ferroxcube 3C95 datasheet surfaces (upb-lea/materialdatabase, frozen with
    provenance in tempdata-3c95.json; a physics check caught INVERTED temperature labels
    in the digitized B-H set — Bsat 499/401 mT at 25/100 C).
    - Thermal runaway done honestly: core flux is volt-second-pinned (does not derate), so
    the real corners are 55C/full and 75C/40%: equilibria 77-101 C core (at the 3C95 loss
    minimum), loop gain g <= 0.31, runaway threshold >= 200 C (>= 99 K ma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
2026-09-12 E59: magnetics sync + burn-safety audit + build work-instructions + the heat answer
    - NEW gate magnetics/mag-sync.mjs: ONE identity table asserted (whitespace-normalized)
    across all five carriers (drawings/pack/parts-db/kicad5 panel/boards.tsx) + masses
    COMPUTED, not eyeballed — docs corrected: D1-30 1.0->2.2 kg, D1-40 2.0->3.0,
    D1-50 ->2.9 (>=3 kg stacks now bolt + two-point band), D3-30 1.6->0.8, D3-40/50 1.45.
    - NEW gate system/fault-energy.mjs — the nothing-burns audit, computed: every reservoir
    and dump path (link 869-1390 J @860 V -> <=348 J/resistor vs 480 J class; banks <=32 J
    vs 65; tank 81 mJ; D1 magnetic 0.8 J freewheel), 61000-4-5 class-4 surge = 39 J vs the
    MOV's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
2026-09-13 E60: current coordination, AC copper, simulation re-basis, harsh-environment parity
    Simulation evidence re-based. The pre-E60 LLC ngspice deck had no body diodes
    (legs swung ±6 kV) and ran the 30 kW tank for every SKU. spice/llc/llc-run.mjs is
    rebuilt with per-SKU tanks (calculations/llc/tanks.mjs), body diodes, the star held
    at mid-bus, power-solved operating points and 14 corners. It adds an internal-short
    race, a dead short, a physicality guard and a tank fingerprint. New cycle-by-cycle
    Vienna model: calculations/pfc/vienna-switched.mjs. Retired-SKU decks are re-keyed
    to 30/40/50 kW.
    New gate calculations/system/current-coordination.mjs:
    - F.11 raised to 85/115/145 A pk on 1.2/0.91/0.75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
    [30kw-acdc.sch, 30kw-dcdc.sch, 40kw-acdc.sch, 40kw-dcdc.sch, 50kw-acdc.sch, 50kw-dcdc.sch, 50kwa-acdc.sch, 50kwa-dcdc.sch]
2026-09-13 E61: documentation presentation standard rev 2 + defects found while restyling
    Presentation
    - calculations/doc-chrome.mjs: one registry drives the banner, icon title, subtitle,
    status/rev/gate badges and prev · hub · next footer of all 49 pages; bom-gen,
    busbar-calc and pin-map-export emit the same chrome.
    - Animated oscilloscope-style family banners (reduced-motion safe) and a rebuilt hero;
    stale scoreboard/COGS SVGs (3,024-pt grid, 33/33 firmware, 30/60/120 kW) deleted.
    - Every page restructured: at-a-glance tables, 57 mermaid diagrams (all parsed with
    mermaid 11.17), callouts; hub with reading paths; historical records open with
    where their conclusions live now.
    Defects fixed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
    [30kw-acdc.sch, 30kw-dcdc.sch, 40kw-acdc.sch, 40kw-dcdc.sch, 50kw-acdc.sch, 50kw-dcdc.sch, 50kwa-acdc.sch, 50kwa-dcdc.sch]
2026-09-13 E62: commercial teardown benchmark - InfyPower REG1K0135A2 vs this platform
    New page docs/benchmark-infypower-teardown.md (registered, chrome, 2 diagrams):
    block-by-block audit of the ChargerLAB REG1K0135A2 teardown against our design -
    21 areas on the seven-point verdict scale, every claim tagged [T]/[T?]/[D]/[C]/[R],
    recalculations for PFC/LLC conduction, series-diode cost, density, fuse derate.
    Findings
    - Macro-architecture converges on every block: 3-level SiC front end (identical
    600-750 V half-bus switch / 1200 V 40 A full-bus diode classes), resonant
    isolated DC-DC on 1200 V SiC, SiC-diode secondary, relay S/P range switching
    (their 150-1000 V / 133 A window is identical to our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
2026-09-13 E63: economic gap-closure and efficiency lever audit (on the E62 teardown basis)
    Directive: close the economic gap vs the benchmark and improve efficiency end to
    end - or say when it is not worth it - without breaking the existing system.
    Nothing here edits a schematic; every lever is gated on the check that owns it.
    Gap decomposed (40 kW @10k, [est]): the deliberate philosophy premium is ~Rs 5.2k
    (3-ph LLC ~1.5k - corrects E62's ~2.3k class-price estimate at real BOM prices;
    DESAT drive ~0.9k; CT sensing ~0.4k; mirror-relay class ~1.3k, which avoids their
    permanent 0.15-0.44% series-diode tax; DM+X1 filter ~1.4k; one-MCU -0.25k). The
    40 kW red-line overshoot (2,891) is SMALLER than the pre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
2026-09-13 E64: pre-hardware hardening close-out - R17 closed at zero, standby + MTBF gates
    Executed the /goal end-to-end for everything not physically gated on EVT/RFQ/
    layout (those stay on their registered triggers).
    (a) R17 CLOSED - sheets are layout-entry-true
    - footprint-map +30 entries: every class added E55-E60 names its package;
    cabinet blocks and the DIN supply carry explicit ASSY_/DIN_ markers.
    - The value map is LAND-AWARE: lcscForPart(family, value, pkg) consults
    family|value|package rows; kicad5-gen passes the drawn land, bom-gen splits
    lines per package via realPackagesFrom. The E61 audit's 307 unnamed / 344
    MPN-vs-land conflicts are now 0 / 0 and footprint-audit fails on the fi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
    [30kw-acdc.sch, 30kw-dcdc.sch, 40kw-acdc.sch, 40kw-dcdc.sch, 50kw-acdc.sch, 50kw-dcdc.sch, 50kwa-acdc.sch, 50kwa-dcdc.sch]
2026-09-13 E64 follow-up: product-level coverage for the standby and MTBF gates
    Answering 'does this apply to all boards on main?' exposed the one limit: both
    new budget gates computed at module level only. Now: mtbf-budget rolls up the
    four E55 products (100/100a/150/150a = 6,792/7,104/10,538/11,006 FIT -> 147/
    141/95/91 kh to the FIRST random failure of the set, registered and asserted;
    CSU adder = declared-estimate 350 FIT) with the availability-vs-MTBF
    distinction stated; standby-budget prints the product roll-ups (2x/3x module +
    cabinet base). Reliability page gains the products table. docs-lint CLEAN,
    both gates green.
2026-09-13 E65 WIP (local): D2/D3 magnetics envelope gate, E70 constructions, Lr split, two-node thermal, resonant-CT re-burden, FSM bus-ref/mode/NTC-guard
    Work in progress, not pushed: docs, D1/D4/D7/EMI fixes, sheet pipeline and the full battery follow.
    [ct-frontend.csv, llc-envelope.csv, llc-flux.csv, llc-short.csv, llc-tank.csv, loss-budget.csv]
2026-09-13 E65 d1 (agent WIP, stopped before review)
    [bom-30kw.csv, bom-40kw.csv, bom-50kw.csv, bom-50kwa.csv, d1-fd.csv, loss-budget.csv, pfc-design.csv, vienna-switched.csv]
2026-09-13 E65 d4 (agent WIP, stopped before review)
    [aux-flyback.csv]
2026-09-13 E65 emi (agent WIP, stopped before review)
    [bom-30kw.csv, bom-40kw.csv, bom-50kw.csv, bom-50kwa.csv, lisn-precompliance.csv, loss-budget.csv, pfc-filter-stability.csv]
2026-09-13 E65/E66 WIP 2 (local): window-comparator F.11, CSU deletion + group share law, sealed-air node, D3 28 mm confinement, partial docs
    [bom-30kw.csv, bom-40kw.csv, bom-50kw.csv, bom-50kwa.csv, loss-budget.csv]
2026-09-13 E65/E66: end-to-end magnetics review + fault coordination; 150 kW without a cabinet supervisor
    E65 (magnetics + coordination):
    - magnetics-envelope gate: D3/D2 at every power-solved ngspice corner (bank x load envelope + stress
    corners), iGSE on simulated waveforms, LEA-calibrated N95 loss, two-node core/winding thermal,
    sealed-air node for the liquid SKU, E60 drawings as a control group the gate must reject
    - D3: 30 kW 3xPQ50 (unwindable) -> 2xE70 7:7:7; 50 kW 2xE70 -> 3xE70 5:5:5 (XFMR-LLC-3E70-50);
    all D2/D3 VPI + both yoke faces bonded (+ end-turn potting 40/50 kW), margin barrier, shield -> DCN
    - D2 carries ~all of Lr (the 3 uH engineered leakage was unreachable): 1xE70 N8 / 2xE70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
    [30kw-acdc.sch, 30kw-dcdc.sch, 40kw-acdc.sch, 40kw-dcdc.sch, 50kw-acdc.sch, 50kw-dcdc.sch, 50kwa-acdc.sch, 50kwa-dcdc.sch]
2026-09-13 E67 WIP: InfyPower-parity DC-DC — full-bridge LLC, 2-cell transformer, external Lr, 2-mode output, bank filter + blocking diode
    - tanks.mjs: single full-bridge LLC (n=2, Ln 10, fr 140 kHz; Cr 7/9/11x33 nF), tank classes, 40 A JBS 2-3 per position
    - llc-run.mjs: FB deck, PSM at f_max, Lr ±5 % tolerance corners; sims re-run all SKUs (ZVS 64/64, legs in rails)
    - magnetics-envelope: D3 rev D cells (primaries in series) + D2 rev F external Lr — gate CLEAN; conductor-audit, temp-critique re-based
    - current-coordination: one tank CT, F.11 140/180/220 A, burdens 0.47/0.36/0.30 Ω, output-stage checks (bank ripple from ngspice)
    - schematic: LlcTank + par-count legs, BankFilter (film -> Lf -> 330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
    [bom-30kw.csv, bom-40kw.csv, bom-50kw.csv, bom-50kwa.csv, envelope-grid.csv, fsm-scenarios.csv, llc-envelope.csv, llc-flux.csv]
2026-09-13 E67: InfyPower-parity DC-DC — one full-bridge LLC, LOW/HIGH output modes, output blocking diode
    - Full-bridge LLC (n 2, Ln 10, fr 140 kHz, Cr 7/9/11 × 33 nF) replaces the three half-bridge sections;
    PFM to fn ≈ 0.59 then leg-B phase shift at 1.45·fr. ngspice decks re-solved for all SKUs, ZVS everywhere.
    - Magnetics: D3 rev D (two E70 cells, primaries in series), D2 rev F (external Lr ±3 %, no bins),
    D8 bank filter inductor; RFQ sheets in the manufacturing pack, insulation rows at 1260–1280 V.
    - Output: LOW ≤ 500 V / HIGH ≥ 500 V / AUTO set in standby (CAN force-LV/HV); DOUT 1600 V blocking diode,
    zero-current PCB relays; K_OUT, pre-insertion and mirror contacts retired; F.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
    [30kw-acdc.sch, 30kw-dcdc.sch, 40kw-acdc.sch, 40kw-dcdc.sch, 50kw-acdc.sch, 50kw-dcdc.sch, 50kwa-acdc.sch, 50kwa-dcdc.sch]
2026-09-13 E68a: InfyPower-style clip mount — single SiC dies per position
    - mount.mjs: one mounting basis for every Tj engine — TO-247 dies clip-mounted on 0.635 mm Al2O3 + grease,
    0.8 K/W j→base (air, 70 °C) / 0.65 K/W j→plate (liquid, 65 °C); was a 1.9 / 1.1 K/W pad basis copied in
    three engines. EVT T-38 verifies it within +15 %.
    - PFC: one B3M010C075Z common-source pair per phase on every SKU (the E41 paralleled pair retired): 12 → 6 FETs
    at 40/50 kW; grid Tj 114 / 116 / 135 °C.
    - LLC: 30 kW one die per position (8 → 4 FETs); 50 kW air = the liquid (12 → 8 FETs). 40/50 kW keep two per
    position — InfyPower's single 35 mΩ die fails the 500 V HIGH-mode corner at 55 °C in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
    [30kw-dcdc.sch, 40kw-acdc.sch, 40kw-dcdc.sch, 50kw-acdc.sch, 50kw-dcdc.sch, 50kwa-acdc.sch, 50kwa-dcdc.sch, bom-30kw.csv]
2026-09-13 E68b: InfyPower EMI filter — star X2 stages, no DM chokes
    - Filter: CMC1 · 4.7 µF★ X2 on LF (line side) · CMC2 · 4.7 µF★ X2 on AC·M · 2 × 4.7 µF★ X2 on AC (converter), each stage
    with its own floating star (274 VAC per cap at 475 VAC); the three D6 DM chokes are deleted (the D6 construction
    stays as the D8 bank inductor). Twelve X2 305 VAC caps replace six X1 530 VAC; the E65 Rd–Cd damper stays at AC.
    - lisn-precompliance: the DM path is now the drawn per-phase ladder (star C as-is, Δ as 3·C) with the retired E65
    filter as the control; gate ≥ +3 dB AND ≥ the control. DM margin 32.9 / 30.6 / 28.7 dB (control 19.6 / 19.1 / 18.4).
    - pfc-control / vienna-switched: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
    [30kw-acdc.sch, 30kw-dcdc.sch, 40kw-acdc.sch, 40kw-dcdc.sch, 50kw-acdc.sch, 50kw-dcdc.sch, 50kwa-acdc.sch, 50kwa-dcdc.sch]
2026-09-13 E68c: film-only output banks — D8 inductor and bank electrolytic retired
    - BankFilter: nF × 2.2 µF 630 V film straight across each rectifier output (InfyPower practice); the E67 Cf–Lf–Ce
    filter (D8 sendust inductor + 330 µF 550 V electrolytic) is deleted and the JBS cathodes land on BK·P.
    - current-coordination OUT: every simulated corner — ripple current per film ≤ 10.5 A and bank ripple voltage ≤ 0.5 %
    RMS of the output at −10 % film tolerance (SER stacks two in-phase banks). The 150 V / Imax PSM corner binds:
    9 / 12 / 14 films per bank (0.47 / 0.46 / 0.49 %); per-film current ≤ 4.3 A.
    - Retired with it: D8 identity row (mag-sync), IND-BANK / ELH-330u550 parts, th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
    [30kw-dcdc.sch, 40kw-dcdc.sch, 50kw-dcdc.sch, 50kwa-dcdc.sch, bom-30kw.csv, bom-40kw.csv, bom-50kw.csv, bom-50kwa.csv]
2026-09-13 E69a + E69f: right-sized SiC dies (InfyPower practice) and the China RFQ-target cost column
    E69a (user decisions 2026-09-13: accept a fold only at the forced-HIGH 500 V corner at 55 °C):
    - LLC: 40 kW one 1200 V 16 mΩ class die per position (8 → 4 FETs); tanks.mjs carries the die per SKU (DIES: rds, hot R,
    node C) so decks, grid and loss budget read one table. 40 kW decks re-solved (Coss 360 pF), ZVS 64/64.
    - PFC: 750 V 20 mΩ class die at 30 kW, 750 V 15 mΩ class at 40 kW (grid Tj 112 / 127 °C). 650 V dies are rejected:
    560 V worst switch stress is 86 % of 650 V against the 75 % house rule. 50 kW liquid and air keep B3M010C075Z and two
    LLC dies per position — single dies folded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
    [30kw-acdc.sch, 40kw-acdc.sch, 40kw-dcdc.sch, bom-30kw.csv, bom-40kw.csv, dc-modules-40kw.sch, envelope-grid.csv, llc-envelope.csv]
2026-09-13 E69a-2: fault-pulse gate for every SiC die; 40 kW LLC back to two dies per position
    - current-coordination: a trip-limited, non-repetitive µs pulse at low VDS may reach 80 % of the die's pulsed rating IDM
    (25 °C listing, −20 % hot start). PFC at the F.01 fault peak and — new — LLC at the F.11 kill peak, per die. The old PFC
    row still assumed two paralleled B3M010C075Z (retired at E68a) and never saw the E69a class dies.
    - 40 kW LLC single 16 mΩ die rejected: 267 A per die at the kill needs IDM ≥ 334 A (the reference 16 mΩ class lists 250 A);
    back to 2 × SG2M023120LJ per position (decks restored from E68c, fingerprint Coss500p).
    - RFQ ACCEPTANCE lines carried in parts-db an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
    [40kw-dcdc.sch, bom-30kw.csv, bom-40kw.csv, bom-50kw.csv, bom-50kwa.csv, dc-modules-40kw.sch, envelope-grid.csv, llc-envelope.csv]
2026-09-13 E69e + E69 sync: 2U cost scenario, docs and register brought to E67–E69, stale gates fixed
    E69e — InfyPower-style 2U construction as a flagged cost scenario (parts-db mech2U, bom-gen table):
    30 kW ₹28,442 India / ₹23,349 China target; 40 kW ₹32,680 / ₹26,736. Not the design basis (3U card stays).
    Docs and register (E68/E69 rows; T-34…T-41 written into the EVT plan — E67 had cited tests that did not exist):
    README, architecture, thermal report §1–§4.5, current coordination (E67 tank map, classes, race, D2), protection
    thresholds §7 (fault-pulse rule, additive), verification matrix (scoreboard, R18 resolved, R19–R22), reliability
    budget, simulation report §14, benchmar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
    [30kw-acdc.sch, 30kw-dcdc.sch, 40kw-acdc.sch, 40kw-dcdc.sch, 50kw-acdc.sch, 50kw-dcdc.sch, 50kwa-acdc.sch, 50kwa-dcdc.sch]
2026-09-13 E70: one custom BOM and magnetics page per module, and a fresh repository
    Per-module pages (generated, never hand-edited)
    - bom-gen writes docs/bom-<sku>.md for 30/40/50/50a: at-a-glance, cost pie,
    section table with China RFQ targets, top drivers, SKU overrides, line items
    by schematic section, mechanics, sourcing status and REVIEW list.
    - NEW calculations/magnetics/mag-docs.mjs writes docs/magnetics-<sku>.md from
    gate evidence: D1/D2/D3/D7/CT spec tables, proof rows, build and hold points,
    winding tables, prototype route and EVT hooks.
    - NEW calculations/evidence.mjs captures every gate row to
    calculations/out/evidence/<gate>.json; a failing gate blocks the pages.
    - docs/magnetic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
    [monte-carlo.csv, prechg-disch-sku.csv]
2026-09-13 E71: PyOpenMagnetics second opinion on D2/D3, corrected gap guides and D3 AC-resistance test
    PyOpenMagnetics (OpenMagnetics MKF)
    - The docs said PyOpenMagnetics could not be installed here; the 1.4.0 macOS arm64 wheel runs under
    Python 3.12 (only the 1.7.x sdist fails). NEW calculations/magnetics/mkf-crosscheck.py (by hand, not in
    run-all) rebuilds every D3 cell and D2 from the gate's construction tables and writes
    out/evidence/mkf-crosscheck.json, which the module magnetics pages quote.
    - Winding Rdc from MKF's turn layout: within +/-2.5 % of the production rows on every winding.
    - D3 Lm from the drawn gap: +4.2..+5.0 % (inside +/-7 %). D2 L from the drawn gap: +13..+14 % (fringing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
2026-09-13 E72: main carries the 30 / 40 / 50 kW modules only; 100 / 150 kW products moved to a backup branch
    Backup
    - backup/with-100-150kw-products (pushed at 8c2a685, identical to main before this commit) keeps the
    100 kW = 2 x 50 and 150 kW = 3 x 50 products, the cabinet sheet and every product roll-up.
    Removed from main
    - boards/cabinet.tsx, the cabinet KiCad-5 set, SHIP zip, print SVG, PDF and sheet payloads.
    - Cabinet branches in sheet-pages, sheet-netlist-gen, kicad5-gen, kicad5-visual, schematic-sections,
    sheets-to-pdf and pin-map-export; retired 60/120 kW argv handlers in kicad5-gen.
    - Cabinet part rules (module interface blocks, controller port, CAN terminations, cabinet studs) in
    par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
    [cabinet-cab.sch, dc-modules-cabinet.sch, symbol-pin-map.csv]
2026-09-13 E73: end-to-end magnetics critical review — startup inrush closed, abnormal conditions gated, every custom magnetic cross-checked
    Defect closed (firmware)
    - fsm.c closes the precharge bypass at 90 % of line peak; simulated on the drawn path (475 VAC stiff grid, CMC leakage
    12 uH, D1 catalog L(i) at lot AL -8 %, passive rectifier, closure instant swept every 2 deg) the pulse is
    200 / 218 / 280 A pk, above F.01 120 / 155 / 195 A: a high-line start latched F.01 and only a retry succeeded.
    - F.01 is no longer latched for PMP_PRE_BLANK_MS = 60 ms after the bypass command, and PFC enable waits for the
    window. Host tests +3 (63/63), negative-tested: without the blank the scenario latches F.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
    [bom-30kw.csv, bom-40kw.csv, bom-50kw.csv, bom-50kwa.csv]
2026-09-15 E74–E79: external reviews closed, firmware architecture and protocol profiles, portable real-time HAL
    - E74: external independent review of the rev D.4 set verified claim by claim — four paper fixes, one open line
    - E75: review #4 — the OVP comparators allocated on real pins (F.03 CMP4, F.13 CMP0), mode-swap release margin
    - E76: review #5 — delivered-face defect fixed and gated, nine supervisory-logic defects closed, host plant made honest
    - E78: firmware architecture, the protocol-neutral core (recovery classes, relay supervision, controlled stop, shaper and
    regulator kernel) and two protocol profiles: VMP 2.0 native and TonHe V1.2 compatibility
    - E79 (in progress): the portable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
    [bom-30kw.csv, bom-40kw.csv, bom-50kw.csv, bom-50kwa.csv, control-card-card.sch, umod-pinmap.csv]
2026-09-15 E79: portable real-time HAL completed — application layer, end-to-end test, one-MCU verdict
    - hal/app.{h,c}: the sans-IO application — PFC / LLC / fault interrupt entries, the 1 ms sequence, boot offsets, the zone
    map, HRTIMER fault-channel attribution, F.29 · F.30 · F.35 · F.36 · F.37, the bus fold-back, relays and gate enables,
    comparator references from the calibration, fans with tach supervision, the panel address, CAN bus-off recovery, the NVM
    write policy and the sequenced watchdog
    - test/app_test.c: 16 end-to-end checks through TonHe V1.2 on averaged plants
    - interrupt-path cost: one FPU division and one square root per 100 kHz PFC update (was five and one), no ceilf in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
2026-09-17 E80: production completion — signed boot chain, GD32G553 register port, two external rechecks answered
    Reviews (33 + 38 findings) triaged claim by claim — docs/e80-recheck-response.md:
    - HR-01 CAN choke map crossed the ACT45B windings on every exported variant: netlist map
    corrected (CANH 1-4, CANL 2-3), five KiCad sets + PDFs regenerated at 100 %
    - HR-02/R01 watchdog: fixed-window strap (CWD open, SET0 low, SET1 high), 10 ms kicks
    legal; bootloader kicks from power-up and chunks image verification; EVT T-53
    - HR-04/05 measurement nominals: AMC1311 VCM 1.44 V, AMC1350 slope 0.200 + input loading
    - HR-29 a card without a calibration record latches F.30 (no nominal-scaling delivery)
    -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
    [30kw-dcdc.sch, bom-30kw.csv, bom-40kw.csv, bom-50kw.csv, bom-50kwa.csv, control-card-card.sch, dc-modules-control-card.sch, loss-budget.csv]
2026-09-17 E81: full-system validation — nine independent reviews, every domain re-derived, fixed and re-gated
    Physics found and fixed (each with a gate that fails without it):
    - LLC turn-off loss was a flat 1/8 W per position; both ledgers now carry the
    deck-calibrated term, per-die C0G snubbers (330/680/1000 pF, k_off 3.4/5.3/4.0
    from the per-SKU DPT at the real currents, 5 nH loop rule) and a per-leg
    adaptive dead time (60-900 ns, DTGCKDIV 2).
    - F-L-1: with the real output charge the weak leg cannot slew at the 150 V
    phase-shift corner on the two-die SKUs (fixed 90-170 W/die, deck-validated by
    a differential energy run); corner registered NOT SUSTAINABLE, sustained
    <200 V a documented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
    [30kw-acdc.sch, 30kw-dcdc.sch, 40kw-acdc.sch, 40kw-dcdc.sch, 50kw-acdc.sch, 50kw-dcdc.sch, 50kwa-acdc.sch, 50kwa-dcdc.sch]
2026-09-17 E81 docs: premium polish pass — 42 pages restructured, 80 diagrams, 61+ stale claims fixed, gates synced
    - Every registered page: at-a-glance table, numbered sections, purpose and
    gate-coupling callouts, 'how this page is checked' footers; new charts
    (cost vs ceiling, trip classes, tank peaks vs F.11, MTBF, loss pies),
    CAN sequence diagrams, register timeline to E81.
    - Stale claims corrected to the E81 numbers everywhere (pins 7,285, checks
    291, fans 3/3/0/4, adaptive dead time, 500 V cans, +15/-3 V bias, F.11
    140/180/220, fold map and F-L-1 wording, live ledger efficiencies).
    - 40 kW ledger fan term corrected to 3 fans (eta 96.35 %), the E81
    entry-film review gate re-pointed a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
    [loss-budget.csv]
2026-09-17 E82: independent validation and production hardening — 11 CRITICAL found, 10 fixed at zero BOM cost, thermal folds made real
    Independent end-to-end review (the repo's documents, gates, tests and
    simulations treated as claims, not evidence; twelve specialist reviews, two of
    them switched simulations built without the repo's decks), then implementation
    under one rule: firmware wherever it is safe and fast enough, independent
    hardware only where microseconds, device survival or failure-mode independence
    need it, no margin for margin's sake.
    CRITICAL (each with a check that fails without the fix):
    - C-01 TPS3430 window violated along the boot path (P-256 verify ~100 ms
    un-serviced): service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
    [30kw-acdc.sch, 30kw-dcdc.sch, 40kw-acdc.sch, 40kw-dcdc.sch, 50kw-acdc.sch, 50kw-dcdc.sch, 50kwa-acdc.sch, 50kwa-dcdc.sch]
2026-09-17 E83: main carries the current design only — history out of the pages, dead files out of the tree, stale evidence refreshed and gated
    Owner directive: keep only the latest, verified version on main; remove every
    old or deprecated document and detail; verify in depth. The pre-cleanup tree
    is preserved on branch backup/pre-e83-cleanup.
    Why the pages had rotted: the house rules ("register rows are immutable",
    "gate-read pages take additive edits only", one validation report per round)
    forced every page to accumulate change history, so later rounds added text
    without removing what they overturned and pages contradicted themselves.
    Those rules are replaced: a page describes the design as it is,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
    [30kw-acdc.sch, 30kw-dcdc.sch, 40kw-acdc.sch, 40kw-dcdc.sch, 50kw-acdc.sch, 50kw-dcdc.sch, 50kwa-acdc.sch, 50kwa-dcdc.sch]
2026-09-18 E84: close the target-integration defects an external review of E83 found — comparator codes as the inverse of the corrected measurement, no enable write can re-arm a trip, LLC set written whole, tac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
    Firmware
    - hal/app.c: dac_v() takes k_ref and inverts meas_val exactly (absolute channels on the whole reading, AVMID-ratiometric ones on the swing): the DACs are VREFP-referenced like the ADC, and a rail 2.5 % high had moved F.03 from 860 V to 922 V while the telemetry read correctly. The AVMID half-rail check is judged on the nominal scale with no correction — it is ratiometric; divided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
    [control-card-card.sch]
2026-09-18 E84: the tick-side fault re-arm was vestigial — removed with its HAL output; the two control interrupts are the only writers that can enable an output, each verified against the timer's fault flags a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
    - port.c / port.h / hrtimer.c: hrtimer_rearm() and its call go. A tripped stage comes back only through its own control interrupt once trip_ack has caught up with trip_n and the FSM commands the stage again — through the bypass-closure blank and after a cleared latch alike — so the tick's CHOUTEN write was a redundant enable writer, i.e. a needless race surface. Header comments no longer describe a per-channel re-arm or a flag clear.
    - hal/app.h / app.c: the fault_rearm outpu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
    [app.c, app.h, board.h, hrtimer.c, port.c, port.h]
2026-09-18 E84: one enable writer inside a critical section, the whole control path in TCM with an audit that proves it, and a live ADC/DAC reference — the three items two further reviews of 8f126e4 raised, eac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
    - port.c / port.h / hrtimer.c: enable authority is one place. hrtimer_*_apply() program the timers and only RETURN the outputs that should be on; outputs_commit() writes CHOUTEN on an output's OFF -> ON transition alone (stage start, burst restart, the supervisor's re-command), inside a ~100 ns cpsid/cpsie section that checks trip_n == trip_ack and the timer's own fault flags before the write and the flags again after it. A completed fault pulse is never followed by a stale ena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
2026-09-18 E85: end-to-end firmware gap audit — 55 candidates verified one by one, 38 real defects closed, 9 false positives named, ₹0
    Supervisory core: a warm restart whose AUTO mode differs from the matrix left closed routes through MODESW (KSER and
    KPARA/B were commanded together); precharge is bounded and ends in F.07/F.08; an aux collapse in STANDBY drops to SAFE
    and reaches F.26; a bank channel that halves in one sample with the matrix at rest is F.29 and the make-permit refuses
    while any implausibility is pending; vin_nom follows the line up over 0.1 s (a swell re-filed a genuine F.01 as AUTO
    F.08); a comms timeout no longer interrupts MODESW; persistence counters reset outside the energised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
    [app.c, app.h, app_test.c, boot_main.c, boot_test.c, dielim.c, dielim.h, fsm.c]
2026-09-18 E85 closure: the reference tracker integrates each clean-cycle estimate once, the bank-film rating pinned at 630 V, every typed check count gated
    Two closure reviews of b876640 withdrew the E84 items and raised five points; each was verified before anything changed.
    E85-01 (real): grid_sample() advanced seq on the 60 ms timeouts and on disturbed cycles with dcc HELD, and measure()
    integrated that held residual on every publication. Reproduced through the real state machine: a +1 % VREFP move,
    the line lost 40 ms in, k_track walked 1.00064 → 1.02159 in 3 s and F.29 latched — a LATCH needing a CAN clear out of
    a line outage F.07 recovers from on its own. dcc_seq now advances only when a c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
2026-09-18 Firmware verification: the public reference firmwares read at source level and matched row by row — Microchip 3-phase PFC and LLC, NXP LLC, PFController, VMCharger, TI TIDM-1000 guide; no behaviour g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
2026-09-18 Reference library: the public reference designs and firmwares vendored under docs/reference with licences, commits and text companions; ST's 30 kW Vienna (STDES-30KWVRECT) read at source level and ma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
    ST's STDES-30KWVRECT is the closest public match to this front end: 400 V AC, 800 V DC, 70 kHz, paralleled 650 V SiC,
    1200 V SiC diodes, STM32G474. Its firmware ships as a binary, so the data brief, BOM, schematic and the user manual's
    protection table (UM3011 Table 7), inrush and relay sequence, sensing chains and state machine stand in for the source.
    The verification plan's cross-check gains three rows for it: the same line window (468 / 260 / 294 V line-to-line
    against F.07 /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
2026-09-19 E85 closure verified on the merits: T-26 moves VREFP ±1 % (±2 % sat on the F.29 bound), the film overshoot envelope reads the 500 V LOW ceiling
    Two closure reviews of b876640 (E85-01…05) re-verified against 367dc79 before anything changed: the producer advances
    dcc_seq inside the seq odd/even window behind the barriers, the consumer copies it in the same seqlock snapshot and
    integrates once per generation, app_init's memset zeroes both counters, and the only other reader of the grid DC
    estimate (the PFC ISR's dcv/dci subtraction) uses it as an offset and never integrates. Host suite 355/355 under
    ASan/UBSan, review checks all pass, docs-lint and repo-hygiene clean, target build and TCM a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
